jbarra777/jbarra777/DECISIONES_TECNICAS.md

# DECISIONES TÉCNICAS — Registro permanente

**Leyenda de origen:**
- **[U]** indicado o aprobado por el usuario.
- **[CAT]** plano catastrado.
- **[A-20x]** planta base del anteproyecto (A-201 nivel 2, A-202 nivel 3).
- **[Ax]** establecido en la lámina indicada. Su vigencia depende del estado de esa lámina en `INDICE_PLANOS.md`: si está EN REVISIÓN, la decisión puede cambiar, salvo que también lleve [U].

**PENDIENTE DE DEFINIR** = no decidido. **PD** = valor preliminar dibujado, pendiente de confirmar.

## 1. Proyecto y cajetín
- **Proyecto:** VIVIENDA UNIFAMILIAR. Distrito 03 Santiago, cantón 05 San Rafael, provincia 04 Heredia, Costa Rica. [CAT]
- **Profesionales del cajetín:** "Director técnico: Steven Viales (Civil) IC-40759; David Barrantes (Electricidad) IE-27499". Vienen del proyecto de referencia y su uso fue **autorizado por el usuario**. [U]
- **Empresa:** CivilCon Diseño y Construcción SRLTDA, céd. jurídica 3-102-762712 (confirmada). [U]
- **Registro público:** folio real 4-041200-000; plano catastrado 4-57389-2023; área según catastro 256 m². [U][CAT]
- **No contemplar la segregación** que indica el catastro ("para segregar"). [U]
- **Propietario:** no se incluye en el cajetín. No fue solicitado.
- **Formato A1** (841 × 594 mm). [U] Códigos de lámina al estilo de la referencia (A1, A2…; C01…; EL1…; IS1…): en uso desde la A1 y sin objeción del usuario.
- **Cajetín:** espacio para sellos; empresa; profesional; proyecto; registro; contenido; escalas; control de revisiones; estado; lugar, lámina, fecha (OCT 2026) y total. **El total de láminas está PENDIENTE DE DEFINIR**: se muestra "--".

## 2. Lote (catastro 4-57389-2023, CRTM05) — datos en `datos/lote_catastro.json`
- **Vértices (E, N):**
  - 1 (489351.38, 1106442.25)
  - 2 (489356.04, 1106442.46)
  - 3 (489360.38, 1106442.62)
  - 4 (489361.72, 1106414.19)
  - 5 (489352.73, 1106413.77) [CAT]
- **Área por coordenadas:** 256.57 m². Para la cobertura se usa la del catastro, **256 m²**. [U]
- **Lados:**
  - 1-2: 4.66 m, 87°25′
  - 2-3: 4.34 m, 87°53′
  - 3-4: 28.46 m, 177°18′
  - 4-5: 9.00 m, 267°20′
  - 5-1: 28.51 m, 357°17′
  - Calculados de las coordenadas. [A1]
- **Amarre:** 3 – P.I., 101°22′, 75.71 m. [CAT]
- **Frente al norte, a la calle pública.** El lindero 5-1 tiene azimut 357.29°, así que en los dibujos el norte va girado −2.714°. [CAT][A1]
- **Colindantes:** identificador predial 40503004120000 al este, sur y oeste. [CAT]
- Ignorar las cotas de 7.00 y 10.67 m del catastro. [U]
- El terreno es plano y está a nivel de acera. [U]
- Los datos del catastro no sustituyen un levantamiento topográfico (nota en las láminas).

## 3. Implantación, retiros y cobertura
- **Retiros de diseño:**
  - frontal de 2.00 m medido desde el vértice 3; resulta 2.06 en el vértice 1;
  - posterior de al menos 3.00 m; resulta 3.33/3.34;
  - laterales 0, con fachadas laterales ciegas. [U]
  - Falta confirmarlos con el alineamiento y el uso de suelo municipal (nota 4).
- **Envolvente:** 9.00 × 23.12 m (208.08 m²), en y 2.06–25.18 (marco local, §4). [A-201][A1]
- **Patios abiertos desde el nivel 1 hasta el cielo:**
  - P1 de 7.38 × 2.50 (18.45 m²);
  - P2 de 4.04 × 2.50 (10.10 m²);
  - **dimensión aceptada por la municipalidad**, con la altura medida desde el nivel 1 (≈9.5 m). [U]
- **Huella (proyección de los niveles 2 y 3):** 179.53 m². **Cobertura: 70.13 % (179.53/256), aceptada por el usuario como cumplimiento.** [U][A1][A2]

## 4. Marcos de coordenadas, ejes y nomenclatura
- **Marco de diseño (local):** origen en el vértice 1. *x* crece hacia el este a lo largo del frente y *y* hacia el sur a lo largo del lindero 1-5. [A1]
- **Marcos de dibujo:**
  - Model Space de la A1: norte arriba (X = x, Y = −y).
  - Plantas: **marco girado** (X = y, Y = x), con la calle a la izquierda (`planta.py`).
  - Todos los DXF incluyen un UCS "CRTM05". [A1–A4]
- **Ejes de letra (en x):** A 0.075 · B 1.41 · **C 4.84** (centro de columnas; antes 4.75) · D 8.925. [A2 rev1]
- **Ejes de número (en y):** 1 2.135 · 2 7.685 · 3 10.335 · 4 16.905 · 5 19.555 · 6 25.105.
  - Separaciones: 5.55 / 2.65 / 6.57 / 2.65 / 5.55. [A2]
- **Niveles:** se nombran "Nivel 1 / Nivel 2 / Nivel 3". No usar "planta baja". [U]

## 5. Niveles y alturas
- **Altura de piso a piso: 3.00 m (confirmada).** [U]
- **NPT:** N1 ±0.00 (= acera), N2 +3.00, N3 +6.00. [U][A2–A4]
- **Viga corona y arranque de cubierta: +9.00.** **Cumbrera: +10.50** (9.00 + 0.13 × 11.56), valor de referencia. **Sin pretil.** [U][A5 rev1]
- **Sin restricción de altura máxima** (indicado por el usuario). [U]
- **Estructura principal: marcos rígidos de acero.** Columnas del eje C continuas y a plomo del N1 al N3. **Columnas de los ejes A y D: se resuelven en estructural; no se agregan a las láminas de arquitectura.** [U]
- **Entrepisos:** paquete de **0.30** = sobrelosa de **0.10** sobre lámina colaborante + **vigas de acero de 0.20**. El cielo se mantiene a 2.70. [U]
- **Cerramientos:** **forro del edificio en paredes livianas Steel Tech**. **Muros de lindero, tapia posterior y frente del N1 (portón) en mampostería.** Espesores de 0.15 en exteriores y 0.12 en interiores, sin cambio. **Paredes interiores: Steel Tech de 0.12.** [U]
- **Nivel 1:** **contrapiso de 0.10** en estacionamientos, pasillo y gradas; **retiro frontal en zacate block (permeable)**; el resto en grava. [U]
- **Cielos:** gypsum regular plano suspendido a 2.70 en N2 y N3; acero expuesto en el N1 (estacionamientos). [U]
- **Cimentación:** no se dibuja en arquitectura, ni siquiera esquemática, hasta tener dimensiones (estructural). [U]
- **Cerchas metálicas** en la dirección de la pendiente, cordón inferior a +9.00, junto a los linderos y en los ejes B y C. Geometría PD (propuesta de Claude aceptada por el usuario). [U][A6 rev1]
- **Cortes a 1:75.** [U]
- **Puertas de 2.10** y **ventanas hacia los patios con antepecho de 0.90 y dintel a 2.20** (confirmadas). [U]
- **Representación en cortes:** la cercha del fondo se dibuja en vista y completa, también sobre patios y gradas. [U]

## 6. Muros y estructura arquitectónica
- **Espesores:** muros exteriores 0.15 m e interiores 0.12 m. [U]
- **Muros de colindancia** este y oeste a lo largo de toda la envolvente, ciegos. [U]
  - **Las paredes de la vivienda son la división en el lindero. No hay tapias laterales en los retiros.** En el N1 el muro de colindancia es continuo hasta el nivel de entrepiso (+3.00). [U 06-10-2026][A2 rev2]
  - Remate superior según la pendiente de la cubierta (hastial), sin pretil. [U]
  - **Tapia del lindero posterior: existe y llega hasta la viga corona del último nivel (+9.00)** (nota general 2). En las fachadas laterales va con flecha y nota. [U][A5 rev2]
- **Nota de tapia**, tomada de la referencia por indicación del usuario: "La tapia colindante de mampostería deberá prolongarse hasta el nivel de la viga corona del último nivel…". Es la nota general 2. [U]
- **Columnas sobre el eje C**, en los ejes 2, 3, 4, 5 y 6 ("cada ~5 m ajustado a ejes"). [U]
  - Sección **0.30 × 0.30 PD**, con la cara oeste en x 4.69 para no invadir el descanso de la escalera. C6 queda al ras de la fachada posterior. [A2 rev1]
  - **Sin columna en C1**, porque obstruiría el portón y el espacio E-2. La viga del eje 1 salva unos 7.3 m entre la pilastra B y el muro D (diseño estructural pendiente). [A2 rev1]
- **Pilastra en el eje B**, en la fachada del nivel 1: x 1.26–1.56. [A2]
- **Sistema estructural, cimentación, entrepisos, secciones y refuerzo: PENDIENTE DE DEFINIR.** No copiar los perfiles de acero de la referencia.

## 7. Distribución
### Nivel 1 [U][A2 rev1]
- **Solo 3 estacionamientos** independientes, E-1 a E-3, de 2.50 × 5.00, en x 1.35–8.85 y y 2.21–7.21, con acceso recto.
- **Pasillo peatonal** de 1.20 libre al oeste (x 0.15–1.35, hasta y 19.48), separado de los carros con un bordillo.
- **Gradas.**
- **Todo lo demás es JARDÍN SECO NO CONSTRUIDO**: bajo los niveles 2 y 3, en los patios y en el patio posterior.
- **Área construida del N1:** 37.50 + 20.72 + 8.35 = **66.57 m²**. El cuadro de la A2 muestra solo estacionamientos, pasillo y gradas.
- **Portón vehicular abatible** de 4 hojas plegables de 1.82 m, que abren hacia el retiro frontal sin invadir la vía. Claro libre de 7.29 m. **Acceso peatonal** de 1.00 m (vano de 1.11). [U][A2]
- Tanque séptico y drenaje en el patio posterior. La limpieza del tanque "no es problema". [U]

### Nivel 2 [A-201][A3]
- **Suite 1** en el módulo frontal (8.70 × 5.40):
  - baño en x 3.72–5.27, y 2.21–4.41;
  - walk-in de 3.46 × 3.25 en x 5.39–8.85, y 2.21–5.46.
- **Cocina-comedor** de 7.38 × 6.42: cocina en L sobre el muro este y el muro del eje 4, isla de 2.30 × 0.90, fregadero bajo la ventana a P2, despensa, aparador y mesa para 8.
- **Sala familiar** de 8.70 × 5.40. **Sin baño** en la cocina-comedor ni en la sala. [U]
- **Área del nivel:** 179.53 m² (incluye muros).

### Nivel 3 [A-202][A4]
- **Suites 1 y 3** iguales a la suite del N2. La suite 3 es su espejo, con el baño en la fachada posterior (y 22.83–25.03) y el walk-in en y 21.78–25.03.
- **Suite 2** (7.38 × 6.42):
  - **baño en x 7.30–8.85, y 14.63–16.83, sobre la zona húmeda de la cocina del N2** (aprobado); [U]
  - walk-in de 2.75 × 4.10 junto a P1;
  - acceso desde el muro B.
- **Área del nivel:** 179.53 m².

### Generales
- **Suites:** dormitorio y estar abiertos. **Solo el baño y el walk-in son recintos cerrados.** [U]
- **Lavandería: no se considera por ahora.** [U]
- **Área total de construcción:** 66.57 + 179.53 + 179.53 = **425.63 m²**. [A3][A4]

## 8. Circulación y escalera
- **Pasillo** de 1.20 libre al oeste, en los niveles 2 y 3 desde el eje 2 hasta el eje 5.
  - Va cerrado con **vidrio fijo hacia P1** (galería). [A3]
  - Los accesos a las suites 1 y 3 y a la sala están **al final del pasillo** (ejes 2 y 5); la cocina y la suite 2 se abren desde el muro B. [A3][A4]
- **Escalera en U transversal**, en x 1.35–4.69 y y 16.98–19.48:
  - 17 contrahuellas de ≈0.176 y huella de 0.28;
  - tramos de 1.10 con ojo de 0.30 y descanso en x 3.59–4.69;
  - tramo 1 en y 16.98–18.08, que sube hacia el este; tramo 2 en y 18.38–19.48, que regresa al oeste. [A2–A4]
- **Barandas:** en las gradas del N1 hacia el jardín seco y en el borde del vacío en el N3. El detalle va en la A11, **PENDIENTE**.

## 9. Baños y ventilación
- **Baños de 1.55 × 2.20** libres. [A-201][U]
  - Piezas **en línea**: ducha de 0.85 junto a la ventana, inodoro y lavatorio de 0.50 sobre el mismo muro.
  - Puerta de **0.80 abatible hacia el dormitorio**. [A3]
- **Extractor mecánico** en todos los baños. [U]
  - Detalle esquemático en A3/A4. **Caudal y modelo PENDIENTE DE DEFINIR [PR].**
- **Ductos sanitarios:**
  - baño de la suite 2 sobre la cocina: ducto en la esquina D/4 de la cocina (S02, A3 rev5); [U]
  - **baño de la suite 3 sobre la sala** del N2: ducto junto a C6 en la sala (S02, A3 rev5). [U]

## 10. Ventanas y puertas
- **Fachada principal, niveles 2 y 3: ventanas de piso a 2.20 m sobre el NPT**, alineadas entre niveles, con franja opaca hasta la losa. [U]
  - Posiciones en x local: dormitorio 0.70–2.90, baño 3.95–4.95, walk-in 6.40–8.20. [A3][A4][A5]
  - **Protección: opción a, paño fijo inferior de seguridad hasta 0.90 m** (incluido el baño). **No indicar nada sobre vidrio de seguridad en los planos.** [U]
  - **Solo los paños inferiores son fijos.** Los superiores son ventilas abatibles hacia afuera, también en los walk-in (reemplaza "walk-in con vidrios fijos"). [U]
- **Simbología de ventila en elevación:** con la bisagra arriba, el **triángulo va invertido** (trazos de las esquinas superiores al centro inferior). [U][A5 rev3]
- **Criterio de ventanas: todas ventilan.** **Ventila abatible hacia afuera** (bisagra superior), que abierta sirve de alero cuando llueve. Donde la apertura hacia afuera interfiera con un pasillo, **corrediza de dos paños móvil-móvil**. [U]
- **Baños de la fachada principal:** vidrio arenado (sandblast). [U]
- **Ventanas hacia P1** desfasadas entre ambos lados del patio, para reducir las visuales cruzadas. [A3][A4]
- **Puertas (nomenclatura de la referencia):** [U 06-10-2026]
  - P-01 acceso principal 1.00 × 2.10, madera, **en el vestíbulo de escalera del N1** (única puerta principal);
  - P-02 habitaciones 0.90 × 2.10, madera (accesos a las suites);
  - P-03 baños 0.80 × 2.10, madera;
  - P-04 walk-in 0.80 × 2.10, madera (tipo propio);
  - P-05 puerta peatonal y P-06 portón vehicular, ambos metálicos (acero).
  - **Sin puerta en la cocina ni en la sala.** Se quita el muro del eje B entre la cocina y el pasillo (zona abierta). Abertura a la sala de 1.20 (x 0.15–1.35) en el muro del eje 5, hasta el cielo.
- **Vestíbulo de escalera cerrado en el N1:** paredes Steel Tech de 0.12 en los ejes 4, C y 5 alrededor de las gradas; P-01 en el pasillo sobre la línea del eje 4. [U]
- **Ventanas:** todas de aluminio y vidrio. **Vidrio arenado en V-03, V-05 (baño y sala) y V-11.** Galería V-13 con vidrio fijo de piso a cielo (2.30 × 2.70). V-10 de la cocina con antepecho de 0.90. [U]
- **Vestíbulo del N1:** piso PI-B (contrapiso) y paredes Pd-A. **Gradas y descansos: porcelanato PI-A antideslizante con nariz; losa de escalera de concreto armado (según estructural).** [U]
- **Barandas y pasamanos (A11):** acero inoxidable SS 304 "o similar", sin marcas comerciales; **sin citas normativas en los planos**. [U]
- **Acabados (como la referencia):** paredes Pd-A interiores, Pd-B baños, Pd-C salpicadero, Pd-D exteriores; **un mismo piso (PI-A) en interiores y baños**; **"ACABADO EN CIELOS": cielo raso tipo gypsum**. [U]
- **Láminas de puertas, ventanas y acabados: una sola, la A7**, con las tres plantas. Las A8 y A9 no se hacen. [U]
- **Fachada posterior (N2 y N3): patrón común 0.70–2.90 / 3.85–4.60 / 6.40–8.20**, alineado entre niveles. La ventana angosta libra C6 (0.09 m hasta su cara). **Antepecho común de 0.90 m** y dintel a 2.20 m. [U][A3 rev1][A4 rev1][A5 rev1]
  - El antepecho de 0.90 aplica también al baño de la suite 3 (vidrio arenado). [U]
  - **Fachada posterior: operable en toda su área** (ventilas), ya que el antepecho da la protección. [U]
  - **El cerramiento del pasillo hacia P1 (galería) se mantiene en vidrio fijo.** [U]
- **Portón vehicular y puerta peatonal: altura 2.40 m (confirmada).** [U]

## 11. Instalaciones (todo lo no indicado está PENDIENTE DE DEFINIR)
- **Agua potable:** red pública de la **ESPH**, conexión directa desde la calle. [U]
- **Aguas residuales:** **no hay alcantarillado**; tanque séptico y drenaje en el patio posterior. [U] Dimensionamiento y prueba de infiltración: PENDIENTE.
- **Aguas pluviales:** a la **cuneta pública**. [U]
  - **Canoas** en los bordes frontal y posterior de la cubierta, **2 bajantes en cada una** (uno en cada extremo, 4 en total), conducidos hacia la **cuneta del frente**. [U]
  - **Bajantes frontales ocultos en el N1** (portón y acceso peatonal). [U]
  - **Canoas en los bordes de la cubierta hacia los patios P1 y P2 donde se requiera.** [U]
  - **Trazado de bajantes y colectores: S03** (aprobada 07-10-2026). Diámetros y pendientes: PD.
- **Electricidad y voz/datos:** PENDIENTE DE DEFINIR. No copiar circuitos ni tableros de la referencia.

## 12. Cubierta, acabados y detalles
- **Techo: lámina estructural calibre 26, a dos aguas** (hacia el frente y hacia el fondo), **pendiente 13 %**. [U] **Cumbrera al centro de la envolvente (y = 13.62, +10.50).** [U] Estructura de techo en la C04. La cumbrera quedó a +10.70 (C04, opción a).
- **Acabados de pisos, paredes y fachadas:** PENDIENTE DE DEFINIR (láminas A7–A10).
- **Tapias laterales en los retiros: no hay.** [U]

## 13. Criterios gráficos y de presentación
- **Escalas:** A1 a 1:200, 1:100 y S/E; plantas a 1:50; fachadas: principal 1:50, posterior 1:75 y laterales 1:100. [A1–A5]
- **Lenguaje gráfico de plantas** (referencia págs. 3–4): muros cortados con trama, puertas con arco, mobiliario a escala, ejes con burbuja, cotas generales, entre ejes e interiores, NPT, cortes A-A y B-B (remiten a la A6) y norte según catastro.
- **Cada lámina de planta incluye** (como la referencia): derrotero, cuadro de áreas, porcentaje de cobertura y notas. Las A3 y A4 incluyen además el detalle del extractor.
- **Notas generales 1–12** en `cadlib.NOTAS_GENERALES`; luego las notas propias de cada lámina.
  - Las notas 1 (medidas) y 7 (canoas) son **[PR]** (tomadas de la referencia, pendientes de revisión del usuario).
  - La A5 (fachadas) usa su propia lista de notas: 1 medidas [PR], 2 tapia, 3 extractor, más 4–12 propias de las fachadas (rev1), igual que la referencia, que en fachadas lleva menos notas.
- **Capas:** muros, puertas, ventanas, mobiliario, cotas, textos, ejes, tramas, estructura, etc. Cajetín como bloque con atributos. Cotas como entidades DIMENSION.
- **Decimales:** cotas con punto (5.70); áreas y porcentajes con coma (179,53 m²), como la referencia.

## 14. Decisiones del 06-10-2026 (A5 rev5 y estructurales)
- **La A10 se integra en la A5:** no habrá lámina A10. [U]
- **Acabados de fachada:** Pd-D (estuco pulido, gris concreto) en paredes externas y muros de colindancia; ventanas de aluminio negro; **portón, puerta peatonal, canoas y bajantes metálicos en negro**; **lámina cal. 26 natural galvanizada**. [U]
- **Estructurales:** **usar las mismas secciones de los planos de referencia** (perfiles de columnas, vigas, cimentaciones, especificaciones), por indicación expresa del usuario, que es el ingeniero responsable. Se marcan **[PR]**. [U]
- **Columnas en los ejes A y D, en los ejes 1 a 6** (marcos transversales A-C-D; sin columna en C1). [U]
- **Secciones de la referencia [PR] (C03 / C02 de RIVERGRAND):** columna **C1 = tubo de acero 6×6" (150 × 150) en 3,17 mm**; C2 = 4×4" en 3,17 mm; viga **V1 = 4×8" en 3,17 mm**; arriostre **A1 = 4×4" en 3,17 mm**; pedestal 0,30 × 0,30 con 4 #4 y estribos #3 @10 cm; pletina de 270 × 270 mm; placas **F1 (centrada) y F2 (excéntrica, en lindero) de 1,65 × 1,65 × 0,25** con malla #4 @20 cm; viga riostra **VA1 de 0,20 × 0,40 con 6 #4 y aros #3 @20 cm**. [U][PR]
- **Columnas del eje C:** tubo C1 de 0.15 **forrado a 0.30 × 0.30** (las plantas aprobadas no cambian). [U]
- **Capacidad del suelo: qadm = 12 t/m² (valor de la referencia) [PR], a verificar con un estudio de suelos.** [U]
- **Juego estructural vigente:** C01 cimentaciones, C02 detalles de cimentación, C03 entrepisos 1 y 2, C04 techo, C05 pórticos, C06 especificaciones. [U] (La numeración anterior C03–C08 quedó sustituida; ver CAMBIOS.)
- **Entrepisos (C03 aprobada):**
  - viguetas 2x6" en 2,38 mm @0,60 m (máx.), en sentido transversal;
  - V1 en los ejes 1 a 6, A, C y D, y en el eje B como borde de vacíos;
  - losa de 0,10 con malla #3 electrosoldada sobre lámina ondulada galvanizada.
  - **Una sola lámina para los entrepisos 1 (nivel 2) y 2 (nivel 3).** [U][PR]
  - A verificar en el cálculo: la V1 del eje 1 (8,85 m, sin columna en C) y las luces de las viguetas (4,77 / 4,09 m).
- **Techo (C04), aceptado por el usuario el 06-10-2026:**
  - **Clavadores:** tubo RT 2x4" en 1,50 mm @0,90 m como máximo (luz máxima de 3,86 m entre cerchas).
  - **Cerchas:**
    - cordones de tubo 2x6" en 2,38 mm; diagonales y montantes de tubo 2x2" en 1,50 mm;
    - peralte variable de 0,10 en el alero a ≈1,60 en la cumbrera, con montantes @≈1,0 m.
  - **Vigas de corona:** V1 4x8" a +9,00 en los ejes 1 a 6 y en A, C y D, igual que en los entrepisos y sobre las C1. Las cerchas apoyan en esas vigas.
  - **La cercha del eje C pasa continua sobre el patio P1.**
  - **El detalle de canoa va en la lámina pluvial**, no en la C04. [U]
- **Niveles de la lámina de cubierta (C04 aprobada, opción a): +9,20 en el alero y +10,70 en la cumbrera.** Cordón inferior y cara superior de la V1 de corona: +9,00. Sustituye a +9,00/+10,50 de la A5/A6, que se corregirán al final. [U]
- **Pórticos (06-10-2026):**
  - **C05 y C06 se unifican en una sola lámina C05**, a 1:100. [U]
  - **Se eliminan C2 (columna 4x4") y A1 (arriostre 4x4") de la referencia:** no se usan. [U]
  - **Eje C en el eje 1:** lleva **columna C1 en los niveles 2 y 3**, apoyada en una **viga de transferencia VT-1** en el eje 1 a nivel del entrepiso 1 (N2), de **diseño especial** según el cálculo. **Sin columna en el nivel 1** (portón). [U]
- **C06 especificaciones aprobada; se eliminan las notas de materiales 8 y 9 (prefabricados).** [U]
- **Ventana V-03 (baño de la suite frontal, N2 y N3): 0,90 × 2,20 en x 3,76–4,66**, para librar la columna C1 del eje C en el eje 1 (x 4,69–4,99, al ras de la fachada frontal). [U]

## 15. Instalación eléctrica (06-10-2026)
- **Láminas:**
  - **E01 N1, E02 N2, E03 N3:** iluminación, tomacorrientes y voz/datos en la misma planta, a 1:50.
  - **E04:** diagrama unifilar, cuadros de tableros, detalles, simbología y notas. [U]
- **Tableros (esquema de la referencia):** medidor e interruptor principal en el frente (N1), **tablero principal TP en el N1** y **subtableros TN2 y TN3** en cada nivel. Monofásico 120/240 V. [U]
- **Cargas especiales:** **un calentador de paso por baño** (240 V), **cocina eléctrica** (N2, 240 V) y **secadora** (240 V; su ubicación depende de la lavandería, que está pospuesta). [U]
- **Conductores, disyuntores, acometida y formato de cuadros: valores de la referencia [PR]**, con la lista de circuitos ajustada a esta vivienda, para revisión del profesional eléctrico. [U]
- **E01 aprobada (06-10-2026):**
  - ubicación de salidas aprobada;
  - tubería expuesta del N1 en EMT;
  - medidor según la empresa distribuidora (PD);
  - **la salida de la secadora (240 V) no se dibuja ni se menciona en la planta del N1.** [U]

## 16. Instalación sanitaria y pluvial (06-10-2026)
- **Láminas:**
  - **S01:** agua potable N1–N3, plantas a 1:100, isométrico y detalles.
  - **S02:** aguas residuales N1–N3, plantas a 1:100, tanque séptico, drenaje y detalles.
  - **S03:** aguas pluviales: planta, canoas, bajantes, salida a la cuneta y **detalle de canoa**. [U]
- **Tanque séptico y drenaje:** esquema y dimensiones de la referencia **[PR]**, sujetos a la prueba de infiltración y al cálculo. [U]
- **Agua caliente: solo en las duchas**, con el calentador de paso de cada baño. Lavatorios y fregadero solo con agua fría. [U]
- **Agua potable:** conexión directa a la ESPH, **sin tanque ni bomba**. Diámetros, materiales, medidor y llaves **según la referencia [PR]**. [U]
- **S01 rev0 aprobada (06-10-2026):**
  - **Montante AF 3/4":** embebido en el muro del eje C, junto a la escalera y el patio P2 (x 4.75, y 17.30), del N1 al N3.
  - **Medidor y llave 3/4":** en el frente. El tramo principal va bajo el contrapiso.
  - **Ramales de los N2 y N3:** por el entrepiso, con una llave de paso en cada baño y en la cocina. Hay dos puntos de jardín en el N1.
  - **La S01 no es un isométrico:** muestra un diagrama vertical esquemático.
  - **Siguen pendientes (PD):** caja del medidor según la ESPH, clase o SDR de la tubería y prueba de presión.
- **Aguas residuales (07-10-2026):** [U]
  - **Bajantes (propuesta de Claude aprobada):**
    - suite 1 en el forro del muro baño/walk-in, con colector colgado bajo la losa del N2 hasta C2;
    - suite 2 + fregadero en un ducto en la esquina D/4 de la cocina;
    - suite 3 en un ducto junto a C6 en la sala del N2.
    - Afecta a la A3: se agregan dos ductos (PD 0.30 × 0.40), dibujados en la S02.
  - **S02 rev1 aprobada (07-10-2026):** tanque séptico con FAFA en el patio posterior (y 26.00–27.28) y drenaje de una sola línea de 7.40 m (PD). Trampa de grasa en el colector de aguas grises. Detalle del tanque según la referencia.
  - **Punto de jardín posterior trasladado a (x 1.50, y 25.40)** (S01 rev1). [U]
- **Aguas pluviales (S03 rev0, aprobada el 07-10-2026):** [U]
  - un bajante por canoa de patio (BP-5 y BP-6), en el extremo este, conectado al colector este;
  - colector oeste por el pasillo peatonal y colector este junto al muro D, con cajas de 0.30 × 0.30 [PR];
  - descarga a la cuneta del frente;
  - diámetros dibujados de 4" (PD).
  - **Tanque séptico y drenaje en el patio posterior** (opción "todo en el patio"). Dibujado en la S02 rev0 con una sola línea de drenaje de 7.40 m (PD), porque las placas F1/F2 no dejan espacio para dos.

## 17. Corrección de referencias (07-10-2026)
- Aprobadas A1 rev2, A2 rev4, A3 rev5 (con ductos sanitarios dibujados), A4 rev5, A5 rev7, A6 rev5, A7 rev3 y C04 rev2. [U]
- **Escalera (A11): queda como está**, con la estructura "según planos estructurales"; no se agrega lámina C. [U]

## 18. Lista definitiva y cierre de pendientes (07-10-2026) [U]
- **Lista definitiva: 22 láminas.** A1 lote · A2 planta N1 · A3 planta N2 · A4 planta N3 · A5 fachadas · A6 cortes · A7 puertas, ventanas y acabados · **A8 escalera (antes A11)** · C01 cimentaciones · C02 detalles de cimentación · C03 entrepisos 1 y 2 · C04 techo · C05 pórticos · C06 especificaciones · E01–E03 plantas eléctricas · E04 tableros · E05 detalles eléctricos · S01 agua potable · S02 aguas residuales · S03 aguas pluviales. Cajetín: TOTAL 22.
- **Verificados por el usuario (se quitan las marcas PD y las notas de verificación):**
  - prueba de infiltración y cálculo del tanque séptico: hechos; el diseño del tanque es adecuado;
  - aguas pluviales: todas las tuberías de 4"; tuberías con pendiente del 2 %; canoas solo con "pendiente hacia los bajantes";
  - caja del medidor de agua: no se dibuja;
  - perfiles estructurales: se quedan como están;
  - extractor: "extractor mecánico típico";
  - retiros, uso de suelo y descarga a la cuneta: confirmados con la municipalidad.
- **Notas [PR] aceptadas:** se elimina la marca [PR] y su leyenda en todas las láminas; se eliminan las notas que remitían al proyecto de referencia.
- **Cajetín: "PARA TRÁMITE – CFIA Y MUNICIPALIDAD"** en lugar de "versión de trabajo".
- **Repositorio:** pasar a privado (lo hace el usuario en GitHub; Claude no tiene permiso para cambiar la visibilidad).
