jbarra777/jbarra777/INDICE_PLANOS.md

# ÍNDICE DE PLANOS

> **El proyecto de referencia (RIVERGRAND, 37 láminas) NO define el número ni la lista de láminas de este proyecto.**
> - Cada lámina debe justificarse por las necesidades reales de esta vivienda.
> - Se pueden **combinar** láminas cuando convenga técnica y gráficamente.
> - Se pueden **eliminar** las que no apliquen.
> - Se pueden **agregar** láminas que no estén en la referencia si el proyecto las necesita.
> - **Ninguna lámina se incorpora solo porque aparezca en la referencia.**
>
> El número definitivo de láminas está **PENDIENTE DE DEFINIR**. Se decidirá con el usuario a medida que avancemos.

**Estados:** APROBADA · EN REVISIÓN · EN DESARROLLO · PENDIENTE · NO APLICA.
**Criterio:** una lámina es APROBADA solo si el usuario la aceptó y no le quedan correcciones pendientes. Ante cualquier duda, se marca EN REVISIÓN.

## LISTA DEFINITIVA — 22 LÁMINAS (07-10-2026, DECISIONES §18)
| N.º | Código | Lámina | Revisión vigente | Archivo | Estado |
|---|---|---|---|---|---|
| 1 | A1 | Lote de terreno | rev3 | `planos/A1_lote/SR-A1_LOTE_rev3.*` | PARA TRÁMITE (por aprobar) |
| 2 | A2 | Planta nivel 1 | rev5 | `planos/A2_nivel1/SR-A2_NIVEL1_rev5.*` | PARA TRÁMITE (por aprobar) |
| 3 | A3 | Planta nivel 2 | rev6 | `planos/A3_nivel2/SR-A3_NIVEL2_rev6.*` | PARA TRÁMITE (por aprobar) |
| 4 | A4 | Planta nivel 3 | rev6 | `planos/A4_nivel3/SR-A4_NIVEL3_rev6.*` | PARA TRÁMITE (por aprobar) |
| 5 | A5 | Fachadas y acabados de fachada | rev8 | `planos/A5_fachadas/SR-A5_FACHADAS_rev8.*` | PARA TRÁMITE (por aprobar) |
| 6 | A6 | Cortes | rev6 | `planos/A6_cortes/SR-A6_CORTES_rev6.*` | PARA TRÁMITE (por aprobar) |
| 7 | A7 | Puertas, ventanas y acabados | rev4 | `planos/A7_puertas_ventanas/SR-A7_PUERTAS_VENTANAS_rev4.*` | PARA TRÁMITE (por aprobar) |
| 8 | A8 | Escalera (antes A11) | rev2 | `planos/A8_escalera/SR-A8_ESCALERA_rev2.*` | PARA TRÁMITE (por aprobar) |
| 9 | C01 | Cimentaciones | rev2 | `planos/C01_cimentaciones/SR-C01_CIMENTACIONES_rev2.*` | PARA TRÁMITE (por aprobar) |
| 10 | C02 | Detalles de cimentación | rev2 | `planos/C02_cimentacion_detalles/SR-C02_CIMENTACION_DETALLES_rev2.*` | PARA TRÁMITE (por aprobar) |
| 11 | C03 | Entrepisos 1 y 2 | rev3 | `planos/C03_entrepiso_n2/SR-C03_ENTREPISOS_rev3.*` | PARA TRÁMITE (por aprobar) |
| 12 | C04 | Techo | rev3 | `planos/C04_techo/SR-C04_TECHO_rev3.*` | PARA TRÁMITE (por aprobar) |
| 13 | C05 | Pórticos | rev3 | `planos/C05_porticos/SR-C05_PORTICOS_rev3.*` | PARA TRÁMITE (por aprobar) |
| 14 | C06 | Especificaciones | rev2 | `planos/C06_especificaciones/SR-C06_ESPECIFICACIONES_rev2.*` | PARA TRÁMITE (por aprobar) |
| 15 | E01 | Planta eléctrica nivel 1 | rev2 | `planos/E01_nivel1/SR-E01_NIVEL1_rev2.*` | PARA TRÁMITE (por aprobar) |
| 16 | E02 | Planta eléctrica nivel 2 | rev1 | `planos/E02_nivel2/SR-E02_NIVEL2_rev1.*` | PARA TRÁMITE (por aprobar) |
| 17 | E03 | Planta eléctrica nivel 3 | rev1 | `planos/E03_nivel3/SR-E03_NIVEL3_rev1.*` | PARA TRÁMITE (por aprobar) |
| 18 | E04 | Unifilar y tableros | rev1 | `planos/E04_tableros/SR-E04_TABLEROS_rev1.*` | PARA TRÁMITE (por aprobar) |
| 19 | E05 | Detalles eléctricos | rev1 | `planos/E05_detalles/SR-E05_DETALLES_rev1.*` | PARA TRÁMITE (por aprobar) |
| 20 | S01 | Agua potable | rev2 | `planos/S01_agua_potable/SR-S01_AGUA_POTABLE_rev2.*` | PARA TRÁMITE (por aprobar) |
| 21 | S02 | Aguas residuales | rev2 | `planos/S02_aguas_residuales/SR-S02_AGUAS_RESIDUALES_rev2.*` | PARA TRÁMITE (por aprobar) |
| 22 | S03 | Aguas pluviales | rev1 | `planos/S03_pluviales/SR-S03_PLUVIALES_rev1.*` | PARA TRÁMITE (por aprobar) |

Las secciones A y B siguientes son el historial de desarrollo; la lista vigente es la de arriba.

## A) Láminas del proyecto actual ya desarrolladas
| Código | Nombre | Contenido principal | Estado | Archivo vigente | Observaciones |
|---|---|---|---|---|---|
| A1 | Lote de terreno | Ubicación geográfica (imagen del catastro), poligonal 1:200, retiros y huella 1:100, derrotero, coordenadas CRTM05, áreas y cobertura, notas | APROBADA (rev2) | `planos/A1_lote/SR-A1_LOTE_rev2.*` | Aprobada expresamente: "A1 aprobada" (06-10-2026). La relación rev2 cubre también la rev1. |
| A2 | Planta nivel 1 | 3 parqueos, pasillo, vestíbulo de escalera con P-01, jardín seco, columnas en el eje C, portón abatible, derrotero, áreas y cobertura, notas | APROBADA (rev4) | `planos/A2_nivel1/SR-A2_NIVEL1_rev4.*` | rev3 aprobada (06-10-2026): vestíbulo y puerta principal. |
| A3 | Planta nivel 2 | Suite 1, cocina-comedor y sala abiertas al pasillo, áreas, cobertura, detalle del extractor, notas | APROBADA (rev5) | `planos/A3_nivel2/SR-A3_NIVEL2_rev5.*` | rev4: columna C1 eje C-1 y V-03 de 0,90 (aprobada). |
| A4 | Planta nivel 3 | Suites 1, 2 y 3, áreas, cobertura, detalle del extractor, notas | APROBADA (rev5) | `planos/A4_nivel3/SR-A4_NIVEL3_rev5.*` | rev4: columna C1 eje C-1 y V-03 de 0,90 (aprobada). |
| A5 | Fachadas y acabados de fachada | Principal 1:50, posterior 1:75, laterales 1:100, cubierta a dos aguas, cuadro y etiquetas de acabados (integra la A10), notas | APROBADA (rev7) | `planos/A5_fachadas/SR-A5_FACHADAS_rev7.*` | rev6: cubierta +9,20/+10,70 y V-03 de 0,90 (aprobada). |
| A6 | Cortes | Corte A-A (x = 3.00) y corte B-B (y = 18.25) a 1:75, sistema constructivo, cerchas, materiales, vestíbulo del N1, notas | APROBADA (rev5) | `planos/A6_cortes/SR-A6_CORTES_rev5.*` | rev4: cubierta +9,20/+10,70 (aprobada). |
| A7 | Puertas, ventanas y acabados | Plantas N1–N3 a 1:100 con etiquetas, cuadros de puertas y ventanas, acabados de paredes, pisos y cielos, detalles de puertas y ventanas, notas | APROBADA (rev3) | `planos/A7_puertas_ventanas/SR-A7_PUERTAS_VENTANAS_rev3.*` | rev2: V-03 de 0,90 (aprobada). |
| A11 | Escalera | Planta 1:25, corte 1:25 con barandas, detalle de escalón, anclaje y detalle de baranda y pasamanos, notas | APROBADA | `planos/A11_escalera/SR-A11_ESCALERA_rev1.*` | rev1 aprobada (06-10-2026). La A7 se deja como está, por indicación del usuario. |

## B) Láminas previstas o necesarias del proyecto actual
Las justifica una referencia cruzada desde las láminas ya desarrolladas o un requisito propio de esta vivienda. **El código, el nombre definitivo y la posible combinación están por confirmar.**

| Código tentativo | Lámina | Por qué se necesita en este proyecto | Estado |
|---|---|---|---|
| C01–C06 | Estructurales: C01 cimentaciones, C02 detalles de cimentación, C03 entrepisos 1 y 2 (niveles 2 y 3, una sola lámina), C04 techo, C05 pórticos (longitudinales y transversales), C06 especificaciones | Juego aprobado por el usuario. Secciones de la referencia [PR] por su indicación. | C01 rev1, C02 rev1, C03 rev2, C04 rev2, C05 rev2 y C06 rev1 APROBADAS (correcciones del 06-10-2026: referencias a C06, C1 del eje C-1 sobre VT-1, notas 8 y 9 de C06 eliminadas). Revisiones anteriores aprobadas. |
| E01–E05 | Eléctricas: E01 N1, E02 N2, E03 N3 (iluminación, tomas y voz/datos); E04 unifilar, tableros, simbología y notas; E05 detalles eléctricos (agregada por el usuario) | Definido por el usuario el 06-10-2026. Valores de la referencia [PR]. | E01 rev1 APROBADA (`planos/E01_nivel1/SR-E01_NIVEL1_rev1.*`); E02 rev0 APROBADA (`planos/E02_nivel2/SR-E02_NIVEL2_rev0.*`); E03 rev0 APROBADA (`planos/E03_nivel3/SR-E03_NIVEL3_rev0.*`); E04 rev0 APROBADA (`planos/E04_tableros/SR-E04_TABLEROS_rev0.*`); E05 rev0 APROBADA (`planos/E05_detalles/SR-E05_DETALLES_rev0.*`) |
| S01–S03 | Sanitarias: S01 agua potable N1–N3; S02 aguas residuales N1–N3 con tanque séptico y drenaje; S03 aguas pluviales con detalle de canoa | Definido por el usuario el 06-10-2026. Valores de la referencia [PR]. | S01 APROBADA (rev1); S02 APROBADA (rev1); S03 APROBADA (rev0) |

## C) Láminas de la referencia por evaluar (aplica / se combina / se descarta)
Esta lista es solo un inventario de lo que contiene la referencia para comparar el alcance. **No son entregables de este proyecto.**

| Referencia | Contenido en la referencia | Evaluación para este proyecto |
|---|---|---|
| ARQ_01 Ubicación | Ubicación, poligonal, retiros, derrotero | Cubierta por la A1 |
| ARQ_02 a 04 Plantas | Plantas por nivel con derrotero, áreas, cobertura, extractor | Cubiertas por A2–A4 |
| ARQ_05 Fachadas | 4 fachadas a 1:75 | Cubierta por la A5 |
| ARQ_06 Cortes | Cortes A-A y B-B | Prevista (A6) |
| ARQ_07 a 09 Puertas, ventanas y acabados | Una lámina por nivel | Por evaluar: ¿una por nivel o combinadas? |
| ARQ_10 Acabados de fachadas | Fachadas con materiales | Por evaluar: ¿propia o combinada con la A5? |
| ARQ_11 Escalera y detalles | Escalera, baranda, pasamanos | Prevista (A11) |
| CIVIL_01 y 02 Fundaciones y detalles | Planta y detalles | Por evaluar según el sistema estructural |
| CIVIL_03 Entrepiso PB | Entrepiso de planta baja | Por evaluar: el N1 está sobre el terreno, quizá solo haga falta un contrapiso |
| CIVIL_04 y 05 Entrepisos N2 y N3 | Plantas y detalles | Por evaluar según el sistema |
| CIVIL_06 y 07 Techos | Planta de techo, losa, caja pluvial | Por evaluar. Techo definido: lámina cal. 26 a dos aguas al 13 % con canoas. Probablemente haga falta una planta de techos (canoas, bajantes y bordes hacia los patios). |
| CIVIL_08 y 09 Pórticos | Ejes longitudinales y transversales | Por evaluar según el sistema |
| CIVIL_10 Especificaciones | Especificaciones constructivas | Por evaluar; no copiar su contenido |
| ELECT_01 a 06 Iluminación y tomas por nivel | 6 plantas | Por evaluar: combinar en el N1 u otras combinaciones |
| ELECT_07 Detalles constructivos | Detalles | Por evaluar |
| ELECT_08 Voz y datos, simbología, notas | Diagrama y simbología | Por evaluar |
| ELECT_09 y 10 Unifilar y tableros | Diagrama y cuadros | Por evaluar; requieren datos del profesional eléctrico |
| SANIT_01 a 03 Agua potable por nivel | 3 plantas | Por evaluar |
| SANIT_04 a 06 Aguas servidas por nivel | Incluye tanque séptico, FAFA y drenaje en PB | Por evaluar; no copiar su solución de tratamiento |
