jbarra777/jbarra777/planos/A1_lote/SR-A1_relacion_rev3.md

# Lámina A1 · rev3 — lista definitiva y PARA TRÁMITE

**Estado:** PARA TRÁMITE (CFIA y municipalidad), por decisión del usuario del 07-10-2026.

## Archivos
- `SR-A1_LOTE_rev3.pdf` (A1 al 100 %) y `SR-A1_LOTE_rev3.dxf` (AutoCAD 2018).

## Cambios comunes a las 22 láminas (DECISIONES §18)
- Cajetín: estado "PARA TRÁMITE – CFIA Y MUNICIPALIDAD" y **TOTAL 22**.
- Notas de la referencia aceptadas: se eliminan las marcas [PR] y su leyenda.
- Pendientes verificados por el usuario: se eliminan las marcas PD y las notas de verificación, sin agregar valores nuevos.

## Cambios propios
- Nota 4: retiros "CONFIRMADOS CON EL ALINEAMIENTO Y EL USO DE SUELO MUNICIPAL".

## Validación
- DXF revisado con `recover` y `audit`: 0 errores.
- PDF revisado visualmente (cajetín y zonas modificadas).
