jbarra777/jbarra777/planos/A3_nivel2/SR-A3_relacion_rev6.md

# Lámina A3 · rev6 — lista definitiva y PARA TRÁMITE

**Estado:** PARA TRÁMITE (CFIA y municipalidad), por decisión del usuario del 07-10-2026.

## Archivos
- `SR-A3_NIVEL2_rev6.pdf` (A1 al 100 %) y `SR-A3_NIVEL2_rev6.dxf` (AutoCAD 2018).

## Cambios comunes a las 22 láminas (DECISIONES §18)
- Cajetín: estado "PARA TRÁMITE – CFIA Y MUNICIPALIDAD" y **TOTAL 22**.
- Notas de la referencia aceptadas: se eliminan las marcas [PR] y su leyenda.
- Pendientes verificados por el usuario: se eliminan las marcas PD y las notas de verificación, sin agregar valores nuevos.

## Cambios propios
- Ductos de 0.30 x 0.40 y forro de 0.20 (sin PD). Detalle del extractor: "EXTRACTOR MECÁNICO TÍPICO EN CIELO RASO". Base de E02 y S01–S02.

## Validación
- DXF revisado con `recover` y `audit`: 0 errores.
- PDF revisado visualmente (cajetín y zonas modificadas).
