jbarra777/jbarra777/planos/A4_nivel3/SR-A4_relacion_rev6.md

# Lámina A4 · rev6 — lista definitiva y PARA TRÁMITE

**Estado:** PARA TRÁMITE (CFIA y municipalidad), por decisión del usuario del 07-10-2026.

## Archivos
- `SR-A4_NIVEL3_rev6.pdf` (A1 al 100 %) y `SR-A4_NIVEL3_rev6.dxf` (AutoCAD 2018).

## Cambios comunes a las 22 láminas (DECISIONES §18)
- Cajetín: estado "PARA TRÁMITE – CFIA Y MUNICIPALIDAD" y **TOTAL 22**.
- Notas de la referencia aceptadas: se eliminan las marcas [PR] y su leyenda.
- Pendientes verificados por el usuario: se eliminan las marcas PD y las notas de verificación, sin agregar valores nuevos.

## Cambios propios
- Referencia a la escalera: A8. Extractor típico. Base de E03 y S01–S03.

## Validación
- DXF revisado con `recover` y `audit`: 0 errores.
- PDF revisado visualmente (cajetín y zonas modificadas).
