jbarra777/jbarra777/planos/A5_fachadas/SR-A5_relacion_rev8.md

# Lámina A5 · rev8 — lista definitiva y PARA TRÁMITE

**Estado:** PARA TRÁMITE (CFIA y municipalidad), por decisión del usuario del 07-10-2026.

## Archivos
- `SR-A5_FACHADAS_rev8.pdf` (A1 al 100 %) y `SR-A5_FACHADAS_rev8.dxf` (AutoCAD 2018).

## Cambios comunes a las 22 láminas (DECISIONES §18)
- Cajetín: estado "PARA TRÁMITE – CFIA Y MUNICIPALIDAD" y **TOTAL 22**.
- Notas de la referencia aceptadas: se eliminan las marcas [PR] y su leyenda.
- Pendientes verificados por el usuario: se eliminan las marcas PD y las notas de verificación, sin agregar valores nuevos.

## Cambios propios
- Panel de la ducha sin "(POR DEFINIR)".

## Validación
- DXF revisado con `recover` y `audit`: 0 errores.
- PDF revisado visualmente (cajetín y zonas modificadas).
