jbarra777/jbarra777/planos/A8_escalera/SR-A8_relacion_rev2.md

# Lámina A8 · rev2 — lista definitiva y PARA TRÁMITE

**Estado:** PARA TRÁMITE (CFIA y municipalidad), por decisión del usuario del 07-10-2026.

## Archivos
- `SR-A8_ESCALERA_rev2.pdf` (A1 al 100 %) y `SR-A8_ESCALERA_rev2.dxf` (AutoCAD 2018).

## Cambios comunes a las 22 láminas (DECISIONES §18)
- Cajetín: estado "PARA TRÁMITE – CFIA Y MUNICIPALIDAD" y **TOTAL 22**.
- Notas de la referencia aceptadas: se eliminan las marcas [PR] y su leyenda.
- Pendientes verificados por el usuario: se eliminan las marcas PD y las notas de verificación, sin agregar valores nuevos.

## Cambios propios
- **Antes A11.** Renumerada A8 (lista corrida A1–A8). Archivos en `planos/A8_escalera/`; la rev2 continúa la historia de la A11 (rev0 y rev1).

## Validación
- DXF revisado con `recover` y `audit`: 0 errores.
- PDF revisado visualmente (cajetín y zonas modificadas).
