jbarra777/jbarra777/planos/C01_cimentaciones/SR-C01_relacion_rev2.md

# Lámina C01 · rev2 — lista definitiva y PARA TRÁMITE

**Estado:** PARA TRÁMITE (CFIA y municipalidad), por decisión del usuario del 07-10-2026.

## Archivos
- `SR-C01_CIMENTACIONES_rev2.pdf` (A1 al 100 %) y `SR-C01_CIMENTACIONES_rev2.dxf` (AutoCAD 2018).

## Cambios comunes a las 22 láminas (DECISIONES §18)
- Cajetín: estado "PARA TRÁMITE – CFIA Y MUNICIPALIDAD" y **TOTAL 22**.
- Notas de la referencia aceptadas: se eliminan las marcas [PR] y su leyenda.
- Pendientes verificados por el usuario: se eliminan las marcas PD y las notas de verificación, sin agregar valores nuevos.

## Cambios propios
- Sin "verificar con estudio de suelos" ni la nota de secciones del proyecto de referencia; cimiento de la tapia posterior VA1 sin PD.

## Validación
- DXF revisado con `recover` y `audit`: 0 errores.
- PDF revisado visualmente (cajetín y zonas modificadas).
