jbarra777/jbarra777/planos/C03_entrepiso_n2/SR-C03_relacion_rev3.md

# Lámina C03 · rev3 — lista definitiva y PARA TRÁMITE

**Estado:** PARA TRÁMITE (CFIA y municipalidad), por decisión del usuario del 07-10-2026.

## Archivos
- `SR-C03_ENTREPISOS_rev3.pdf` (A1 al 100 %) y `SR-C03_ENTREPISOS_rev3.dxf` (AutoCAD 2018).

## Cambios comunes a las 22 láminas (DECISIONES §18)
- Cajetín: estado "PARA TRÁMITE – CFIA Y MUNICIPALIDAD" y **TOTAL 22**.
- Notas de la referencia aceptadas: se eliminan las marcas [PR] y su leyenda.
- Pendientes verificados por el usuario: se eliminan las marcas PD y las notas de verificación, sin agregar valores nuevos.

## Cambios propios
- VT-1 y uniones sin PD; malla según memoria de cálculo; sin nota del proyecto de referencia; vacío de escalera VER A8.

## Validación
- DXF revisado con `recover` y `audit`: 0 errores.
- PDF revisado visualmente (cajetín y zonas modificadas).
