jbarra777/jbarra777/planos/E04_tableros/SR-E04_relacion_rev1.md

# Lámina E04 · rev1 — lista definitiva y PARA TRÁMITE

**Estado:** PARA TRÁMITE (CFIA y municipalidad), por decisión del usuario del 07-10-2026.

## Archivos
- `SR-E04_TABLEROS_rev1.pdf` (A1 al 100 %) y `SR-E04_TABLEROS_rev1.dxf` (AutoCAD 2018).

## Cambios comunes a las 22 láminas (DECISIONES §18)
- Cajetín: estado "PARA TRÁMITE – CFIA Y MUNICIPALIDAD" y **TOTAL 22**.
- Notas de la referencia aceptadas: se eliminan las marcas [PR] y su leyenda.
- Pendientes verificados por el usuario: se eliminan las marcas PD y las notas de verificación, sin agregar valores nuevos.

## Cambios propios
- Nota de caída de tensión sin remisión a la referencia ni "a verificar"; se elimina la nota de valores de la referencia; medidor sin PD.

## Validación
- DXF revisado con `recover` y `audit`: 0 errores.
- PDF revisado visualmente (cajetín y zonas modificadas).
