jbarra777/jbarra777/planos/S01_agua_potable/SR-S01_relacion_rev2.md

# Lámina S01 · rev2 — lista definitiva y PARA TRÁMITE

**Estado:** PARA TRÁMITE (CFIA y municipalidad), por decisión del usuario del 07-10-2026.

## Archivos
- `SR-S01_AGUA_POTABLE_rev2.pdf` (A1 al 100 %) y `SR-S01_AGUA_POTABLE_rev2.dxf` (AutoCAD 2018).

## Cambios comunes a las 22 láminas (DECISIONES §18)
- Cajetín: estado "PARA TRÁMITE – CFIA Y MUNICIPALIDAD" y **TOTAL 22**.
- Notas de la referencia aceptadas: se eliminan las marcas [PR] y su leyenda.
- Pendientes verificados por el usuario: se eliminan las marcas PD y las notas de verificación, sin agregar valores nuevos.

## Cambios propios
- **Sin caja de medidor** (dibujo del detalle 1 y nota 3 eliminados). Diámetros sin [PR]; tubería sin "clase o SDR según cálculo". Bases A2 rev5, A3 rev6 y A4 rev6.

## Validación
- DXF revisado con `recover` y `audit`: 0 errores.
- PDF revisado visualmente (cajetín y zonas modificadas).
