jbarra777/jbarra777/planos/S02_aguas_residuales/SR-S02_relacion_rev2.md

# Lámina S02 · rev2 — lista definitiva y PARA TRÁMITE

**Estado:** PARA TRÁMITE (CFIA y municipalidad), por decisión del usuario del 07-10-2026.

## Archivos
- `SR-S02_AGUAS_RESIDUALES_rev2.pdf` (A1 al 100 %) y `SR-S02_AGUAS_RESIDUALES_rev2.dxf` (AutoCAD 2018).

## Cambios comunes a las 22 láminas (DECISIONES §18)
- Cajetín: estado "PARA TRÁMITE – CFIA Y MUNICIPALIDAD" y **TOTAL 22**.
- Notas de la referencia aceptadas: se eliminan las marcas [PR] y su leyenda.
- Pendientes verificados por el usuario: se eliminan las marcas PD y las notas de verificación, sin agregar valores nuevos.

## Cambios propios
- Ductos de 0.30 x 0.40, forro de 0.20 y drenaje L = 7.40 sin PD. Se eliminan las notas de prueba de infiltración, pendientes y profundidades PD (diseño del tanque verificado por el usuario).

## Validación
- DXF revisado con `recover` y `audit`: 0 errores.
- PDF revisado visualmente (cajetín y zonas modificadas).
