jbarra777/jbarra777/planos/S03_pluviales/SR-S03_relacion_rev1.md

# Lámina S03 · rev1 — lista definitiva y PARA TRÁMITE

**Estado:** PARA TRÁMITE (CFIA y municipalidad), por decisión del usuario del 07-10-2026.

## Archivos
- `SR-S03_PLUVIALES_rev1.pdf` (A1 al 100 %) y `SR-S03_PLUVIALES_rev1.dxf` (AutoCAD 2018).

## Cambios comunes a las 22 láminas (DECISIONES §18)
- Cajetín: estado "PARA TRÁMITE – CFIA Y MUNICIPALIDAD" y **TOTAL 22**.
- Notas de la referencia aceptadas: se eliminan las marcas [PR] y su leyenda.
- Pendientes verificados por el usuario: se eliminan las marcas PD y las notas de verificación, sin agregar valores nuevos.

## Cambios propios
- **Bajantes y colectores de 4"; colectores enterrados con pendiente del 2 %; canoas con pendiente hacia los bajantes.** Descarga a la cuneta sin nota municipal (confirmada). Canoa de 0.20 x 0.15 sin PD.

## Validación
- DXF revisado con `recover` y `audit`: 0 errores.
- PDF revisado visualmente (cajetín y zonas modificadas).
