jbarra777/jbarra777/planos/A11_escalera/SR-A11_relacion_rev1.md

# Lámina A11 · ESCALERA · rev1 (versión de trabajo)

**Estado:** versión de trabajo para revisión. No apta para construcción ni trámite.

## Cambios respecto a rev0 (sus respuestas del 06-10-2026)
| Indicación | Aplicado |
|---|---|
| 1. Acabado de las gradas | **Porcelanato PI-A antideslizante con nariz** en gradas y descansos (detalle de escalón y nota 4). |
| 2. Material de la escalera | Se mantiene la losa de concreto armado; espesor y refuerzo según estructural. |
| 3. Quitar la referencia normativa | Se eliminó el texto del manual de Bomberos y la nota sobre el reglamento. No queda ninguna cita normativa. |
| 4. Marcas → "o similar" | Se quitaron Extralum, E4801, E0223 y E031: "acero inoxidable SS 304 … o similar", "tubo de 42,4 mm … o similar", "soportes … o similar". |

## Aviso de coherencia con la A7 (aprobada)
En la A7, el acabado **PI-B (contrapiso)** menciona "estacionamientos, pasillo, vestíbulo y **gradas** del nivel 1". Con el acabado PI-A en las gradas, conviene una **A7 rev2** que quite "gradas" de PI-B y remita a la A11. Espera su indicación.

## Validación
- DXF revisado con `recover` y `audit`: 0 errores.
- PDF revisado visualmente.
