jbarra777/jbarra777/planos/A3_nivel2/SR-A3_relacion_rev5.md

# Lámina A3 · rev5 (versión de trabajo) — corrección de referencias

**Estado:** versión de trabajo para revisión. No apta para construcción ni trámite.

Revisión pedida por el usuario el 07-10-2026 ("continuar con correcciones de referencias"), al terminar los juegos estructural, eléctrico y sanitario. Parte de la rev4 aprobada; no hay otros cambios de geometría salvo los indicados.

## Archivos
- `SR-A3_NIVEL2_rev5.pdf` (A1 al 100 %) y `SR-A3_NIVEL2_rev5.dxf` (AutoCAD 2018).

## Cambios
- **Ductos sanitarios dibujados (aprobados en la S02):** ducto de 0.30 × 0.40 (PD) en la esquina D/4 de la cocina y ducto de 0.30 × 0.40 (PD) junto a C6 en la sala; forro de 0.20 (PD) en el walk-in de la suite 1. Nota 19 nueva.
- Nota de columnas: "SEGÚN PLANOS ESTRUCTURALES" → "EN C01 A C06".
- Notas generales 8 a 10 con referencias a S01, S03 y S02.
- Detalle del extractor: "(VER ELÉCTRICOS)" → "(VER E02 Y E03)".
- Áreas sin cambio (N2 179.53 m²).

## Validación
- DXF revisado con `recover` y `audit`: 0 errores.
- PDF revisado visualmente en las zonas modificadas.
