jbarra777/jbarra777/planos/E01_nivel1/SR-E01_relacion_rev1.md

# Lámina E01 · PLANTA ELÉCTRICA NIVEL 1 · rev1 (versión de trabajo)

**Estado:** versión de trabajo. No apta para construcción ni trámite. La rev0 fue aprobada (ubicación de salidas, tubería del N1, medidor PD).

## Archivos
| Archivo | Uso |
|---|---|
| `SR-E01_NIVEL1_rev1.pdf` | Plano para revisar (A1 al 100 %) |
| `SR-E01_NIVEL1_rev1.dxf` | Editable AutoCAD 2018 |

## Cambio
- Se quita la mención a la secadora en la nota bajo el cuadro de circuitos, por indicación del usuario. En la planta del N1 no se coloca nada sobre ese circuito.

## Validación
- DXF revisado con `recover` y `audit`: 0 errores.
- No se probó en AutoCAD.
