jbarra777/jbarra777/planos/C02_cimentacion_detalles/SR-C02_relacion_rev0.md

# Lámina C02 · DETALLES DE CIMENTACIÓN · rev0 (versión de trabajo)

**Estado:** versión de trabajo para revisión. No apta para construcción ni trámite.

## Archivos
| Archivo | Uso |
|---|---|
| `SR-C02_CIMENTACION_DETALLES_rev0.pdf` | Plano para revisar (A1 al 100 %) |
| `SR-C02_CIMENTACION_DETALLES_rev0.dxf` | Editable AutoCAD 2018, layout `C02-DETALLES` |

## Criterio
Secciones del proyecto de referencia por su indicación, marcadas [PR]. Ubicación de F1 y F2 según la C01 aprobada.

## Contenido
- **Corte F1 (centrada, eje C), 1:15:**
  - placa de 1,65 × 1,65 × 0,25 con malla #4 @20 cm y ganchos;
  - recubrimiento de 5 cm;
  - pedestal de 0,30 × 0,30 × 0,80 con 4 #4, patas de 25 cm y estribos #3 @10 cm;
  - pletina de 270 × 270 mm y tubo de 150 × 150 × 3,17 mm.
- **Corte F2 (excéntrica, linderos A y D), 1:15:** igual que la F1, con el pedestal y el tubo a paño del lindero. Las patas de las varillas van hacia el interior del lote.
- **Plantas F1 y F2, 1:15:** malla en ambas direcciones, pedestal, pletina y tubo.
- **Sección del pedestal (1:10) y pletina de unión (1:5)**, con perforaciones para los pernos de anclaje.
- Notas 1–8.

## Pendientes
1. **Pernos de anclaje y soldadura (PD):** diámetro, longitud y cantidad según el cálculo. Dibujé 4 perforaciones como referencia.
2. **qadm = 12 t/m² [PR]:** por verificar con el estudio de suelos.
3. **Detalle de la VA1:** está en la C01. No se repite aquí.

## Validación
- DXF revisado con `recover` y `audit`: 0 errores.
- PDF revisado visualmente por zonas: sin textos superpuestos ni vistas recortadas.
- No se probó en AutoCAD.
