jbarra777/jbarra777/planos/A1_lote/SR-A1_relacion_rev2.md

# Lámina A1 · rev2 (versión de trabajo) — corrección de referencias

**Estado:** versión de trabajo para revisión. No apta para construcción ni trámite.

Revisión pedida por el usuario el 07-10-2026 ("continuar con correcciones de referencias"), al terminar los juegos estructural, eléctrico y sanitario. Parte de la rev1 aprobada; no hay otros cambios de geometría salvo los indicados.

## Archivos
- `SR-A1_LOTE_rev2.pdf` (A1 al 100 %) y `SR-A1_LOTE_rev2.dxf` (AutoCAD 2018).

## Cambios
- Rótulo del patio posterior: "ZONA RESERVADA PARA TANQUE SÉPTICO Y DRENAJE (POR DISEÑAR)" → "TANQUE SÉPTICO Y DRENAJE (VER S02)".
- Notas generales 8 a 10 (comunes A1–A4) con referencias a S01, S03 y S02.
- Esta relación reemplaza también la relación pendiente de la rev1 (nota 2 de la tapia y patios aceptados en la nota 12).

## Validación
- DXF revisado con `recover` y `audit`: 0 errores.
- PDF revisado visualmente en las zonas modificadas.
