jbarra777/jbarra777/planos/A5_fachadas/SR-A5_relacion_rev7.md

# Lámina A5 · rev7 (versión de trabajo) — corrección de referencias

**Estado:** versión de trabajo para revisión. No apta para construcción ni trámite.

Revisión pedida por el usuario el 07-10-2026 ("continuar con correcciones de referencias"), al terminar los juegos estructural, eléctrico y sanitario. Parte de la rev6 aprobada; no hay otros cambios de geometría salvo los indicados.

## Archivos
- `SR-A5_FACHADAS_rev7.pdf` (A1 al 100 %) y `SR-A5_FACHADAS_rev7.dxf` (AutoCAD 2018).

## Cambios
- Rótulos "SEGÚN LÁMINA PLUVIAL" → "VER S03" (bajante frontal oculto en el N1 y sección de canoa).
- Viga / fascia: "PERALTE SEGÚN ESTRUCTURAL" → "SEGÚN C03 Y C05".
- Nota 5: estructura de techo "EN C04".
- Nota 6 reescrita: canoas frontal, posterior y hacia los patios, con trazado, diámetros y detalle de canoa en S03.

## Validación
- DXF revisado con `recover` y `audit`: 0 errores.
- PDF revisado visualmente en las zonas modificadas.
