jbarra777/jbarra777/planos/A3_nivel2/SR-A3_relacion_rev4.md

# Lámina A3 · rev4 (versión de trabajo)

**Estado:** versión de trabajo. No apta para construcción ni trámite. Corrección pedida por el usuario sobre la revisión aprobada anterior.

## Archivos
| Archivo | Uso |
|---|---|
| `SR-A3_NIVEL2_rev4.pdf` | Plano para revisar (A1 al 100 %) |
| `SR-A3_NIVEL2_rev4.dxf` | Editable AutoCAD 2018 |

## Cambios
- Se agrega la **columna C1 del eje C en el eje 1** (x 4,69–4,99, al ras de la fachada frontal), en la esquina de la ducha del baño de la suite 1.
- **Ventana del baño V-03: 1,00 → 0,90**, en x 3,76–4,66 (decisión del usuario).
- Nota de columnas actualizada (C1 sobre viga de transferencia, ver C05).

## Validación
- DXF revisado con `recover` y `audit`: 0 errores.
- PDF revisado visualmente en las zonas modificadas.
- No se probó en AutoCAD.
