jbarra777/jbarra777/planos/A5_fachadas/SR-A5_relacion_rev6.md

# Lámina A5 · rev6 (versión de trabajo)

**Estado:** versión de trabajo. No apta para construcción ni trámite. Corrección pedida por el usuario sobre la revisión aprobada anterior.

## Archivos
| Archivo | Uso |
|---|---|
| `SR-A5_FACHADAS_rev6.pdf` | Plano para revisar (A1 al 100 %) |
| `SR-A5_FACHADAS_rev6.dxf` | Editable AutoCAD 2018 |

## Cambios
- **Cubierta:** lámina a +9,20 en el alero y **cumbrera +10,70** (C04); viga corona +9,00. Frente de cercha entre +9,00 y +9,20 en las fachadas principal y posterior.
- Fachada principal: V-03 de 0,90 (x 3,76–4,66).
- Notas 4 y 5 actualizadas.

## Validación
- DXF revisado con `recover` y `audit`: 0 errores.
- PDF revisado visualmente en las zonas modificadas.
- No se probó en AutoCAD.
