jbarra777/jbarra777/planos/A7_puertas_ventanas/SR-A7_relacion_rev2.md

# Lámina A7 · rev2 (versión de trabajo)

**Estado:** versión de trabajo. No apta para construcción ni trámite. Corrección pedida por el usuario sobre la revisión aprobada anterior.

## Archivos
| Archivo | Uso |
|---|---|
| `SR-A7_PUERTAS_VENTANAS_rev2.pdf` | Plano para revisar (A1 al 100 %) |
| `SR-A7_PUERTAS_VENTANAS_rev2.dxf` | Editable AutoCAD 2018 |

## Cambios
- Plantas tomadas de A3 rev4 y A4 rev4 (con la nueva columna).
- **V-03: 0,90 × 2,20** en el cuadro de ventanas y en el detalle; etiqueta reubicada.

## Validación
- DXF revisado con `recover` y `audit`: 0 errores.
- PDF revisado visualmente en las zonas modificadas.
- No se probó en AutoCAD.
