jbarra777/jbarra777/planos/C01_cimentaciones/SR-C01_relacion_rev1.md

# Lámina C01 · rev1 (versión de trabajo)

**Estado:** versión de trabajo. No apta para construcción ni trámite. Corrección pedida por el usuario sobre la revisión aprobada anterior.

## Archivos
| Archivo | Uso |
|---|---|
| `SR-C01_CIMENTACIONES_rev1.pdf` | Plano para revisar (A1 al 100 %) |
| `SR-C01_CIMENTACIONES_rev1.dxf` | Editable AutoCAD 2018 |

## Cambios
- Nota 7: especificaciones según la lámina **C06** (antes "C08").
- Nota 4: la C1 de los niveles 2 y 3 en el eje C del eje 1 apoya en la viga de transferencia VT-1 (C05). Sin placa en ese punto (no cambia).

## Validación
- DXF revisado con `recover` y `audit`: 0 errores.
- PDF revisado visualmente en las zonas modificadas.
- No se probó en AutoCAD.
