jbarra777/jbarra777/planos/C03_entrepiso_n2/SR-C03_relacion_rev2.md

# Lámina C03 · rev2 (versión de trabajo)

**Estado:** versión de trabajo. No apta para construcción ni trámite. Corrección pedida por el usuario sobre la revisión aprobada anterior.

## Archivos
| Archivo | Uso |
|---|---|
| `SR-C03_ENTREPISOS_rev2.pdf` | Plano para revisar (A1 al 100 %) |
| `SR-C03_ENTREPISOS_rev2.dxf` | Editable AutoCAD 2018 |

## Cambios
- Se agrega la **C1 del eje C en el eje 1** (al ras de la fachada frontal, forrada a 0,30), que arranca en el nivel 2.
- V1 del eje 1 rotulada "V1 / VT-1 EN ENTREPISO 1 (VER C05)"; VT-1 agregada a la simbología.
- Nota 6 corregida (C1 sobre VT-1, sin columna en N1); nota 8: especificaciones según **C06**.

## Validación
- DXF revisado con `recover` y `audit`: 0 errores.
- PDF revisado visualmente en las zonas modificadas.
- No se probó en AutoCAD.
