jbarra777/jbarra777/planos/C01_cimentaciones/SR-C01_relacion_rev0.md

# Lámina C01 · CIMENTACIONES · rev0 (versión de trabajo)

**Estado:** versión de trabajo para revisión. No apta para construcción ni trámite.

## Archivos
| Archivo | Uso |
|---|---|
| `SR-C01_CIMENTACIONES_rev0.pdf` | Plano para revisar (A1 al 100 %) |
| `SR-C01_CIMENTACIONES_rev0.dxf` | Editable AutoCAD 2018, layout `C01-CIMENTACIONES` |

## Criterio
Por su indicación, las **secciones son las del proyecto de referencia** (C01/C02/C03 de RIVERGRAND) y se marcan [PR]. La **ubicación es la de esta vivienda**:
- **17 columnas C1** (tubo de 6×6" en 3,17 mm):
  - 6 en el eje A y 6 en el eje D (ejes 1 a 6);
  - 5 en el eje C (ejes 2 a 6, forradas a 0.30); sin columna en el eje C del eje 1, por el portón.
- **5 placas F1 centradas** (eje C) y **12 placas F2 excéntricas** (linderos A y D), de **1,65 × 1,65 × 0,25**, malla #4 @20 cm. Pedestal de 0,30 × 0,30 × 0,80.
- **Vigas riostra VA1** de 0,20 × 0,40 (6 #4, aros #3 @20 cm) en los ejes A, C y D y en los ejes 1 a 6. Los muros de lindero y el frente del N1 (mampostería) apoyan sobre las VA1.
- **Capacidad del suelo:** qadm = 12 t/m² [PR], a verificar con estudio de suelos.

## Contenido
Planta de cimentaciones a 1:50 con ejes y cotas, detalle de la viga riostra a 1:10, cuadro de cimentaciones, simbología de elementos portantes, notas 1–8 y norte.

## Puntos a confirmar
1. **Cimiento de la tapia posterior:** dibujé una VA1 bajo la tapia (PD), porque la referencia no tiene tapia. ¿Le parece bien así o lleva otro cimiento?
2. **Placas F2 de los ejes 1 y 6:** quedan en la esquina del lindero y se extienden hacia los retiros frontal y posterior, que son parte del lote.

## Validación
- DXF revisado con `recover` y `audit`: 0 errores.
- PDF revisado visualmente por zonas.
- No se probó en AutoCAD.
