jbarra777/jbarra777/planos/A5_fachadas/SR-A5_relacion_rev5.md

# Lámina A5 · FACHADAS · rev5 (versión de trabajo)

**Estado:** versión de trabajo para revisión. No apta para construcción ni trámite.

## Cambios respecto a rev4 (indicación del usuario: integrar la A10 en la A5)
| Indicación | Aplicado |
|---|---|
| Acabados de fachada en la A5 (la A10 no se hace) | **Cuadro "ACABADOS DE FACHADA"** y **etiquetas** en las cuatro fachadas: **Pd-D** paredes externas y muros de colindancia (repello grueso, estuco pulido, gris concreto); **AL-1** ventanas de aluminio y vidrio, negro; **M-1** portón, puerta peatonal, canoas y bajantes metálicos, negro; **L-1** lámina estructural cal. 26, natural galvanizada. |
| Nota 12 | Remite al cuadro de esta lámina. |
| Cajetín | Contenido "ACABADOS DE FACHADA."; muestra las rev 3, 4 y 5. |

## Validación
- DXF revisado con `recover` y `audit`: 0 errores.
- PDF revisado visualmente.
