jbarra777/jbarra777/planos/A11_escalera/SR-A11_relacion_rev0.md

# Lámina A11 · ESCALERA · rev0 (versión de trabajo)

**Estado:** versión de trabajo para revisión. No apta para construcción ni trámite.

## Archivos
| Archivo | Uso |
|---|---|
| `SR-A11_ESCALERA_rev0.pdf` | Plano para revisar (A1 al 100 %) |
| `SR-A11_ESCALERA_rev0.dxf` | Editable AutoCAD 2018, layout `A11-ESCALERA` |

## Criterio (su indicación: "usar la misma lámina del proyecto de referencia")
Se tomó de la ARQ_11 de la referencia la **organización** (planta, corte con barandas, detalle de escalón, anclaje del pasamanos, detalle de baranda) y los **textos técnicos de barandas y pasamanos**, marcados **[PR]**. La **geometría es la de esta vivienda**, no la de la referencia.

## Contenido
- **Planta de escalera a 1:25** (N1 con vestíbulo y P-01; N2 y N3 iguales):
  - tramo 1 de 9 CH y tramo 2 de 8 CH;
  - huellas de 0.28; tramos de 1.10; ojo de 0.30 con baranda; descanso de 1.10 × 2.50 a +1.59;
  - pasamanos a pared a 0.08 de la pared; columnas C4 y C5; cotas.
- **Corte de escalera a 1:25** en el ojo, mirando al eje 4:
  - tramo 1 con baranda: tubos pedestal, barras cada 10 cm hasta 0.92, barandal a 1.07 y pasamanos a 0.90 con remate al piso;
  - descanso cortado, tramo 2 oculto (detrás del corte), losa del N2 y baranda del borde del pasillo;
  - cotas 1.59 + 1.41 = 3.00;
  - rótulos [PR] de la referencia.
- **Detalle de escalón a 1:10:** losa de concreto armado, espesor y refuerzo según estructural (PD).
- **Anclaje de pasamanos** [PR] y **detalle de baranda y pasamanos a 1:10** [PR].
- Notas 1–5.

## Pendientes / para su visto bueno
1. **Acabado de las gradas:** sigue sin definir (PD). Usted lo dejó para esta lámina. ¿Qué acabado lleva? Por ejemplo, el mismo porcelanato PI-A antideslizante con nariz.
2. **Material de la escalera:** dibujé concreto armado, como en la A6. ¿Es de concreto o metálica, como la estructura? En cualquier caso el diseño lo hace estructural.
3. **Textos [PR] con citas al Reglamento Nacional de Protección contra Incendios 2020:**
   - En los rótulos cortos de la elevación quité los artículos citados.
   - La cita que se mantuvo (manual del Cuerpo de Bomberos, en el detalle de escalón) lleva "VERIFICAR".
   - No afirmo cumplimiento normativo sin verificar la versión vigente.
4. **Marcas comerciales de la referencia** (Extralum, tubos E4801, soportes E0223 y E031): se copiaron tal cual. ¿Las mantenemos o las cambiamos por "o similar"?

## Validación
- DXF revisado con `recover` y `audit`: 0 errores.
- PDF revisado visualmente por zonas.
- No se probó en AutoCAD.
