jbarra777/jbarra777/planos/A6_cortes/SR-A6_relacion_rev3.md

# Lámina A6 · CORTES · rev3 (versión de trabajo)

**Estado:** versión de trabajo para revisión. No apta para construcción ni trámite.

## Archivos
| Archivo | Uso |
|---|---|
| `SR-A6_CORTES_rev3.pdf` | Plano para revisar (A1 al 100 %) |
| `SR-A6_CORTES_rev3.dxf` | Editable AutoCAD 2018, layout `A6-CORTES` |

## Cambios respecto a rev2 (para coincidir con A2 rev3, A3 rev3 y A7)
| Cambio | Aplicado |
|---|---|
| Vestíbulo de escalera en el N1 | **Corte A-A:** se cortan las paredes Steel Tech de 0.12 de los ejes 4 y 5 en el N1, y el rótulo pasa a "VESTÍBULO Y GRADAS". **Corte B-B:** se corta la pared del eje C en el N1, la pared del eje 5 queda en vista y el rótulo "PASILLO" del N1 pasa a "VESTÍBULO". |
| Sala abierta al pasillo (N2) | **Corte B-B:** en el eje 5 del N2 ya no hay puerta; se dibuja el **vano de 1.20 hasta el cielo**, con rótulo. |
| Lámina única A7 | La nota 12 remite a la **A7**. |
| Cajetín | Muestra las rev 1, 2 y 3. |

Lo demás no cambia.

## Validación
- DXF revisado con `recover` y `audit`: 0 errores.
- PDF revisado visualmente por zonas.
