jbarra777/jbarra777/planos/A5_fachadas/SR-A5_relacion_rev4.md

# Lámina A5 · FACHADAS · rev4 (versión de trabajo)

**Estado:** versión de trabajo para revisión. No apta para construcción ni trámite.

## Archivos
| Archivo | Uso |
|---|---|
| `SR-A5_FACHADAS_rev4.pdf` | Plano para revisar (A1 al 100 %) |
| `SR-A5_FACHADAS_rev4.dxf` | Editable AutoCAD 2018, layout `A5-FACHADAS` |

## Cambios respecto a rev3
| Indicación | Aplicado |
|---|---|
| Vidrio arenado en la V-05 de la sala (decidido en la A7) | En la fachada posterior, la ventana angosta del N2 (sala, x 3.85–4.60) lleva vidrio arenado, igual que la del baño de la suite 3. Nota 9 actualizada. |
| Lámina única A7 | La nota 12 decía "láminas A7 a A9" y ahora remite a la **A7**. |
| Cajetín | Muestra las rev 2, 3 y 4. |

Lo demás no cambia.

## Validación
- DXF revisado con `recover` y `audit`: 0 errores.
- PDF revisado visualmente.
