jbarra777/jbarra777/planos/A4_nivel3/SR-A4_relacion_rev3.md

# Lámina A4 · PLANTA NIVEL 3 · rev3 (versión de trabajo)

**Estado:** versión de trabajo para revisión. No apta para construcción ni trámite.

## Archivos
| Archivo | Uso |
|---|---|
| `SR-A4_NIVEL3_rev3.pdf` | Plano para revisar (A1 al 100 %) |
| `SR-A4_NIVEL3_rev3.dxf` | Editable AutoCAD 2018, layout `A4-NIVEL3` |

## Cambio respecto a rev2
| Indicación | Aplicado |
|---|---|
| Lámina única de puertas, ventanas y acabados (A7) | La nota 22 decía "lámina A9" y ahora remite a la **A7**. El cajetín muestra las rev 1, 2 y 3. |

Geometría, áreas y demás notas: sin cambios.

## Validación
- DXF revisado con `recover` y `audit`: 0 errores.
- PDF revisado visualmente.
