jbarra777/jbarra777/planos/A3_nivel2/SR-A3_relacion_rev3.md

# Lámina A3 · PLANTA NIVEL 2 · rev3 (versión de trabajo)

**Estado:** versión de trabajo para revisión. No apta para construcción ni trámite.
**Aviso:** la rev2 estaba aprobada. Esta rev3 aplica su decisión del 06-10-2026.

## Archivos
| Archivo | Uso |
|---|---|
| `SR-A3_NIVEL2_rev3.pdf` | Plano para revisar (A1 al 100 %) |
| `SR-A3_NIVEL2_rev3.dxf` | Editable AutoCAD 2018, layout `A3-NIVEL2` |

## Cambios respecto a rev2
| Indicación | Aplicado |
|---|---|
| Quitar la puerta de la cocina y el muro entre la cocina y el pasillo | Se eliminó el muro del eje B (x 1.35–1.47, y 10.41–16.83) junto con su puerta. La cocina-comedor queda abierta al pasillo. Se ajustó la cota transversal: 1.20 de pasillo + 7.50 de cocina. |
| Quitar la puerta de la sala y abrir el muro | En el eje 5, **vano libre de 1.20** (x 0.15–1.35, todo el ancho del pasillo), sin puerta. Lleva cota. |
| Notas | La nota 15 describe la cocina y la sala abiertas. La nota 22 remite a la lámina **A7**. |
| Cajetín | Muestra las rev 1, 2 y 3. |

Áreas sin cambio: N2 = 179.53 m²; cocina-comedor 47.38 m² y sala 46.98 m², medidas como recintos.

## Validación
- DXF revisado con `recover` y `audit`: 0 errores.
- PDF revisado visualmente por zonas.
- No se probó en AutoCAD.
