jbarra777/jbarra777/planos/A2_nivel1/SR-A2_relacion_rev3.md

# Lámina A2 · PLANTA NIVEL 1 · rev3 (versión de trabajo)

**Estado:** versión de trabajo para revisión. No apta para construcción ni trámite.
**Aviso:** la rev2 estaba aprobada. Esta rev3 aplica su decisión del 06-10-2026: puerta principal en planta baja.

## Archivos
| Archivo | Uso |
|---|---|
| `SR-A2_NIVEL1_rev3.pdf` | Plano para revisar (A1 al 100 %) |
| `SR-A2_NIVEL1_rev3.dxf` | Editable AutoCAD 2018, layout `A2-NIVEL1` |

## Cambios respecto a rev2
| Indicación | Aplicado |
|---|---|
| Puerta principal justo antes de subir la escalera | **Vestíbulo de escalera cerrado** con paredes Steel Tech de 0.12: en el eje 4 (y 16.86–16.98), en el eje C (x 4.69–4.81, igual que el muro de N2 y N3) y en el eje 5 (y 19.48–19.60). **P-01 de 1.00** en el pasillo (x 0.25–1.25), abre hacia el vestíbulo. |
| Barandas del N1 | Se quitaron las barandas perimetrales de las gradas del N1: ahora esos bordes son paredes. |
| Rótulos | "VESTÍBULO" y "PUERTA PRINCIPAL (VER A7)". El texto de las gradas se movió fuera del barrido de la puerta. |
| Nota 19 | Vestíbulo y P-01 de madera; puertas, ventanas y acabados en la lámina A7. |
| Cajetín | Muestra las rev 1, 2 y 3 (solo tiene tres filas). |

Áreas sin cambio: N1 = 66.57 m², cobertura 70.13 %.

## Validación
- DXF revisado con `recover` y `audit`: 0 errores.
- PDF revisado visualmente por zonas.
- No se probó en AutoCAD.
