jbarra777/jbarra777/planos/A7_puertas_ventanas/SR-A7_relacion_rev1.md

# Lámina A7 · PUERTAS, VENTANAS Y ACABADOS · rev1 (versión de trabajo)

**Estado:** versión de trabajo. No apta para construcción ni trámite.

## Cambio respecto a rev0 (su indicación del 06-10-2026)
| Indicación | Aplicado |
|---|---|
| Vidrio arenado tanto en baño como en sala (V-05) | Las dos V-05 de la fachada posterior (sala en el N2 y baño de la suite 3 en el N3) llevan **vidrio arenado**. Detalle con trama y cuadro actualizados. |

## Supuestos confirmados por usted
- V-13: galería con vidrio fijo de piso a cielo (2.30 × 2.70).
- Vestíbulo del N1: piso PI-B y paredes Pd-A.
- V-10 (cocina): se deja con antepecho de 0.90.
- Acabado de las gradas: se define en la A11.

## Validación
- DXF revisado con `recover` y `audit`: 0 errores.
- PDF revisado visualmente.
