jbarra777/jbarra777/planos/A7_puertas_ventanas/SR-A7_relacion_rev0.md

# Lámina A7 · PUERTAS, VENTANAS Y ACABADOS · rev0 (versión de trabajo)

**Estado:** versión de trabajo para revisión. No apta para construcción ni trámite.

## Archivos
| Archivo | Uso |
|---|---|
| `SR-A7_PUERTAS_VENTANAS_rev0.pdf` | Plano para revisar (A1 al 100 %) |
| `SR-A7_PUERTAS_VENTANAS_rev0.dxf` | Editable AutoCAD 2018, layout `A7-PUERTAS-VENTANAS` |

## Contenido (como la ARQ_07–09 de la referencia, en una sola lámina por su indicación)
- **Plantas de los niveles 1, 2 y 3 a 1:100**, sin mobiliario ni cotas. Etiquetas:
  - puertas **P-01 a P-06** (círculo);
  - ventanas **V-01 a V-13** (rectángulo);
  - acabados de pared **Pd-A a Pd-D** (con flecha a la pared);
  - acabados de piso **PI-A a PI-D**.
- **Cuadro de puertas y cuadro de ventanas**, con las mismas columnas que la referencia: ancho, alto, tipo, cantidad, ubicación y material.
- **Acabados:**
  - **en paredes:** Pd-A internas, Pd-B baños, Pd-C salpicadero de cocina, Pd-D externas. Textos y colores de la referencia;
  - **en pisos:** PI-A es el mismo porcelanato para interiores y baños; además, contrapiso, zacate block y grava en el N1;
  - **"Acabado en cielos":** cielo raso tipo gypsum en N2 y N3; acero expuesto en el N1.
- **Detalle de puertas** a 1:50 (puertas típicas de casa; la de baño lleva romanilla inferior, como la referencia) y **detalle de ventanas** a 1:75. Las ventilas van con triángulo invertido y "F" marca los paños fijos.
- **Notas:** 1 y 3 son de la referencia [PR]; 4 viene de la referencia con el aluminio que usted indicó [PR].

## Puertas
| Código | Medida | Material | Cant. |
|---|---|---|---|
| P-01 acceso principal (vestíbulo N1) | 1.00 × 2.10 | **madera** | 1 |
| P-02 habitaciones (suites) | 0.90 × 2.10 | madera | 4 |
| P-03 baños | 0.80 × 2.10 | madera con romanilla inferior | 4 |
| P-04 walk-in | 0.80 × 2.10 | madera | 4 |
| P-05 puerta peatonal | 1.00 × 2.40 | metal (acero) | 1 |
| P-06 portón vehicular | 7.29 × 2.40, 4 hojas | metal (acero) | 1 |

Ventanas: 13 tipos y 27 unidades, todas de **aluminio y vidrio**.

## Plantas usadas
Las plantas salen de las versiones que incluyen sus cambios del 06-10-2026. Esas revisiones las entrego después, una a la vez:
- **A2 rev3:** vestíbulo de escalera con paredes Steel Tech de 0.12 y P-01.
- **A3 rev3:** cocina abierta al pasillo, sin puertas en la cocina ni en la sala, vano de 1.20 hacia la sala.
- **A4 rev2:** sin cambios de geometría.

## Supuestos para su visto bueno
1. **Galería del pasillo hacia P1 (V-13):** vidrio fijo de 2.30 × 2.70, de piso a cielo (PD).
2. **Vestíbulo del N1:** piso PI-B (contrapiso) y paredes Pd-A. Las paredes del N1 hacia el estacionamiento y el jardín llevan Pd-D.
3. **Ventana de la cocina sobre el fregadero (V-10):** antepecho de 0.90 como las demás ventanas a patios. Queda a la altura del mueble; quizá convenga subirla.
4. **V-05:** vidrio arenado solo en el baño de la suite 3. En la sala va vidrio claro.
5. **Color del acero expuesto del N1:** "según estructural".
6. **Acabado de las gradas:** sin definir. Lo veremos en la A11.

## Validación
- DXF revisado con `recover` y `audit`: 0 errores.
- PDF revisado visualmente por zonas: se corrigieron etiquetas superpuestas.
- No se probó en AutoCAD.
