jbarra777/jbarra777/planos/A6_cortes/SR-A6_relacion_rev2.md

# Lámina A6 · CORTES · rev2 (versión de trabajo)

**Estado:** versión de trabajo para revisión. No apta para construcción ni trámite.

## Archivos
| Archivo | Uso |
|---|---|
| `SR-A6_CORTES_rev2.pdf` | Plano para revisar (A1 al 100 %) |
| `SR-A6_CORTES_rev2.dxf` | Editable AutoCAD 2018, layout `A6-CORTES` |

## Cambios respecto a rev1 (sus indicaciones del 06-10-2026)
| Indicación | Aplicado |
|---|---|
| Frente del N1 sin representación | El corte A-A (x = 3.00) pasa por el **portón**, no por un muro: el vano del portón va de x 1.56 a 8.85, y la pilastra del eje B (x 1.26–1.56) queda detrás del observador. Se dibuja la **hoja del portón cortada en acero** (sólida, con marco), con el rótulo "PORTÓN (CORTE)" y, sobre ella, el frente de mampostería. Se marca además la **línea del lindero frontal**. |
| Retiro frontal permeable | **Zacate block (permeable)** en el retiro frontal, con trama propia, rótulo y simbología. |
| Paredes interiores | **Steel Tech de 0.12** (en el corte se dibujan igual que el forro). Nota 8 y simbología actualizadas. |
| Vigas de entrepiso de 0.30 | Por su respuesta: **paquete total de 0.30 = viga 0.20 + sobrelosa 0.10**. El cielo se mantiene a 2.70. Ya no es PD. |
| Contrapiso, puertas y ventanas | Contrapiso de **0.10**, puertas de **2.10** y ventanas a patios de **0.90 a 2.20**, confirmados. Se quitó "PD". |
| Cercha completa en el A-A | La cercha del fondo se dibuja **en vista y continua de frente a fondo**, también sobre el jardín seco (P1) y sobre las gradas. La lámina sigue abierta sobre el patio P1. |
| Cercha en el B-B | Ese corte es perpendicular a las cerchas, así que se ven **cortadas**: cordón superior e inferior en negro y montante entre ellos, junto al lindero oeste y en los ejes B y C. Se agrandaron para que se lean mejor. |

## Pendiente (PD)
- Geometría y perfiles de cerchas y clavadores: según estructural.

## Validación
- DXF revisado con `recover` y `audit`.
- PDF revisado visualmente por zonas.
- No se probó en AutoCAD.
