jbarra777/jbarra777/planos/A6_cortes/SR-A6_relacion_rev0.md

# Lámina A6 · CORTES · rev0 (versión de trabajo)

**Estado:** versión de trabajo para revisión. No apta para construcción ni trámite.

## Archivos
| Archivo | Uso |
|---|---|
| `SR-A6_CORTES_rev0.pdf` | Plano para revisar (A1 al 100 %) |
| `SR-A6_CORTES_rev0.dxf` | Editable AutoCAD 2018, layout `A6-CORTES` |

## Contenido (equivalente a la ARQ_06 de la referencia)
- **Corte A-A a 1:75.** Longitudinal en x = 3.00, con vista hacia el este, el frente a la izquierda y los ejes 1–6 acotados arriba.
  - **N1:** portón, estacionamiento, jardín seco bajo P1 y bajo la casa, gradas, retiro posterior y **tapia posterior hasta +9.00 con nota**.
  - **N2 y N3:** muros de fachada y de los ejes 2 a 5 cortados; en los ejes 2 y 3 se cortan las ventanas hacia P1. Recintos rotulados (suite 1, P1, cocina-comedor, sala; suite 1, P1, suite 2, suite 3).
  - **Escalera:** se cortan los tramos de ambos niveles y se ven el descanso y las huellas.
  - **Cubierta:** de lámina al 13 % con un hueco en P1, canoa al frente, al fondo y hacia P1, cumbrera +10.50 y perfil del muro de colindancia en vista.
  - **En vista:** columnas del eje C en el N1.
- **Corte B-B a 1:75.** Transversal en y = 18.25, con vista hacia el fondo, el este a la izquierda y los ejes D–A arriba.
  - Muros de colindancia cortados hasta la cubierta en ese punto (+9.90).
  - Muro del eje C, pasillo con baranda, descansos cortados y tramo 2 en vista. Patio P2 abierto.
  - Puertas y ventanas del eje 5 en vista y columna C5 en el N1.
- **Cotas:** verticales por nivel (2.70 de piso a cielo + 0.30 de entrepiso) y total de 10.50. Niveles NPT, cielos, viga corona y cumbrera. Cotas horizontales de retiros y de envolvente.
- **Notas 1–11** y cajetín a escala 1:75.

## Datos aplicados (sus respuestas)
- Entrepiso de **estructura metálica** (vigas de acero y lámina colaborante con sobrelosa).
- **Cielo raso a 2.70** en N2 y N3. El N1 queda sin cielo raso.
- Escala **1:75**.

## Supuestos preliminares (PD), para su visto bueno
1. **Espesores del entrepiso:** sobrelosa de 0.10 y viga de 0.20 (en total 0.30 entre cielo y piso). Las vigas se dibujan como perfil I esquemático en cada eje.
2. **Altura de puertas: 2.10.**
3. **Ventanas hacia los patios** (ejes 2, 3 y 5): antepecho de 0.90 y dintel a 2.20, iguales a la fachada posterior.
4. **Remate de los muros alrededor de los patios en el N3:** suben hasta la cubierta (culata).
5. **Canoa hacia P1** en el borde de y = 10.26, donde el faldón baja hacia el patio.
   - Hacia P2 también hace falta una canoa, en el borde de y = 16.98. No aparece en estos cortes.
6. Elementos en vista simplificados: tabiques interiores y mobiliario no se dibujan.

## Validación
- DXF revisado con `recover` y `audit`: 0 errores.
- PDF revisado visualmente por zonas.
- No se probó en AutoCAD.
