jbarra777/jbarra777/planos/A5_fachadas/SR-A5_relacion_rev3.md

# Lámina A5 · FACHADAS · rev3 (versión de trabajo)

**Estado:** versión de trabajo para revisión. No apta para construcción ni trámite.

## Archivos
| Archivo | Uso |
|---|---|
| `SR-A5_FACHADAS_rev3.pdf` | Plano para revisar (A1 al 100 %) |
| `SR-A5_FACHADAS_rev3.dxf` | Editable AutoCAD 2018, layout `A5-FACHADAS` |

## Cambios respecto a rev2 (su indicación del 06-10-2026)
| Indicación | Aplicado |
|---|---|
| Con la bisagra arriba, el triángulo de la simbología va invertido | En todas las ventilas (frente y fondo) y en la simbología, los trazos van ahora de las esquinas superiores (lado de la bisagra) al centro del lado inferior. |
| Cajetín | Solo tiene 3 filas de revisión, así que muestra las rev 1, 2 y 3. |

El resto de la lámina no cambia respecto a la rev2.

## Validación
- DXF revisado con `recover` y `audit`.
- PDF revisado visualmente.
- No se probó en AutoCAD.
