jbarra777/jbarra777/planos/A3_nivel2/SR-A3_relacion_rev2.md

# Lámina A3 · PLANTA NIVEL 2 · rev2 (versión de trabajo)

**Estado:** versión de trabajo para revisión. No apta para construcción ni trámite.

## Archivos
| Archivo | Uso |
|---|---|
| `SR-A3_NIVEL2_rev2.pdf` | Plano para revisar (A1 al 100 %) |
| `SR-A3_NIVEL2_rev2.dxf` | Editable AutoCAD 2018 |

## Cambios respecto a rev1 (su indicación del 06-10-2026)
| Indicación | Aplicado |
|---|---|
| Todas las ventanas deben ventilar | La nota de la fachada frontal ya no dice "walk-in con vidrios fijos". Ahora indica paño fijo inferior de seguridad hasta 0.90 m y ventilas abatibles hacia afuera en la parte superior. |
| Fachada posterior operable en toda su área | Agregado a la nota de la fachada posterior. |
| Criterio general | Nota nueva: ventila abatible hacia afuera (bisagra superior); donde interfiera con un pasillo, corrediza de dos paños móvil-móvil. |

Geometría, áreas y cotas sin cambios respecto a rev1.

## Para confirmar
- **Galería del pasillo hacia P1:** la planta la rotula "VIDRIO FIJO A P1". ¿Debe ser también operable? Si lo es, ¿ventila hacia el patio o corrediza móvil-móvil?

## Validación
- DXF revisado con `recover` y `audit`.
- PDF revisado visualmente.
