jbarra777/jbarra777/planos/A5_fachadas/SR-A5_relacion_rev2.md

# Lámina A5 · FACHADAS · rev2 (versión de trabajo)

**Estado:** versión de trabajo para revisión. No apta para construcción ni trámite.

## Archivos
| Archivo | Uso |
|---|---|
| `SR-A5_FACHADAS_rev2.pdf` | Plano para revisar (A1 al 100 %) |
| `SR-A5_FACHADAS_rev2.dxf` | Editable AutoCAD 2018, layout `A5-FACHADAS` |

## Cambios respecto a rev1 (sus indicaciones del 06-10-2026)
| Indicación | Aplicado |
|---|---|
| Todas las ventanas con ventilación | En el frente, solo los paños inferiores de seguridad (0–0.90) son fijos y se marcan "F". Los paños superiores son **ventilas abatibles hacia afuera** (bisagra superior), una por paño, incluidas las del walk-in y el baño. Se eliminó "vidrios fijos" en los walk-in. |
| Ventila tipo alero; corrediza móvil-móvil donde haya pasillo | Nota 8 con el criterio. En las fachadas no hay ventanas que den a un pasillo, así que todas son ventilas. |
| Fachada posterior operable en toda su área | Todas las ventanas son ventilas abatibles, sin paños fijos (nota 10). |
| Canoas en los patios donde se requiera | Agregado a la nota 6. |
| Tapia del lindero posterior hasta la viga del último nivel | En las fachadas laterales se dibuja de canto hasta +9.00, con flecha y la nota "tapia lindero posterior hasta viga corona del último nivel (+9.00, ver nota 2)". También se agregó a la nota 11. |
| Simbología | Se reemplazó "vidrio claro" por "ventila abatible hacia afuera" y "F = paño fijo de seguridad". |

## Confirmado por usted (06-10-2026)
- 2 bajantes por canoa (frontal y posterior). En el N1 los frontales van ocultos.
- Cumbrera al centro (+10.50).
- Antepecho de 0.90 también en el baño de la suite 3.
- Remate de los muros de colindancia según la pendiente, sin pretil.

## Validación
- DXF revisado con `recover` y `audit`.
- PDF revisado visualmente.
- No se probó en AutoCAD.
