jbarra777/jbarra777/planos/A2_nivel1/SR-A2_relacion_rev2.md

# Lámina A2 · PLANTA NIVEL 1 · rev2 (versión de trabajo)

**Estado:** versión de trabajo para revisión. No apta para construcción ni trámite.
**Aviso:** la A2 rev1 estaba APROBADA. Esta rev2 la modifica por su indicación del 06-10-2026: no hay tapias laterales y los muros de la vivienda son la división en el lindero.

## Archivos
| Archivo | Uso |
|---|---|
| `SR-A2_NIVEL1_rev2.pdf` | Plano para revisar (A1 al 100 %) |
| `SR-A2_NIVEL1_rev2.dxf` | Editable AutoCAD 2018, layout `A2-NIVEL1` |

## Cambios respecto a rev1
| Indicación | Aplicado |
|---|---|
| No hay tapias laterales | Se eliminaron las tapias laterales del retiro posterior (y 25.18 a 28.51, a ambos lados). La trama de jardín seco llega ahora al lindero. |
| Los muros de la vivienda son la división en el lindero; en el N1 debe haber muro hasta el entrepiso | Los muros de colindancia del N1 ya estaban en todo el largo de la vivienda (y 2.06 a 25.18). Se agregó la **nota 18**: muros continuos hasta el entrepiso (+3.00) y sin tapias laterales en los retiros. |
| Superposición detectada al revisar | La marca de corte A en el fondo se movió para no tapar la cota 3.43 (ejes B–C). |
| Notas | Se escriben una por texto (`notes_block`), igual que en A3–A5. |

## Para confirmar
1. **Tapia del lindero posterior (fondo).** Usted habló solo de las laterales, así que la tapia del fondo de rev1 se mantiene. Para cerrar las esquinas se extendió hasta los vértices 4 y 5. ¿Se mantiene? ¿Con qué altura?

## Sin cambios
Áreas (N1 = 66.57 m²), cobertura (70.13 %), estacionamientos, portón, columnas y escalera.

## Validación
- DXF revisado con `recover` y `audit`.
- PDF revisado visualmente.
- No se probó en AutoCAD.
