jbarra777/jbarra777/planos/A3_nivel2/SR-A3_relacion_rev1.md

# Lámina A3 · PLANTA NIVEL 2 · rev1 (versión de trabajo)

**Estado:** versión de trabajo para revisión. No apta para construcción ni trámite.
**Aviso:** la A3 rev0 estaba APROBADA. Esta rev1 aplica el patrón de ventanas posteriores que usted aprobó el 06-10-2026.

## Archivos
| Archivo | Uso |
|---|---|
| `SR-A3_NIVEL2_rev1.pdf` | Plano para revisar (A1 al 100 %) |
| `SR-A3_NIVEL2_rev1.dxf` | Editable AutoCAD 2018, layout `A3-NIVEL2` |

## Cambios respecto a rev0
| Indicación | Aplicado |
|---|---|
| Patrón común de ventanas posteriores | En la sala familiar las ventanas eran 0.90–3.90 y 5.00–8.00. Ahora son **0.70–2.90 / 3.85–4.60 / 6.40–8.20**, alineadas con el N3. La ventana angosta queda a 0.09 m de la cara de C6. Se agregó una cadena de cotas exterior. |
| Antepecho común en la fachada posterior | Nota nueva: antepecho de 0.90 m y dintel a 2.20 m (el detalle está en la A5). |
| Ventanas desde el piso: opción a | Nota nueva para la fachada frontal: paño fijo inferior hasta 0.90 m, sin especificar el tipo de vidrio. Walk-in con vidrios fijos. |
| Altura de piso a piso confirmada | Se quitó "PROVISIONAL" en la nota del NPT +3.00. |
| Superposiciones detectadas al revisar | La marca de corte A en el fondo ya no tapa la cota 3.43. El NPT +3.00 de la sala se movió para no tapar la ventana nueva. |

## Sin cambios
Distribución, áreas (N2 = 179.53 m²), puertas, cocina y suite 1.

## Validación
- DXF revisado con `recover` y `audit`.
- PDF revisado visualmente.
- No se probó en AutoCAD.
