jbarra777/jbarra777/planos/A4_nivel3/SR-A4_relacion_rev1.md

# Lámina A4 · PLANTA NIVEL 3 · rev1 (versión de trabajo)

**Estado:** versión de trabajo para revisión. No apta para construcción ni trámite.

## Archivos
| Archivo | Uso |
|---|---|
| `SR-A4_NIVEL3_rev1.pdf` | Plano para revisar (A1 al 100 %) |
| `SR-A4_NIVEL3_rev1.dxf` | Editable AutoCAD 2018, layout `A4-NIVEL3` |

## Cambios respecto a rev0
| Indicación | Aplicado |
|---|---|
| Conflicto de la ventana del baño de la suite 3 con C6 | La ventana del baño estaba en 3.95–4.95 y la columna C6 está en 4.69–4.99. Ahora la ventana va en **3.85–4.60** y libra la columna (0.09 m de muro hasta su cara). |
| Patrón común de ventanas posteriores | **0.70–2.90 (dormitorio) / 3.85–4.60 (baño) / 6.40–8.20 (walk-in)**, alineadas con la sala del N2. Se agregó una cadena de cotas exterior. |
| Antepecho común en la fachada posterior | Nota nueva: 0.90 m de antepecho y dintel a 2.20 m. |
| Ventanas desde el piso: opción a; walk-in con vidrios fijos | Nota nueva igual a la de la A3. |
| Superposición detectada al revisar | La marca de corte A en el fondo ya no tapa la cota 3.43. |

## Sin cambios
Suites, baños, walk-in, áreas (N3 = 179.53 m²) y escalera.

## Validación
- DXF revisado con `recover` y `audit`.
- PDF revisado visualmente.
- No se probó en AutoCAD.
