jbarra777/jbarra777/planos/A5_fachadas/SR-A5_relacion_rev0.md

# Lámina A5 · FACHADAS · rev0 (versión de trabajo)

**Estado:** versión de trabajo para revisión. No apta para construcción ni trámite.

## Archivos
| Archivo | Uso |
|---|---|
| `SR-A5_FACHADAS_rev0.pdf` | **Plano para revisar e imprimir** (A1, al 100 %) |
| `SR-A5_FACHADAS_rev0.dxf` | Editable, AutoCAD 2018. Layout `A5-FACHADAS`; cada fachada en su propia zona del Model Space |

## Contenido (equivalente a la A5 de la referencia)
- **Fachada principal (norte) a 1:50**, con:
  - ejes D–A (vista desde la calle, con el este a la izquierda);
  - cotas horizontales de vanos y cotas verticales de niveles;
  - portón abatible de 4 hojas, pilastra en el eje B y acceso peatonal a la derecha;
  - ventanas de piso a 2.20 m en los niveles 2 y 3, alineadas;
  - vidrio arenado en los baños;
  - franjas opacas en las vigas y la losa, y pretil.
- **Fachada posterior (sur) a 1:75**: nivel 1 abierto (jardín seco) con la columna C6 y los muros de colindancia. En los niveles 2 y 3, ventanas con antepecho.
- **Fachadas laterales este y oeste a 1:100**: muros de colindancia ciegos, con ejes 1–6, retiros y tapias en los retiros.
- Notas 1–10 y simbología.

## Criterios aplicados (según su indicación)
- **Ventanas de la fachada principal:** de piso a 2.20 m sobre el NPT, alineadas verticalmente entre los niveles 2 y 3. Entre el dintel (+2.20) y la losa siguiente queda una franja opaca de 0.80 m, que sirve de base para el diseño moderno.
- **Baños:** vidrio arenado (sandblast) templado.
- **Ventanas de dormitorio y walk-in:** se dibuja un travesaño a 0.90 m para el paño fijo laminado de protección (pendiente de su visto bueno).

## Supuestos preliminares (PD = por definir)
- Altura del portón y de la puerta peatonal: 2.40 m.
- Cubierta a +9.00 y pretil a +9.60. Dependen del diseño de techos y de la altura máxima que permita la municipalidad (no verificada).
- Altura de las tapias en los retiros: por confirmar.
- Fachada posterior con antepecho de 0.90 en sala y dormitorio, y de 1.60 en baño y walk-in.

## Validación
- DXF revisado con `recover` y `audit`: 0 errores.
- PDF revisado visualmente.
- No se probó en AutoCAD.
