jbarra777/jbarra777/planos/A4_nivel3/SR-A4_relacion_rev0.md

# Lámina A4 · PLANTA NIVEL 3 · rev0 (versión de trabajo)

**Estado:** versión de trabajo para revisión. No apta para construcción ni trámite.

## Archivos
| Archivo | Uso |
|---|---|
| `SR-A4_NIVEL3_rev0.pdf` | **Plano para revisar e imprimir** (A1, al 100 %) |
| `SR-A4_NIVEL3_rev0.dxf` | Editable, AutoCAD 2018. Layout `A4-NIVEL3` |

## Contenido (equivalente a la A4 de la referencia)
- **Planta del nivel 3 a 1:50** con:
  - ejes y cotas;
  - muros, puertas, ventanas, mobiliario y piezas sanitarias;
  - columnas C2 a C6;
  - escalera de llegada con baranda;
  - patios P1 y P2, niveles NPT +6.00, cortes y norte.
- Derrotero, cuadro de áreas del nivel 3, resumen de áreas de construcción, cobertura, detalle del extractor y notas 1–19.

## Distribución (base A-202, con los mismos ajustes aprobados en A3)
| Espacio | Medidas libres | Área |
|---|---|---|
| Suite 1 (dormitorio-estar, baño y walk-in) | 8.70 × 5.40 | 46.98 m² |
| · Baño / walk-in | 1.55 × 2.20 / 3.46 × 3.25 | 3.41 / 11.24 m² |
| Suite 2 (dormitorio-estar, baño y walk-in) | 7.38 × 6.42 | 47.38 m² |
| · Baño / walk-in | 1.55 × 2.20 / 2.75 × 4.10 | 3.41 / 11.28 m² |
| Suite 3 (dormitorio-estar, baño y walk-in) | 8.70 × 5.40 | 46.98 m² |
| · Baño / walk-in | 1.55 × 2.20 / 3.46 × 3.25 | 3.41 / 11.24 m² |
| Pasillo | 1.20 × 11.72 | 14.06 m² |
| Gradas | 3.34 × 2.50 | 8.35 m² |
| **Área construida nivel 3** | | **179.53 m²** |

**Área total de construcción:** 66.57 + 179.53 + 179.53 = **425.63 m²**.

## Ajustes respecto a la planta A-202
1. **Accesos.** Los de las suites 1 y 3 pasan al final del pasillo (ejes 2 y 5), como en A3. La suite 2 conserva su acceso desde el pasillo (muro B).
2. **Baños** de 1.55 × 2.20 con piezas en línea y puerta de 0.80 abatible hacia el dormitorio. Las suites 1 y 3 son iguales entre sí, en espejo.
3. **Suite 2: baño reubicado para alinear instalaciones.** Pasa del costado de P1 al costado de P2, **sobre la zona húmeda de la cocina del nivel 2** (muro este y fregadero). Tiene ventana alta a P2 y extractor. Con este cambio:
   - el walk-in queda junto a P1, mide 2.75 × 4.10 m (11.28 m²) y tiene ventana;
   - el dormitorio y el estar quedan entre el pasillo y el walk-in.

   Si prefiere la posición original de la A-202, lo cambio.
4. **Escalera.** Es la llegada al último nivel: se dibujan los 2 tramos bajo el piso, con la flecha BAJA, y una baranda en el borde del vacío hacia el pasillo.
5. **Pasillo** con vidrio fijo hacia P1 y ventanas desfasadas entre suites, igual que en A3.

## Coordinación entre niveles
- **Baño de la suite 1** (N3): sobre el baño del nivel 2, alineado.
- **Baño de la suite 2** (N3): sobre la cocina del nivel 2, alineado con su muro húmedo.
- **Baño de la suite 3** (N3): debajo está la sala familiar, que no tiene instalaciones húmedas. Hace falta un **ducto sanitario** que baje por la sala del nivel 2 hasta el jardín seco del nivel 1. Se define en las láminas sanitarias.

## Pendientes
- Ubicación y medidas de los ductos sanitarios (láminas IS).
- Puertas y ventanas (lámina A9).
- Modelo del extractor de aire [PR].
- Diseño estructural.

## Validación
- DXF revisado con `recover` y `audit`: 0 errores.
- Áreas recalculadas.
- PDF revisado por zonas.
- No se probó en AutoCAD.
