jbarra777/jbarra777/planos/A3_nivel2/SR-A3_relacion_rev0.md

# Lámina A3 · PLANTA NIVEL 2 · rev0 (versión de trabajo)

**Estado:** versión de trabajo para revisión. No apta para construcción ni trámite.

## Archivos
| Archivo | Uso |
|---|---|
| `SR-A3_NIVEL2_rev0.pdf` | **Plano para revisar e imprimir** (A1, al 100 %) |
| `SR-A3_NIVEL2_rev0.dxf` | Editable, AutoCAD 2018. Layout `A3-NIVEL2` |

## Contenido (equivalente a la A3 de la referencia)
- **Planta del nivel 2 a 1:50** con:
  - ejes, cotas generales, interiores y entre ejes;
  - muros con trama, puertas con arco de apertura y ventanas;
  - mobiliario y piezas sanitarias a escala;
  - columnas C2 a C6 sobre el eje C;
  - escalera en U con flechas de SUBE y BAJA;
  - patios P1 y P2 abiertos, niveles NPT +3.00, cortes A-A y B-B, y norte.
- Derrotero, cuadro de áreas del nivel 2, resumen de áreas de construcción, porcentaje de cobertura, **detalle esquemático del extractor de aire** y notas 1–19.

## Distribución (base A-201, conservando su organización)
| Espacio | Medidas libres | Área |
|---|---|---|
| Suite 1: dormitorio y estar (incluye baño y walk-in) | 8.70 × 5.40 | 46.98 m² |
| · Baño | 1.55 × 2.20 | 3.41 m² |
| · Walk-in closet | 3.46 × 3.25 | 11.24 m² |
| Cocina-comedor | 7.38 × 6.42 | 47.38 m² |
| Sala familiar | 8.70 × 5.40 | 46.98 m² |
| Pasillo | 1.20 × 11.72 | 14.06 m² |
| Gradas | 3.34 × 2.50 | 8.35 m² |
| **Área construida nivel 2** (envolvente − patios, incluye muros) | | **179.53 m²** |

Áreas de construcción: nivel 1 66.57 + nivel 2 179.53 + nivel 3 179.53 (preliminar) = **425.63 m²**.

## Ajustes respecto a la planta A-201
1. **Accesos.** La puerta de la suite y la de la sala familiar estaban en el muro de colindancia oeste. Ahora están al final del pasillo: muros de los ejes 2 y 5.
2. **Escalera.** Antes era un tramo recto rotulado "existente". Ahora es en U, de 17 contrahuellas de 0.176 m y huellas de 0.28 m, con tramos de 1.10 m y desembarco en el pasillo.
3. **Baño de 1.55 × 2.20 m** (se mantiene la medida):
   - piezas en línea: ducha de 0.85 m junto a la fachada, inodoro y lavatorio sobre el muro del walk-in;
   - paso libre de 1.05 m;
   - puerta de 0.80 m abatible hacia el dormitorio; antes era corrediza de unos 0.65 m.
4. **Pasillo.** Se cierra hacia el patio P1 con vidrio fijo y queda como galería. Se quitó el rótulo "paso común".
5. **Cocina.** Pasó a ser en L sobre el muro este y el muro del patio P2, con una isla de 2.30 × 0.90 m. El fregadero queda bajo la ventana a P2 y la cocina sobre el muro de colindancia. Pasos libres de 0.93 a 1.05 m. Se agregaron despensa y aparador. El comedor es para 8 personas.
6. **Ventanas hacia P1** desfasadas entre la suite y la cocina-comedor, para reducir las visuales cruzadas.
7. **Columnas C2 a C6** en el eje C, coordinadas con la lámina A2 y ubicadas en las líneas de muro.

## Pendientes
- Altura de piso a piso de 3.00 m (provisional).
- Tipos y medidas definitivas de puertas y ventanas (lámina A8).
- Caudal y modelo del extractor de aire: marcado [PR] en el detalle.
- Secciones de columnas y vigas (diseño estructural).
- Núcleo húmedo del nivel 3: alinear con este baño (lámina A4).

## Validación
- DXF revisado con `recover` y `audit`: 0 errores.
- Áreas recalculadas desde la geometría.
- PDF revisado por zonas.
- No se probó en AutoCAD.
