jbarra777/jbarra777/planos/A2_nivel1/SR-A2_relacion_rev1.md

# Lámina A2 · PLANTA NIVEL 1 · rev1 (versión de trabajo)

**Estado:** versión de trabajo para revisión. No apta para construcción ni trámite.

## Cambios respecto a rev0 (según sus indicaciones)
| Indicación | Aplicado |
|---|---|
| Mantener solo los estacionamientos 1-2-3 | E-1 a E-3 de 2.50 × 5.00 en la franja y 2.21–7.21. Se eliminaron E-4 a E-6. |
| Lo demás del nivel es jardín seco no construido | Se eliminaron la bodega, el espacio cubierto posterior y los muros interiores, puertas y ventanas del nivel 1. Todo eso queda con trama de grava y el rótulo "JARDÍN SECO (NO CONSTRUIDO)", incluido el patio posterior. |
| Cuadro de áreas: solo estacionamientos, pasillo y gradas | Estacionamientos 37.50 + pasillo 20.72 + gradas 8.35 = **66.57 m²** construidos en el nivel 1. Se quitó la bodega. |
| Portón vehicular abatible | Abatible de **4 hojas plegables (2 por lado) de 1.82 m**, que abren hacia el retiro frontal (2.00 m) sin invadir la vía pública. |
| Columnas sobre el eje C cada ~5 m, ajustadas a los ejes | Columnas C2, C3, C4, C5 y C6 en los ejes transversales 2 a 6. Sección preliminar de 0.30 × 0.30. |
| Limpieza del tanque séptico | Sin cambios; no requiere ajuste. |

## Decisiones que tomé y necesitan su visto bueno
1. **No hay columna en C1 (fachada frontal).** En el eje 1 la columna quedaría en medio del portón, en x 4.69–4.99, y dentro del espacio E-2. Con ella no caben 3 estacionamientos de 2.50 m. La viga del eje 1 tendría que salvar el claro desde la pilastra del eje B hasta el muro del eje D, unos 7.3 m. Queda para el diseño estructural.
2. **El eje C se movió de x 4.75 a x 4.84**, el centro de la columna. La cara oeste de la columna queda alineada con el borde de la escalera (x 4.69), para no invadir el descanso. En los niveles 2 y 3 la columna sobresale unos 0.18 m hacia el patio P2.
3. **Separaciones entre columnas:** 2.65 – 6.57 – 2.65 – 5.55 m. El tramo C3–C4 (6.57 m) es el más largo. La columna C6 queda al ras de la fachada posterior.
4. **Hojas del portón hacia afuera.** Si abrieran hacia adentro, chocarían con los vehículos estacionados.
5. **Cobertura sin cambio: 70.13 %.** La huella sigue siendo la proyección de los niveles 2 y 3 (179.53 m²), aunque el nivel 1 casi no se construya.
6. **Barandas en la escalera del nivel 1.** Las gradas quedan abiertas hacia el jardín seco, así que les dibujé baranda en los costados. El detalle va en la lámina A11.

## Contenido
- Planta del nivel 1 a 1:50 con:
  - ejes, cotas, tapias y muros de colindancia;
  - columnas del eje C, pilastra del eje B y portones;
  - 3 vehículos, gradas en U con barandas;
  - proyección de los patios P1 y P2 y del borde del nivel 2;
  - niveles, cortes A-A y B-B, y norte.
- Derrotero, cuadro de áreas del nivel 1, porcentaje de cobertura, notas 1–17 y cajetín con la revisión 1.
- Las áreas de los niveles 2 y 3 se presentarán en las láminas A3 y A4.

## Pendientes
- Diseño estructural: secciones, refuerzo, viga del eje 1 y cimentación.
- Acabado del jardín seco (grava, adoquín u otro) y drenaje del nivel 1.
- Pendiente de piso de los estacionamientos hacia la calle.

## Validación
- DXF revisado con `recover` y `audit`.
- Cotas comparadas con la geometría.
- Áreas recalculadas.
- PDF revisado visualmente.
- No se probó en AutoCAD.
