jbarra777/jbarra777/planos/A1_lote/A1_ubicacion_catastro.png

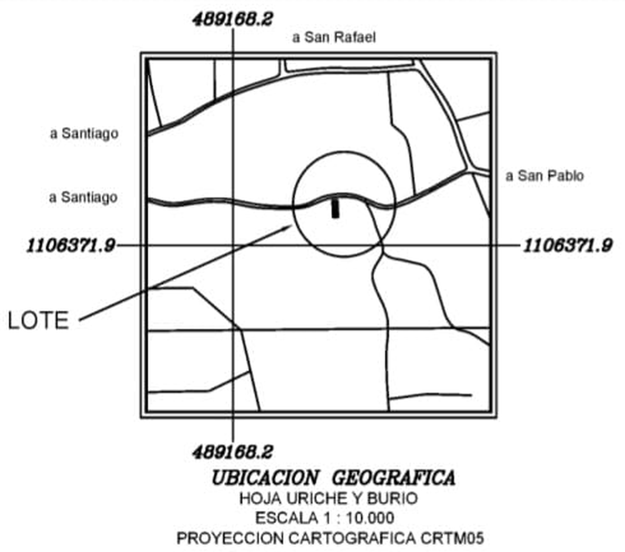
planos/A1_lote/A1_ubicacion_catastro.png
