jbarra777/jbarra777/planos/A1_lote/SR-A1_LOTE_rev0.png

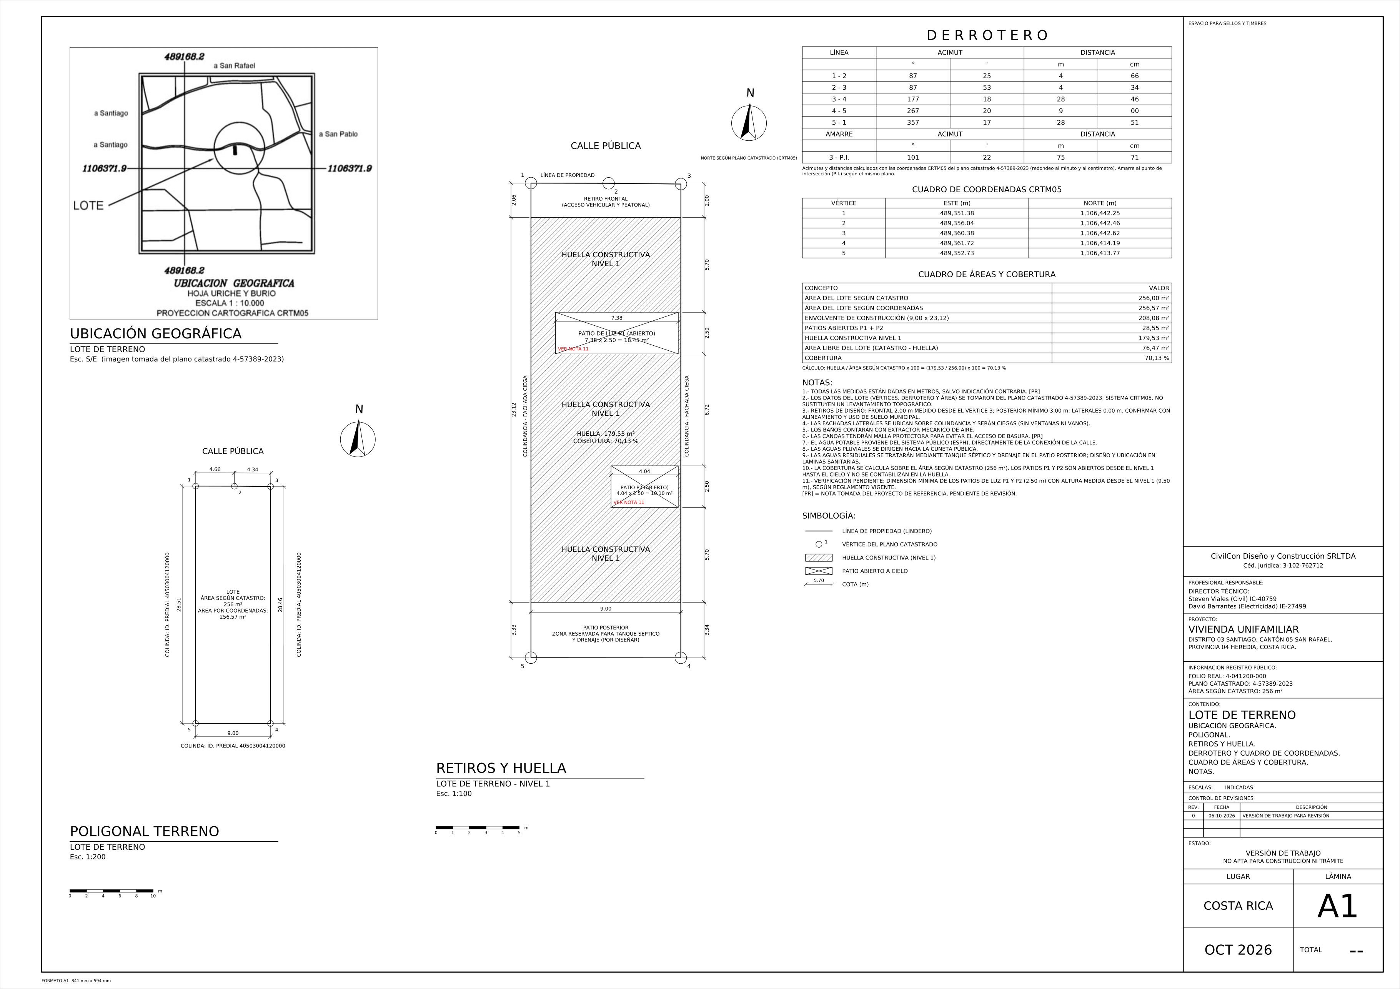
planos/A1_lote/SR-A1_LOTE_rev0.png
