jbarra777/jbarra777/planos/A2_nivel1/SR-A2_NIVEL1_rev0.png

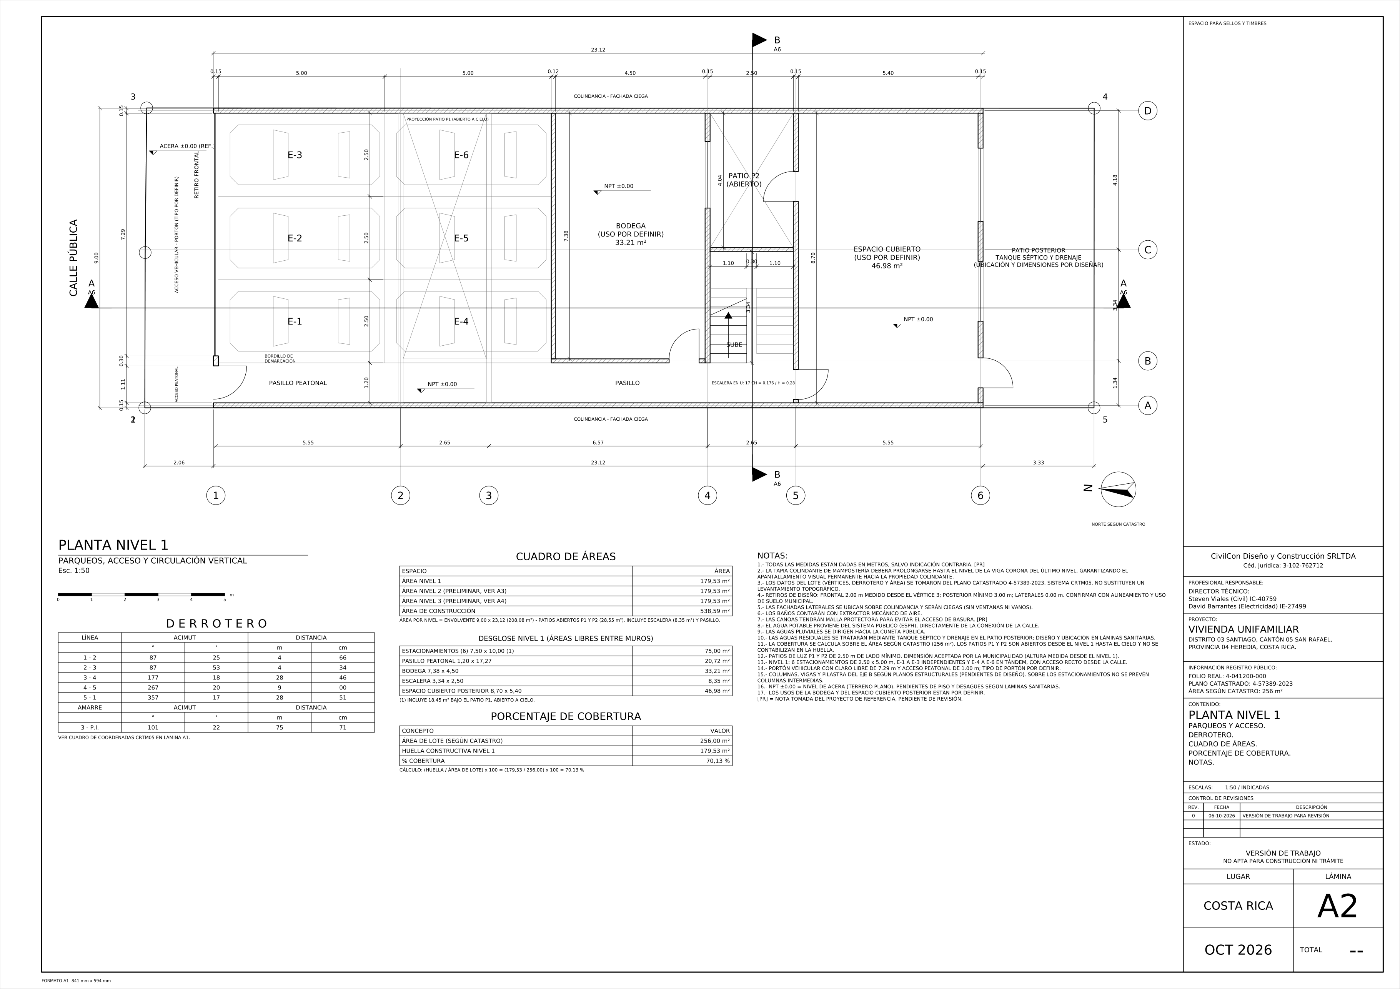
planos/A2_nivel1/SR-A2_NIVEL1_rev0.png
