jbarra777/jbarra777/(list of files, cad)

Other CAD files:
planos/A11_escalera/SR-A11_ESCALERA_rev1.dxf
planos/A1_lote/SR-A1_LOTE_rev3.dxf
planos/A2_nivel1/SR-A2_NIVEL1_rev5.dxf
planos/A3_nivel2/SR-A3_NIVEL2_rev6.dxf
planos/A4_nivel3/SR-A4_NIVEL3_rev6.dxf
planos/A5_fachadas/SR-A5_FACHADAS_rev8.dxf
planos/A6_cortes/SR-A6_CORTES_rev6.dxf
planos/A7_puertas_ventanas/SR-A7_PUERTAS_VENTANAS_rev4.dxf
planos/A8_escalera/SR-A8_ESCALERA_rev2.dxf
planos/C01_cimentaciones/SR-C01_CIMENTACIONES_rev2.dxf
planos/C02_cimentacion_detalles/SR-C02_CIMENTACION_DETALLES_rev2.dxf
planos/C03_entrepiso_n2/SR-C03_ENTREPISOS_rev3.dxf
planos/C04_techo/SR-C04_TECHO_rev3.dxf
planos/C05_porticos/SR-C05_PORTICOS_rev3.dxf
planos/C05_porticos_longitudinal/SR-C05_PORTICOS_LONGITUDINAL_rev0.dxf
planos/C06_especificaciones/SR-C06_ESPECIFICACIONES_rev2.dxf
planos/C06_porticos_transversal/SR-C06_PORTICOS_TRANSVERSAL_rev0.dxf
planos/E01_nivel1/SR-E01_NIVEL1_rev2.dxf
planos/E02_nivel2/SR-E02_NIVEL2_rev1.dxf
planos/E03_nivel3/SR-E03_NIVEL3_rev1.dxf
planos/E04_tableros/SR-E04_TABLEROS_rev1.dxf
planos/E05_detalles/SR-E05_DETALLES_rev1.dxf
planos/S01_agua_potable/SR-S01_AGUA_POTABLE_rev2.dxf
planos/S02_aguas_residuales/SR-S02_AGUAS_RESIDUALES_rev2.dxf
planos/S03_pluviales/SR-S03_PLUVIALES_rev1.dxf
planos/C03_entrepiso_n2/SR-C03_ENTREPISO_N2_rev0.dxf
planos/A11_escalera/SR-A11_ESCALERA_rev0.dxf
planos/A1_lote/SR-A1_LOTE_rev0.dxf
planos/A1_lote/SR-A1_LOTE_rev1.dxf
planos/A1_lote/SR-A1_LOTE_rev2.dxf
planos/A2_nivel1/SR-A2_NIVEL1_rev0.dxf
planos/A2_nivel1/SR-A2_NIVEL1_rev1.dxf
planos/A2_nivel1/SR-A2_NIVEL1_rev2.dxf
planos/A2_nivel1/SR-A2_NIVEL1_rev3.dxf
planos/A2_nivel1/SR-A2_NIVEL1_rev4.dxf
planos/A3_nivel2/SR-A3_NIVEL2_rev0.dxf
planos/A3_nivel2/SR-A3_NIVEL2_rev1.dxf
planos/A3_nivel2/SR-A3_NIVEL2_rev2.dxf
planos/A3_nivel2/SR-A3_NIVEL2_rev3.dxf
planos/A3_nivel2/SR-A3_NIVEL2_rev4.dxf
planos/A3_nivel2/SR-A3_NIVEL2_rev5.dxf
planos/A4_nivel3/SR-A4_NIVEL3_rev0.dxf
planos/A4_nivel3/SR-A4_NIVEL3_rev1.dxf
planos/A4_nivel3/SR-A4_NIVEL3_rev2.dxf
planos/A4_nivel3/SR-A4_NIVEL3_rev3.dxf
planos/A4_nivel3/SR-A4_NIVEL3_rev4.dxf
planos/A4_nivel3/SR-A4_NIVEL3_rev5.dxf
planos/A5_fachadas/SR-A5_FACHADAS_rev0.dxf
planos/A5_fachadas/SR-A5_FACHADAS_rev1.dxf
planos/A5_fachadas/SR-A5_FACHADAS_rev2.dxf
planos/A5_fachadas/SR-A5_FACHADAS_rev3.dxf
planos/A5_fachadas/SR-A5_FACHADAS_rev4.dxf
planos/A5_fachadas/SR-A5_FACHADAS_rev5.dxf
planos/A5_fachadas/SR-A5_FACHADAS_rev6.dxf
planos/A5_fachadas/SR-A5_FACHADAS_rev7.dxf
planos/A6_cortes/SR-A6_CORTES_rev0.dxf
planos/A6_cortes/SR-A6_CORTES_rev1.dxf
planos/A6_cortes/SR-A6_CORTES_rev2.dxf
planos/A6_cortes/SR-A6_CORTES_rev3.dxf
planos/A6_cortes/SR-A6_CORTES_rev4.dxf
planos/A6_cortes/SR-A6_CORTES_rev5.dxf
planos/A7_puertas_ventanas/SR-A7_PUERTAS_VENTANAS_rev0.dxf
planos/A7_puertas_ventanas/SR-A7_PUERTAS_VENTANAS_rev1.dxf
planos/A7_puertas_ventanas/SR-A7_PUERTAS_VENTANAS_rev2.dxf
planos/A7_puertas_ventanas/SR-A7_PUERTAS_VENTANAS_rev3.dxf
planos/C01_cimentaciones/SR-C01_CIMENTACIONES_rev0.dxf
planos/C01_cimentaciones/SR-C01_CIMENTACIONES_rev1.dxf
planos/C02_cimentacion_detalles/SR-C02_CIMENTACION_DETALLES_rev0.dxf
planos/C02_cimentacion_detalles/SR-C02_CIMENTACION_DETALLES_rev1.dxf
planos/C03_entrepiso_n2/SR-C03_ENTREPISOS_rev1.dxf
planos/C03_entrepiso_n2/SR-C03_ENTREPISOS_rev2.dxf
planos/C04_techo/SR-C04_TECHO_rev0.dxf
planos/C04_techo/SR-C04_TECHO_rev1.dxf
planos/C04_techo/SR-C04_TECHO_rev2.dxf
planos/C05_porticos/SR-C05_PORTICOS_rev1.dxf
planos/C05_porticos/SR-C05_PORTICOS_rev2.dxf
planos/C06_especificaciones/SR-C06_ESPECIFICACIONES_rev0.dxf
planos/C06_especificaciones/SR-C06_ESPECIFICACIONES_rev1.dxf
planos/E01_nivel1/SR-E01_NIVEL1_rev0.dxf
planos/E01_nivel1/SR-E01_NIVEL1_rev1.dxf
planos/E02_nivel2/SR-E02_NIVEL2_rev0.dxf
planos/E03_nivel3/SR-E03_NIVEL3_rev0.dxf
planos/E04_tableros/SR-E04_TABLEROS_rev0.dxf
planos/E05_detalles/SR-E05_DETALLES_rev0.dxf
planos/S01_agua_potable/SR-S01_AGUA_POTABLE_rev0.dxf
planos/S01_agua_potable/SR-S01_AGUA_POTABLE_rev1.dxf
planos/S02_aguas_residuales/SR-S02_AGUAS_RESIDUALES_rev0.dxf
planos/S02_aguas_residuales/SR-S02_AGUAS_RESIDUALES_rev1.dxf
planos/S03_pluviales/SR-S03_PLUVIALES_rev0.dxf
