jbarra777/jbarra777/planos/JUEGO_COMPLETO/JUEGO_3_ELECTRICIDAD_E01-E05.pdf

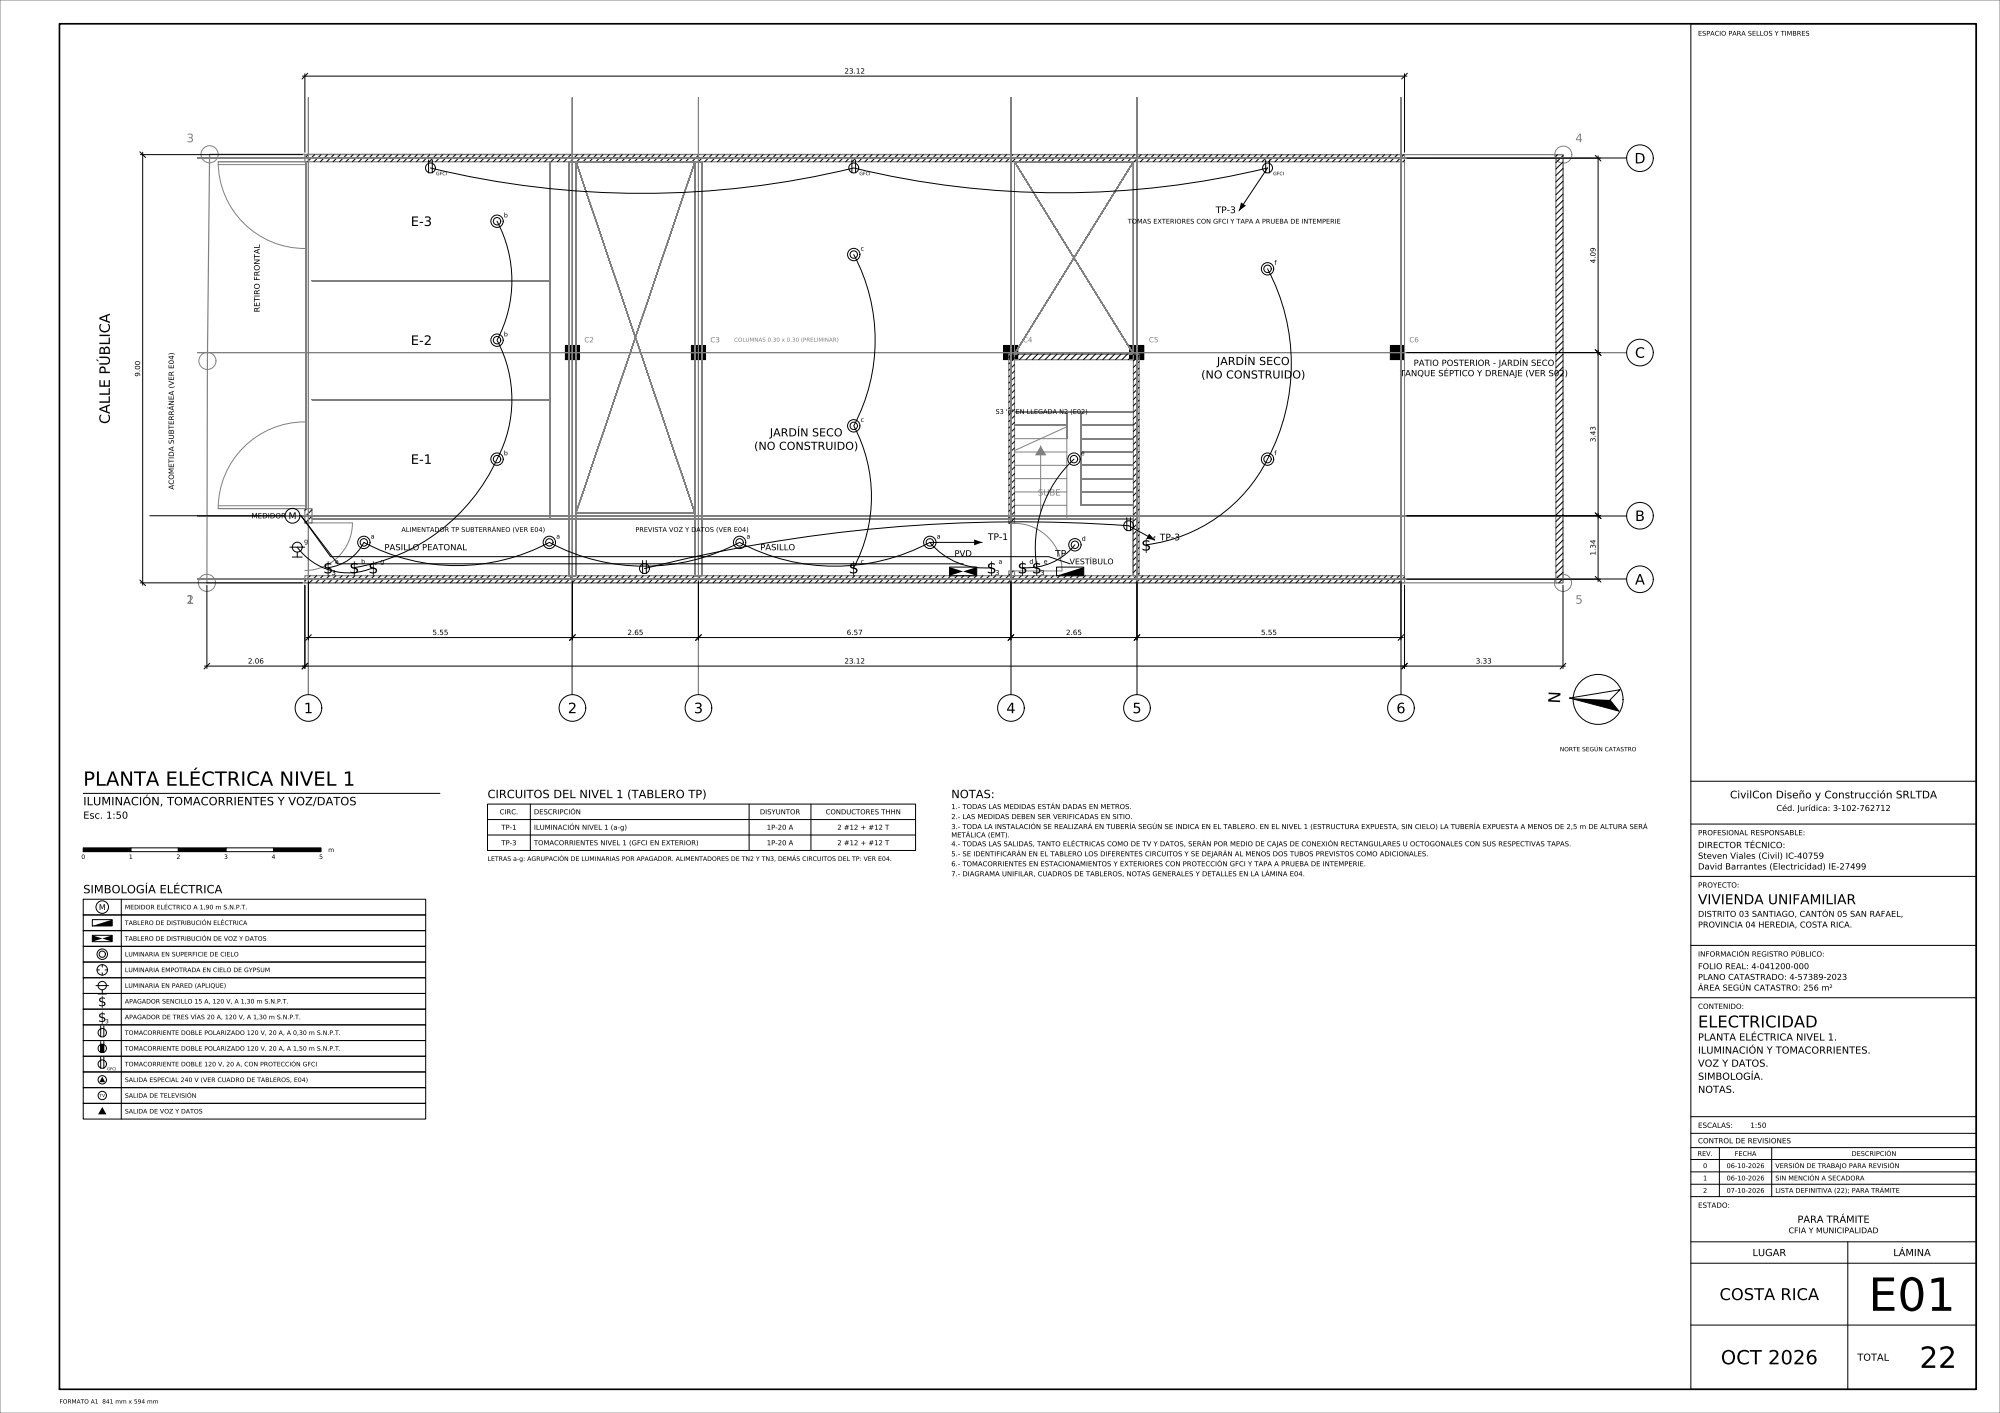
[picture p12: page 1]

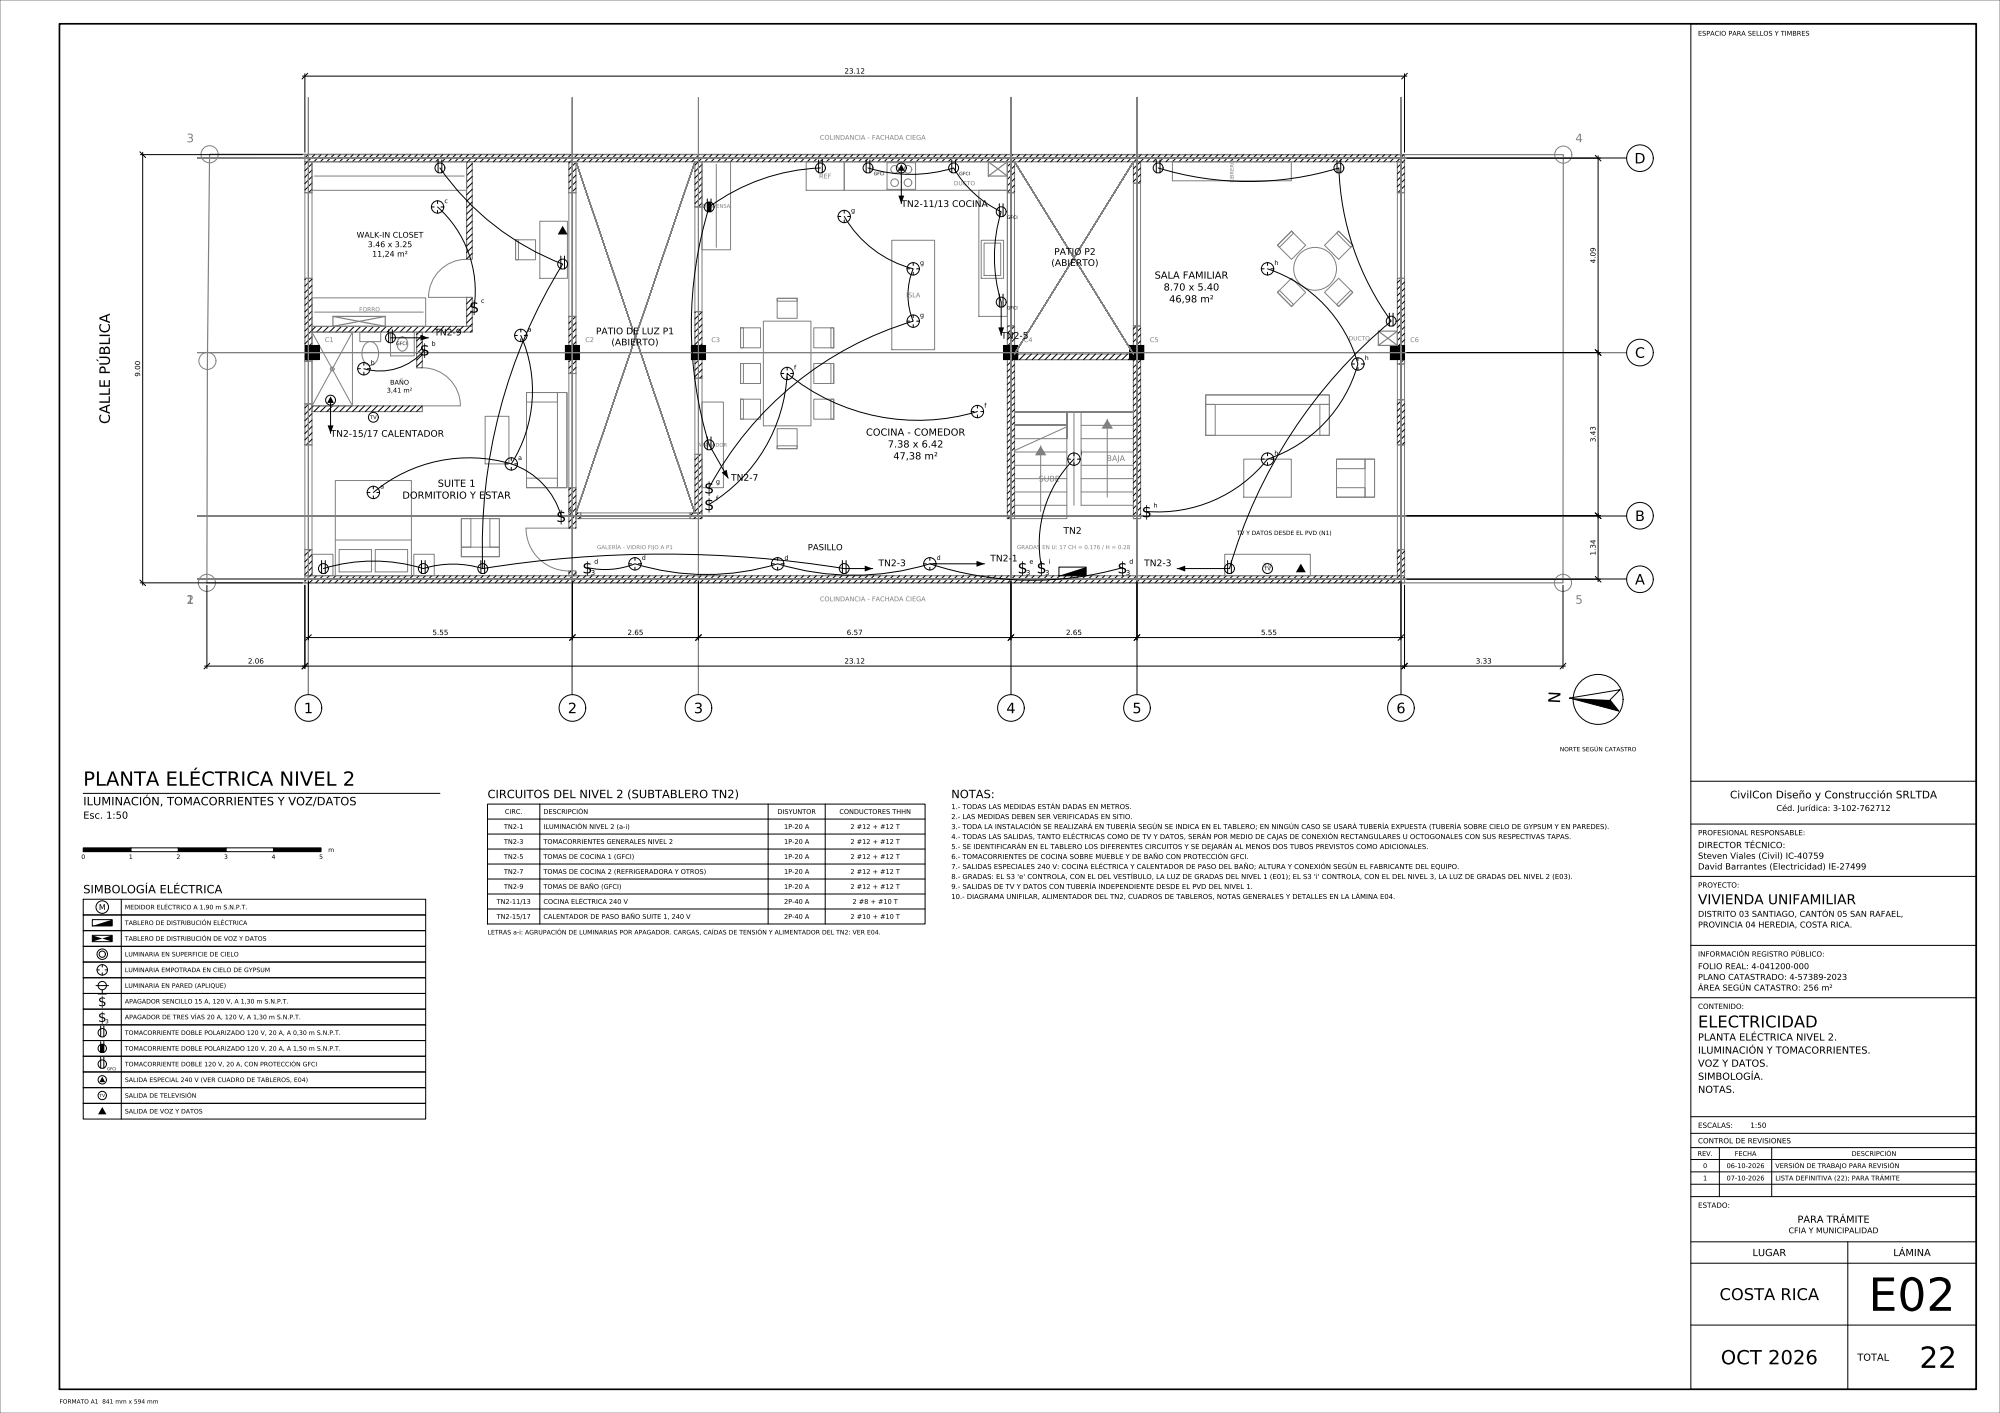
[picture p13: page 2]

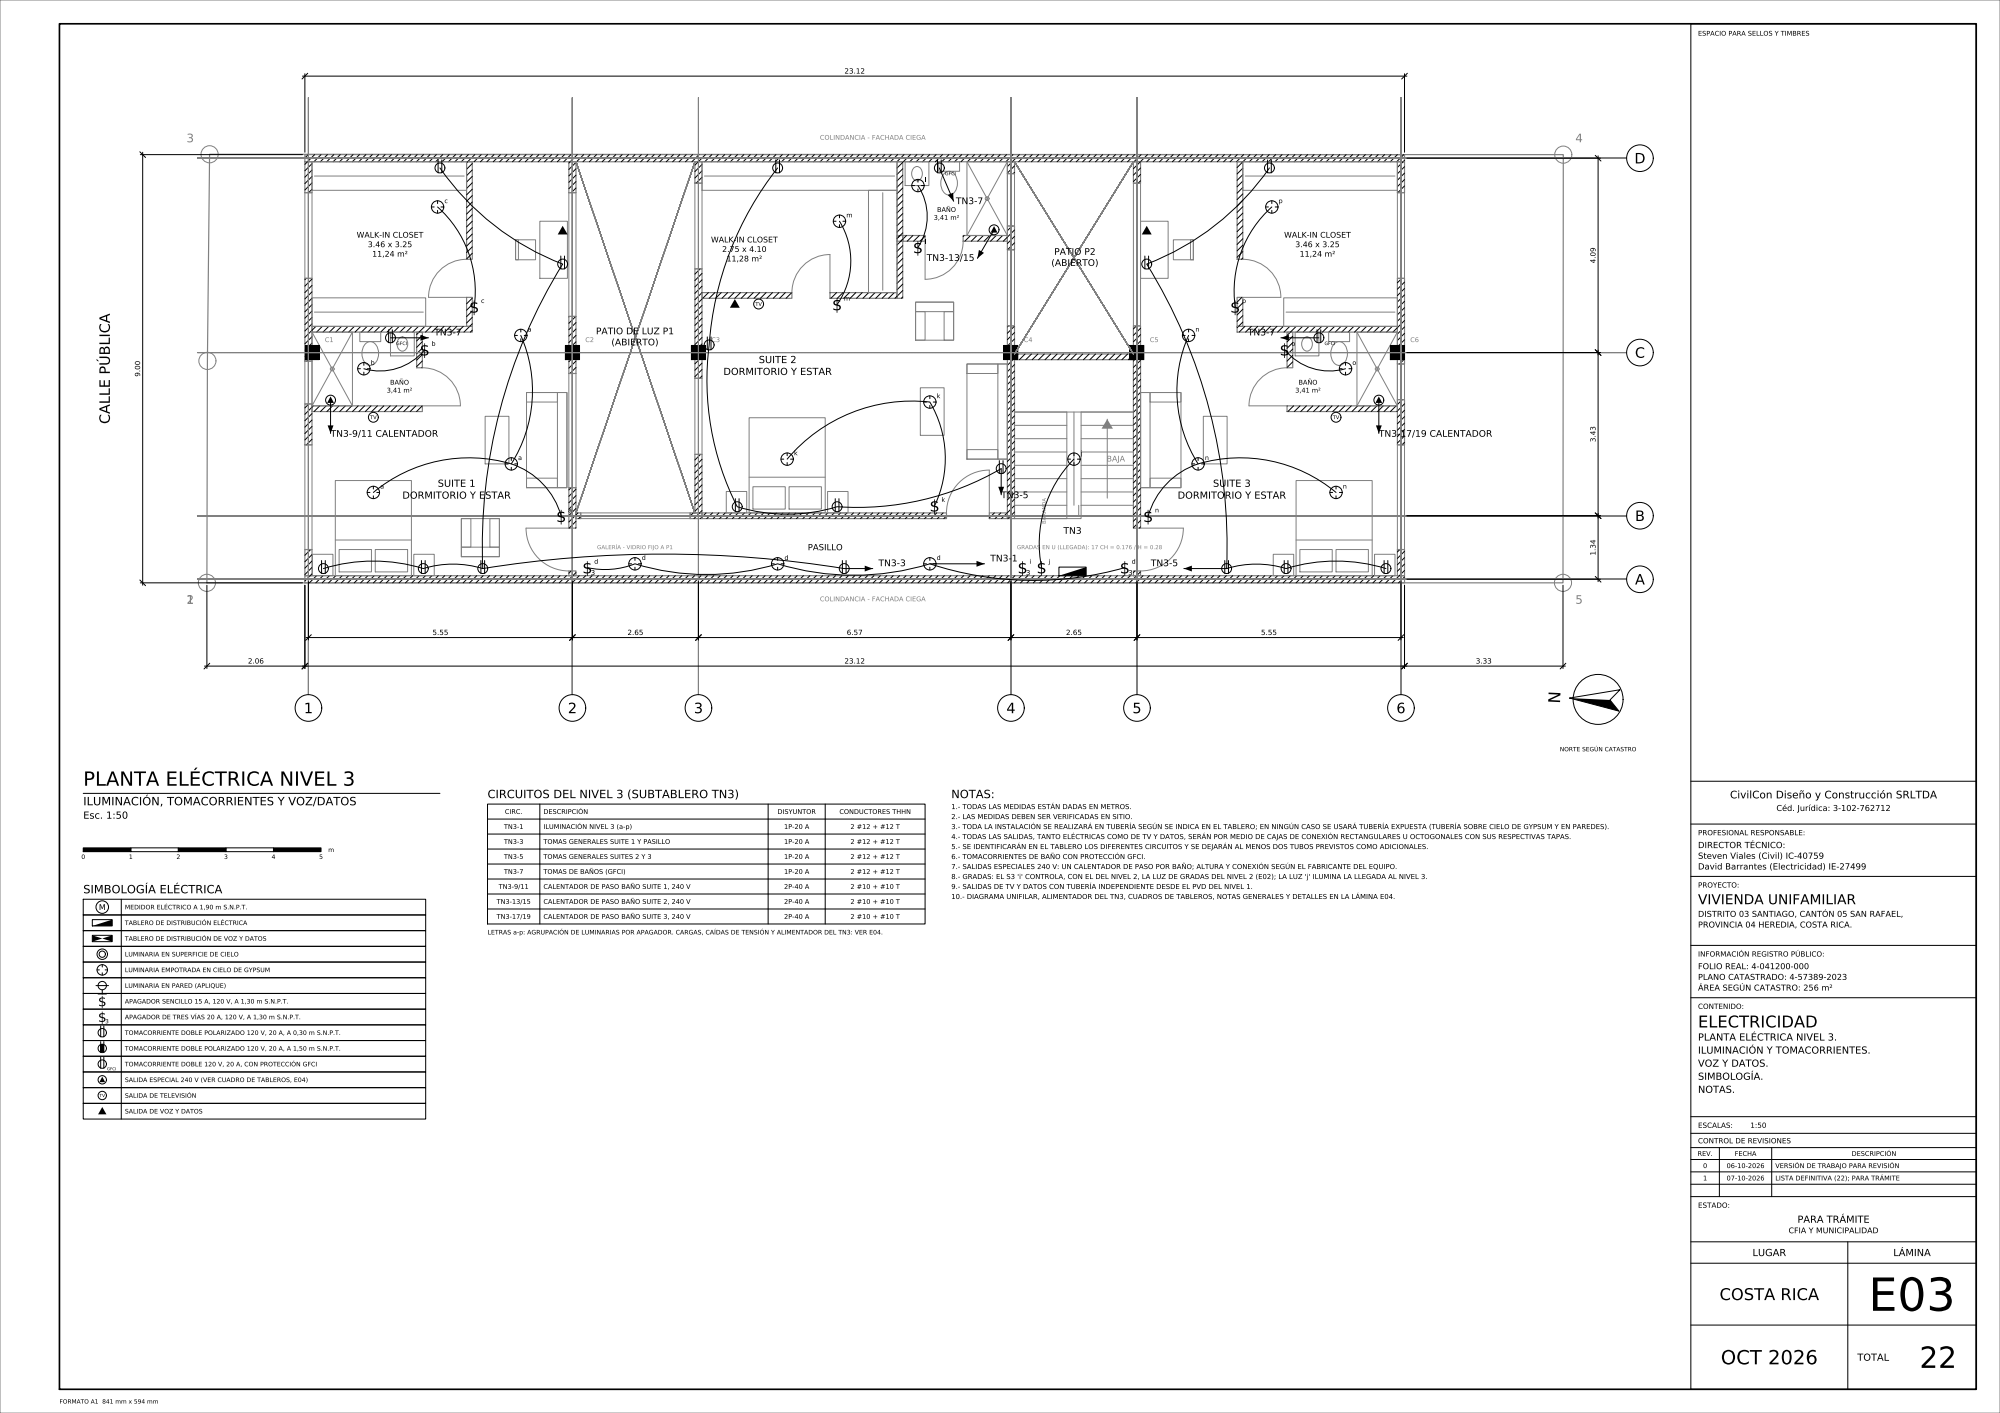
[picture p14: page 3]

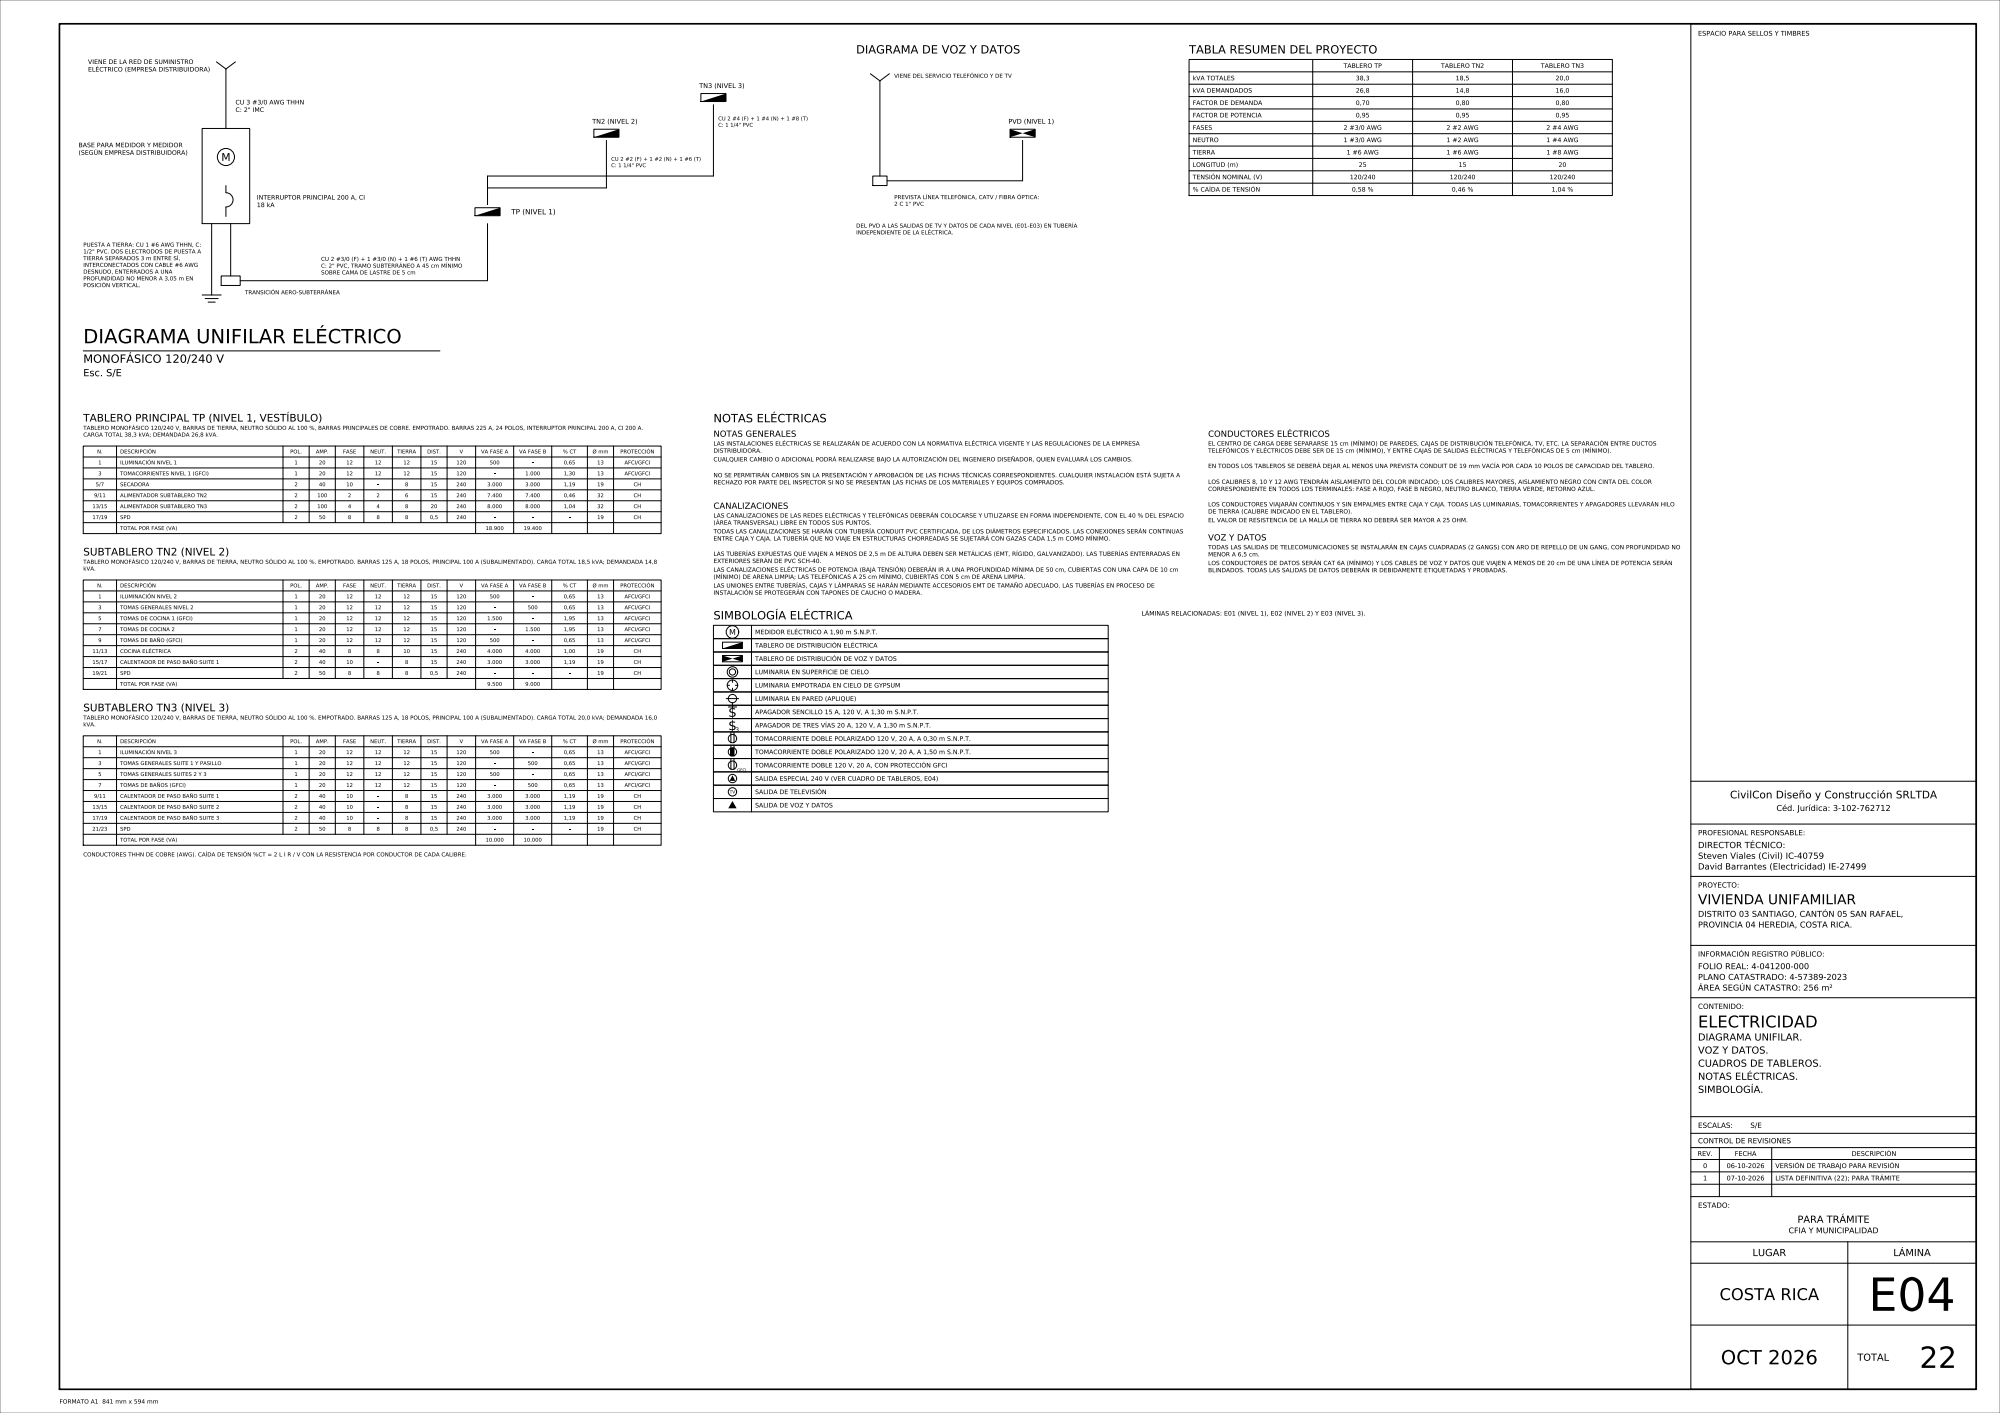
[picture p15: page 4]

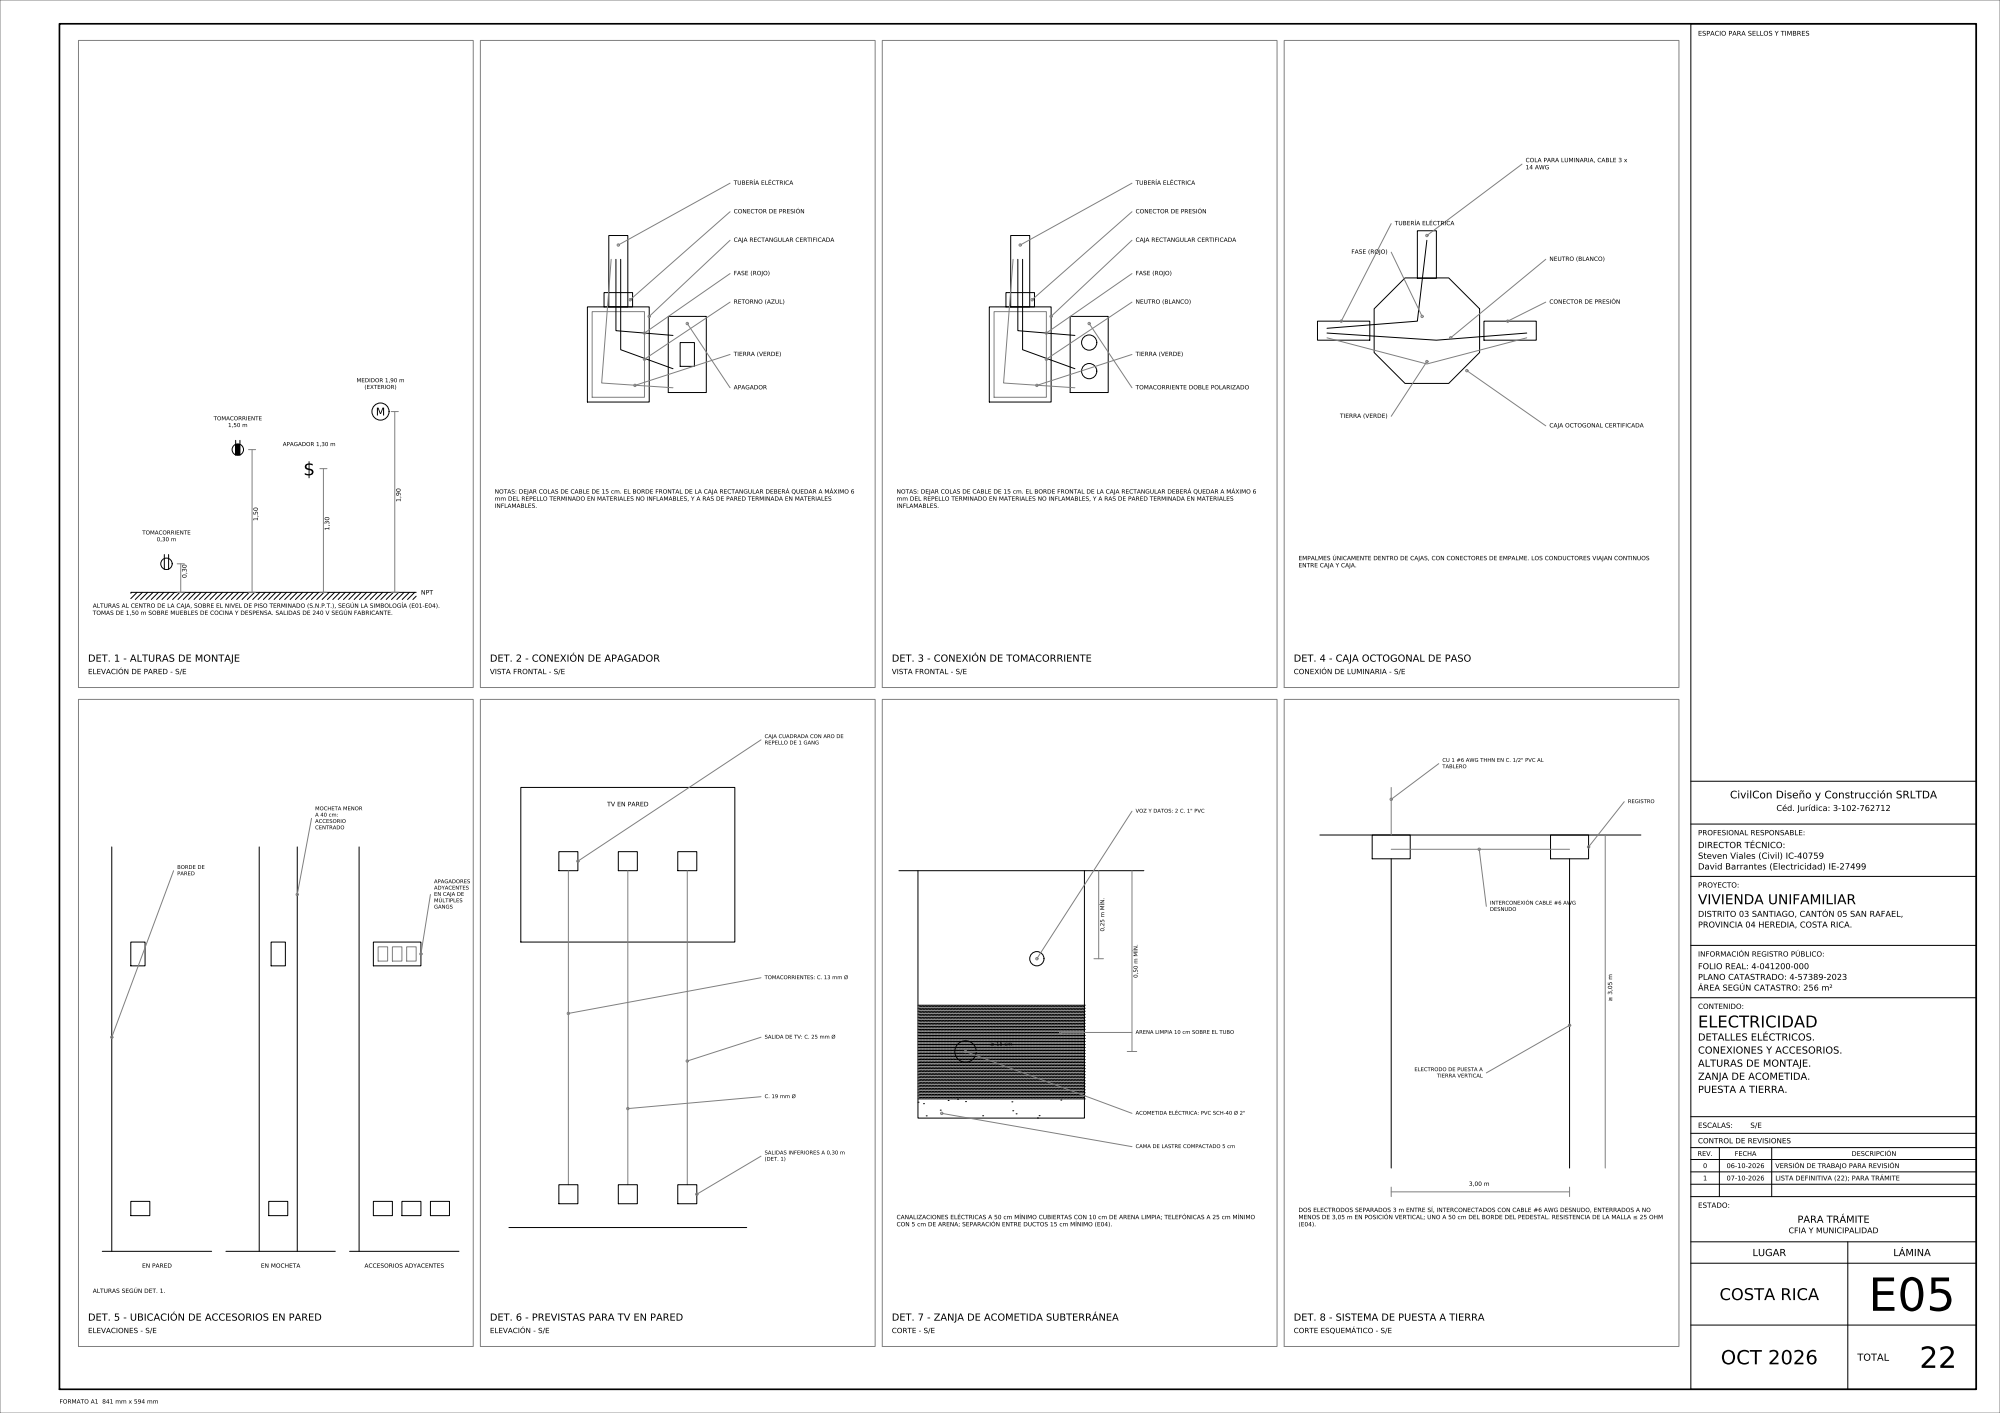
[picture p16: page 5]
