jbarra777/jbarra777/planos/JUEGO_COMPLETO/JUEGO_4_SANITARIAS_S01-S03.pdf

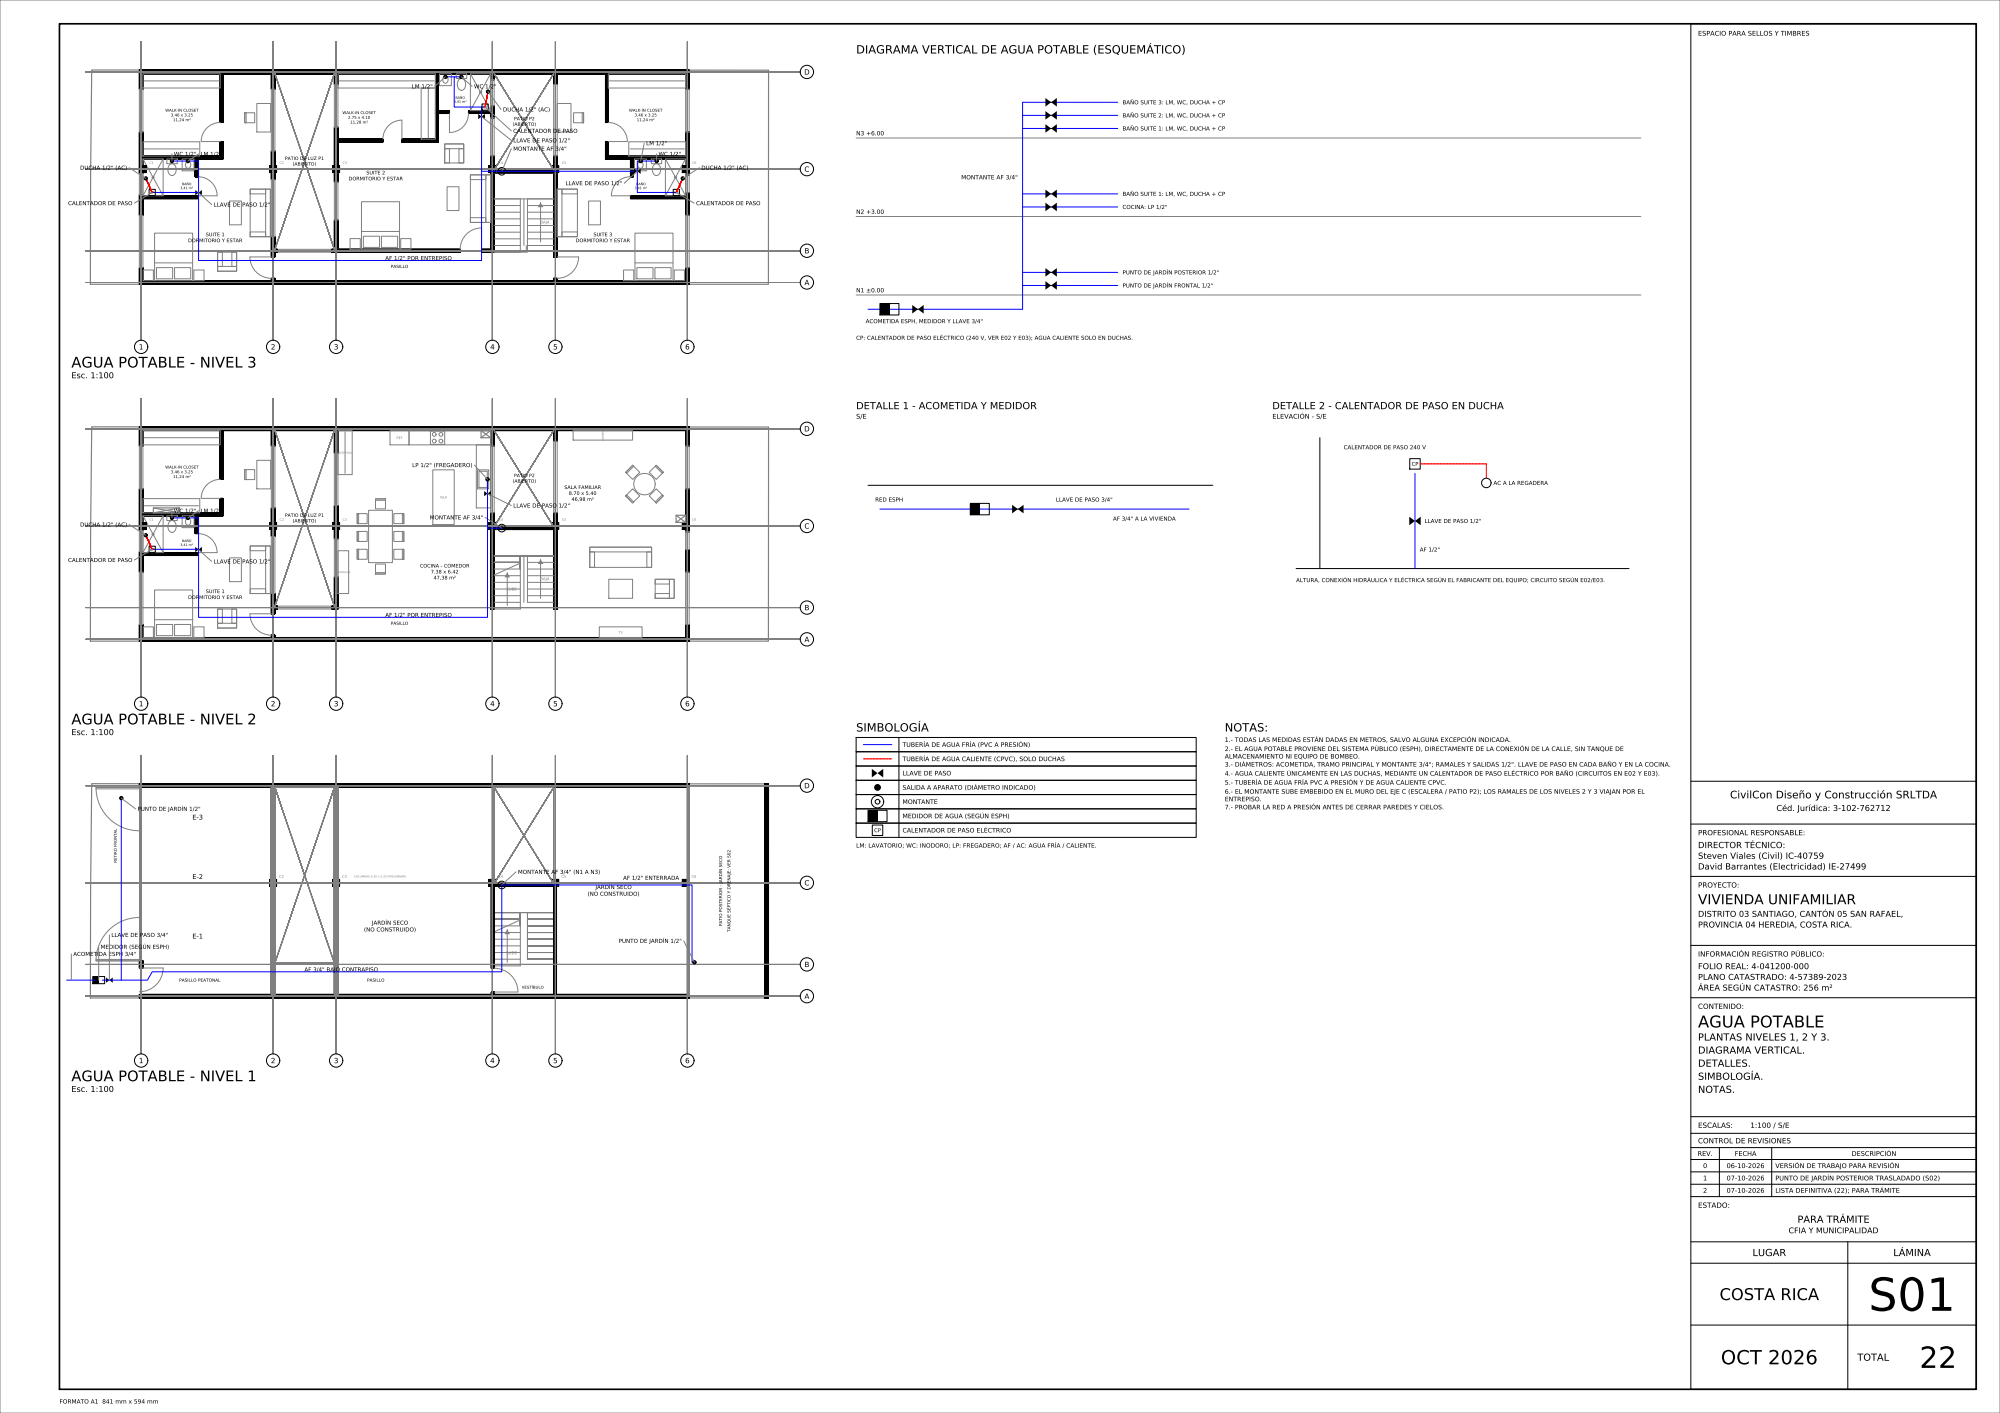
[picture p17: page 1]

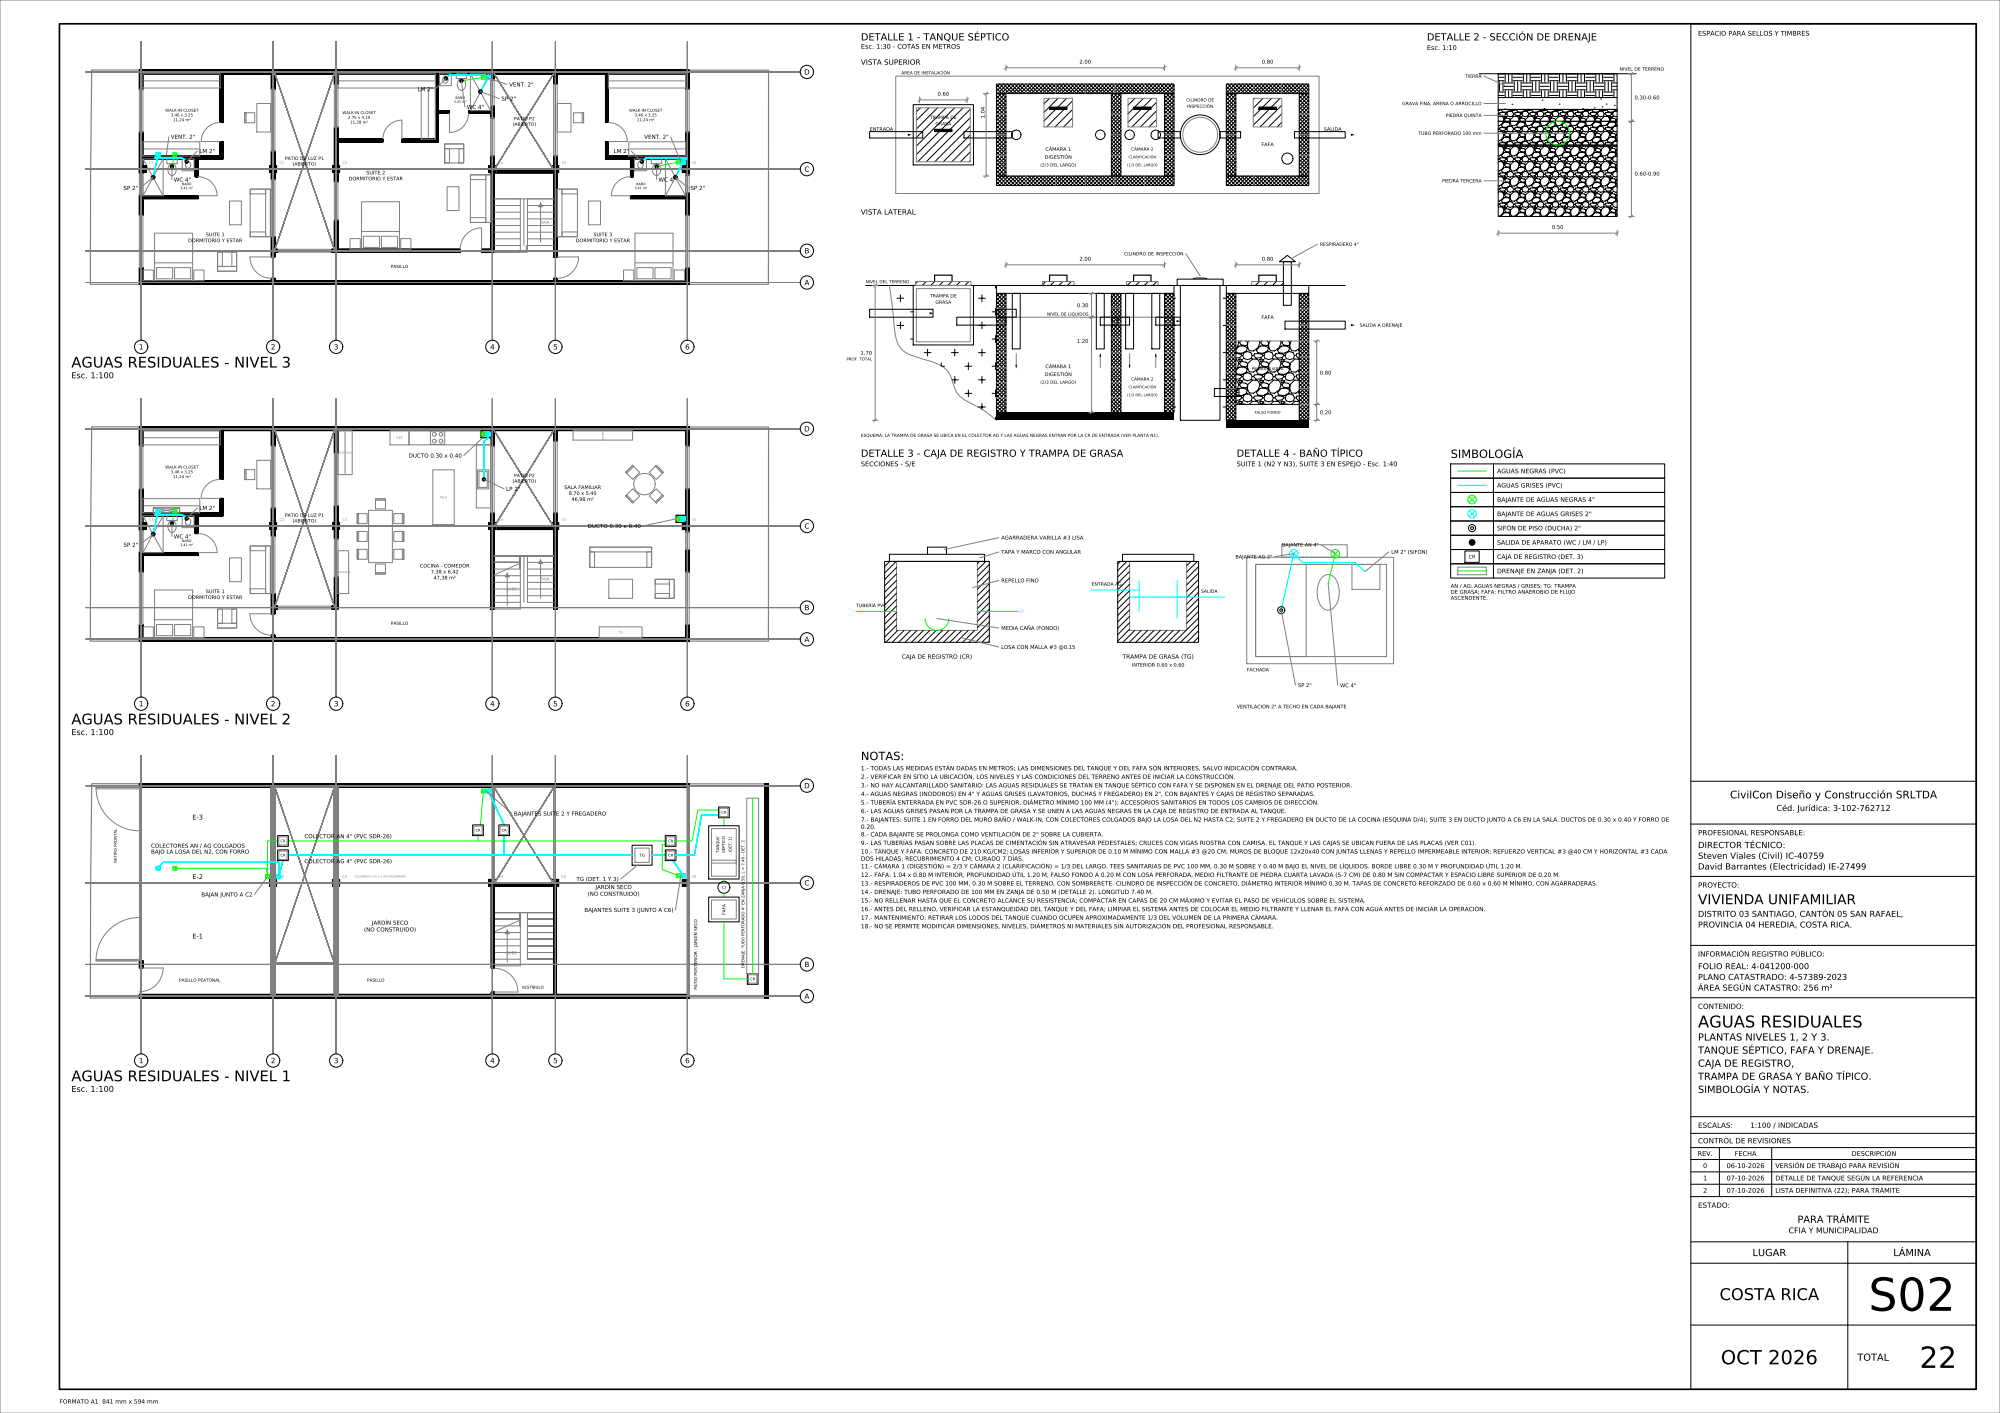
[picture p18: page 2]

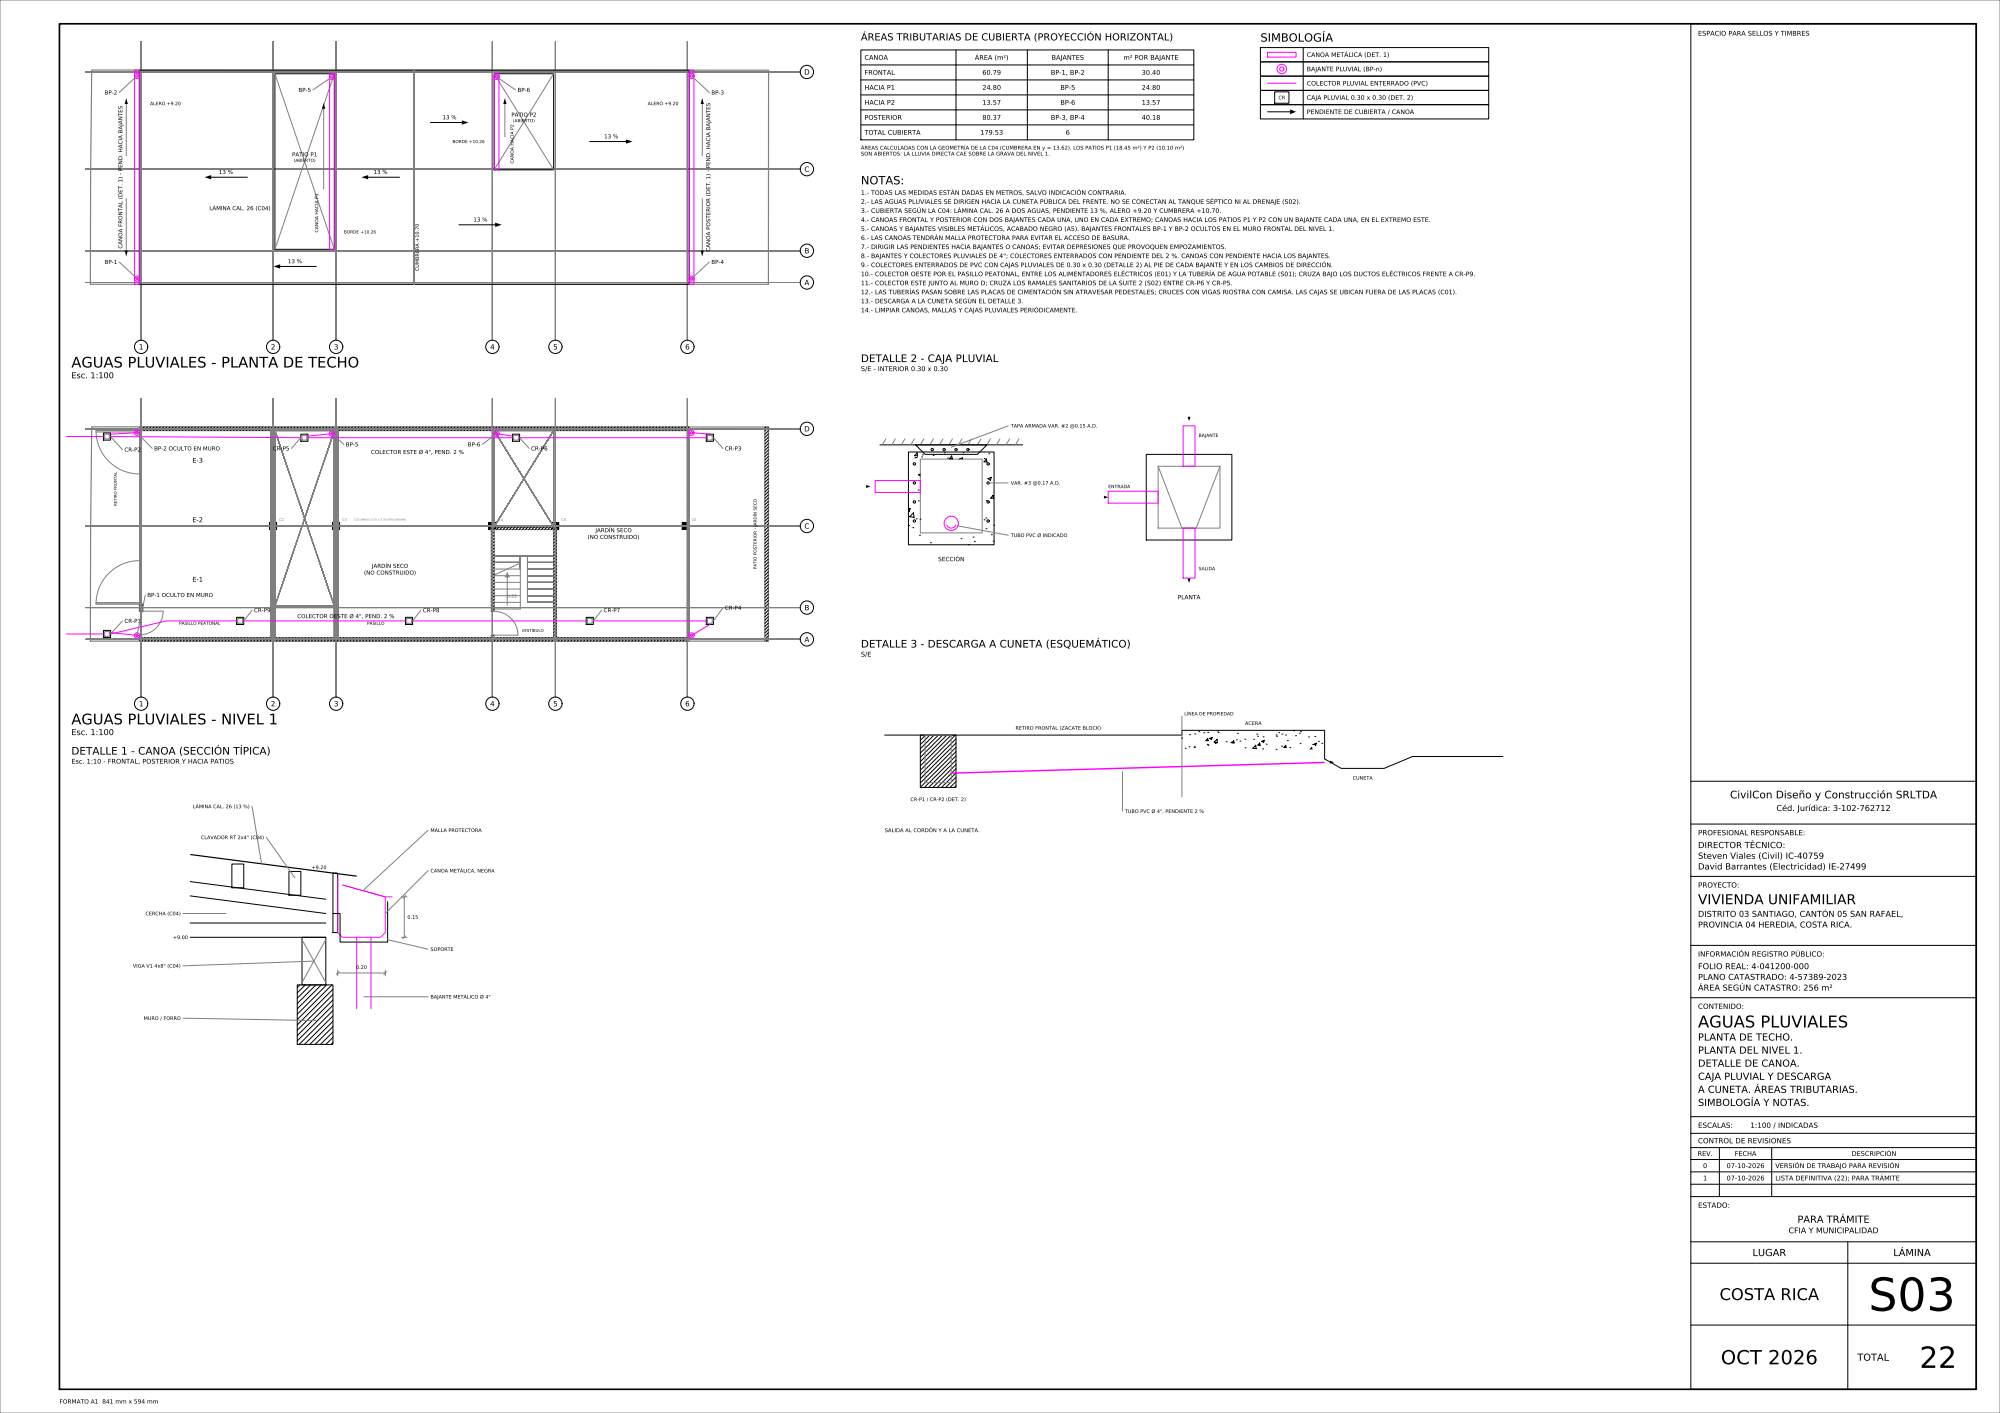
[picture p19: page 3]
