jbarra777/jbarra777/planos/A1_lote/SR-A1_LOTE_rev3.pdf

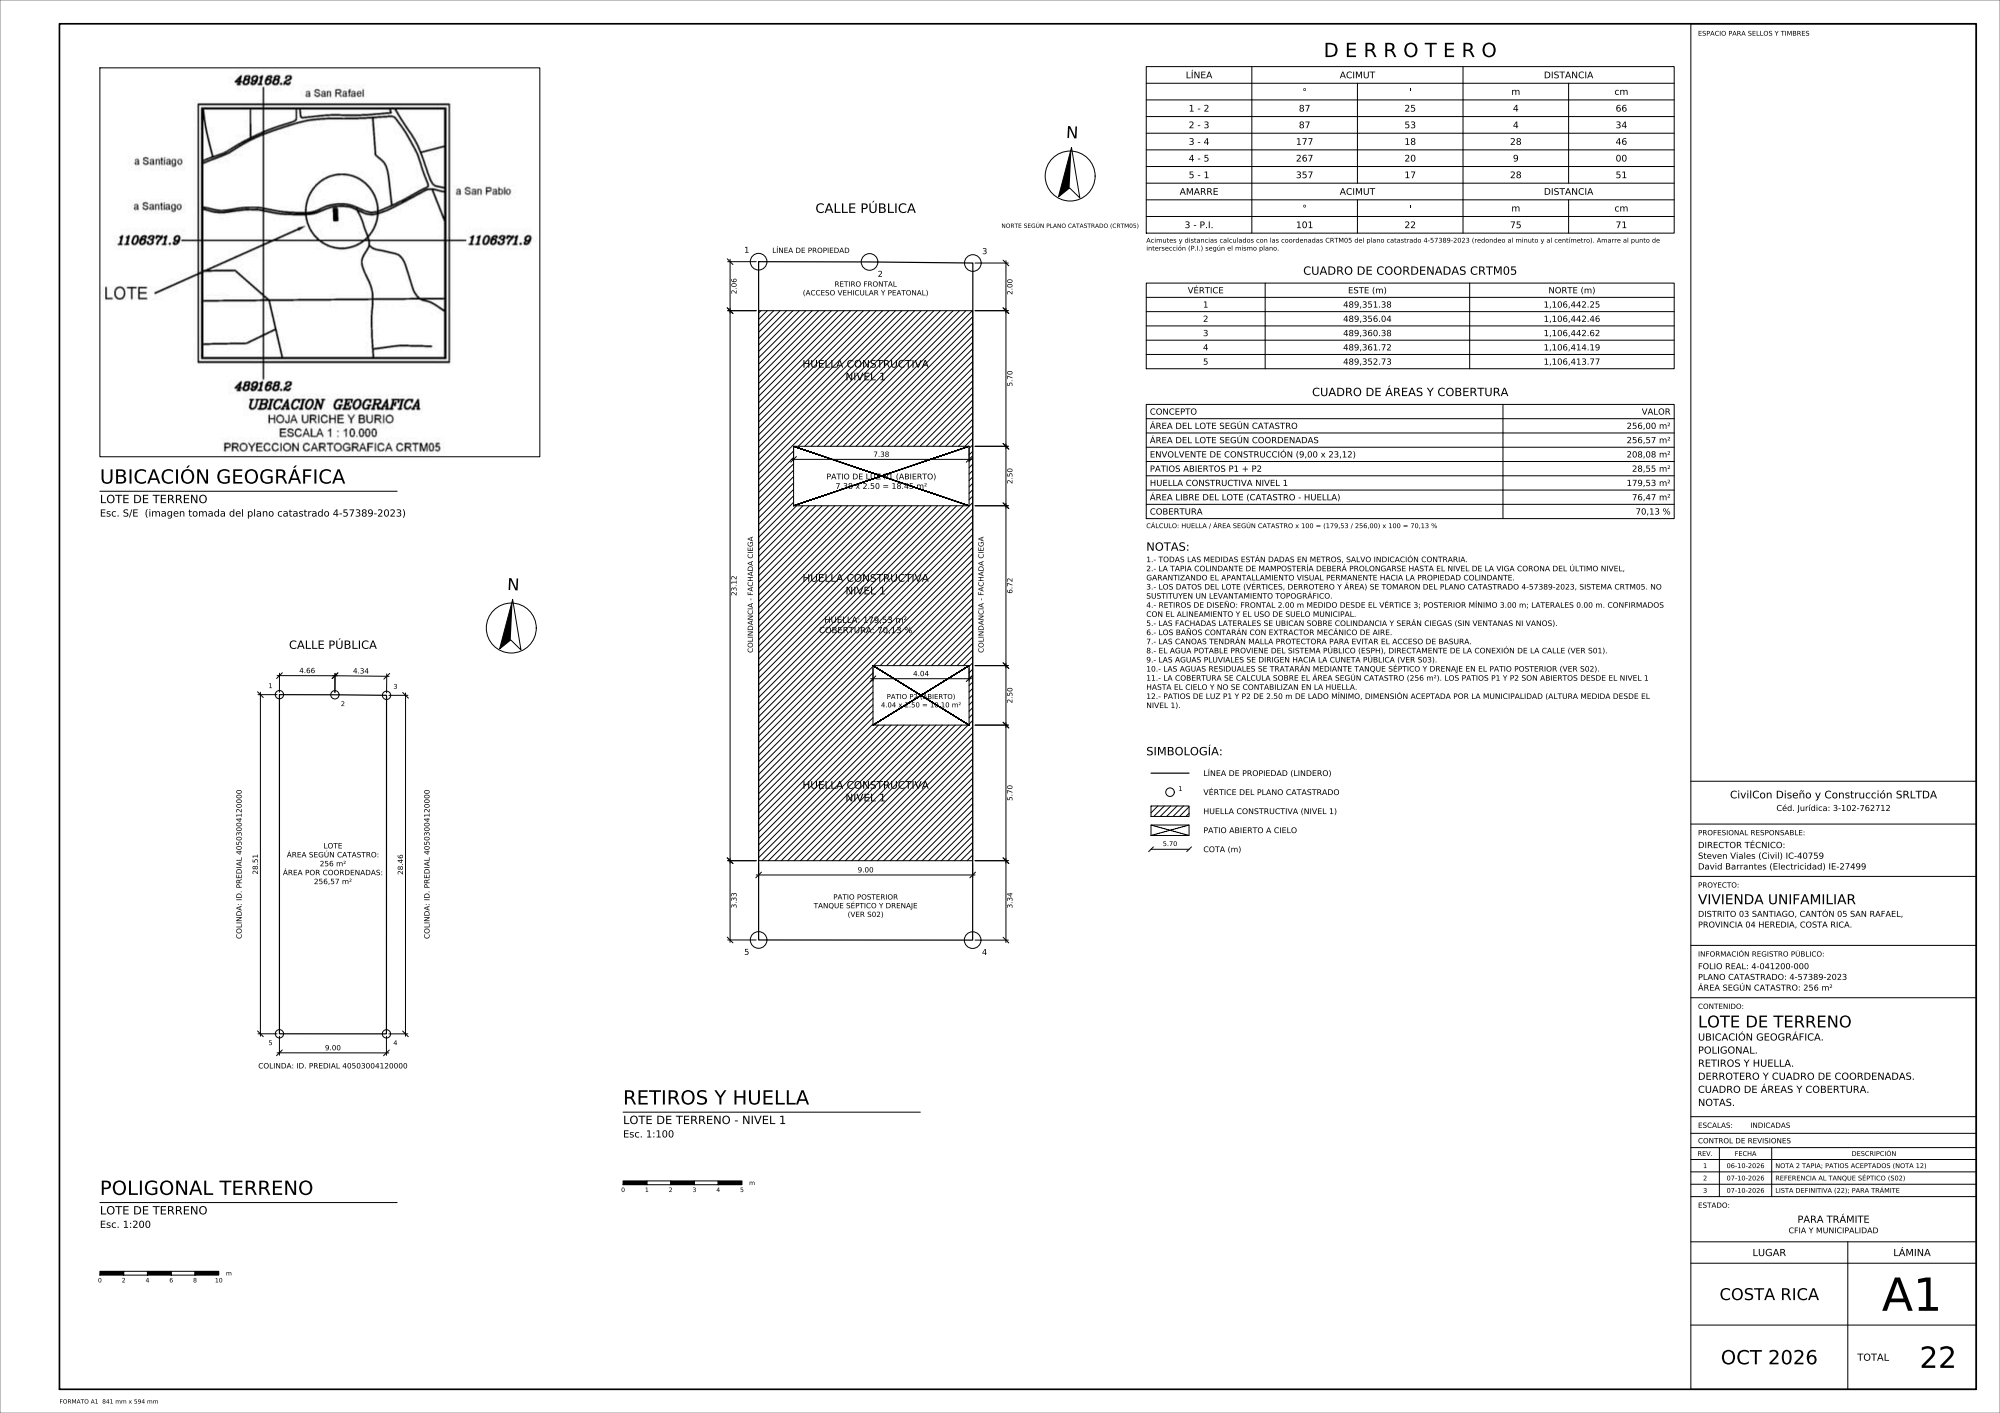
[picture p20: page 1]
