jbarra777/jbarra777/planos/A2_nivel1/SR-A2_NIVEL1_rev5.pdf

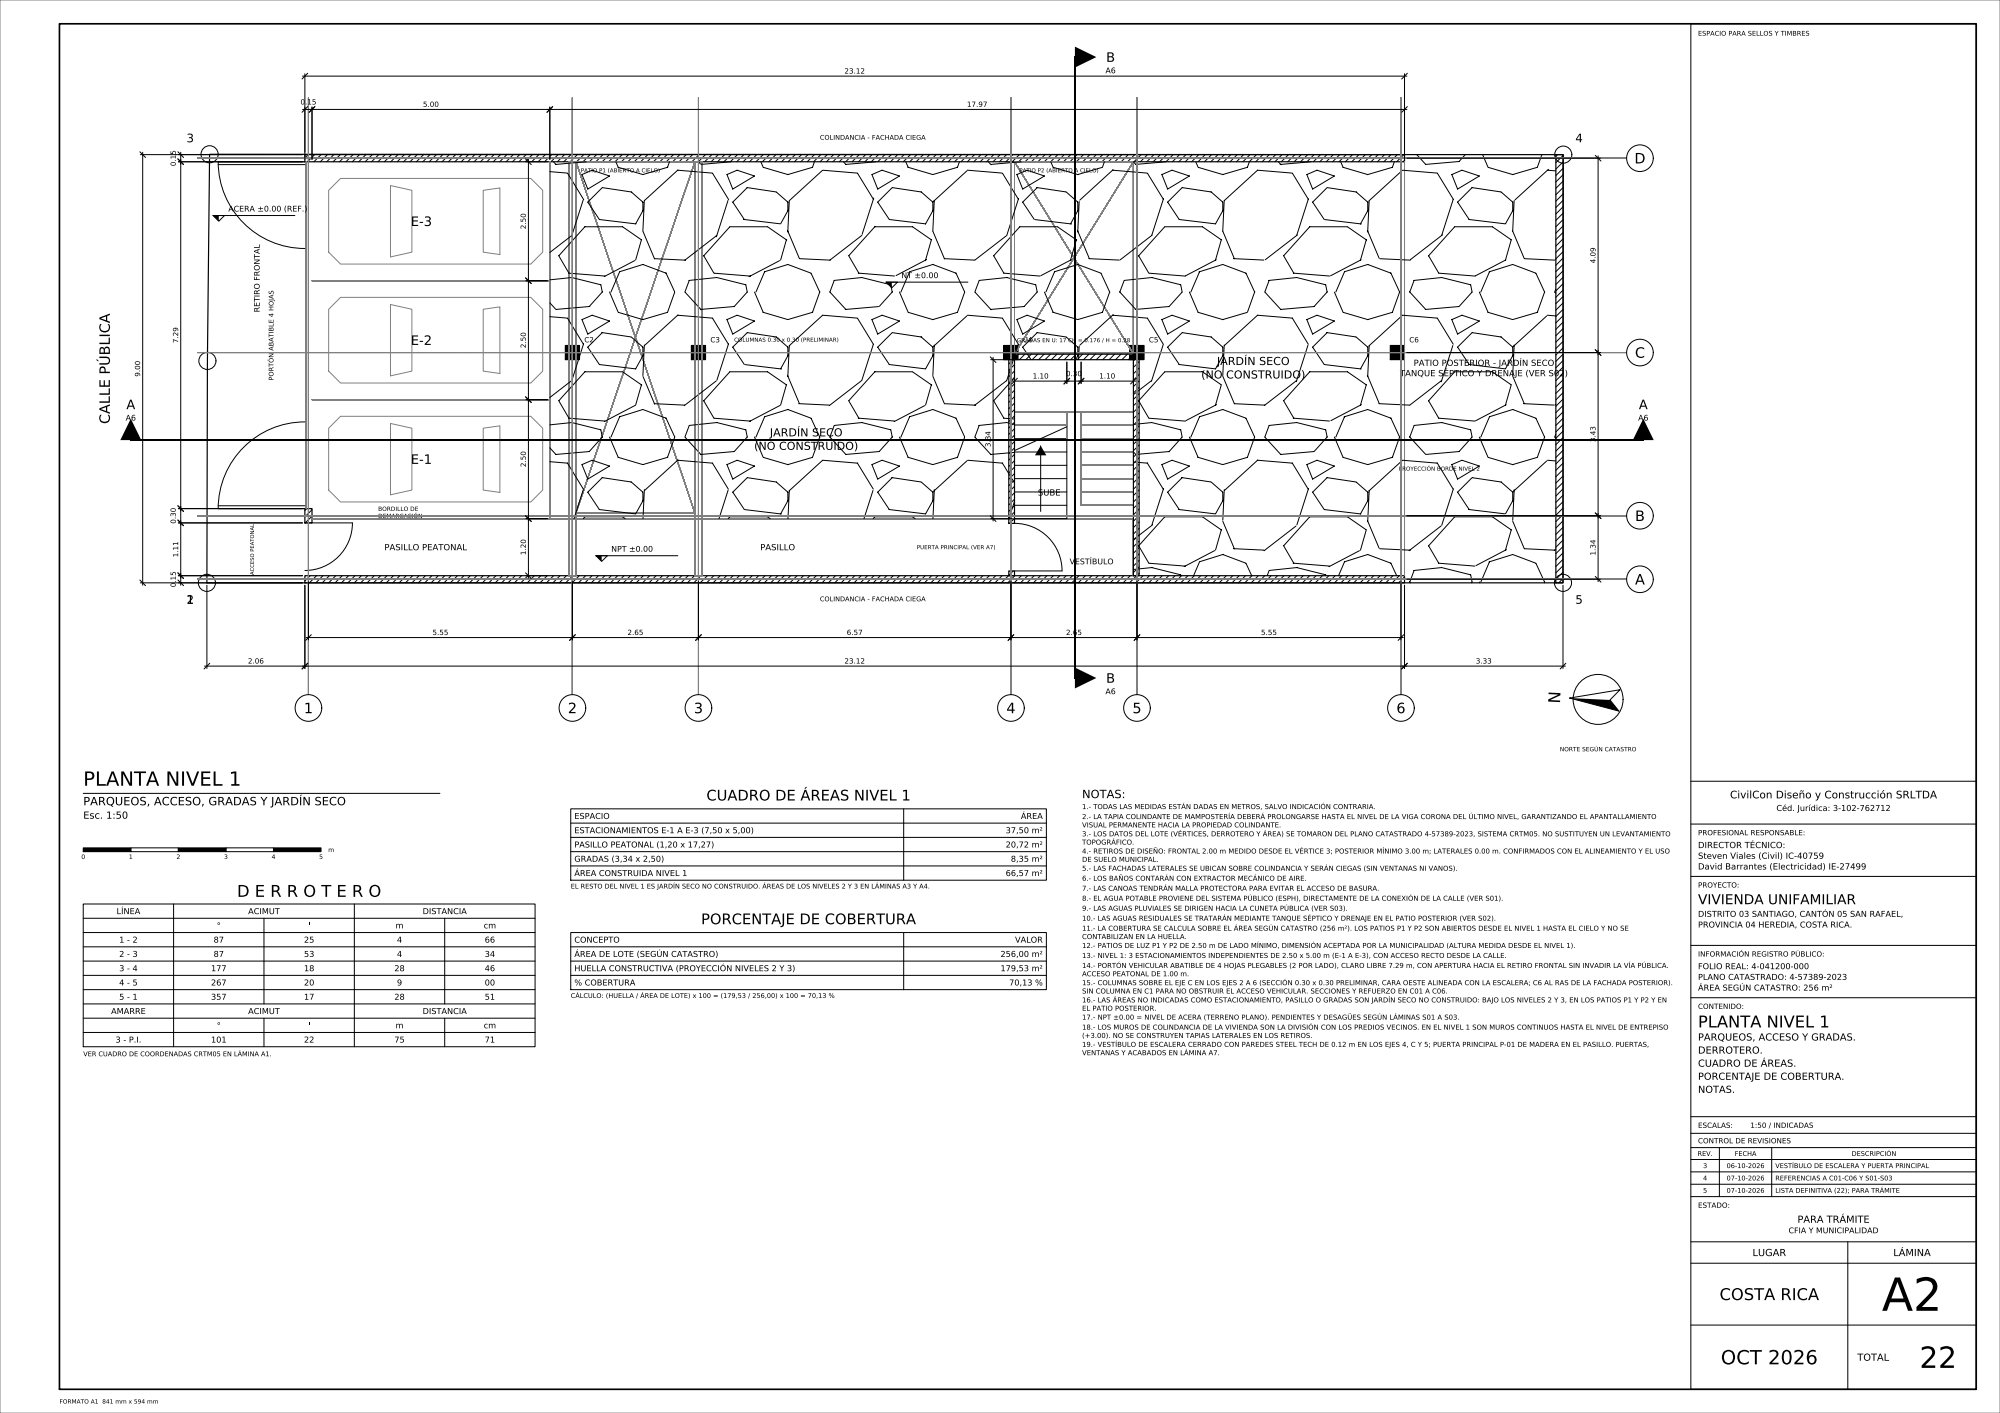
[picture p21: page 1]
