jbarra777/jbarra777/planos/A3_nivel2/SR-A3_NIVEL2_rev6.pdf

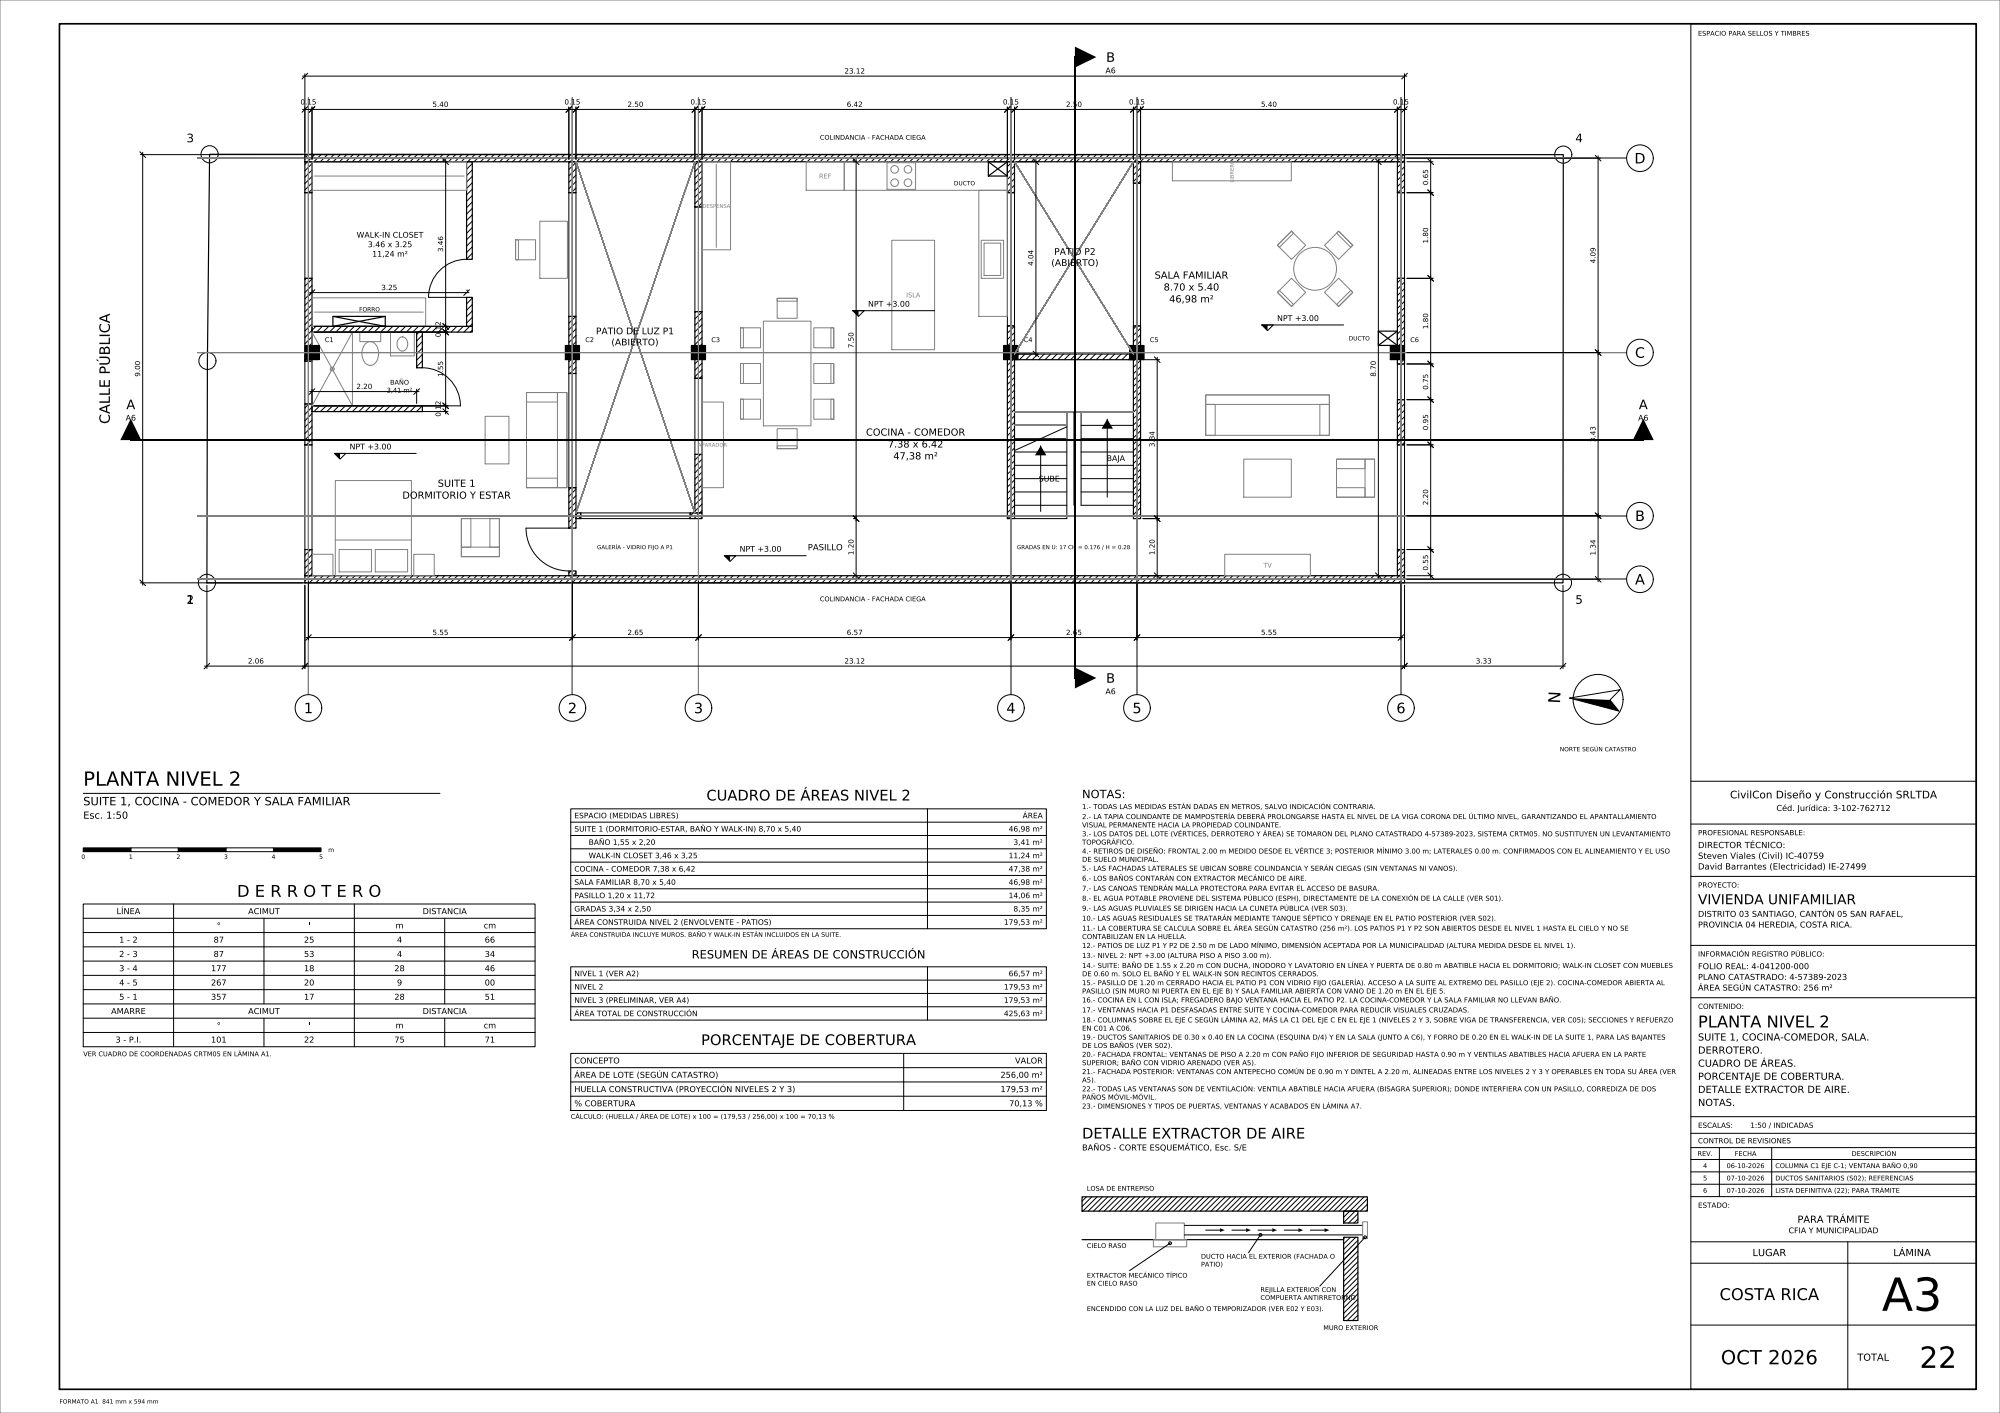
[picture p22: page 1]
