jbarra777/jbarra777/planos/A4_nivel3/SR-A4_NIVEL3_rev6.pdf

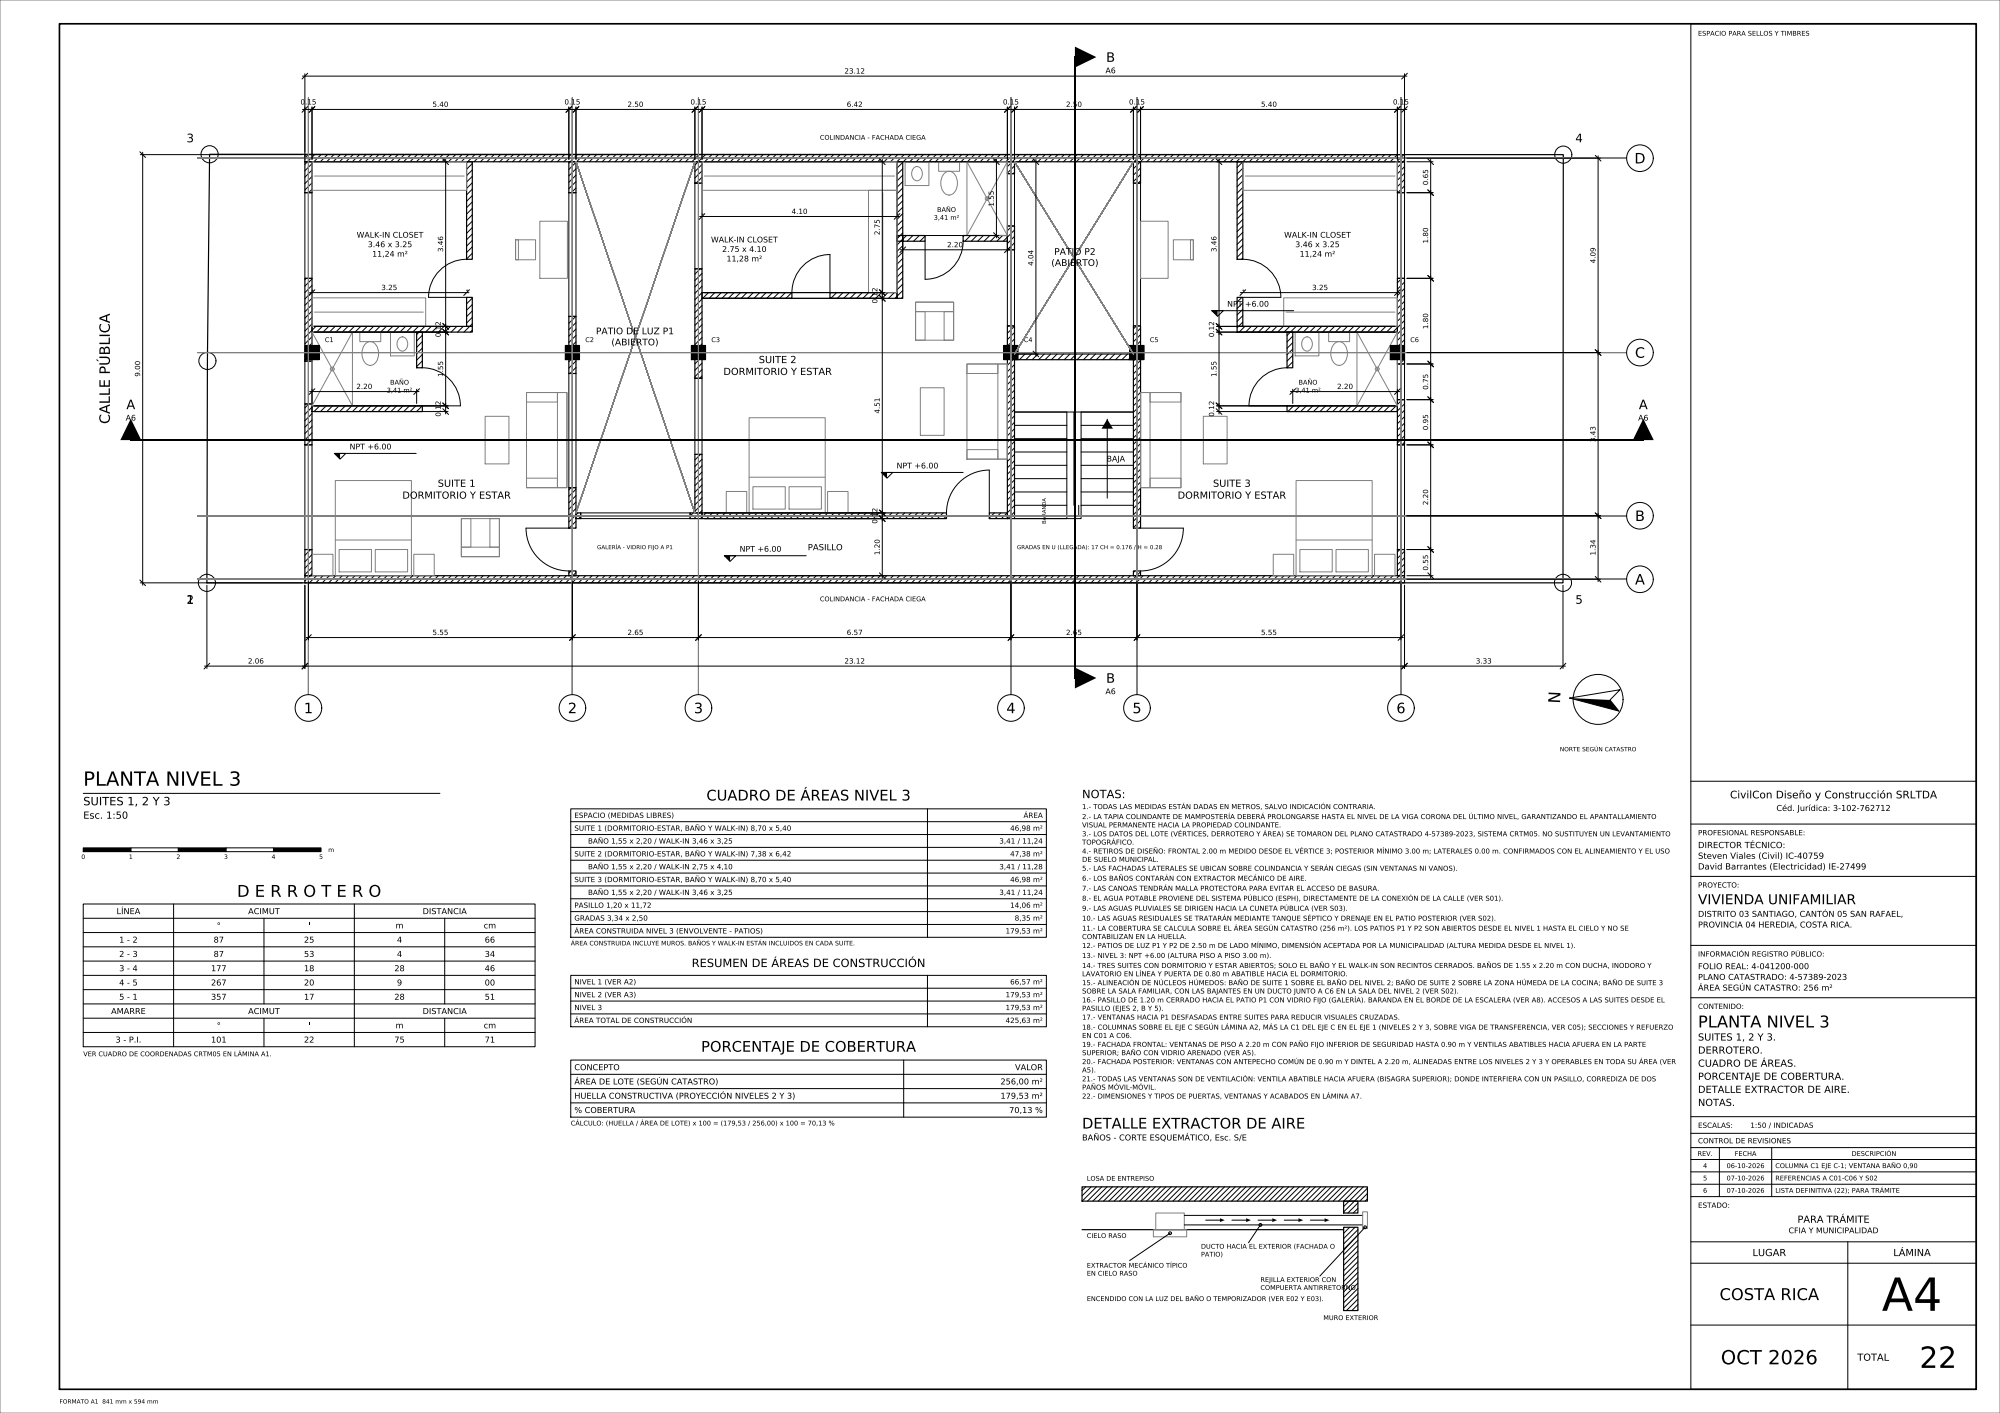
[picture p23: page 1]
