jbarra777/jbarra777/planos/A5_fachadas/SR-A5_FACHADAS_rev8.pdf

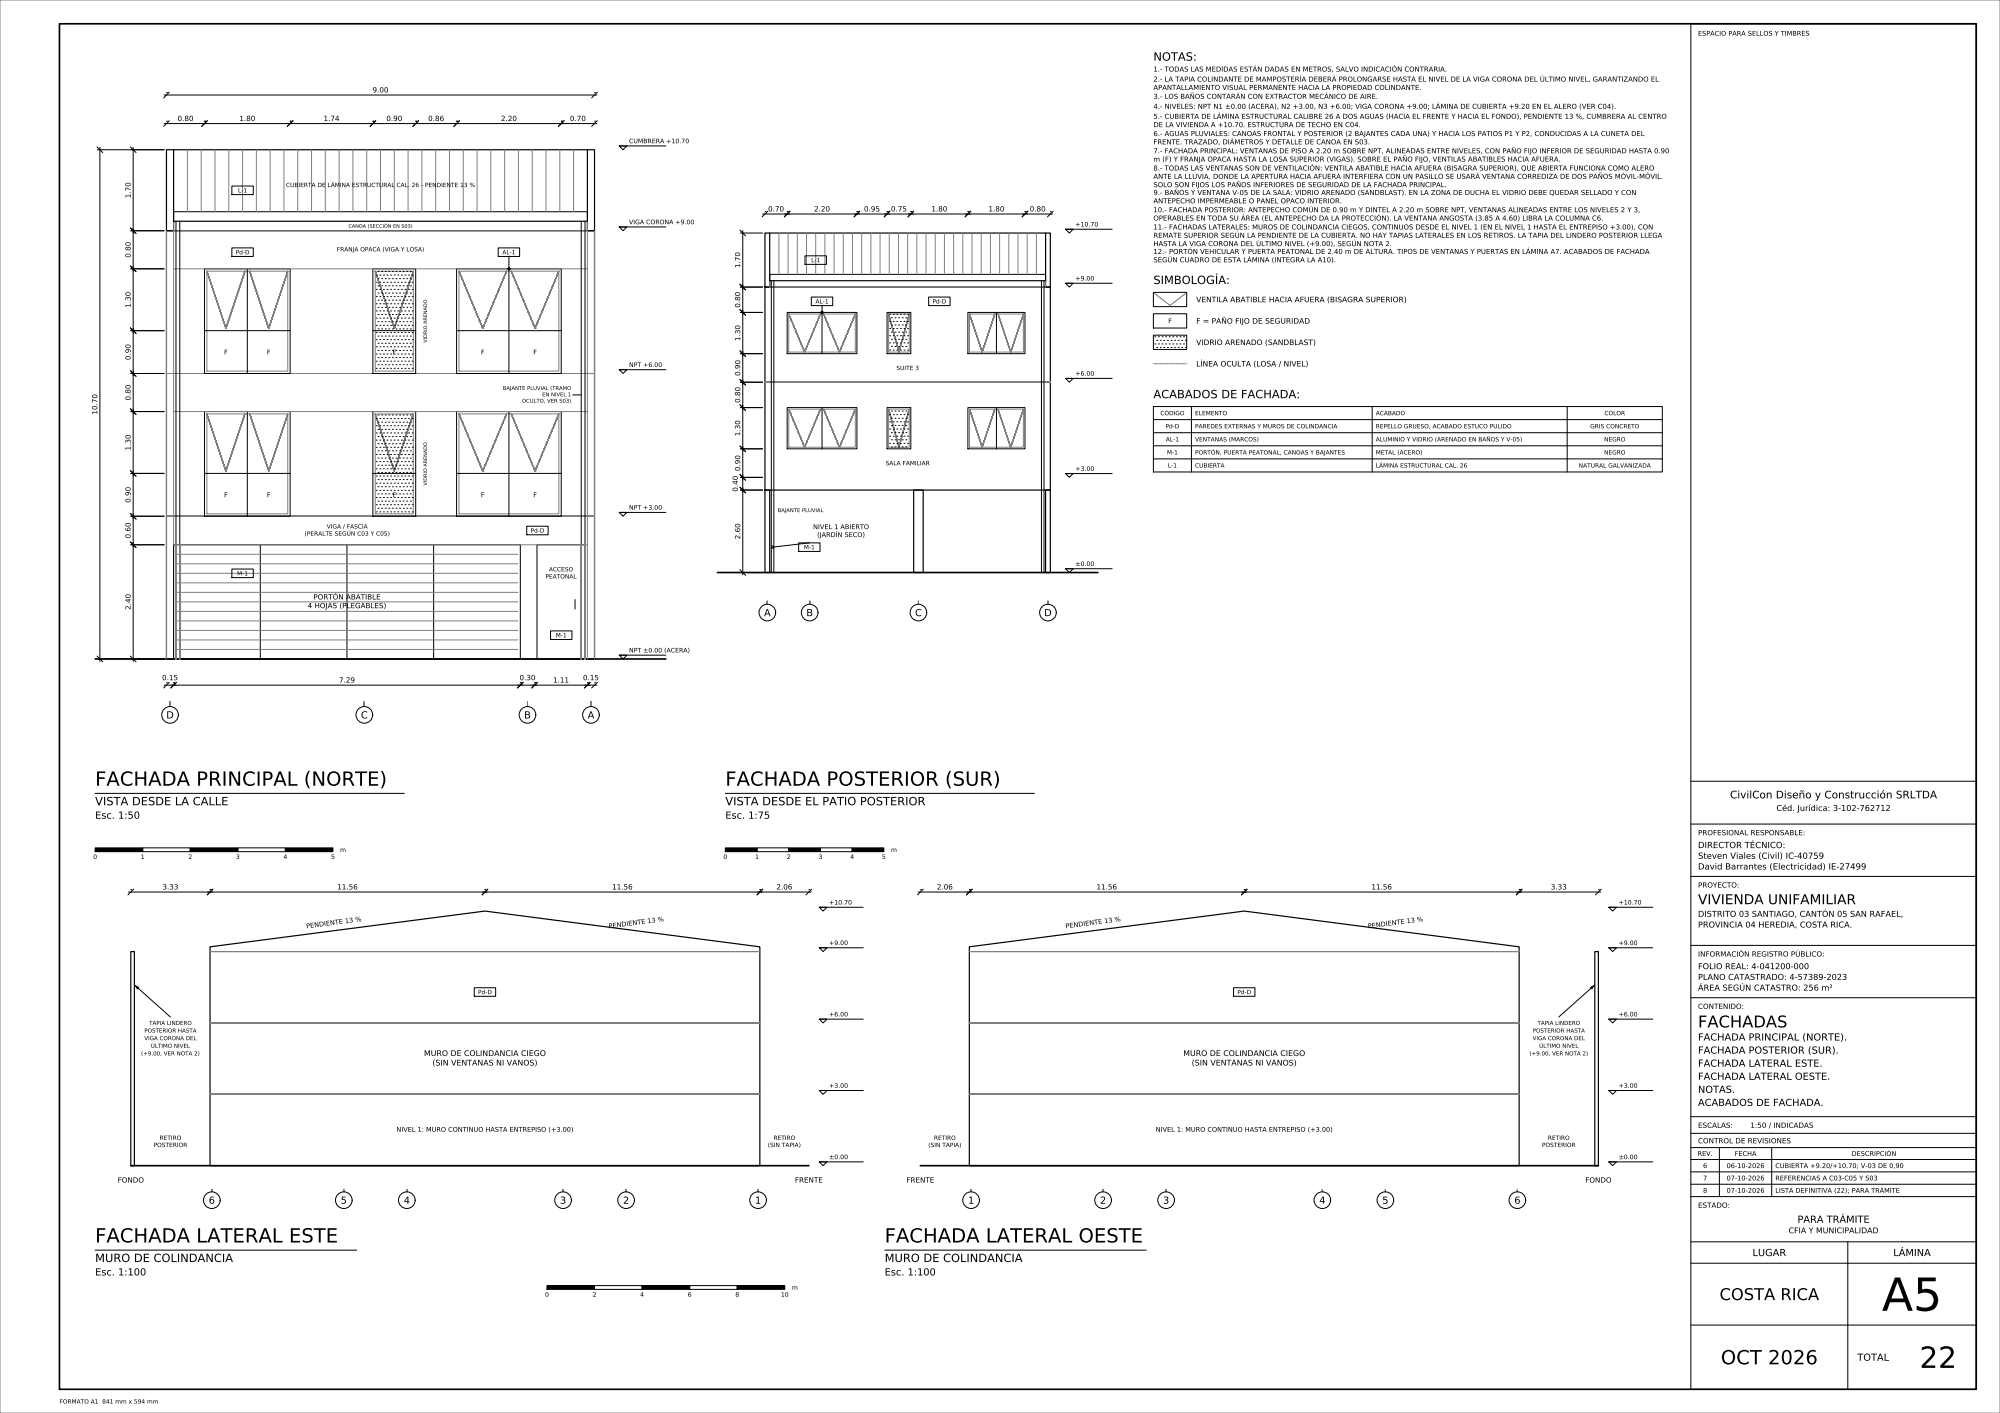
[picture p24: page 1]
