jbarra777/jbarra777/planos/A6_cortes/SR-A6_CORTES_rev6.pdf

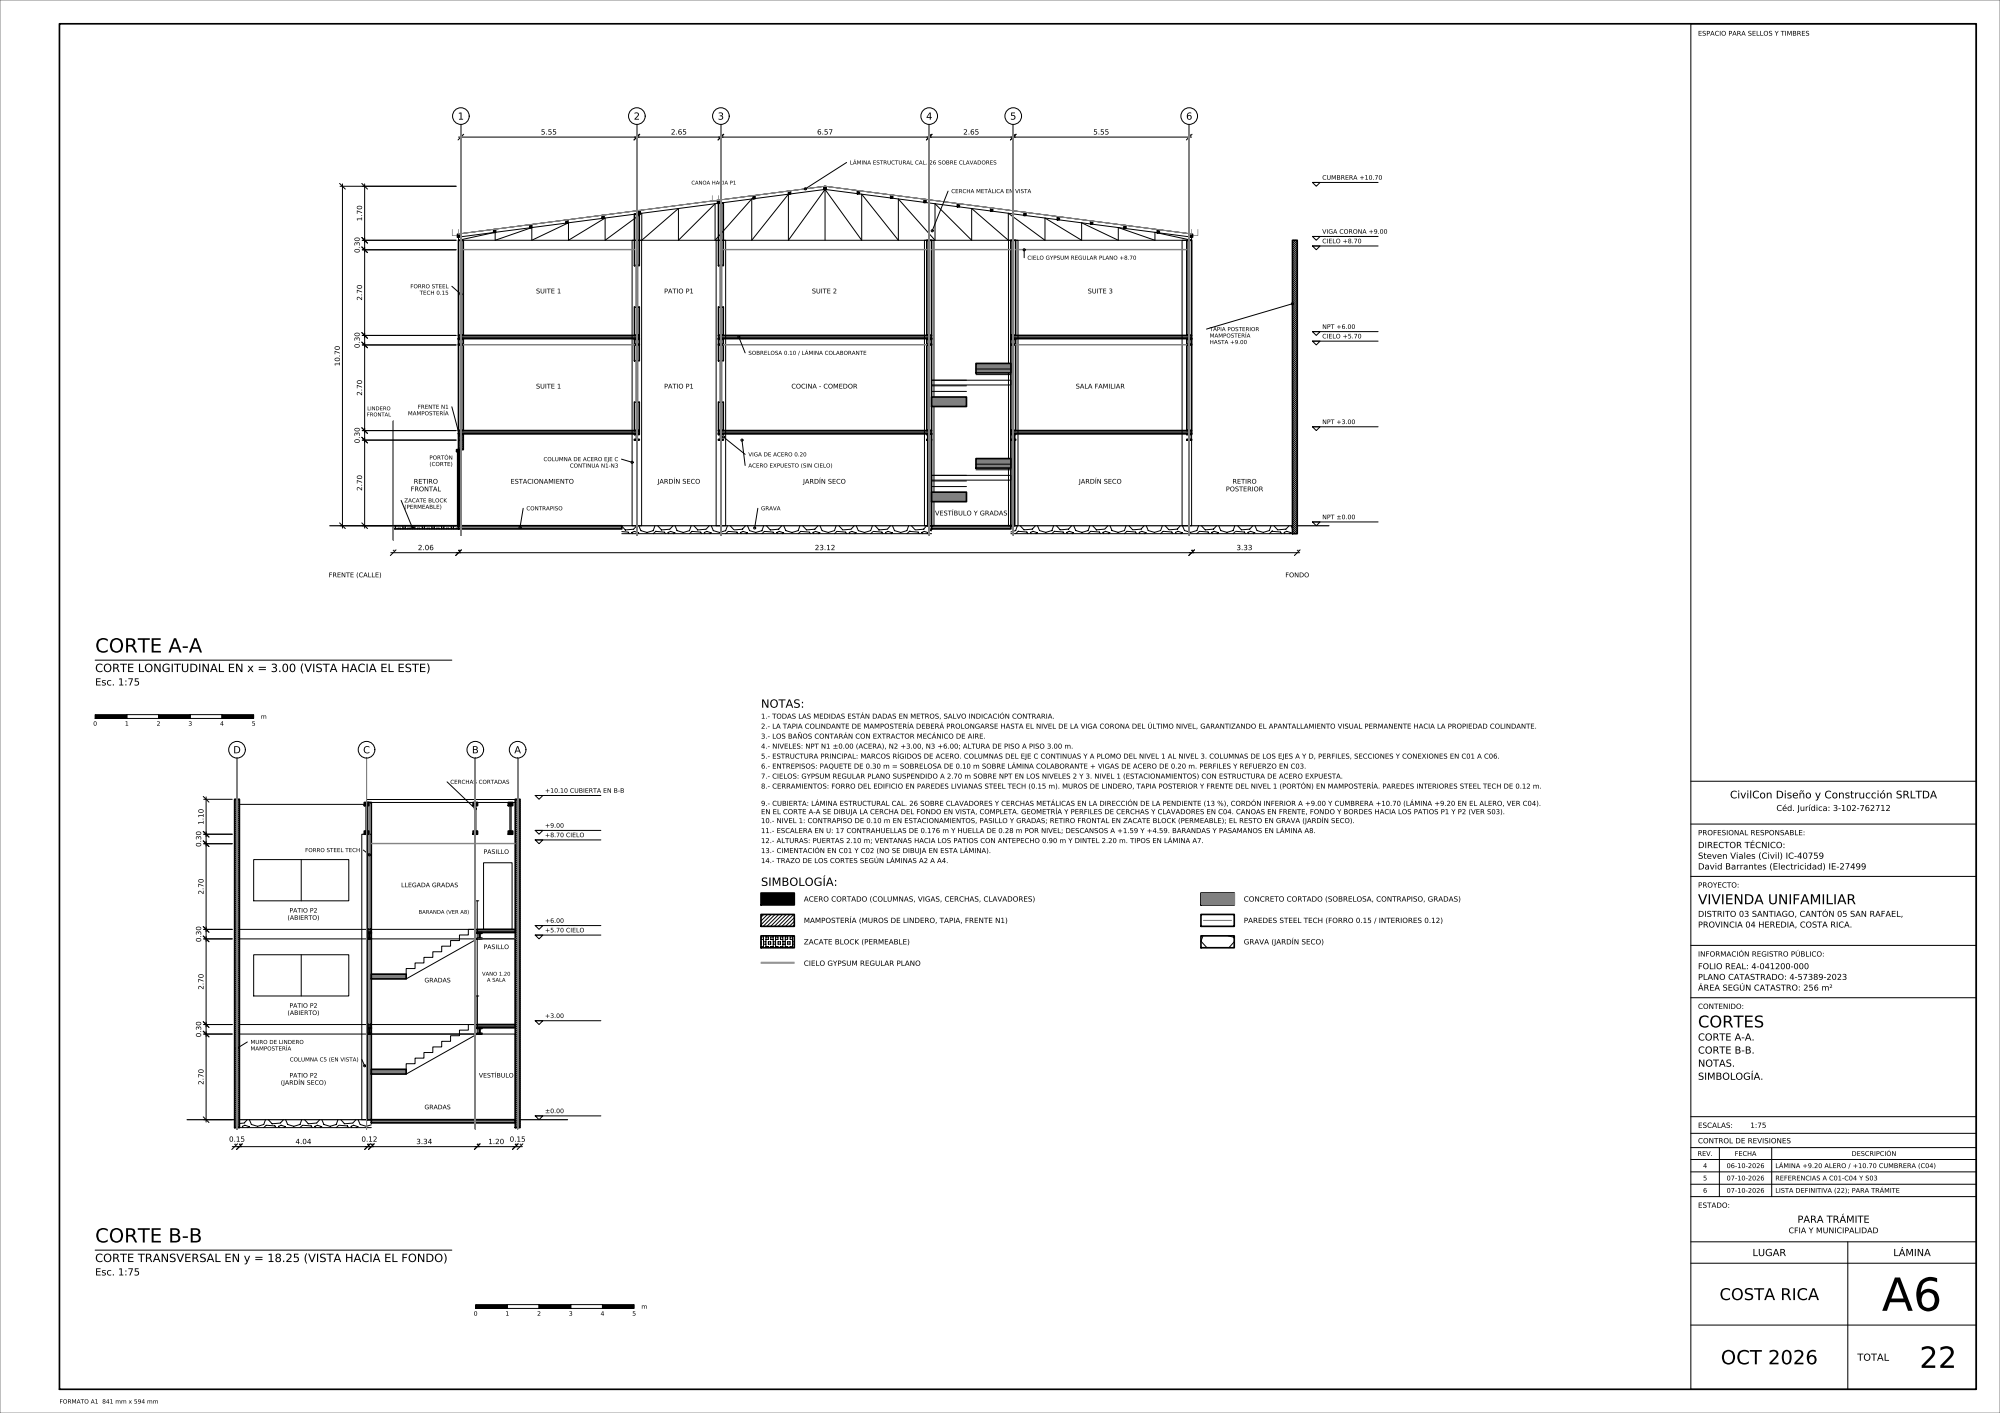
[picture p25: page 1]
