jbarra777/jbarra777/planos/A7_puertas_ventanas/SR-A7_PUERTAS_VENTANAS_rev4.pdf

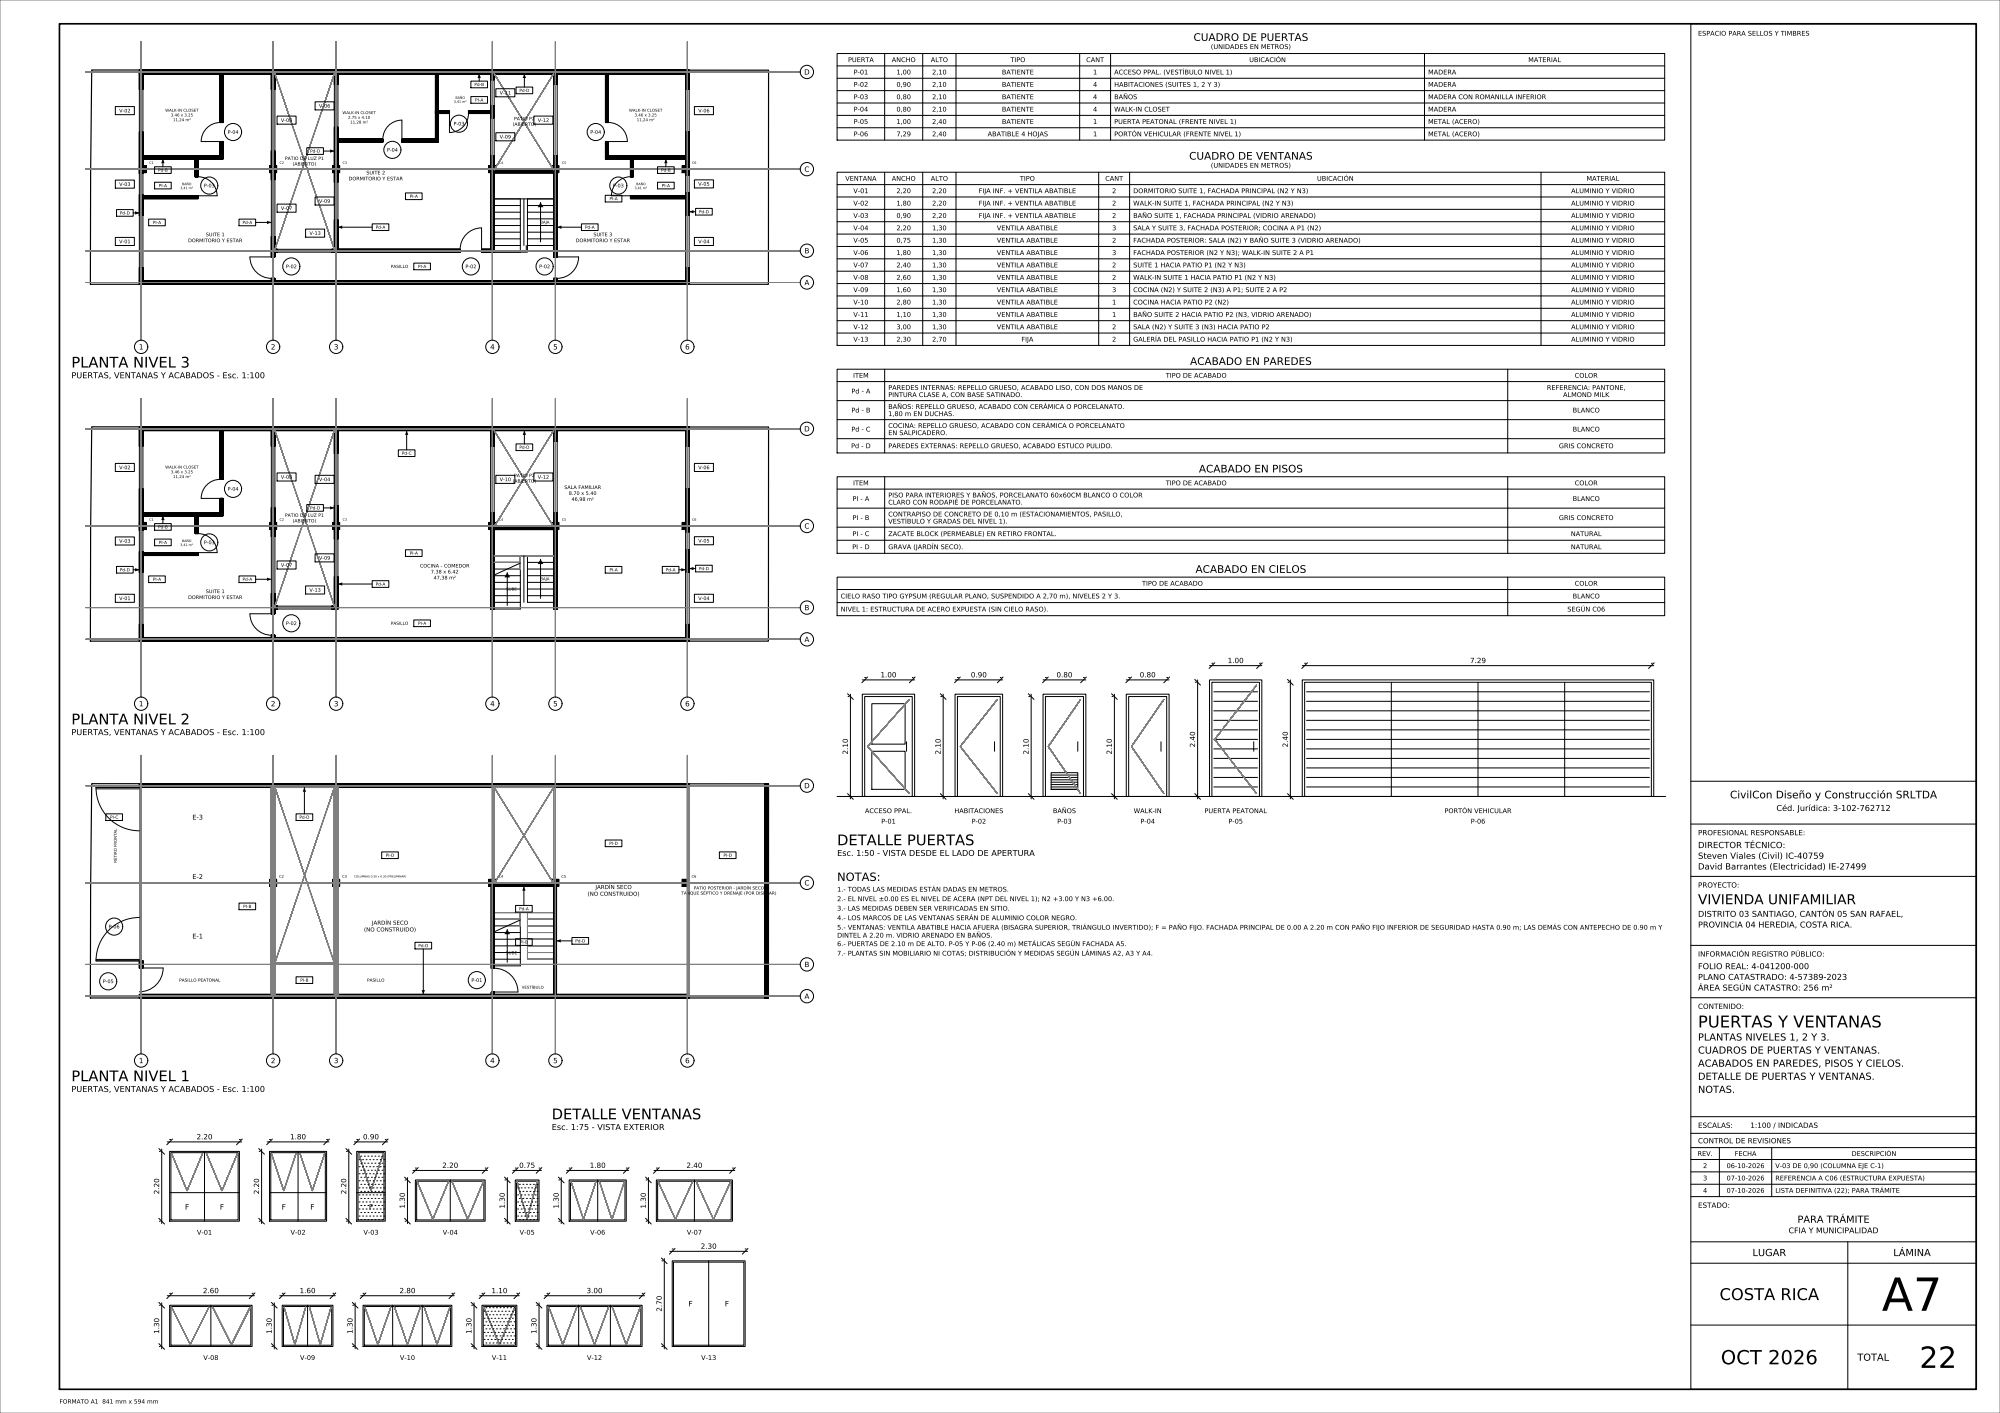
[picture p26: page 1]
