jbarra777/jbarra777/planos/A8_escalera/SR-A8_ESCALERA_rev2.pdf

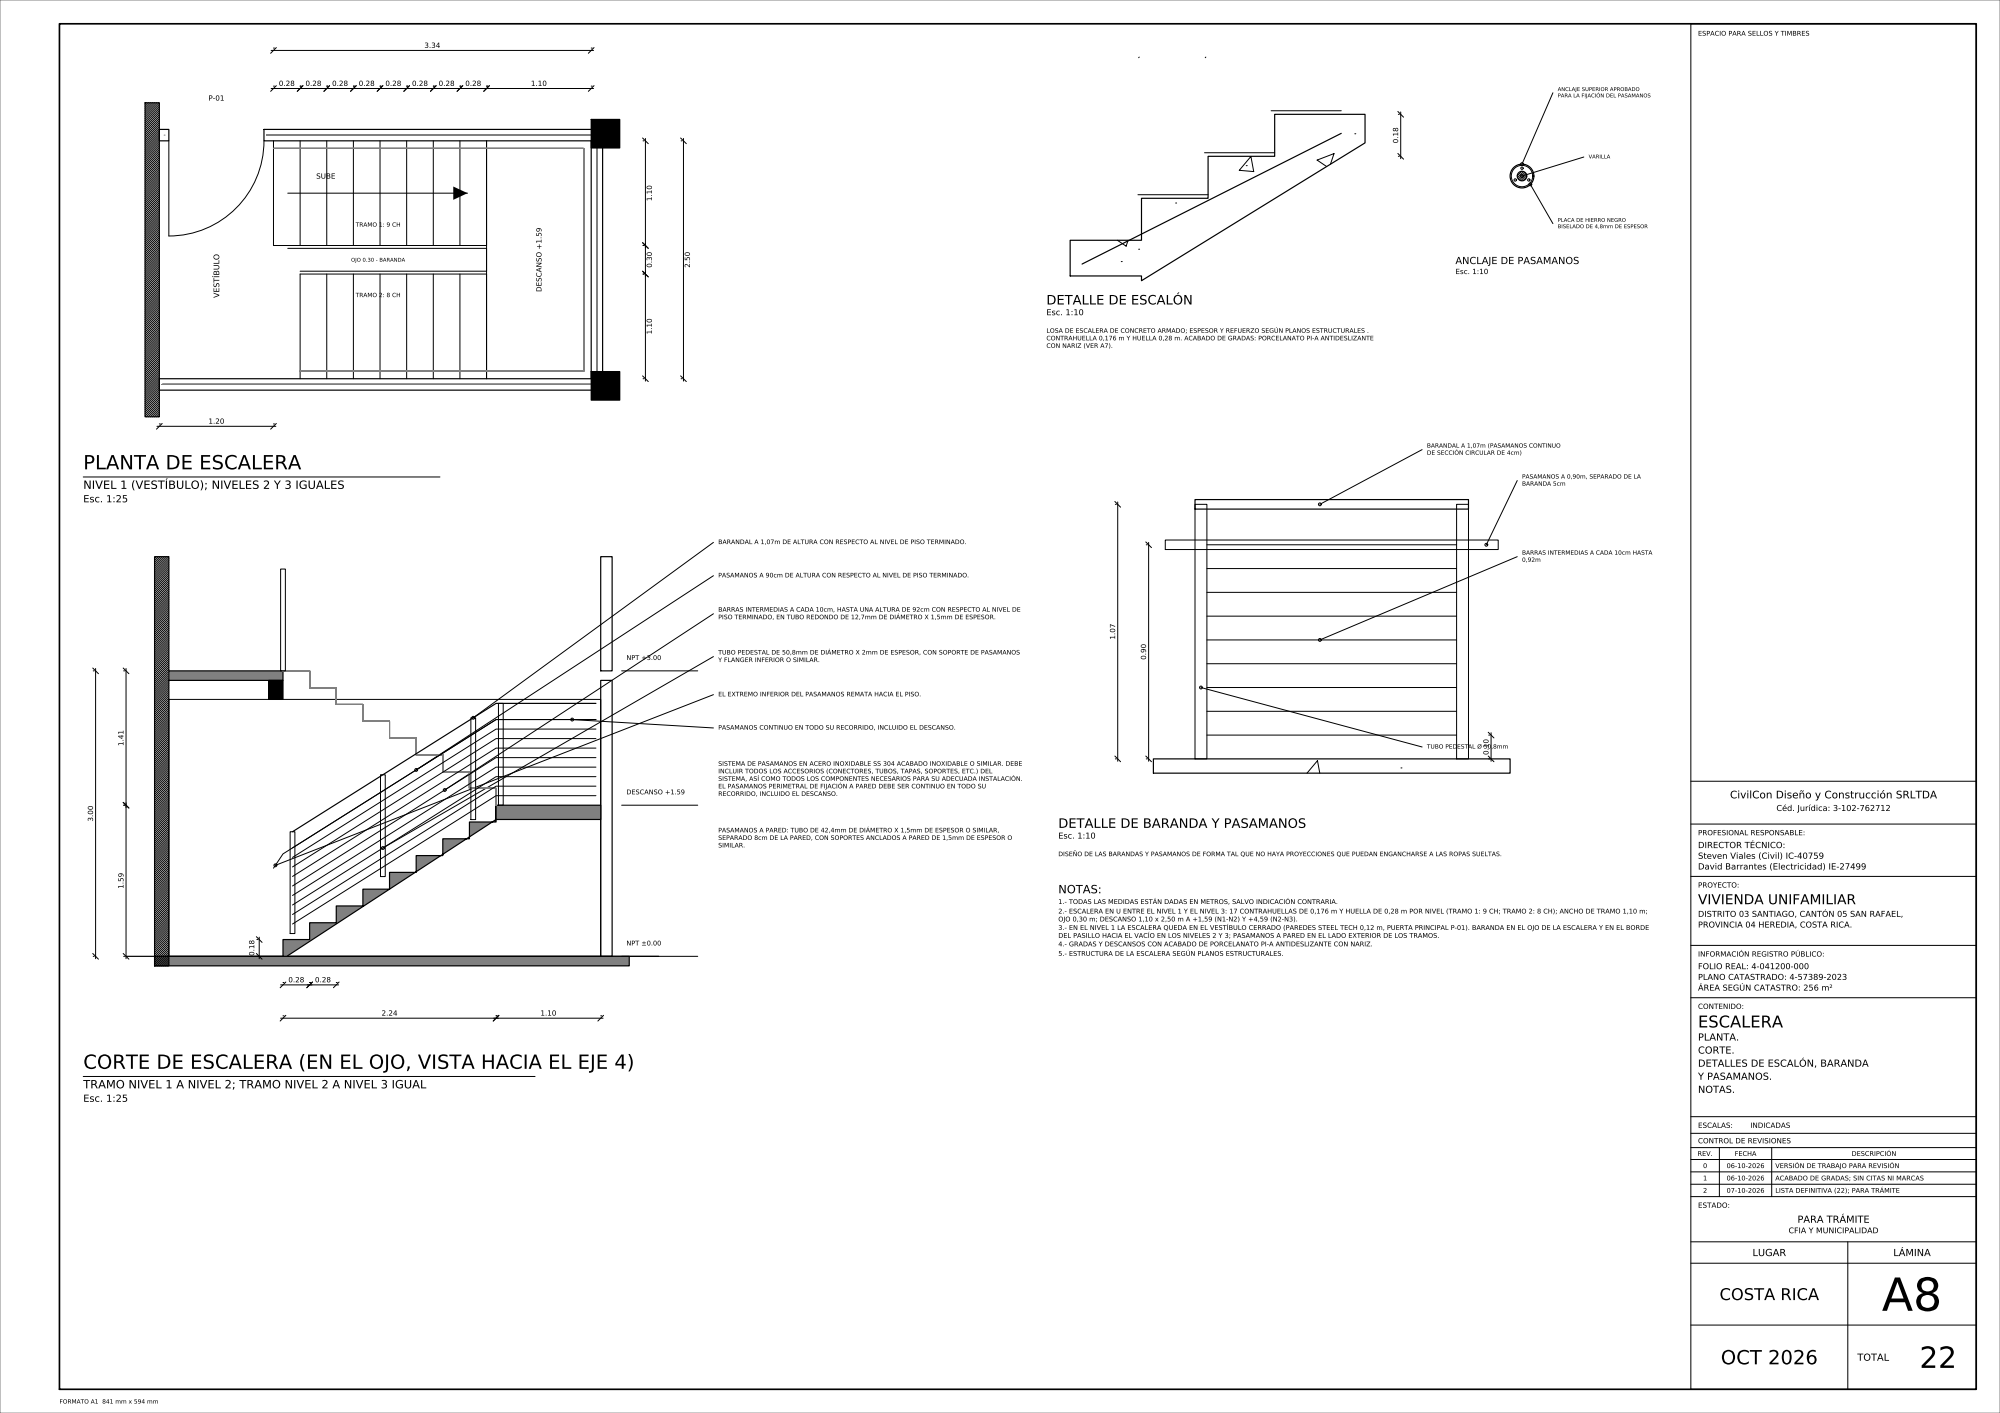
[picture p27: page 1]
