jbarra777/jbarra777/planos/C05_porticos_longitudinal/SR-C05_PORTICOS_LONGITUDINAL_rev0.pdf

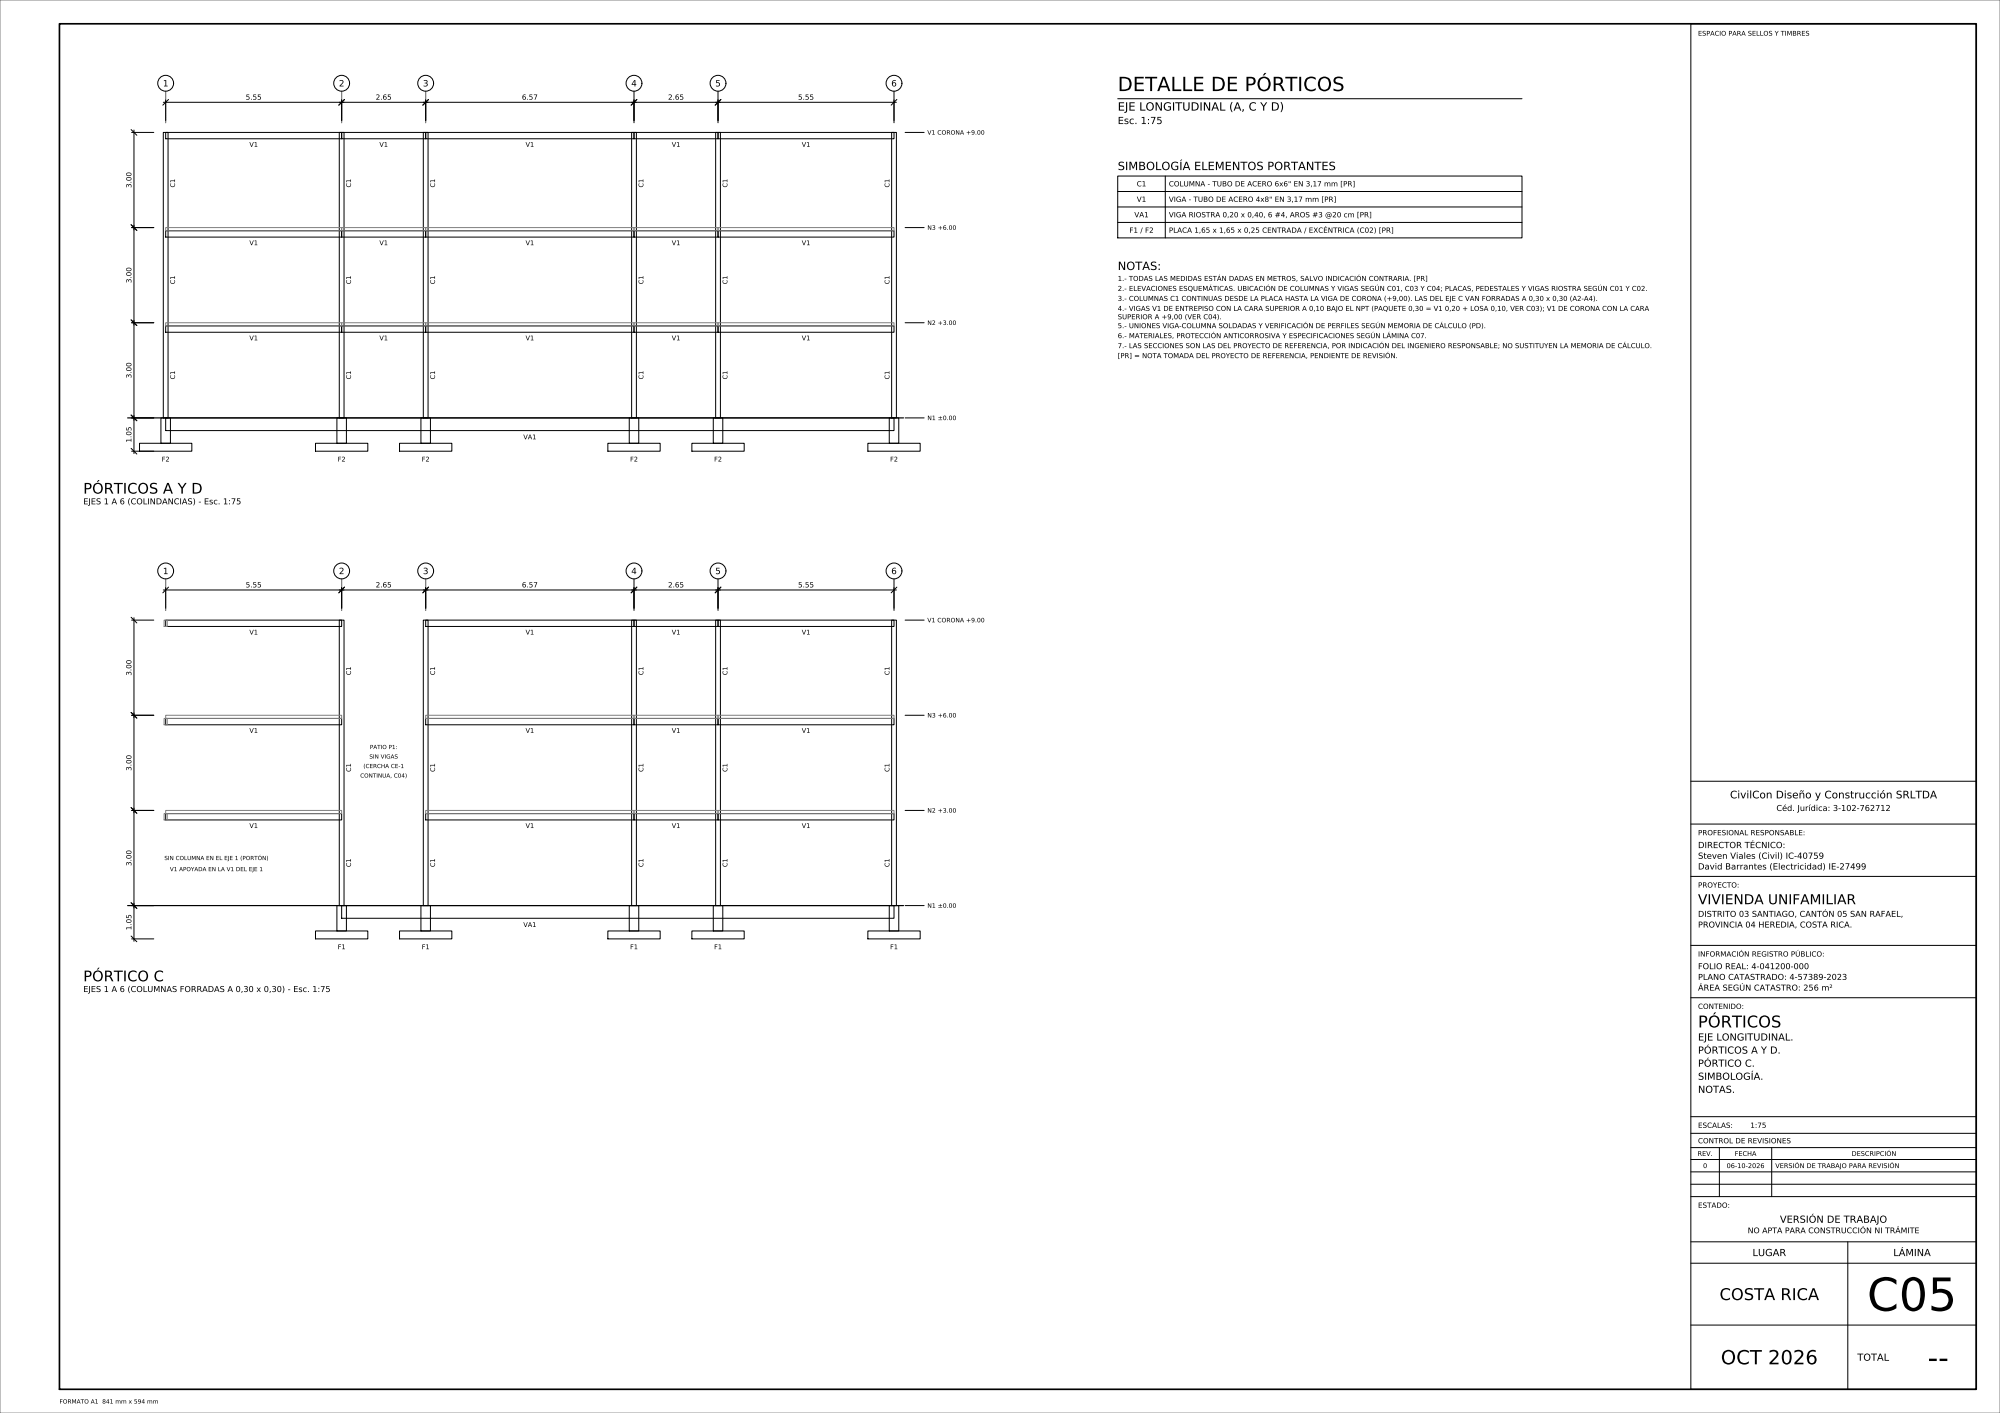
[picture p28: page 1]
