jbarra777/jbarra777/planos/C06_porticos_transversal/SR-C06_PORTICOS_TRANSVERSAL_rev0.pdf

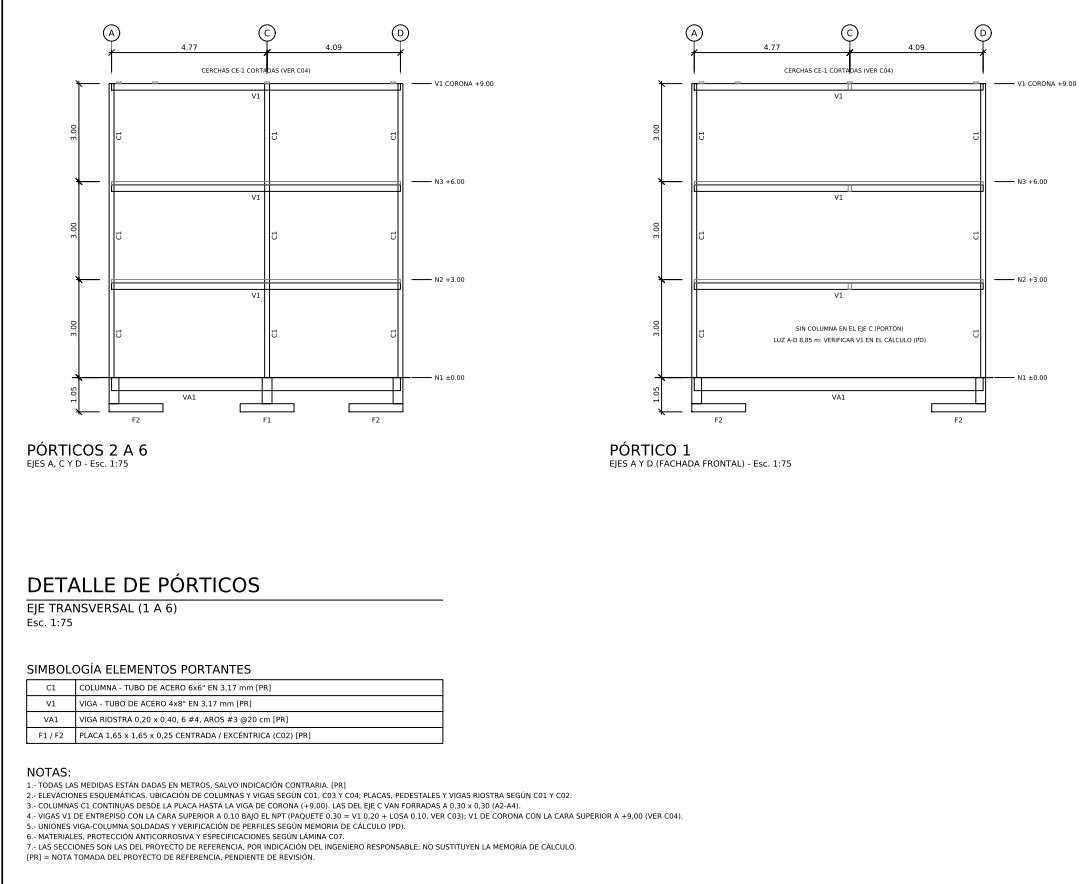
[picture p29: page 1]
