jbarra777/jbarra777/planos/C03_entrepiso_n2/SR-C03_ENTREPISO_N2_rev0.pdf

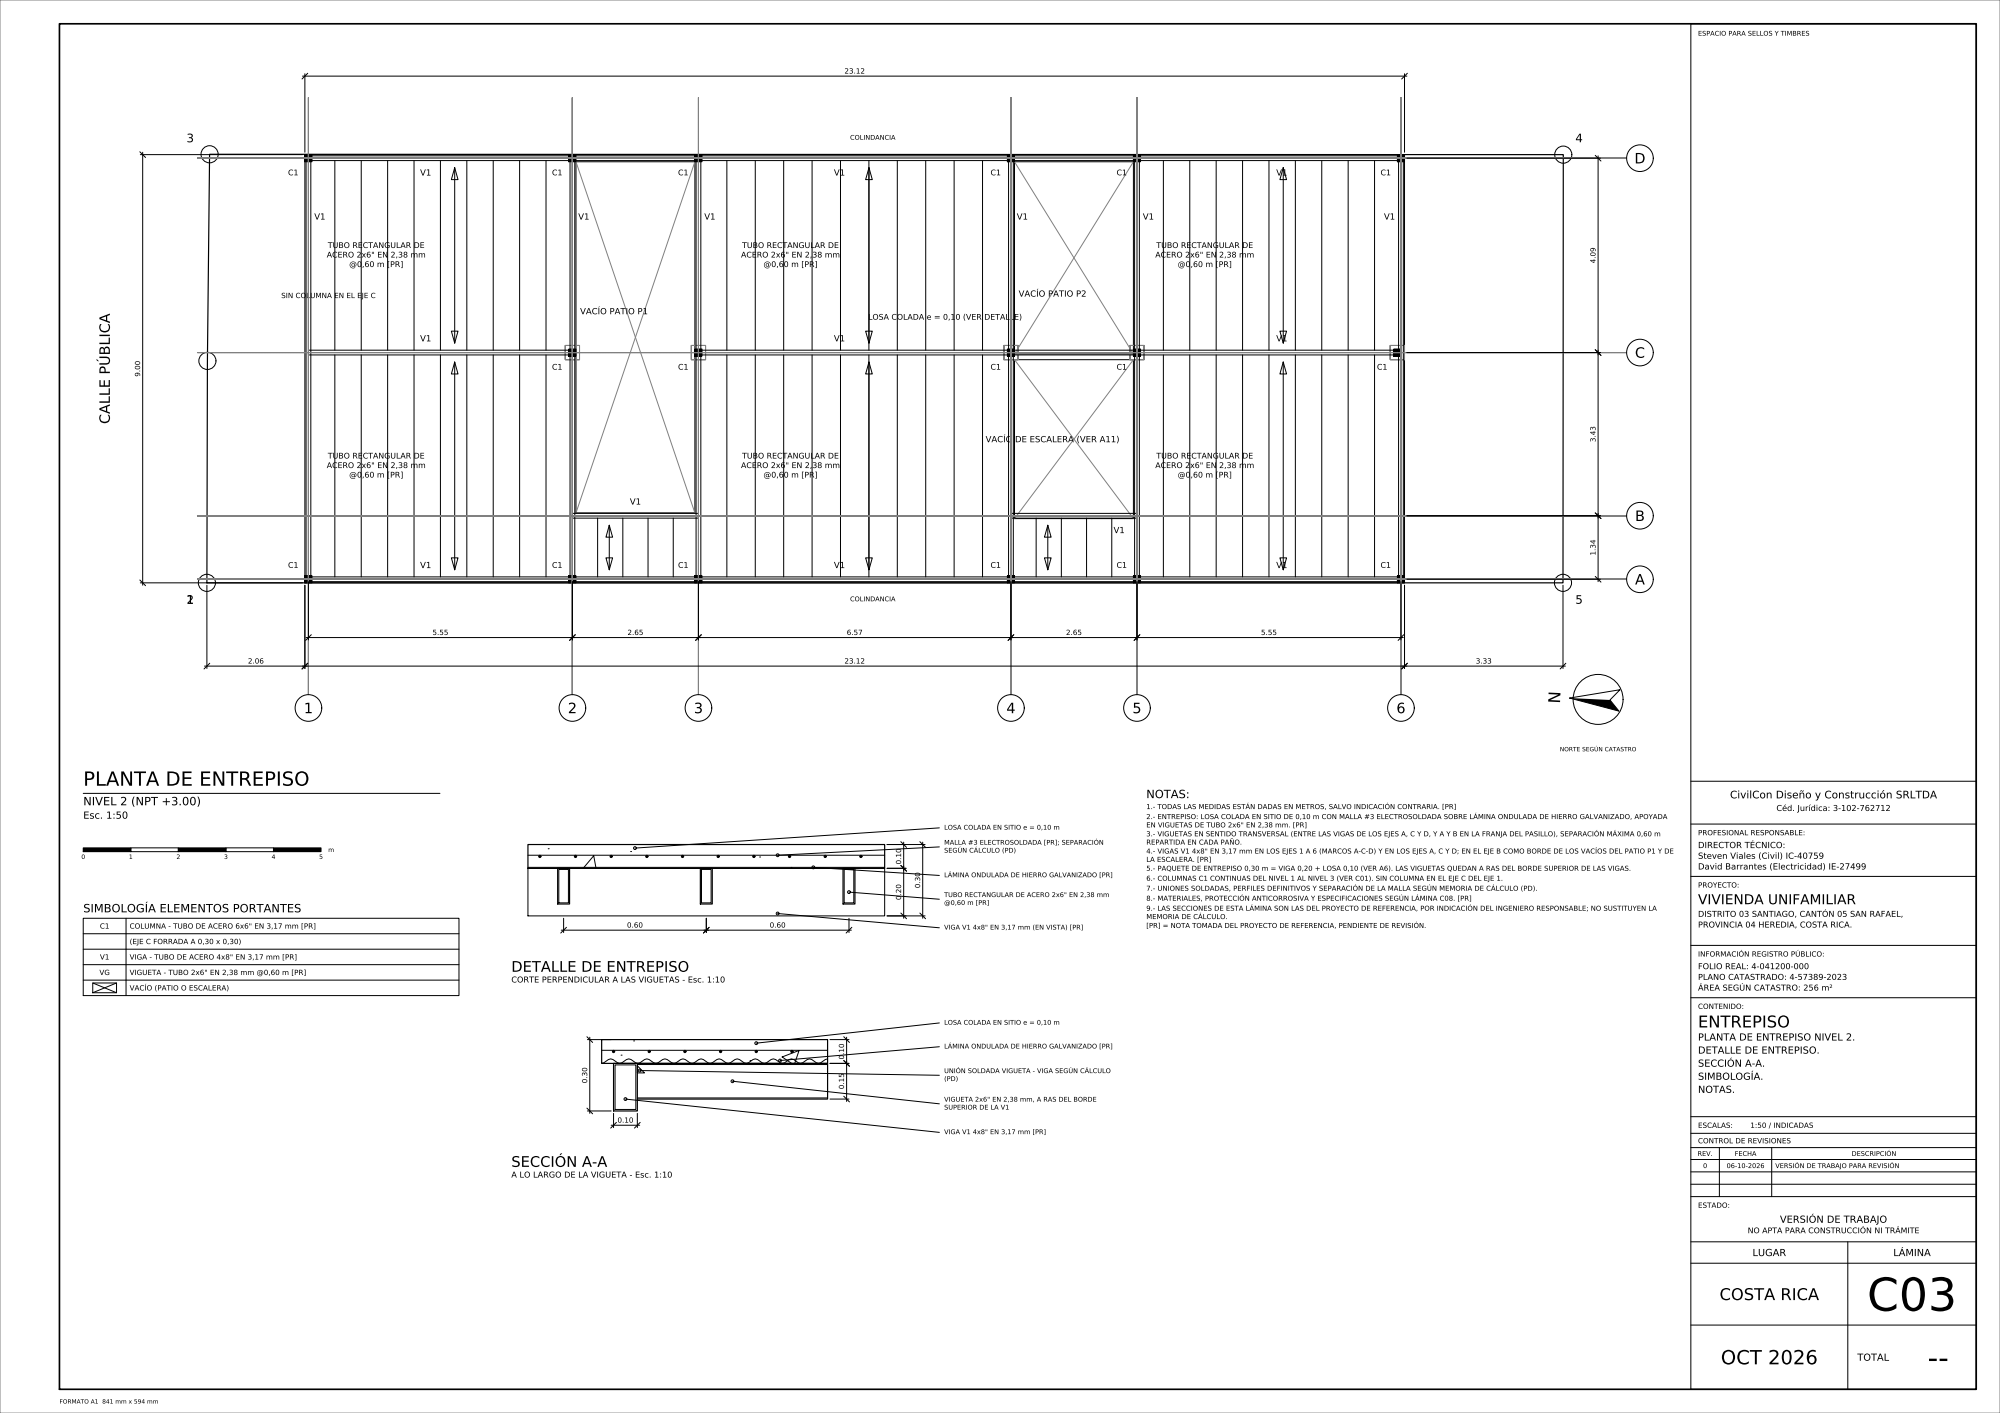
[picture p30: page 1]
