jbarra777/jbarra777/planos/A11_escalera/SR-A11_ESCALERA_rev1.pdf

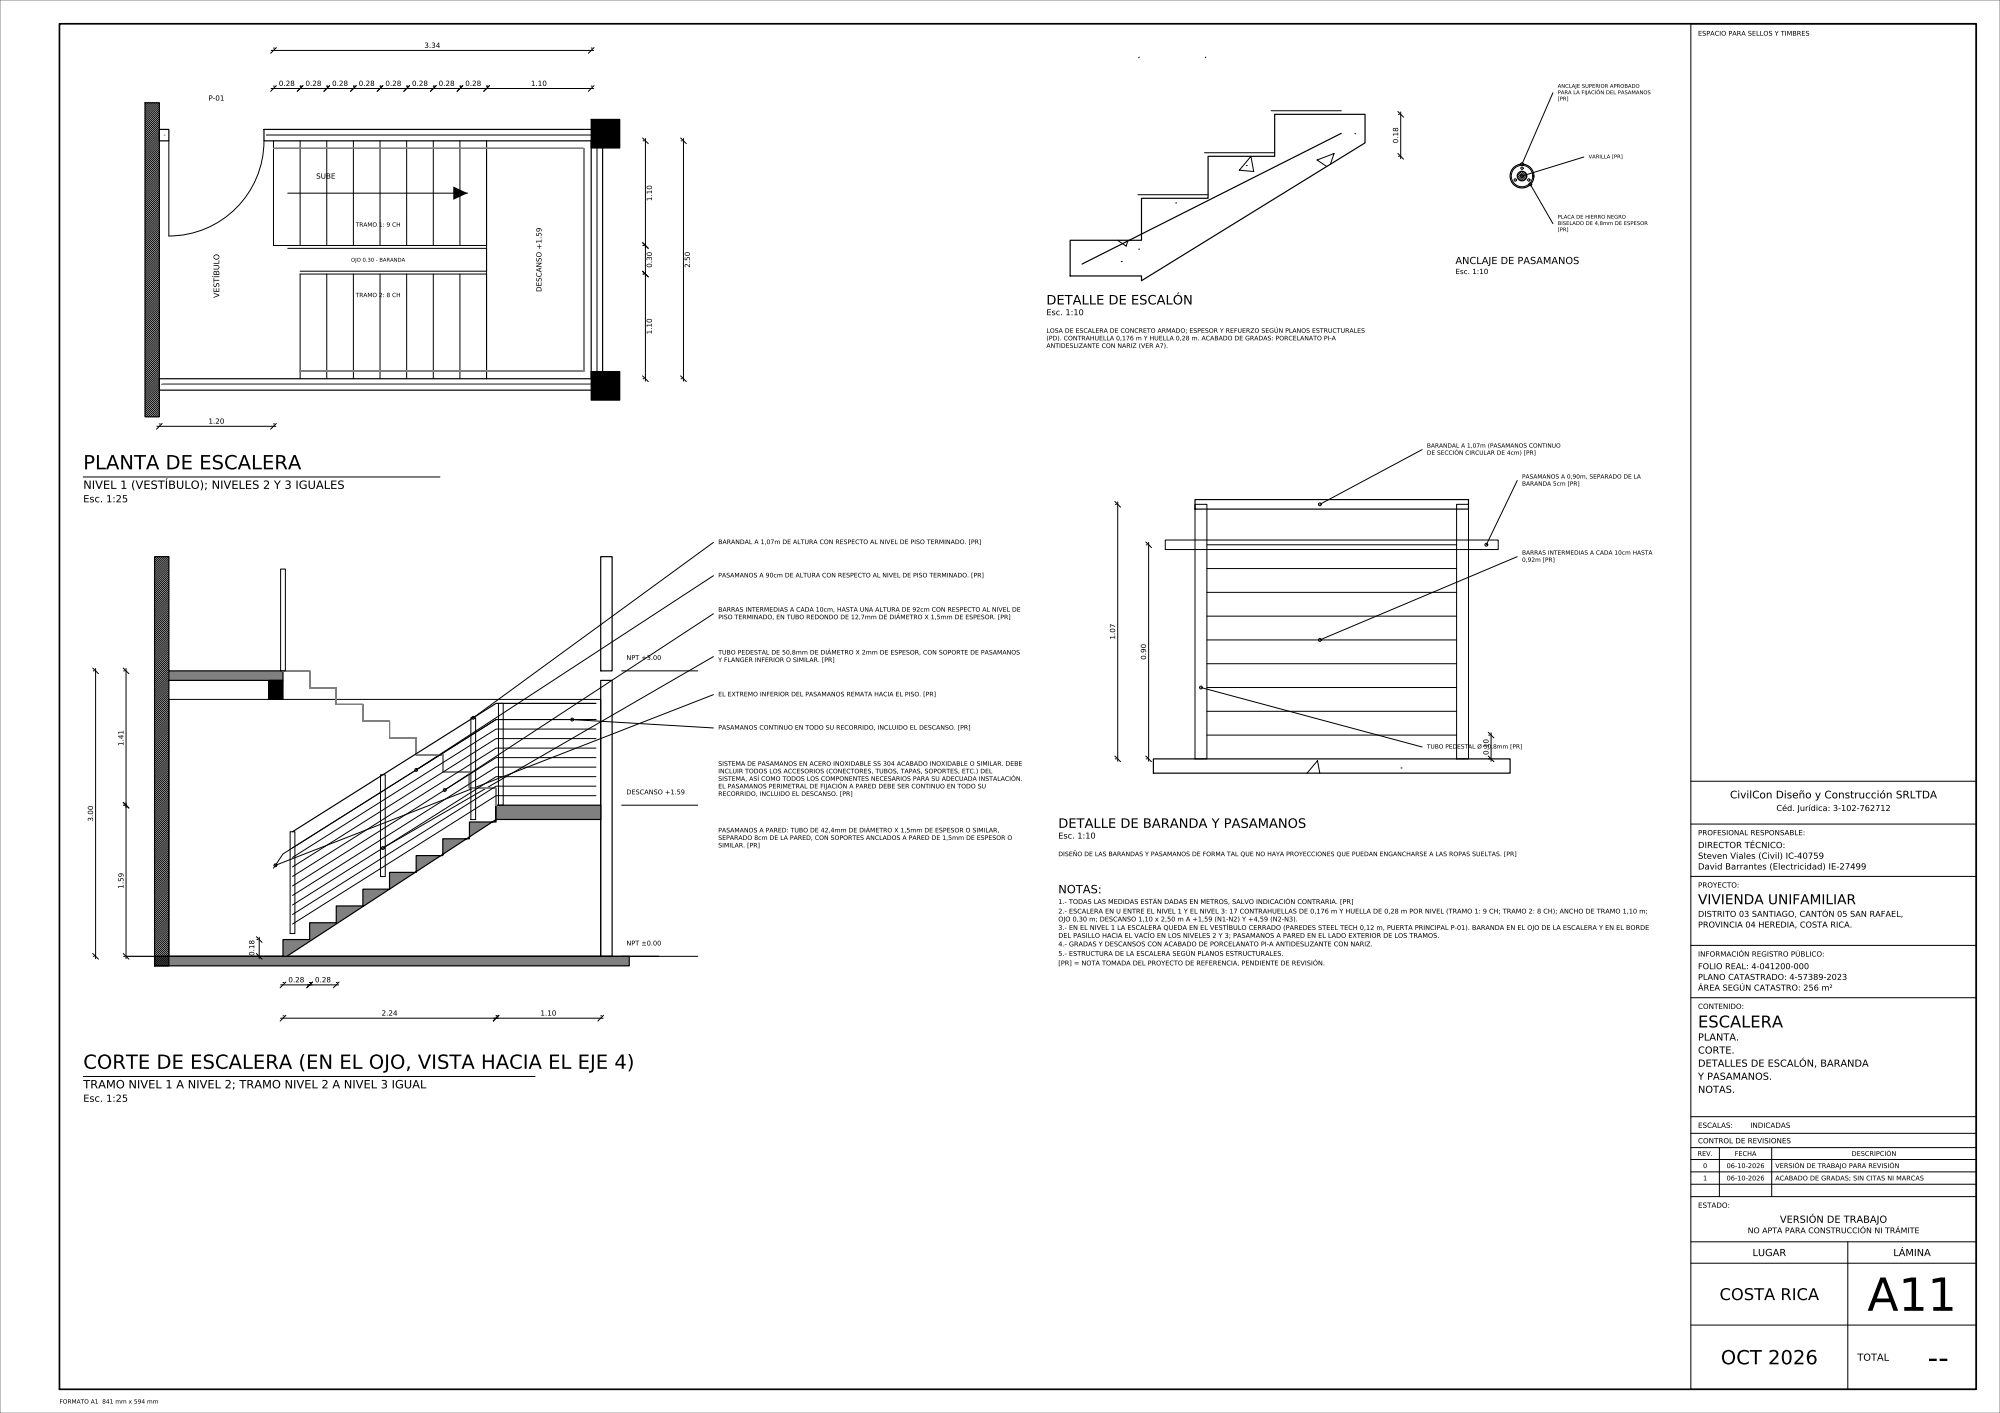
[picture p31: page 1]
