jbarra777/jbarra777/planos/A1_lote/SR-A1_LOTE_rev2.pdf

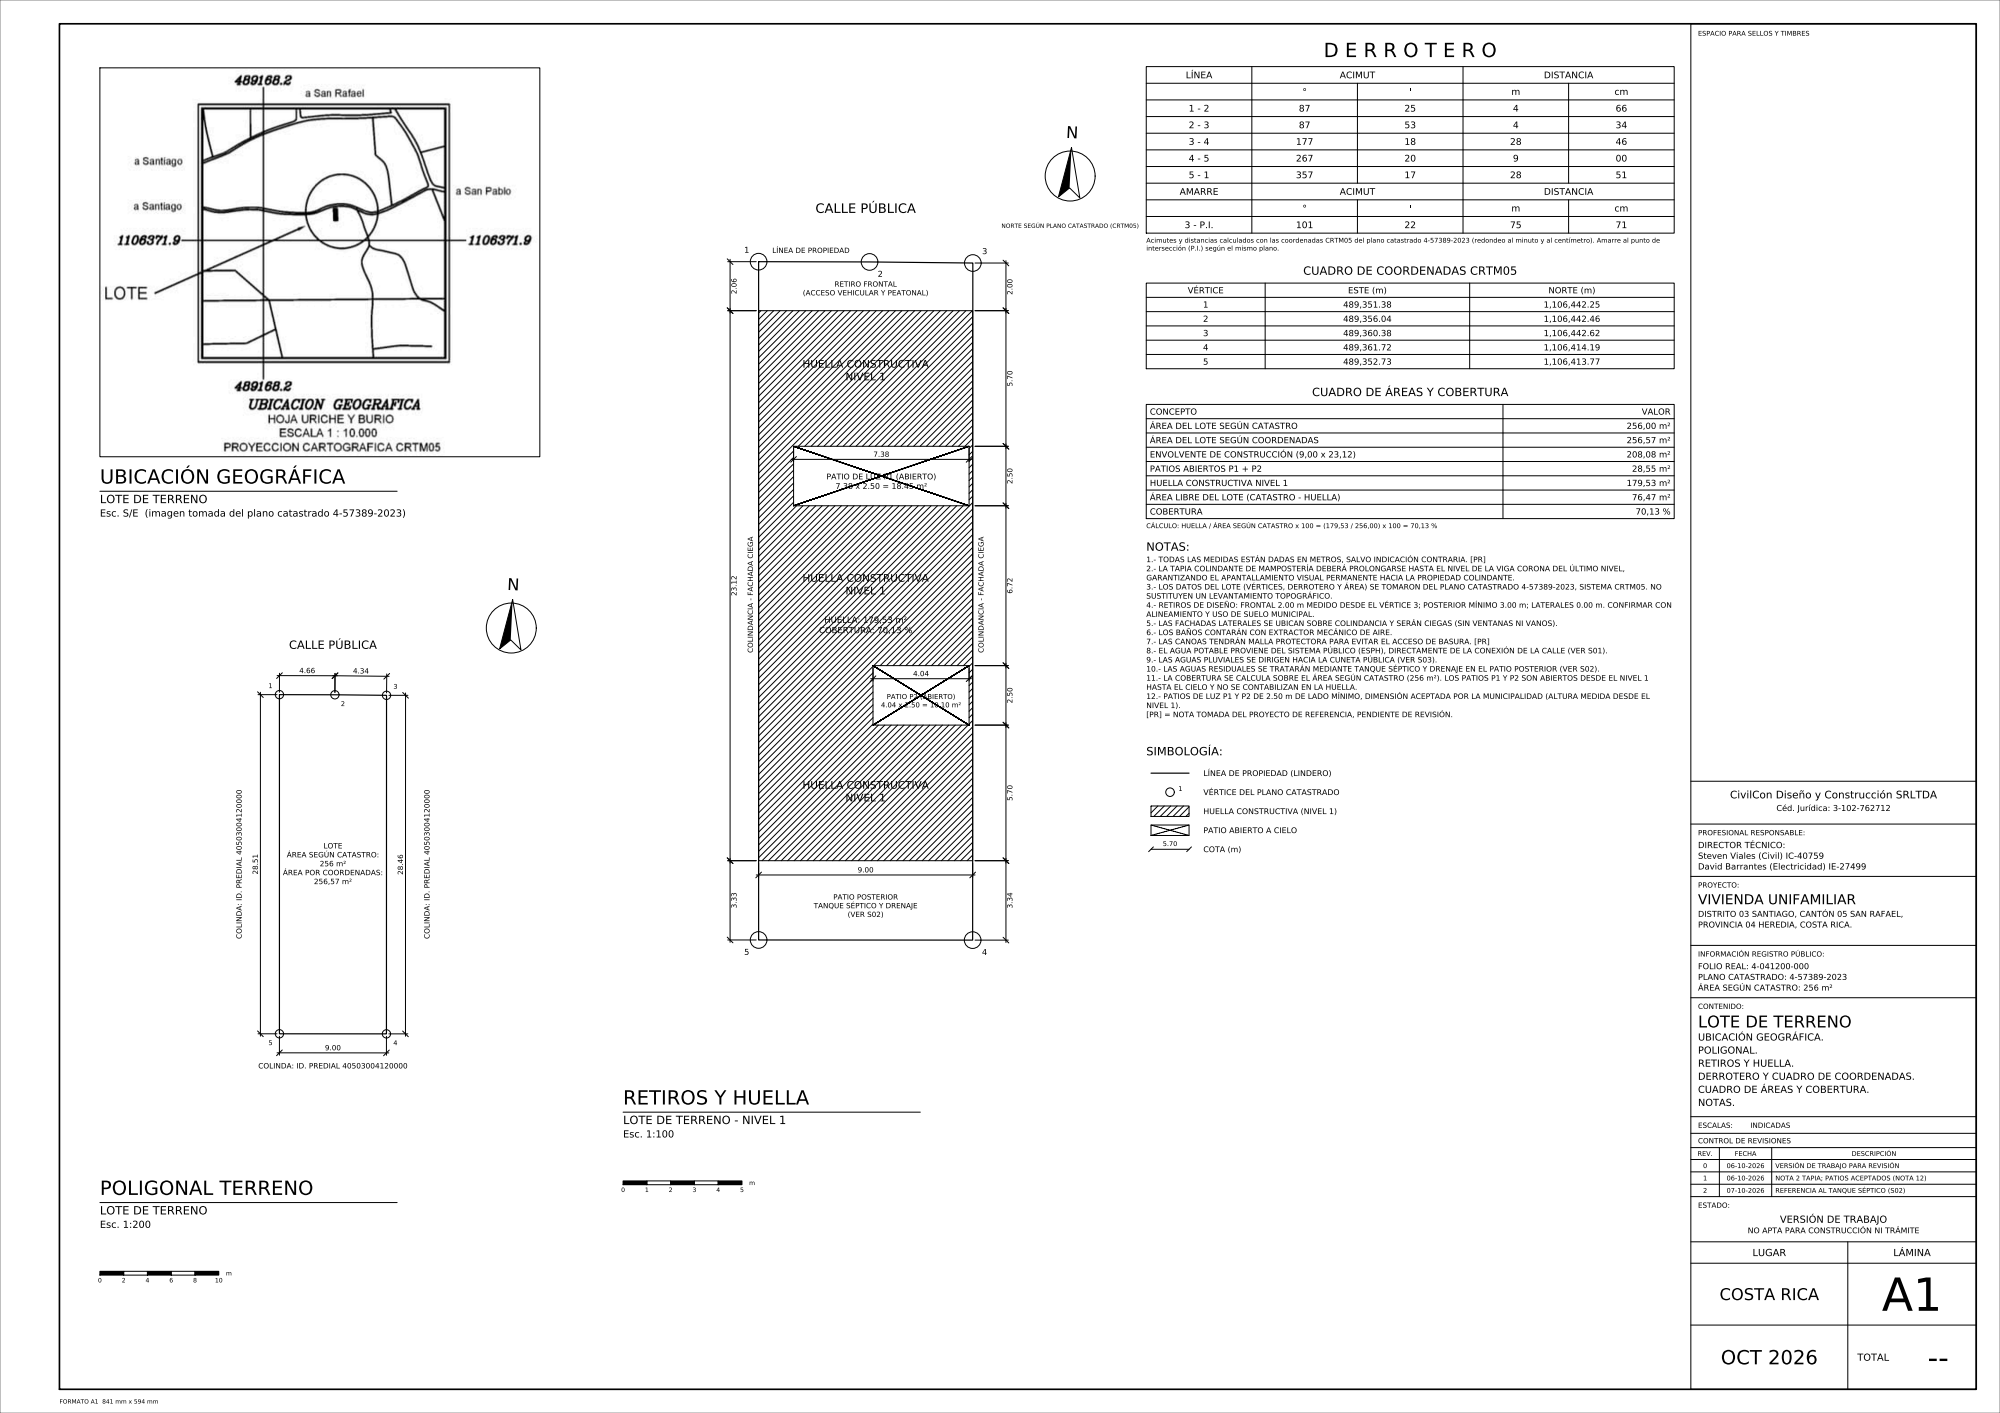
[picture p32: page 1]
