jbarra777/jbarra777/planos/A2_nivel1/SR-A2_NIVEL1_rev4.pdf

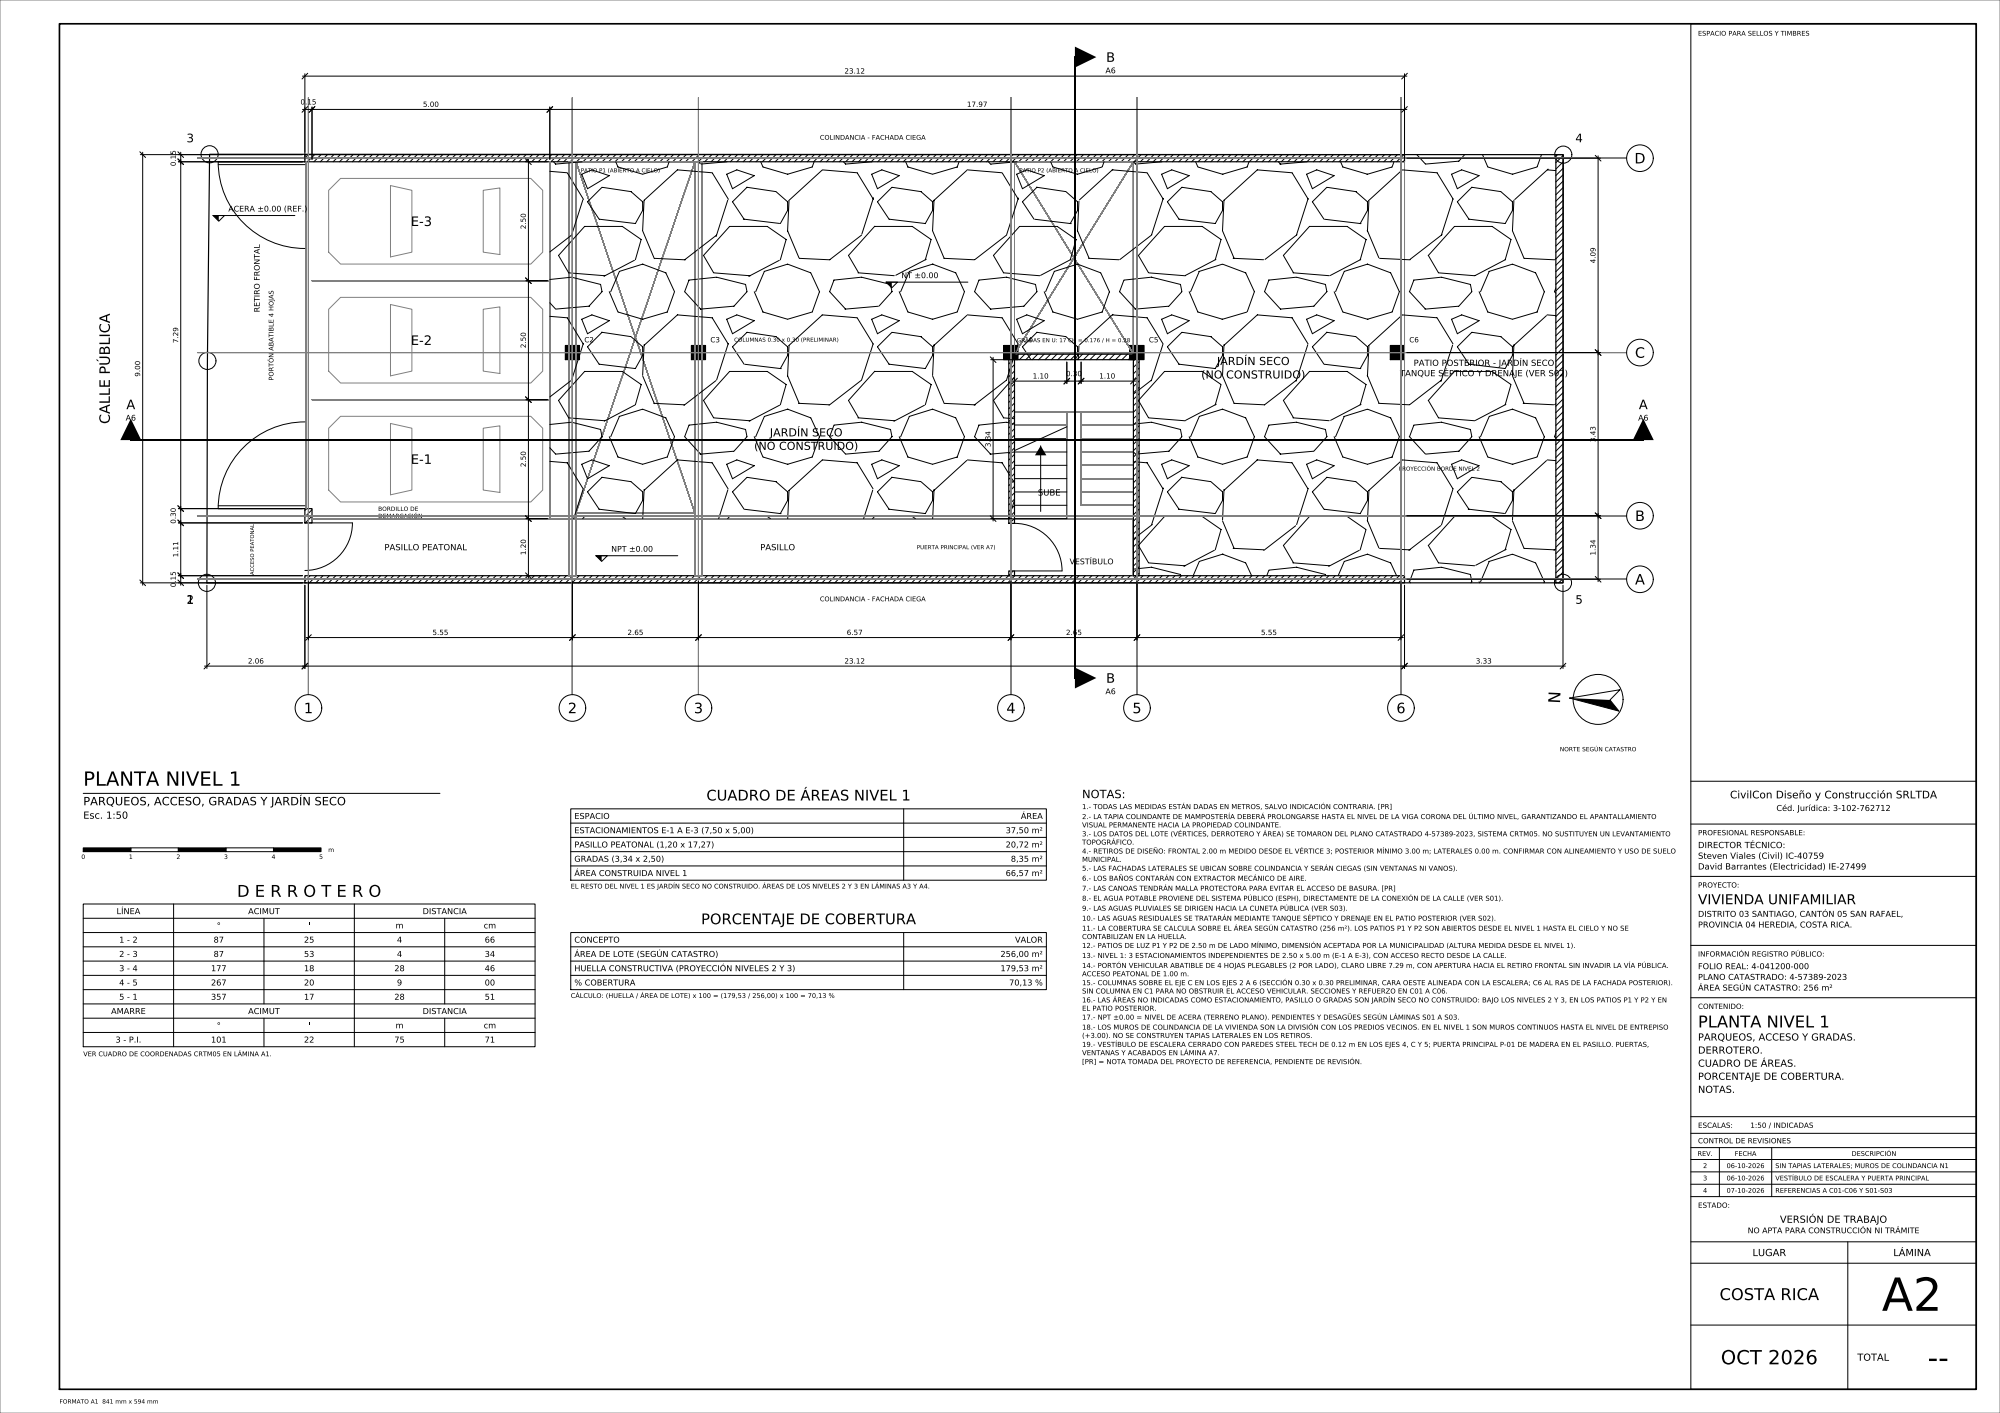
[picture p33: page 1]
