jbarra777/jbarra777/planos/A3_nivel2/SR-A3_NIVEL2_rev5.pdf

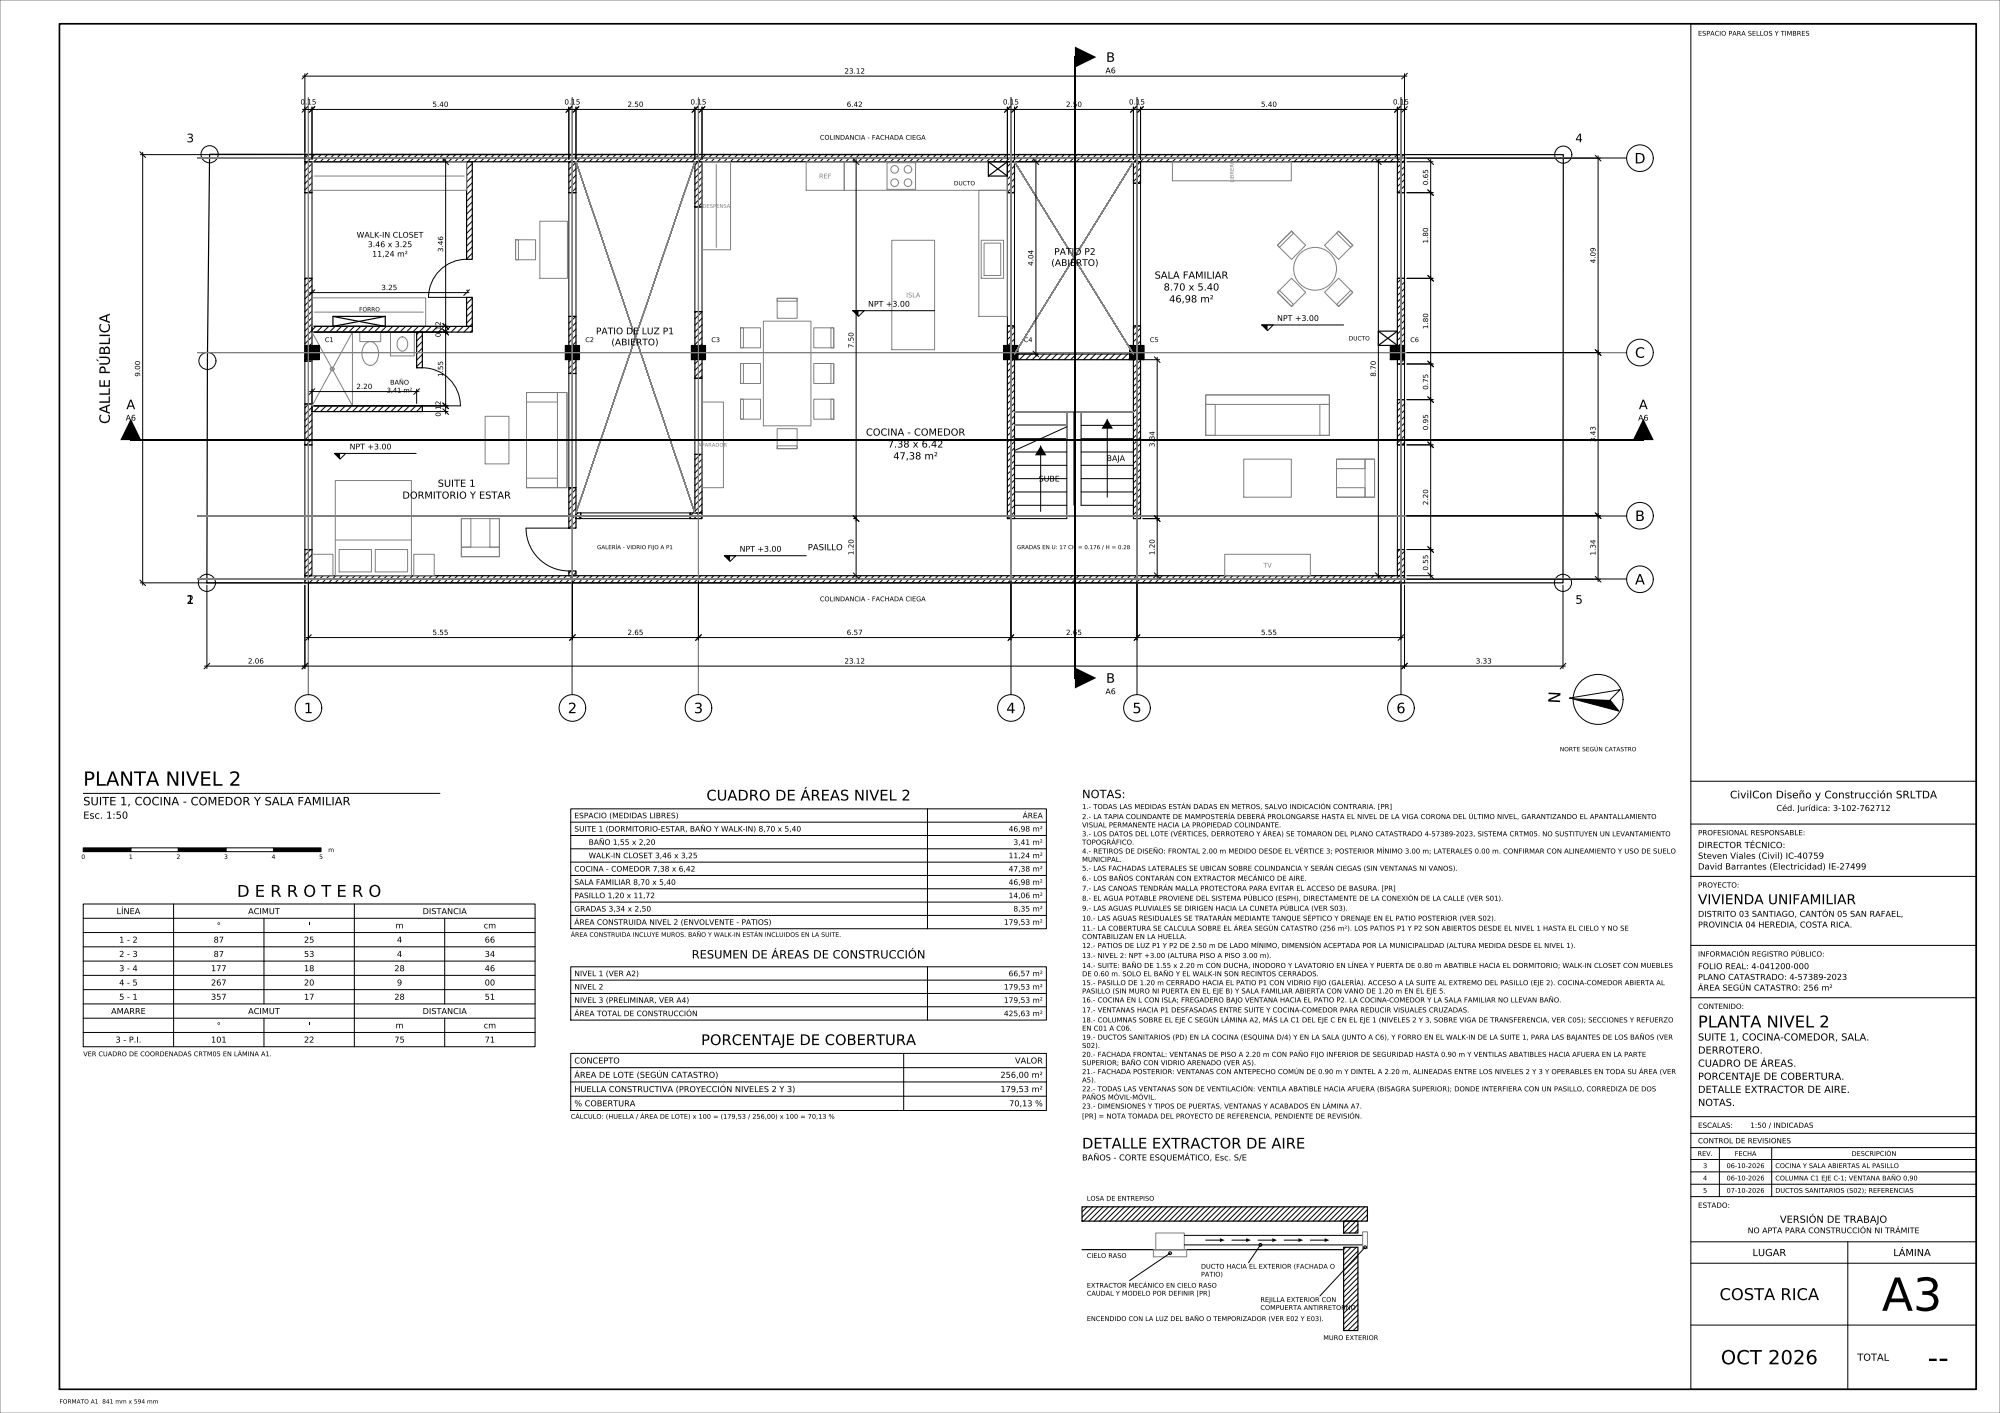
[picture p34: page 1]
