jbarra777/jbarra777/planos/A4_nivel3/SR-A4_NIVEL3_rev5.pdf

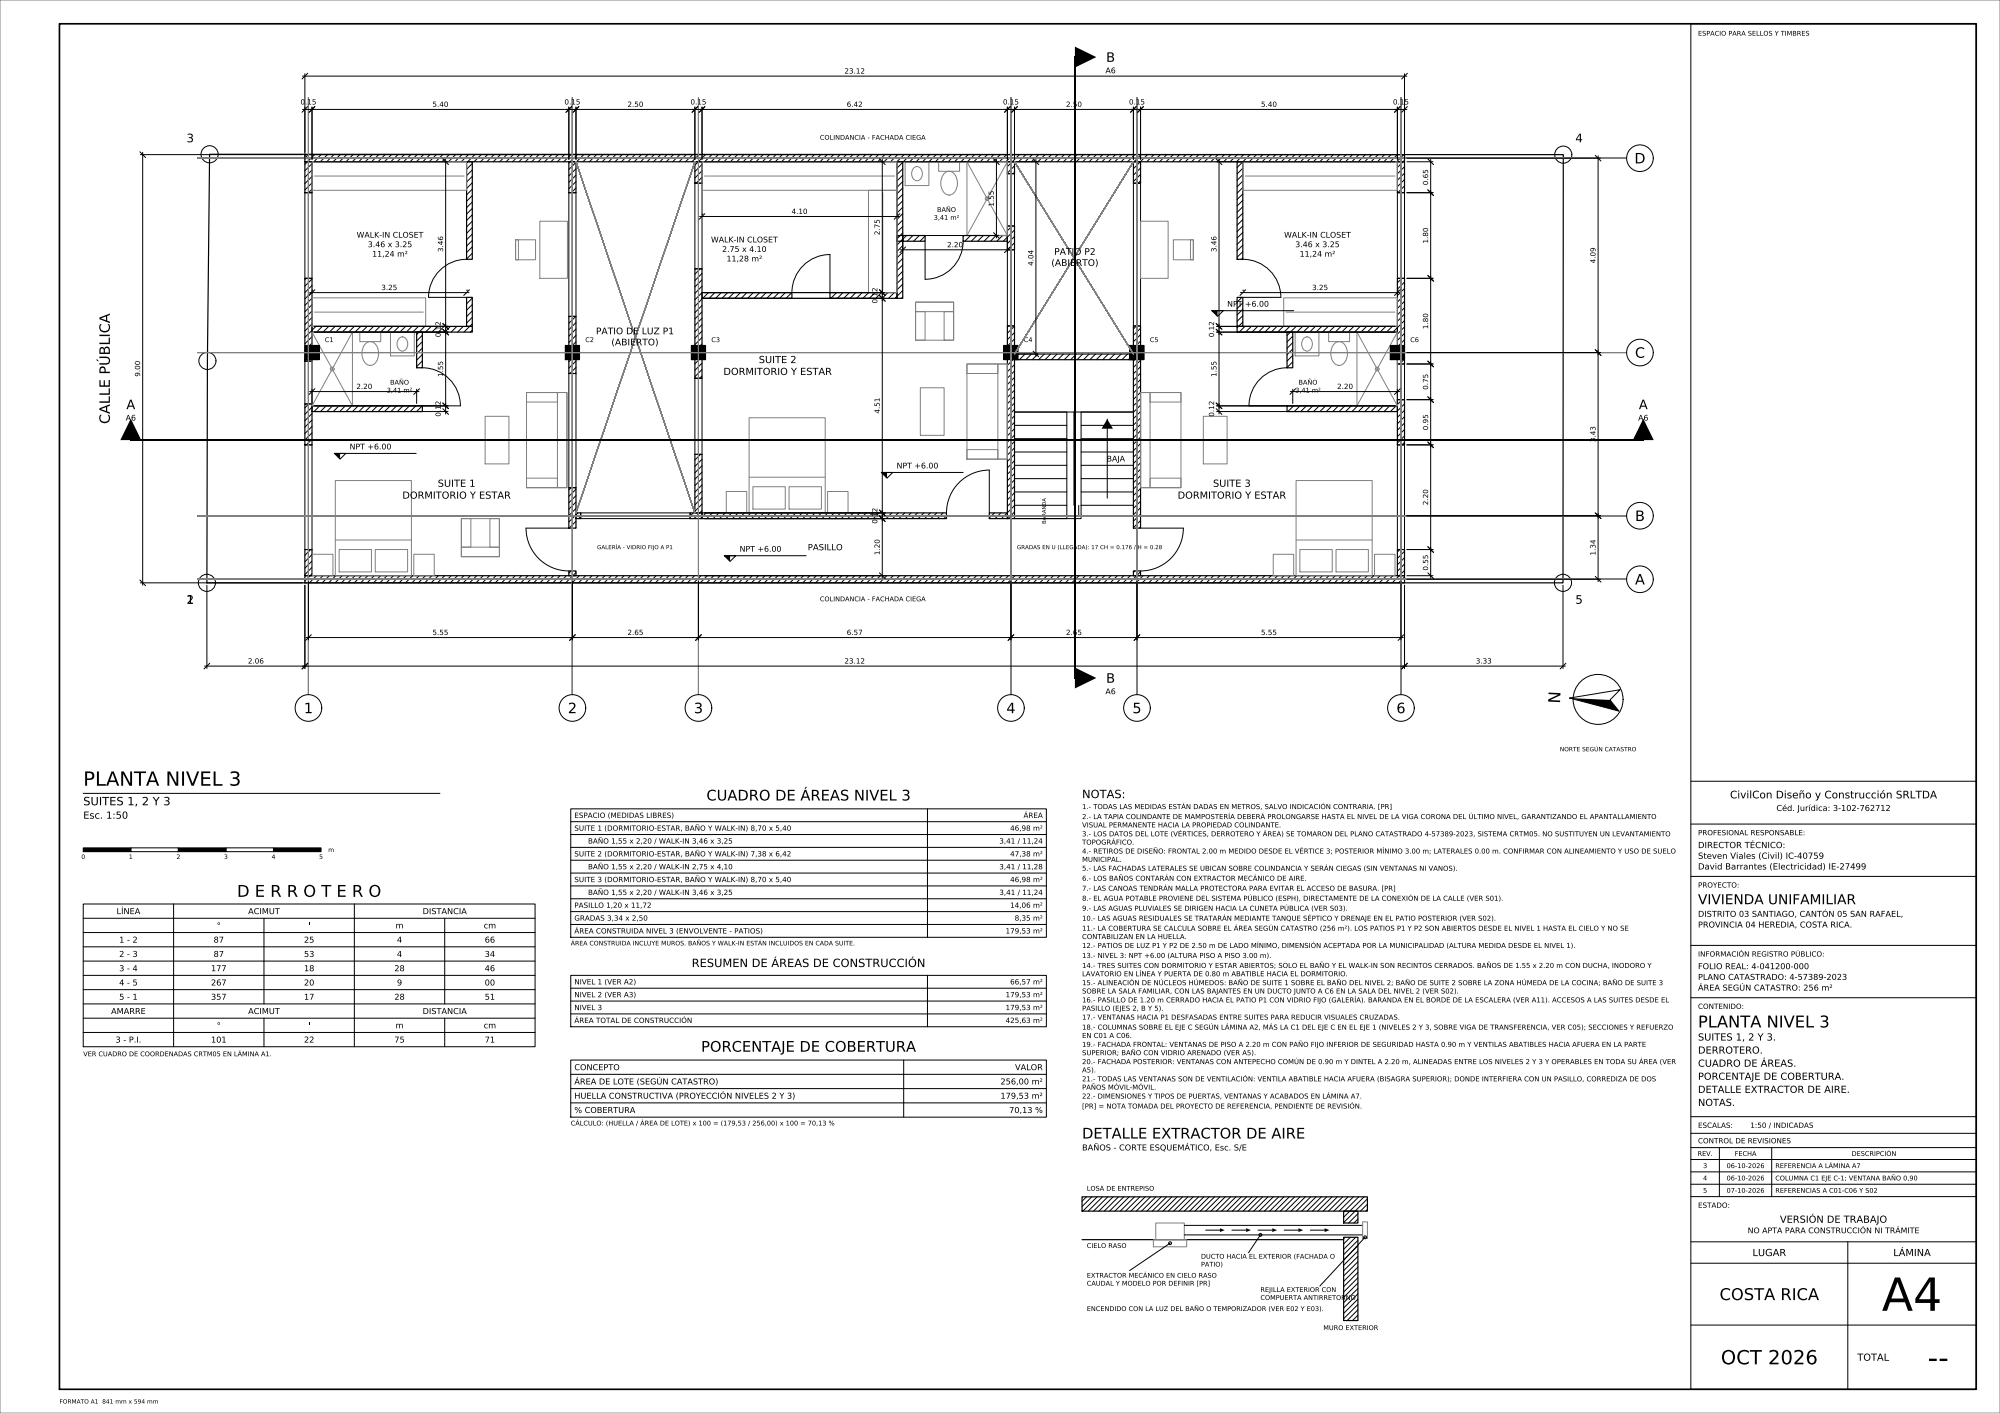
[picture p35: page 1]
