jbarra777/jbarra777/planos/A5_fachadas/SR-A5_FACHADAS_rev7.pdf

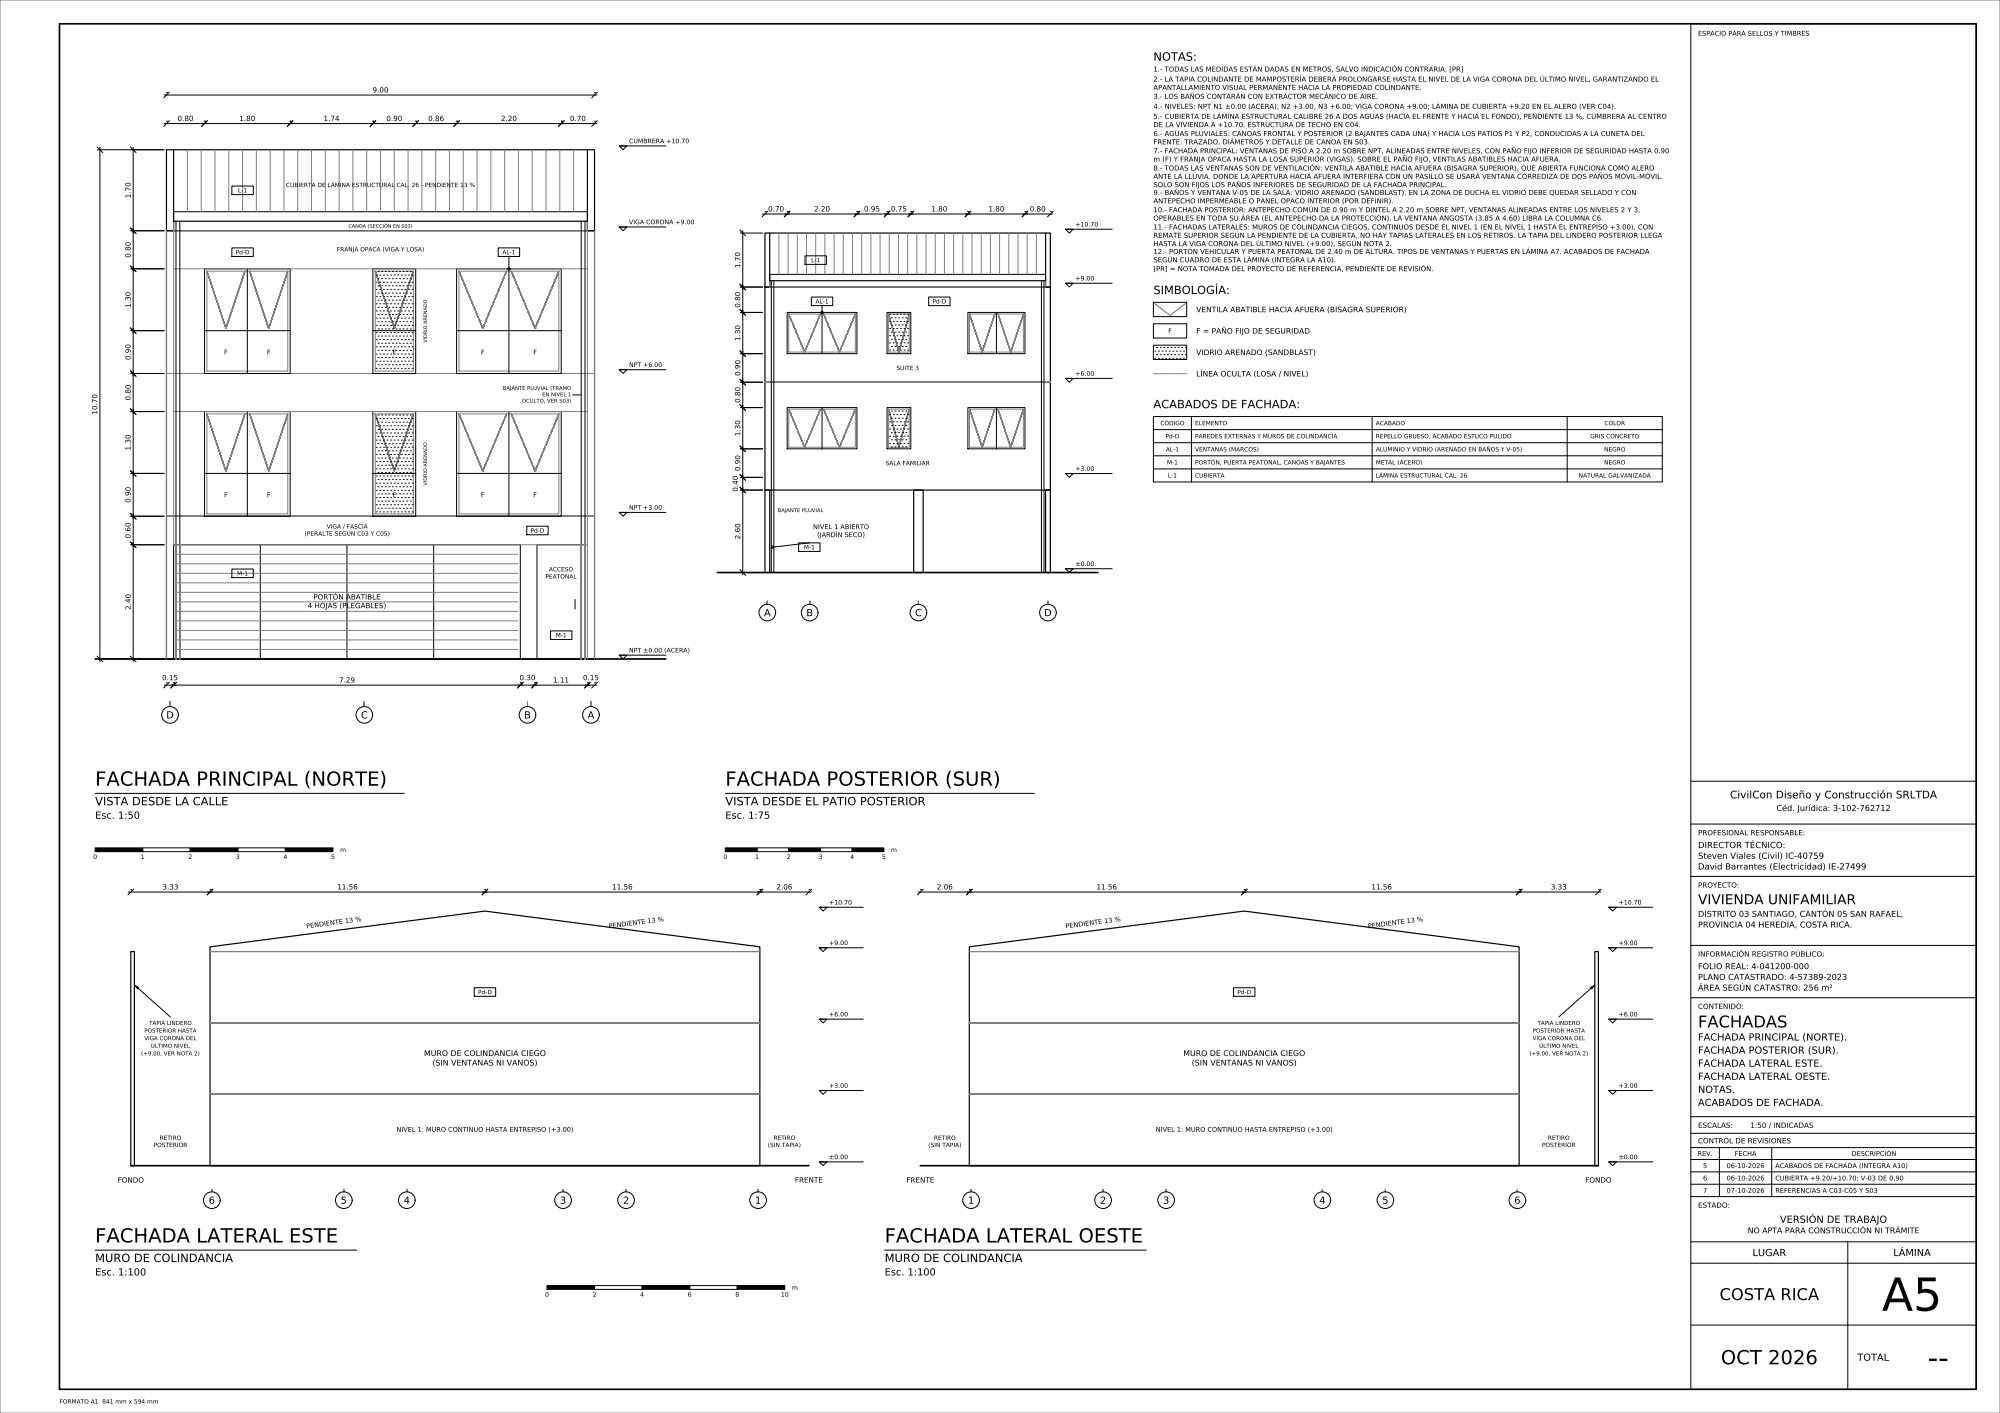
[picture p36: page 1]
