jbarra777/jbarra777/planos/A6_cortes/SR-A6_CORTES_rev5.pdf

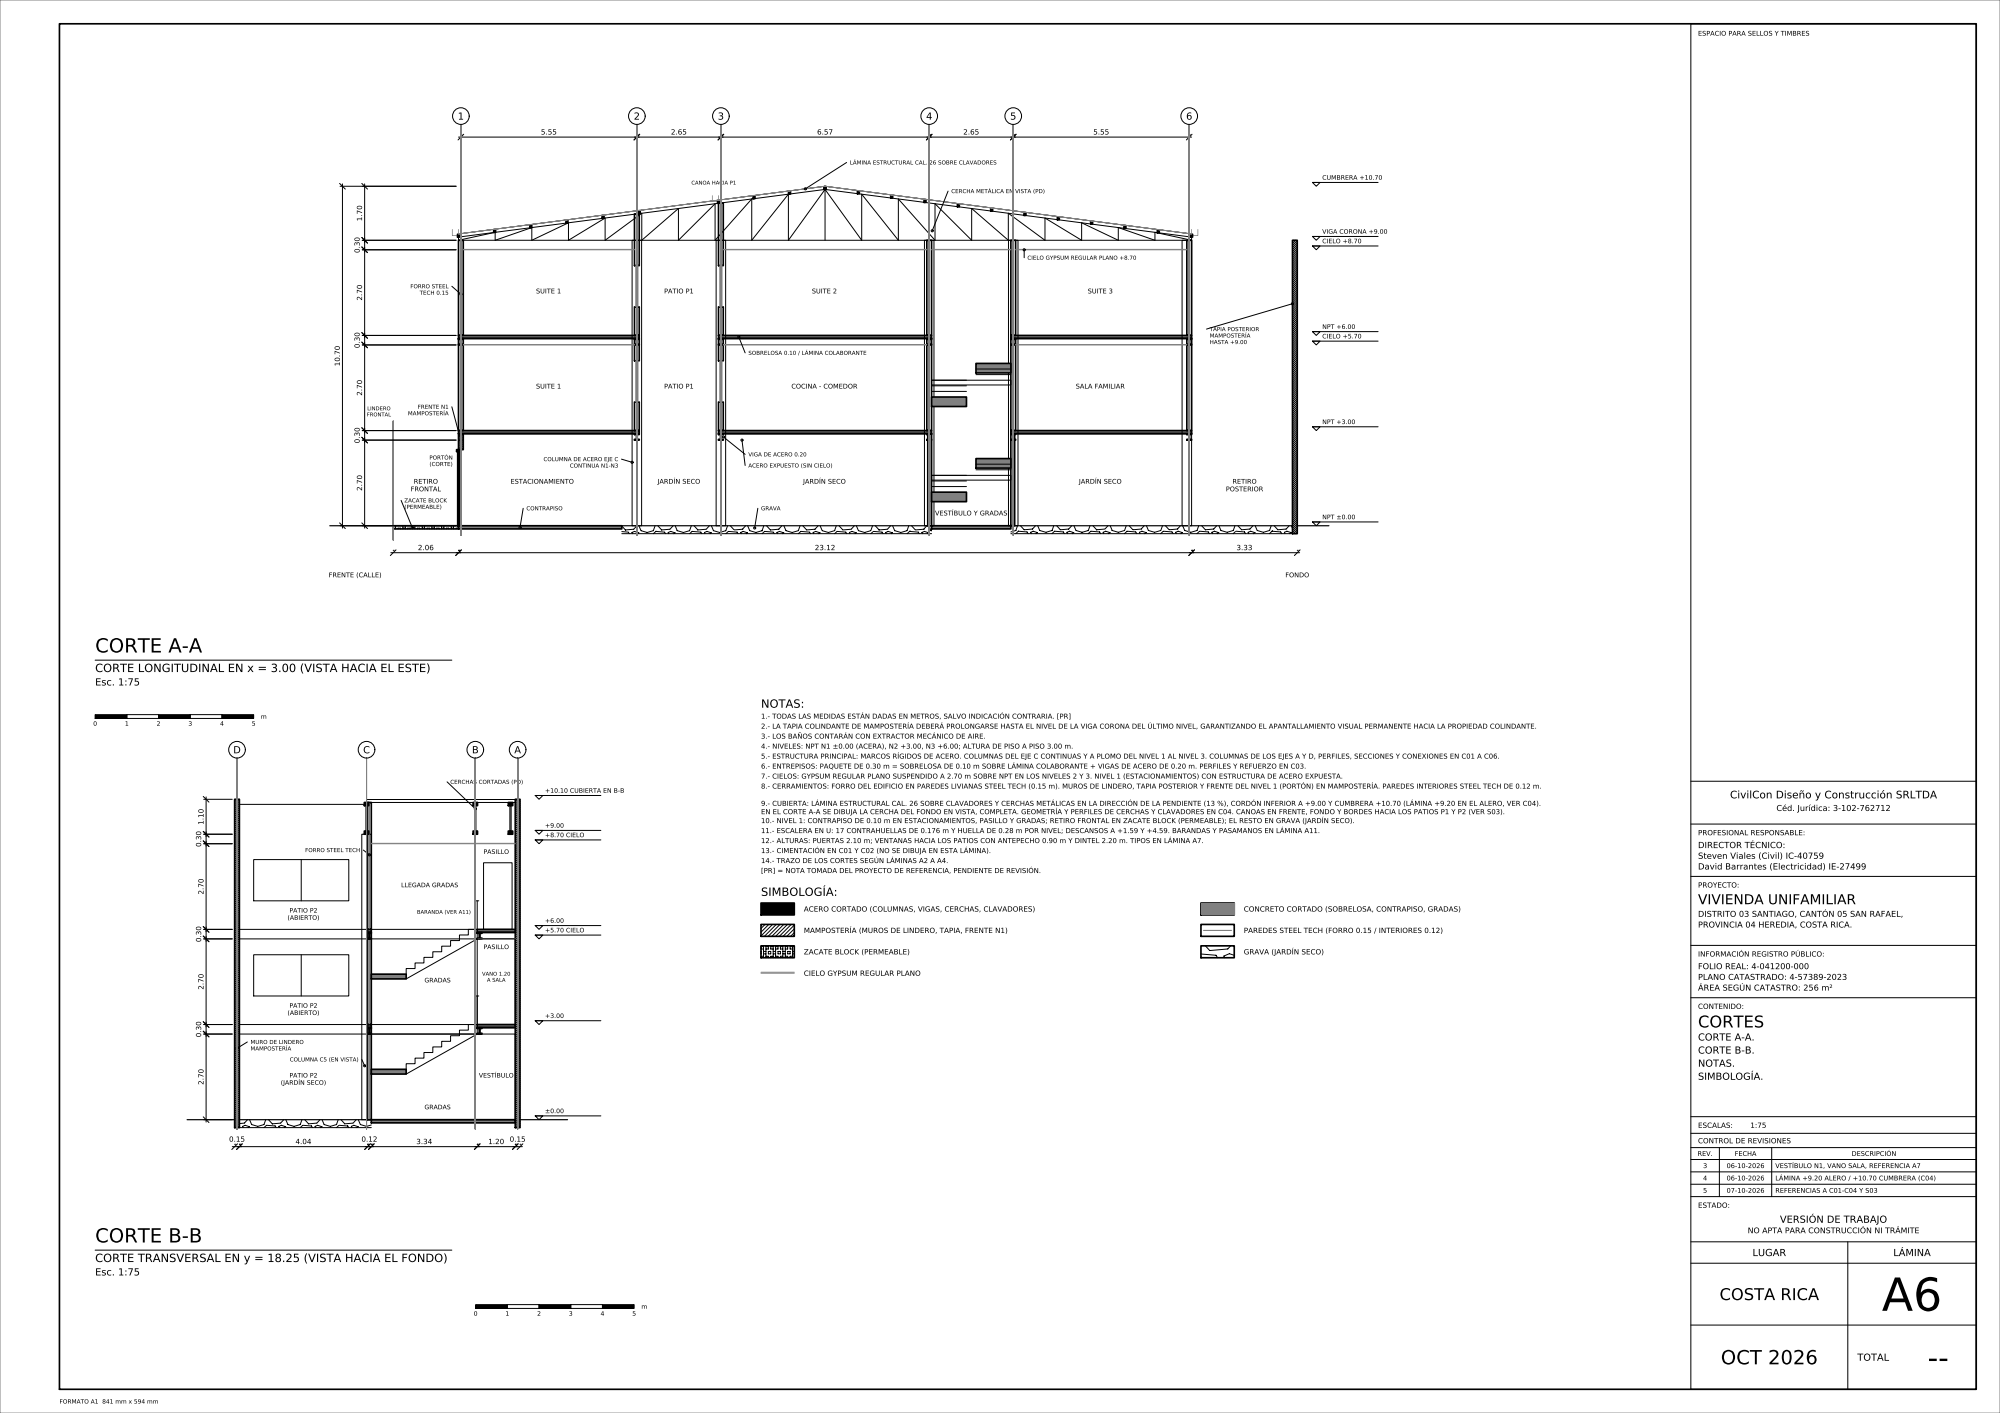
[picture p37: page 1]
