jbarra777/jbarra777/planos/A7_puertas_ventanas/SR-A7_PUERTAS_VENTANAS_rev3.pdf

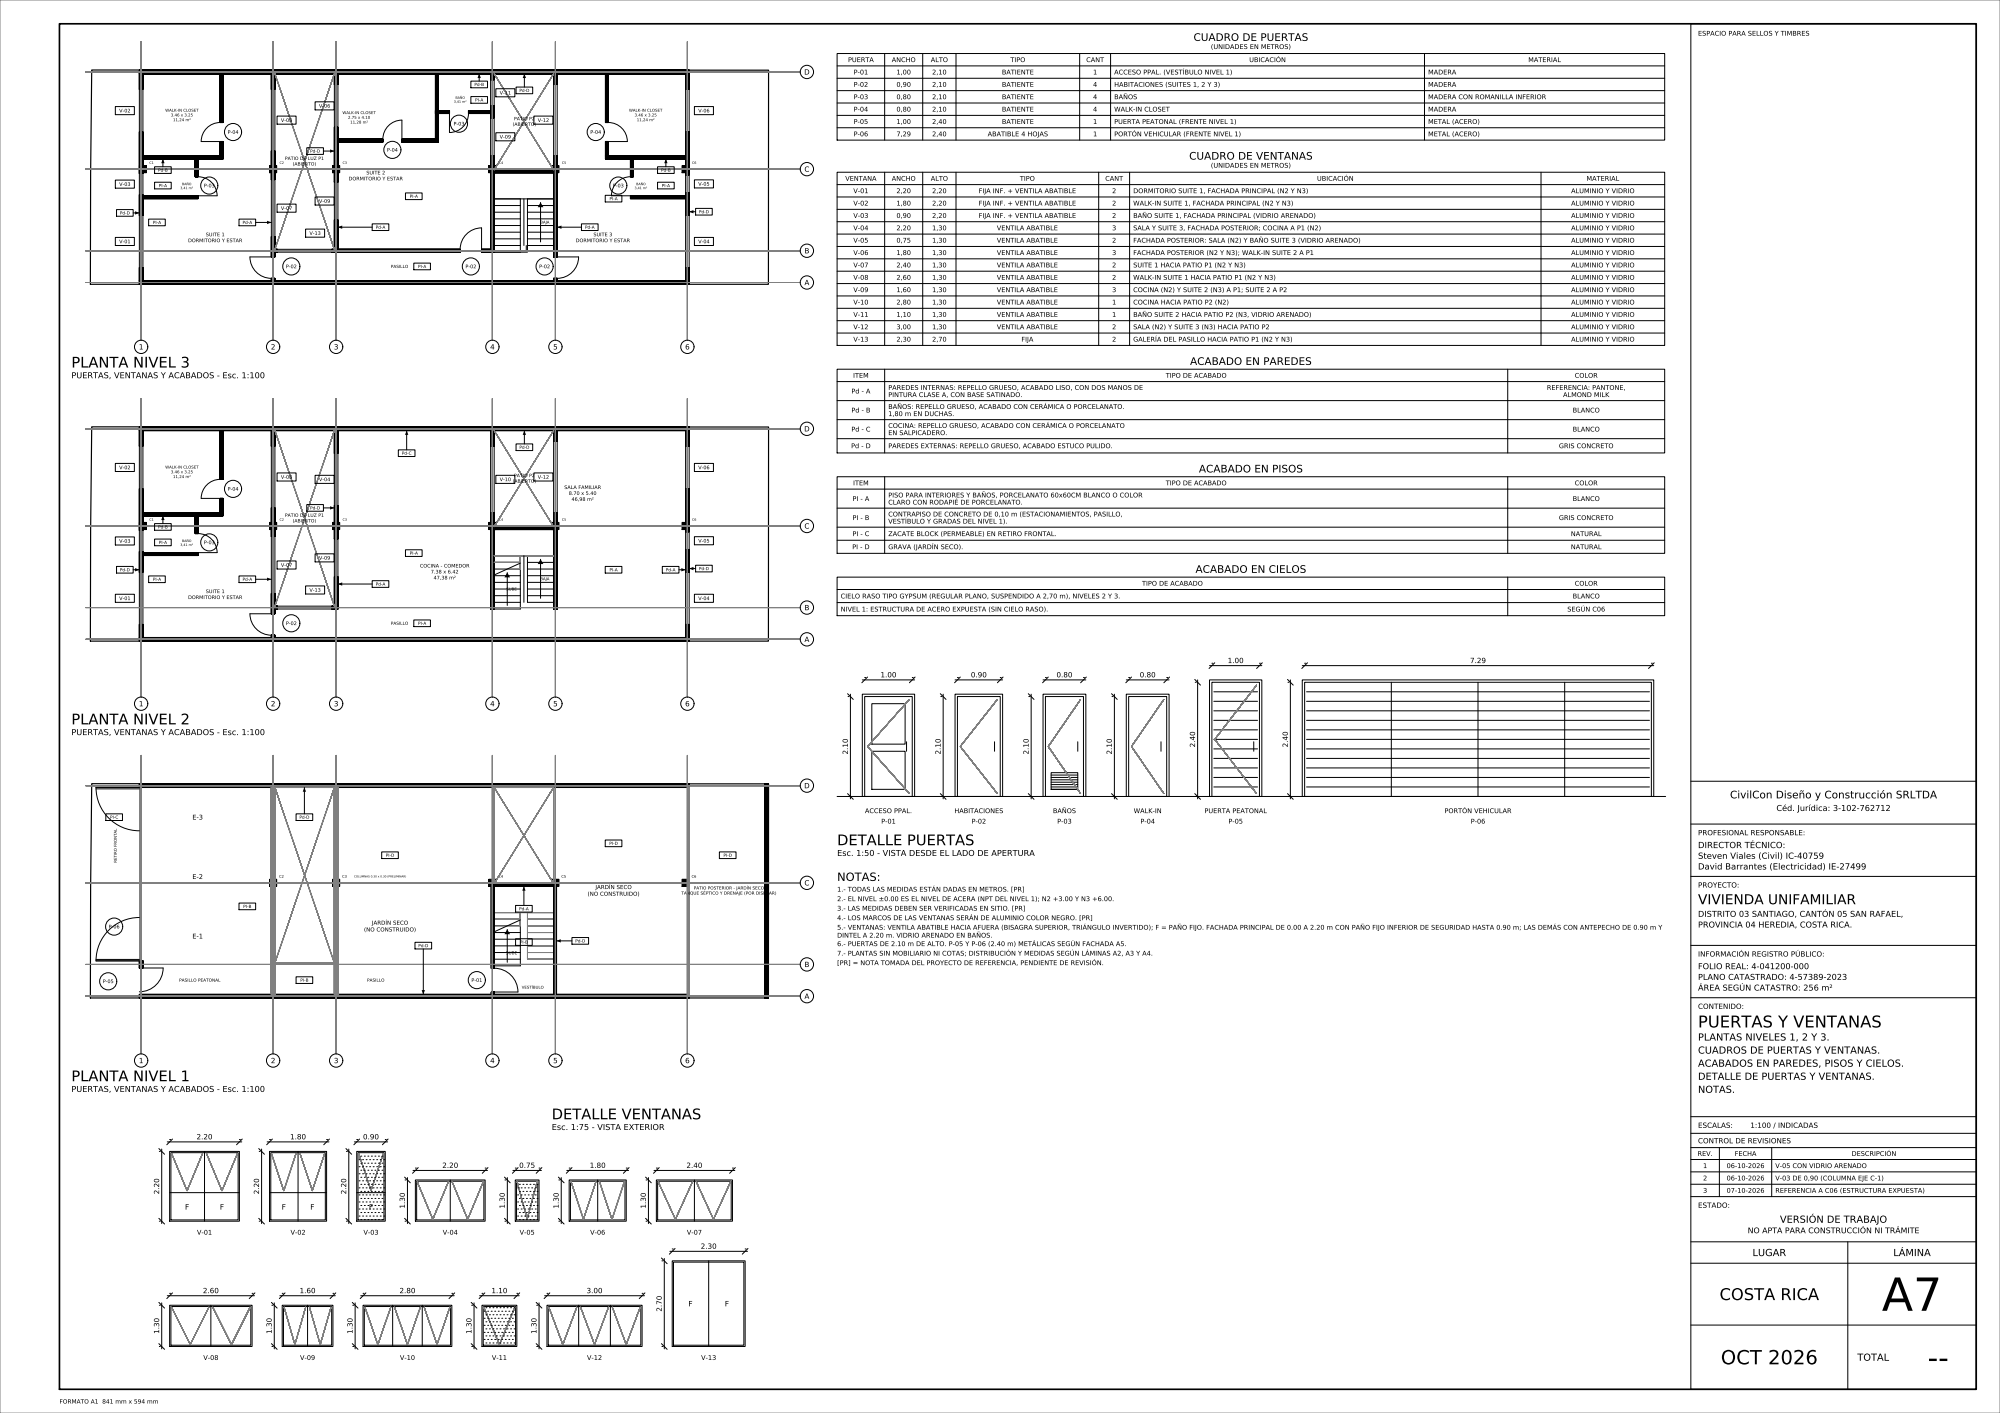
[picture p38: page 1]
