jbarra777/jbarra777/planos/C04_techo/SR-C04_TECHO_rev2.pdf

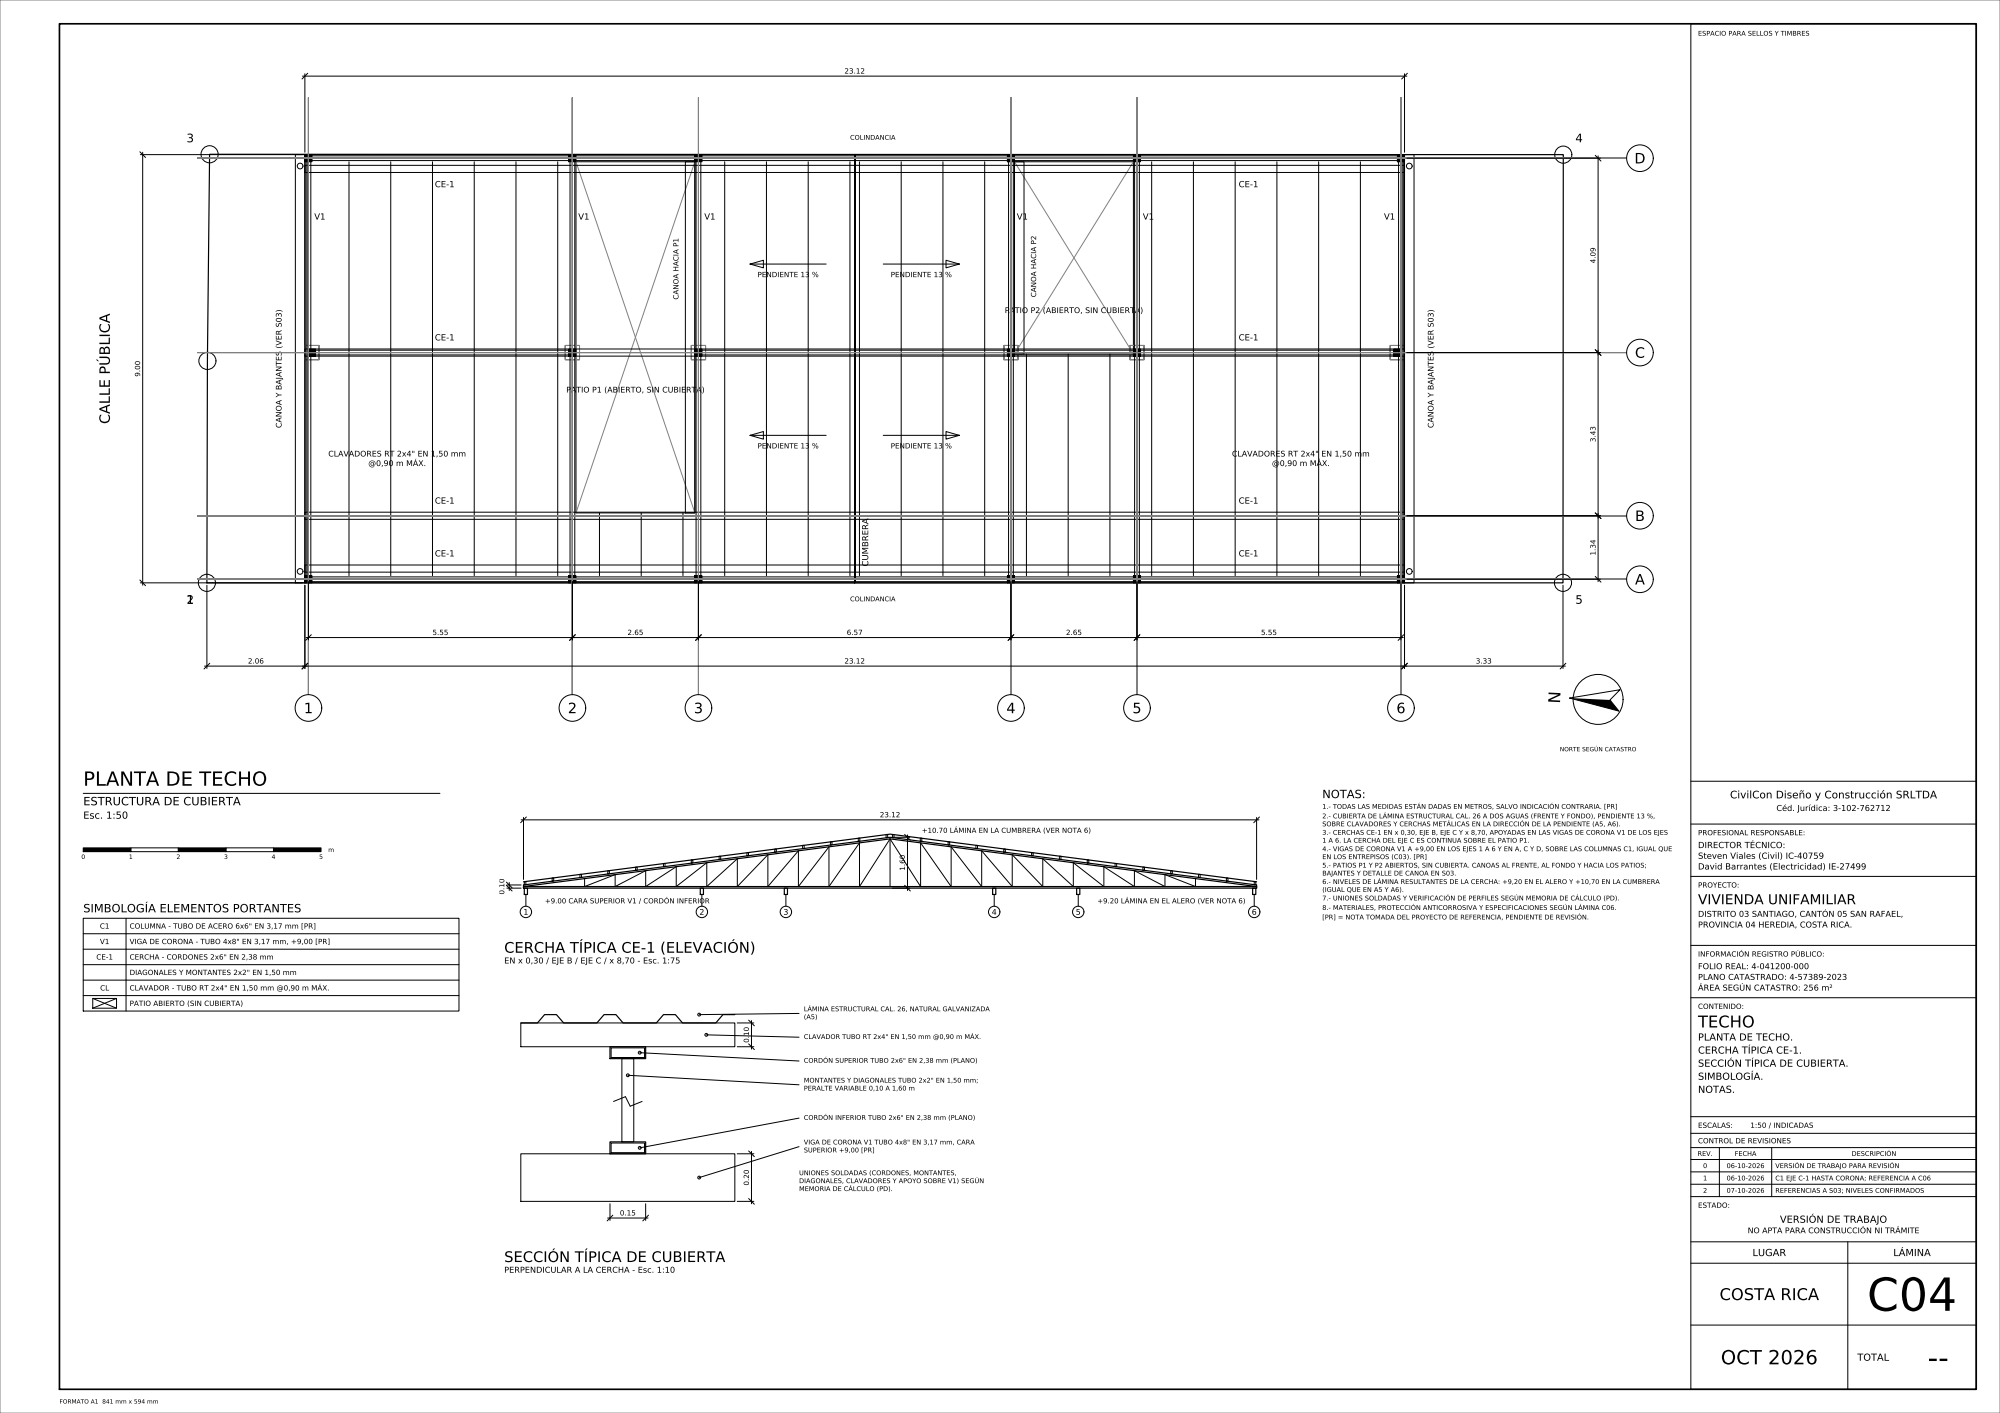
[picture p39: page 1]
