jbarra777/jbarra777/planos/S03_pluviales/SR-S03_PLUVIALES_rev0.pdf

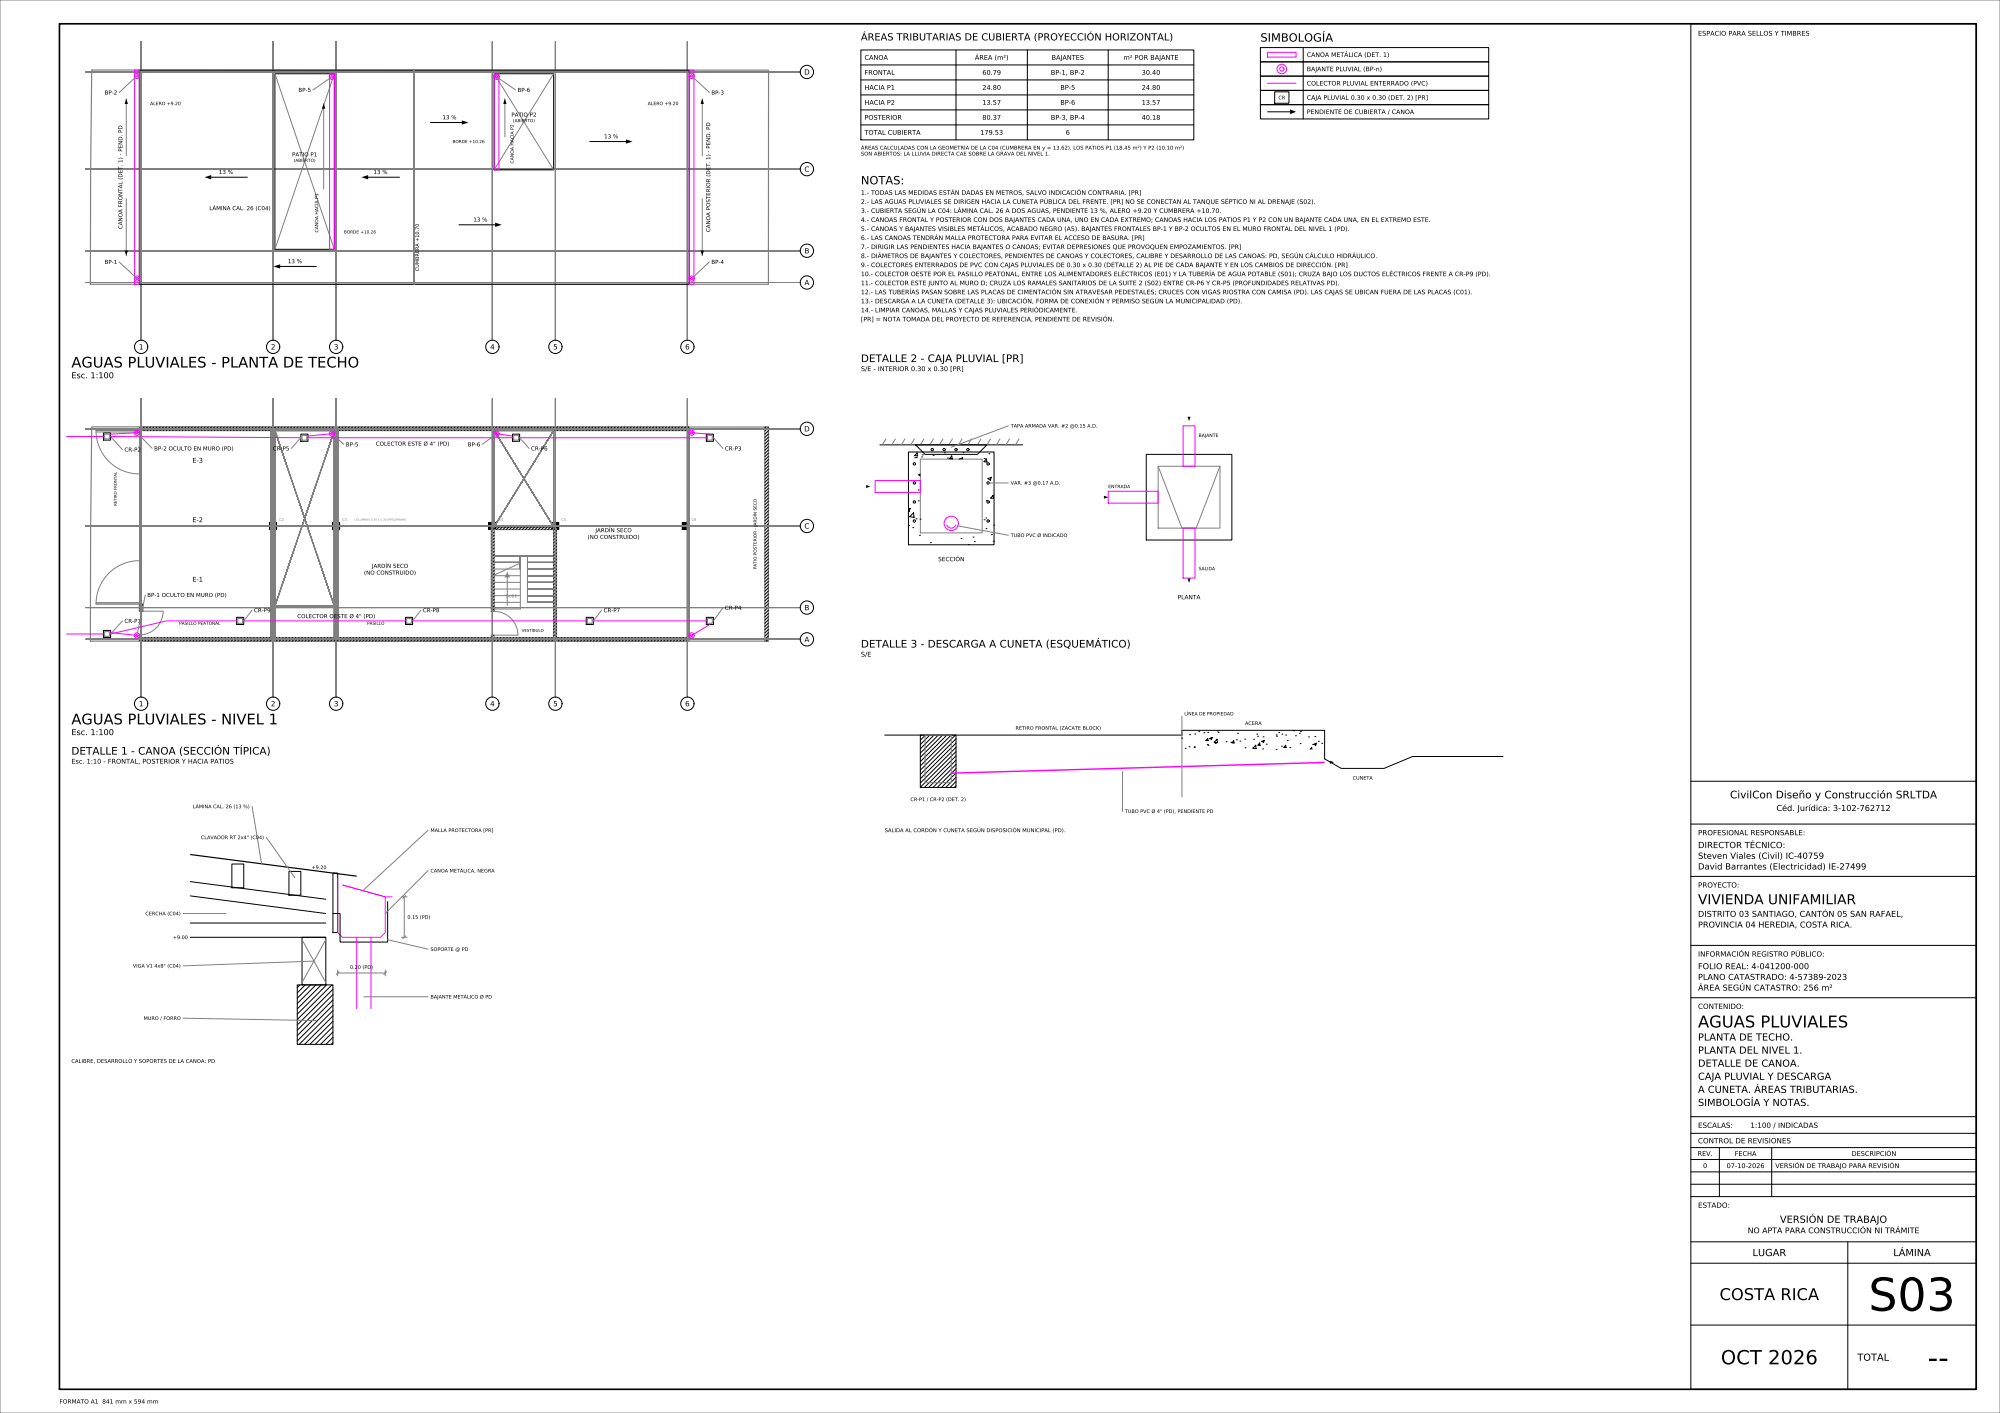
[picture p40: page 1]
