jbarra777/jbarra777/planos/S01_agua_potable/SR-S01_AGUA_POTABLE_rev1.pdf

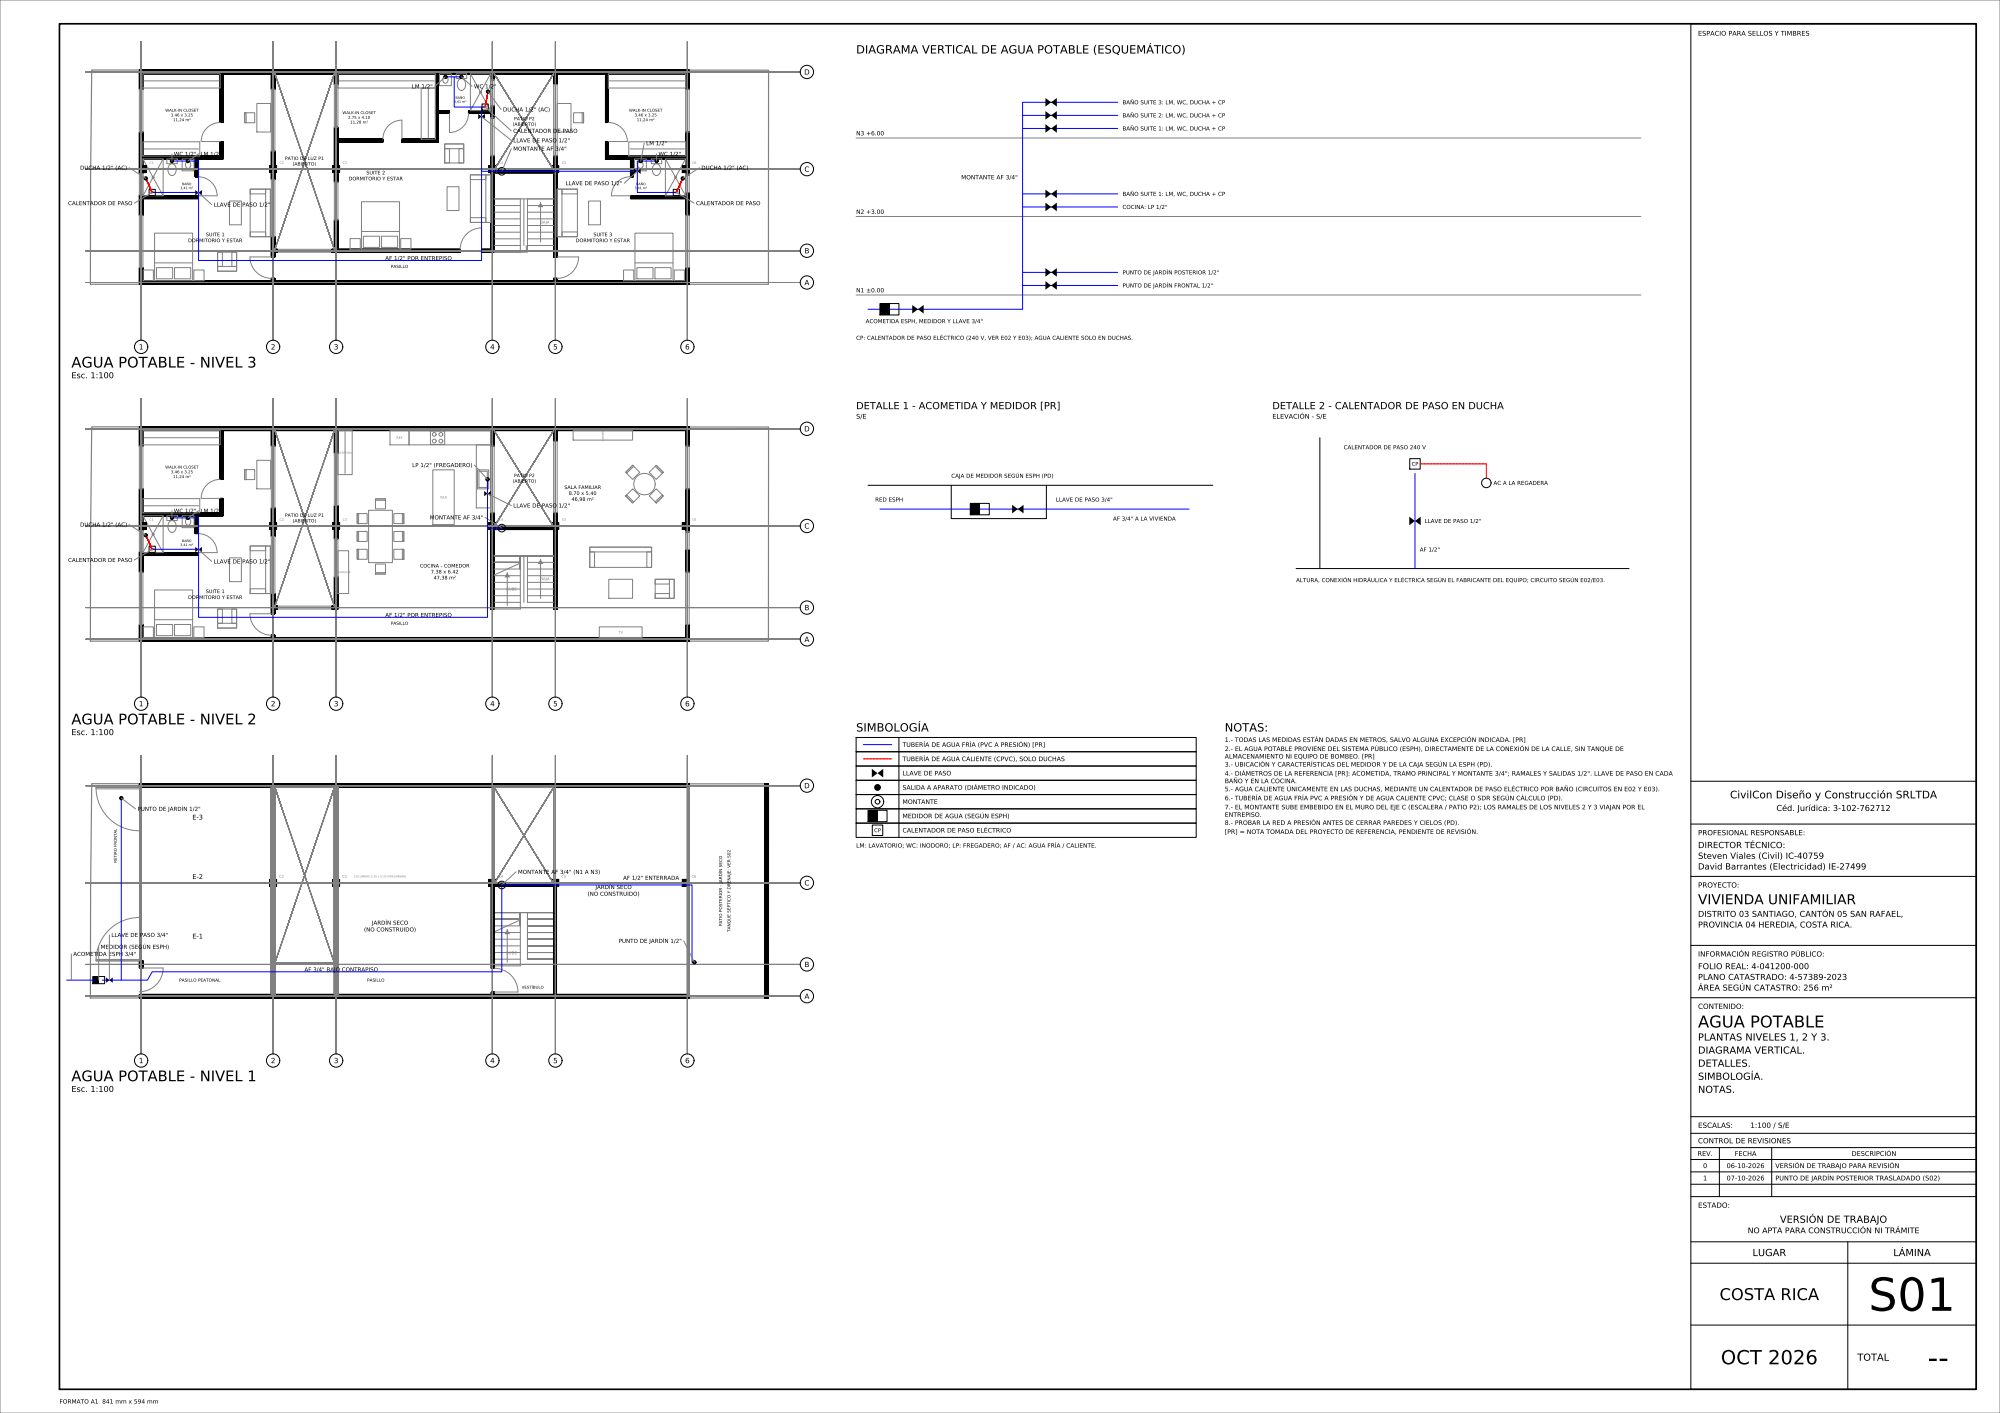
[picture p41: page 1]
