jbarra777/jbarra777/planos/S02_aguas_residuales/SR-S02_AGUAS_RESIDUALES_rev1.pdf

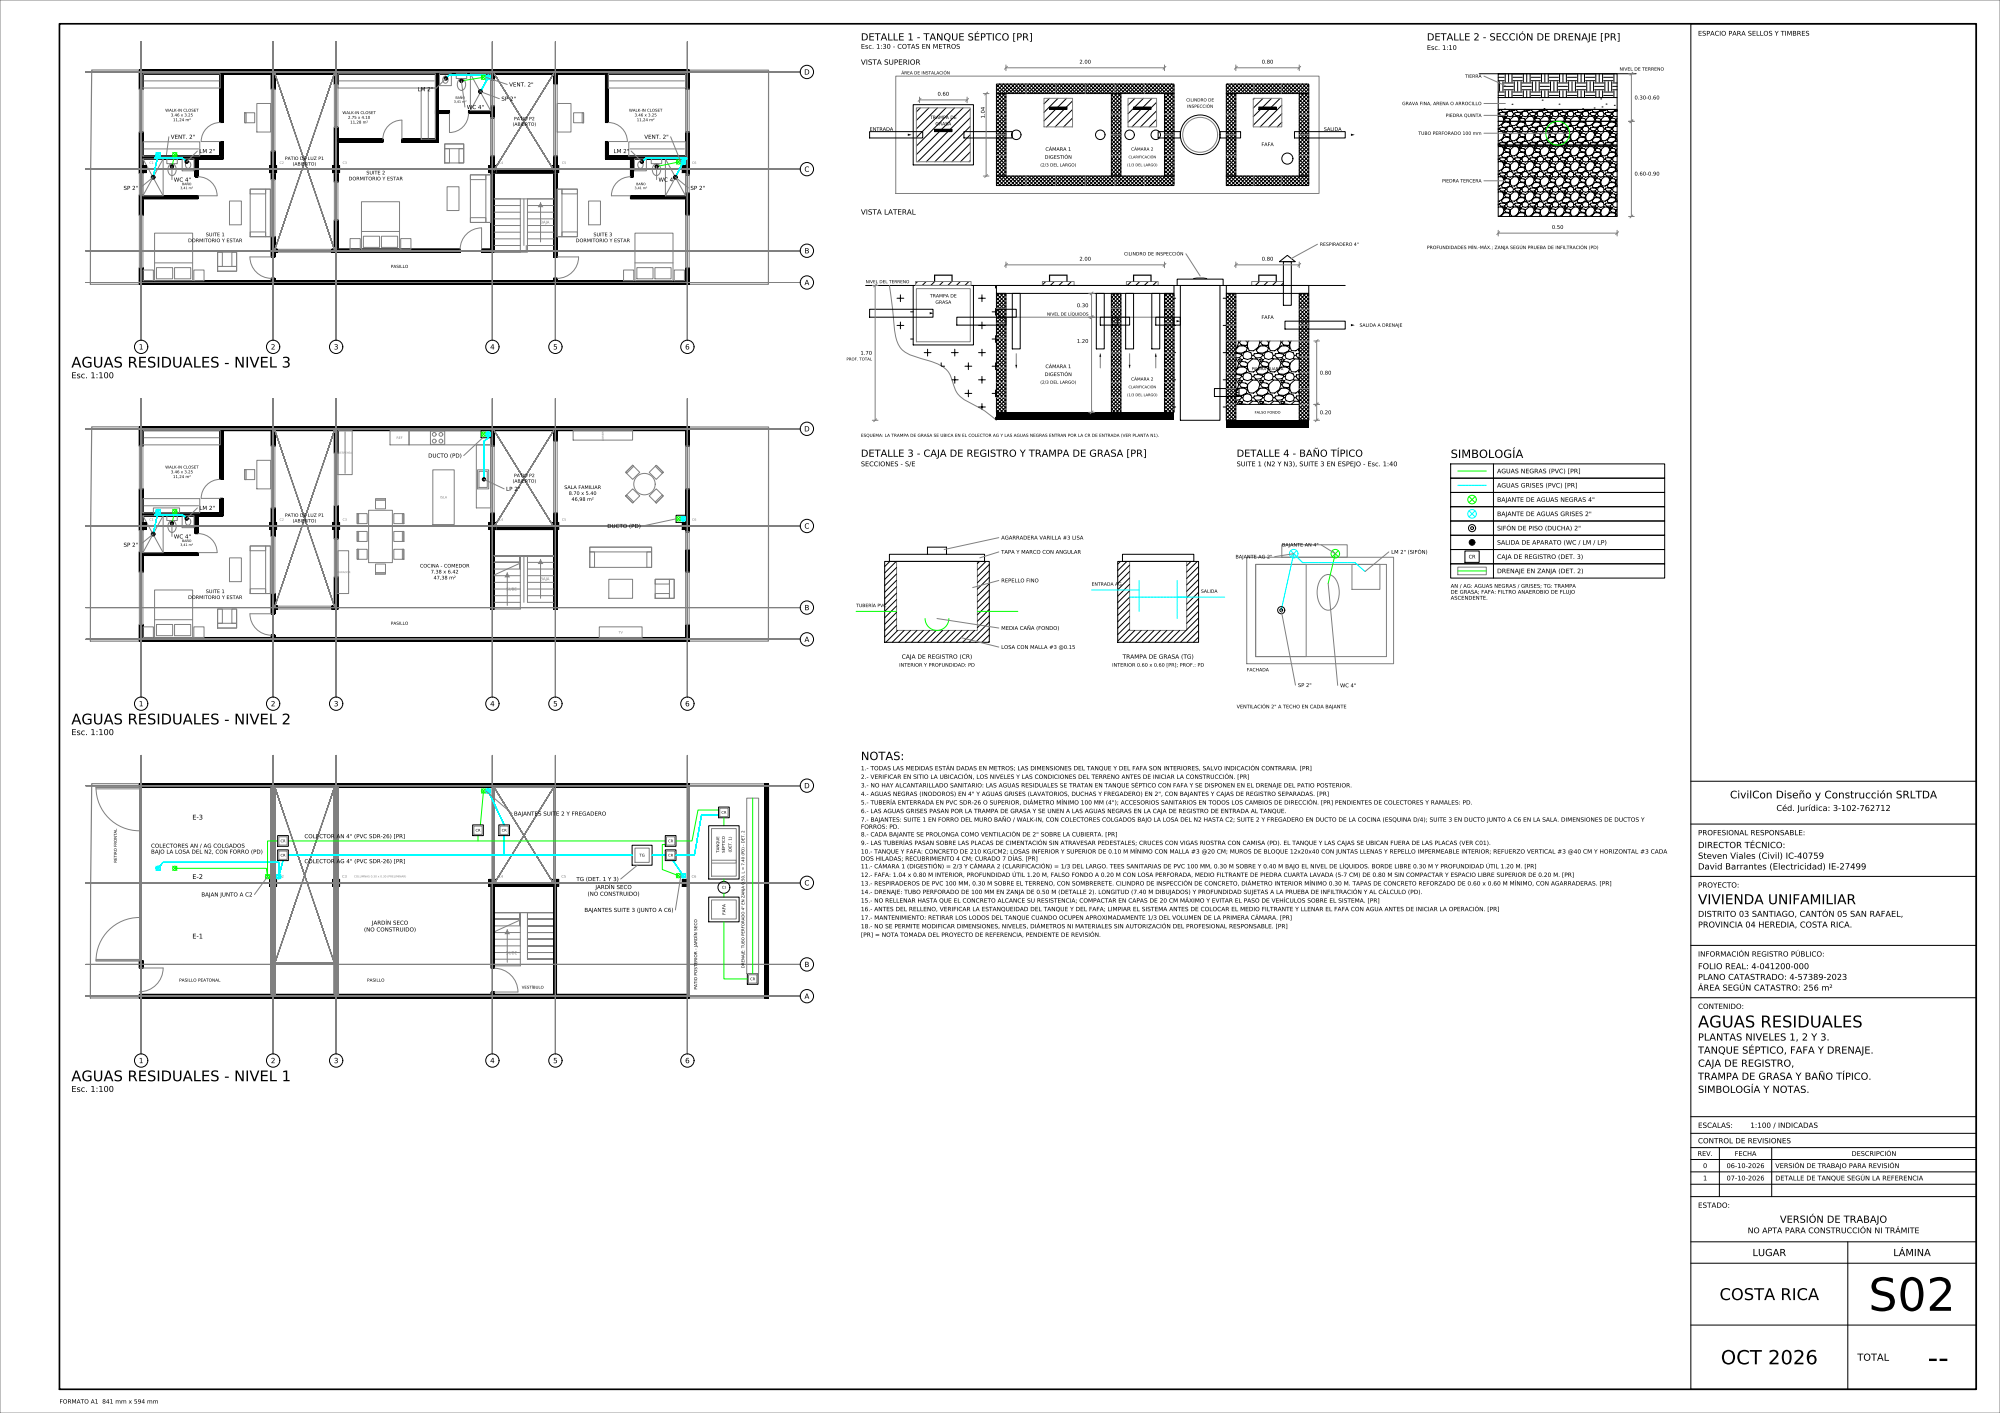
[picture p42: page 1]
