jbarra777/jbarra777/planos/S02_aguas_residuales/SR-S02_AGUAS_RESIDUALES_rev0.pdf

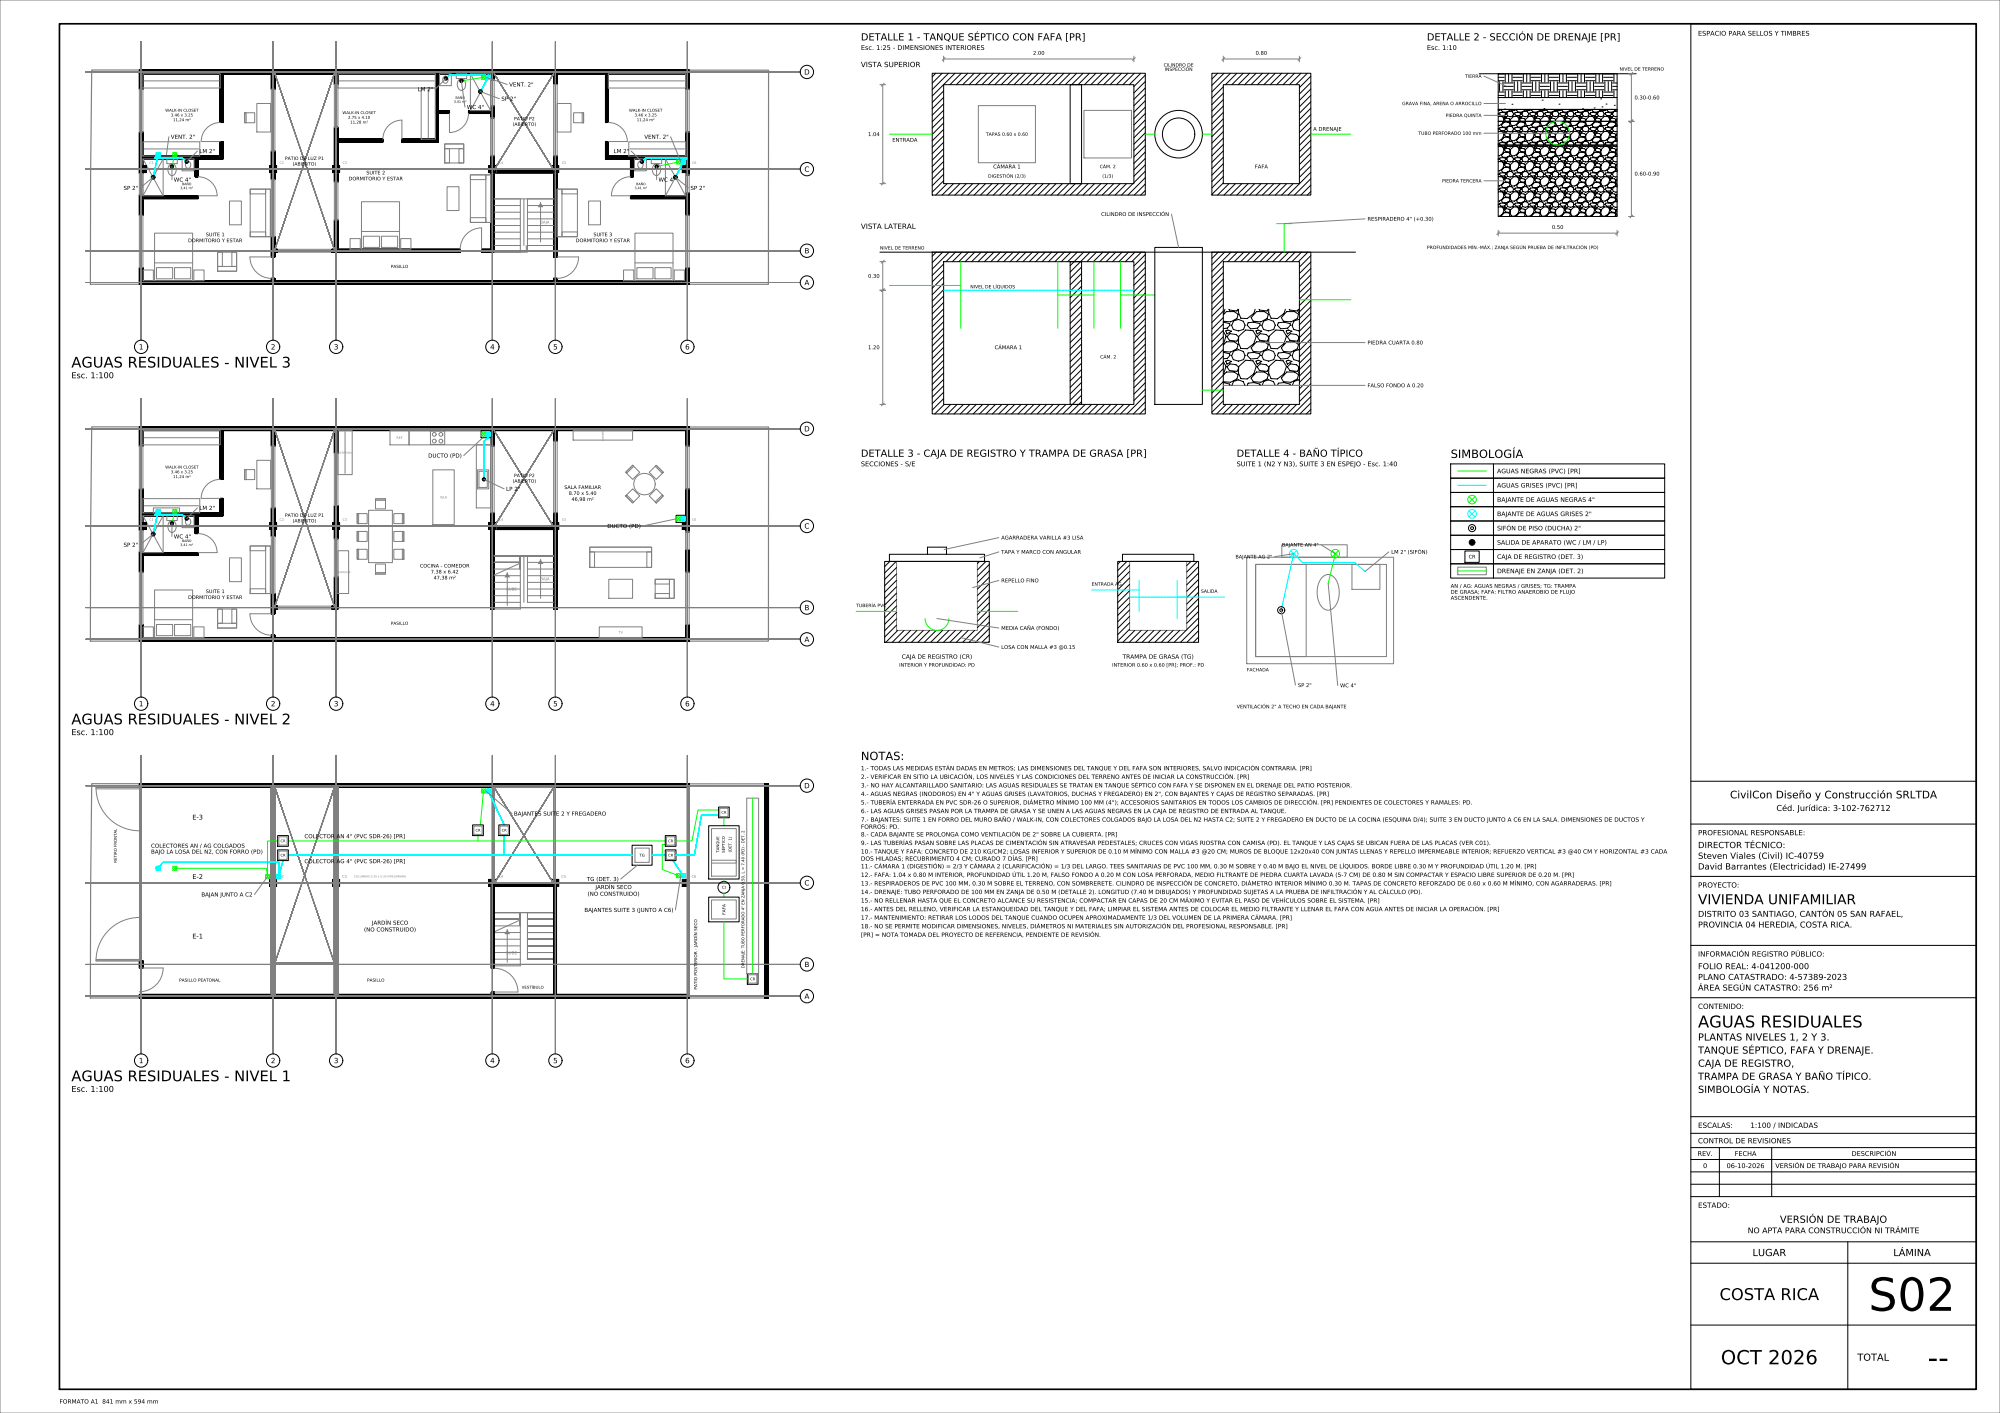
[picture p43: page 1]
