jbarra777/jbarra777/planos/S01_agua_potable/SR-S01_AGUA_POTABLE_rev0.pdf

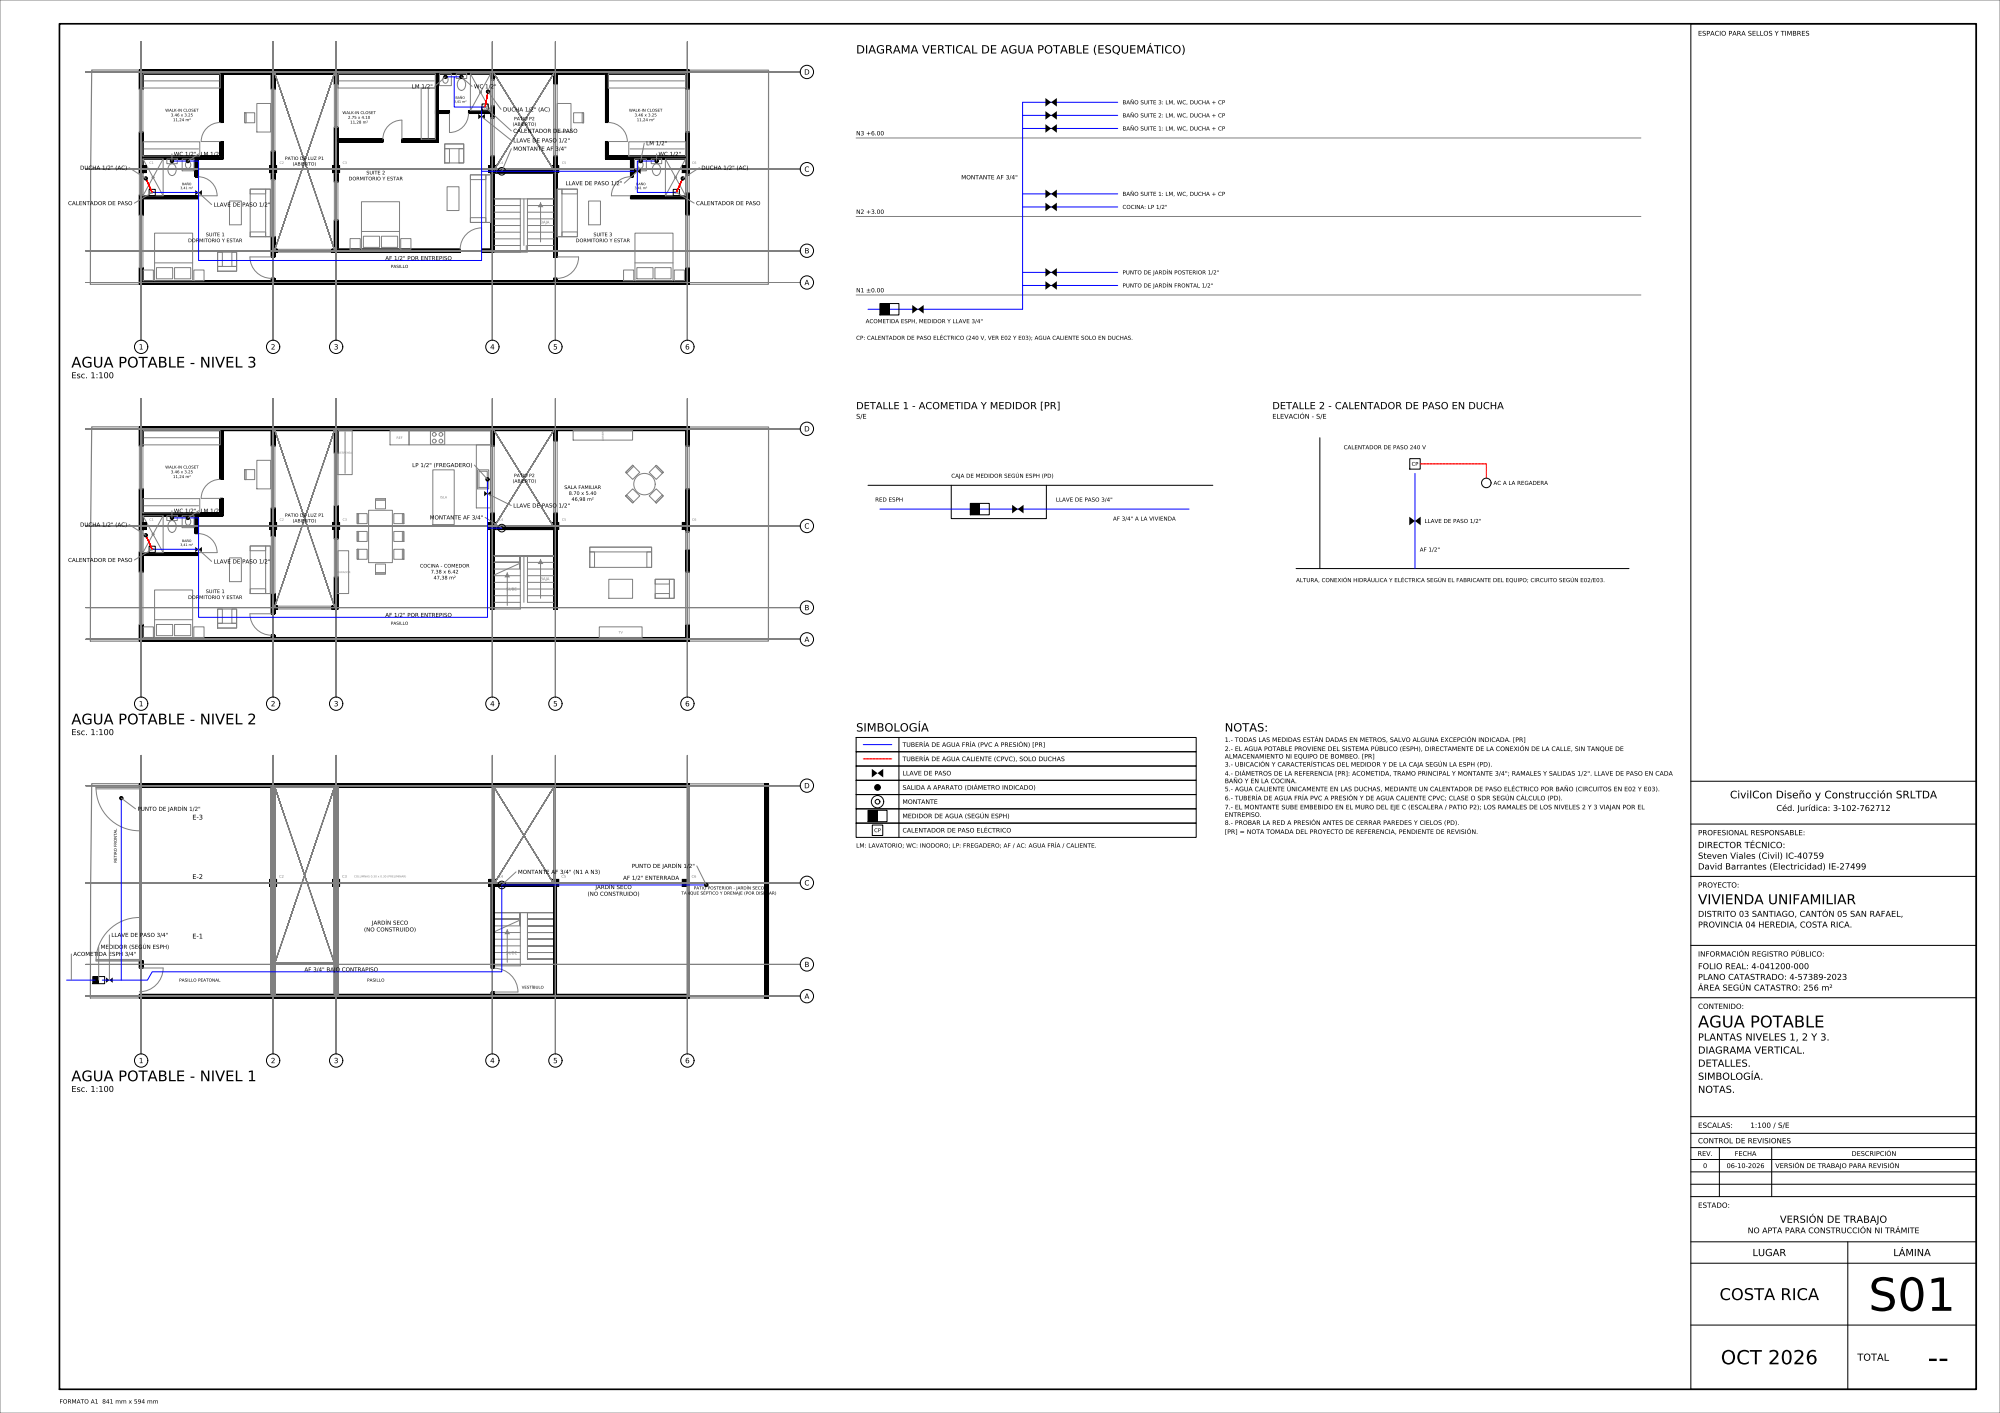
[picture p44: page 1]
