jbarra777/jbarra777/planos/E05_detalles/SR-E05_DETALLES_rev0.pdf

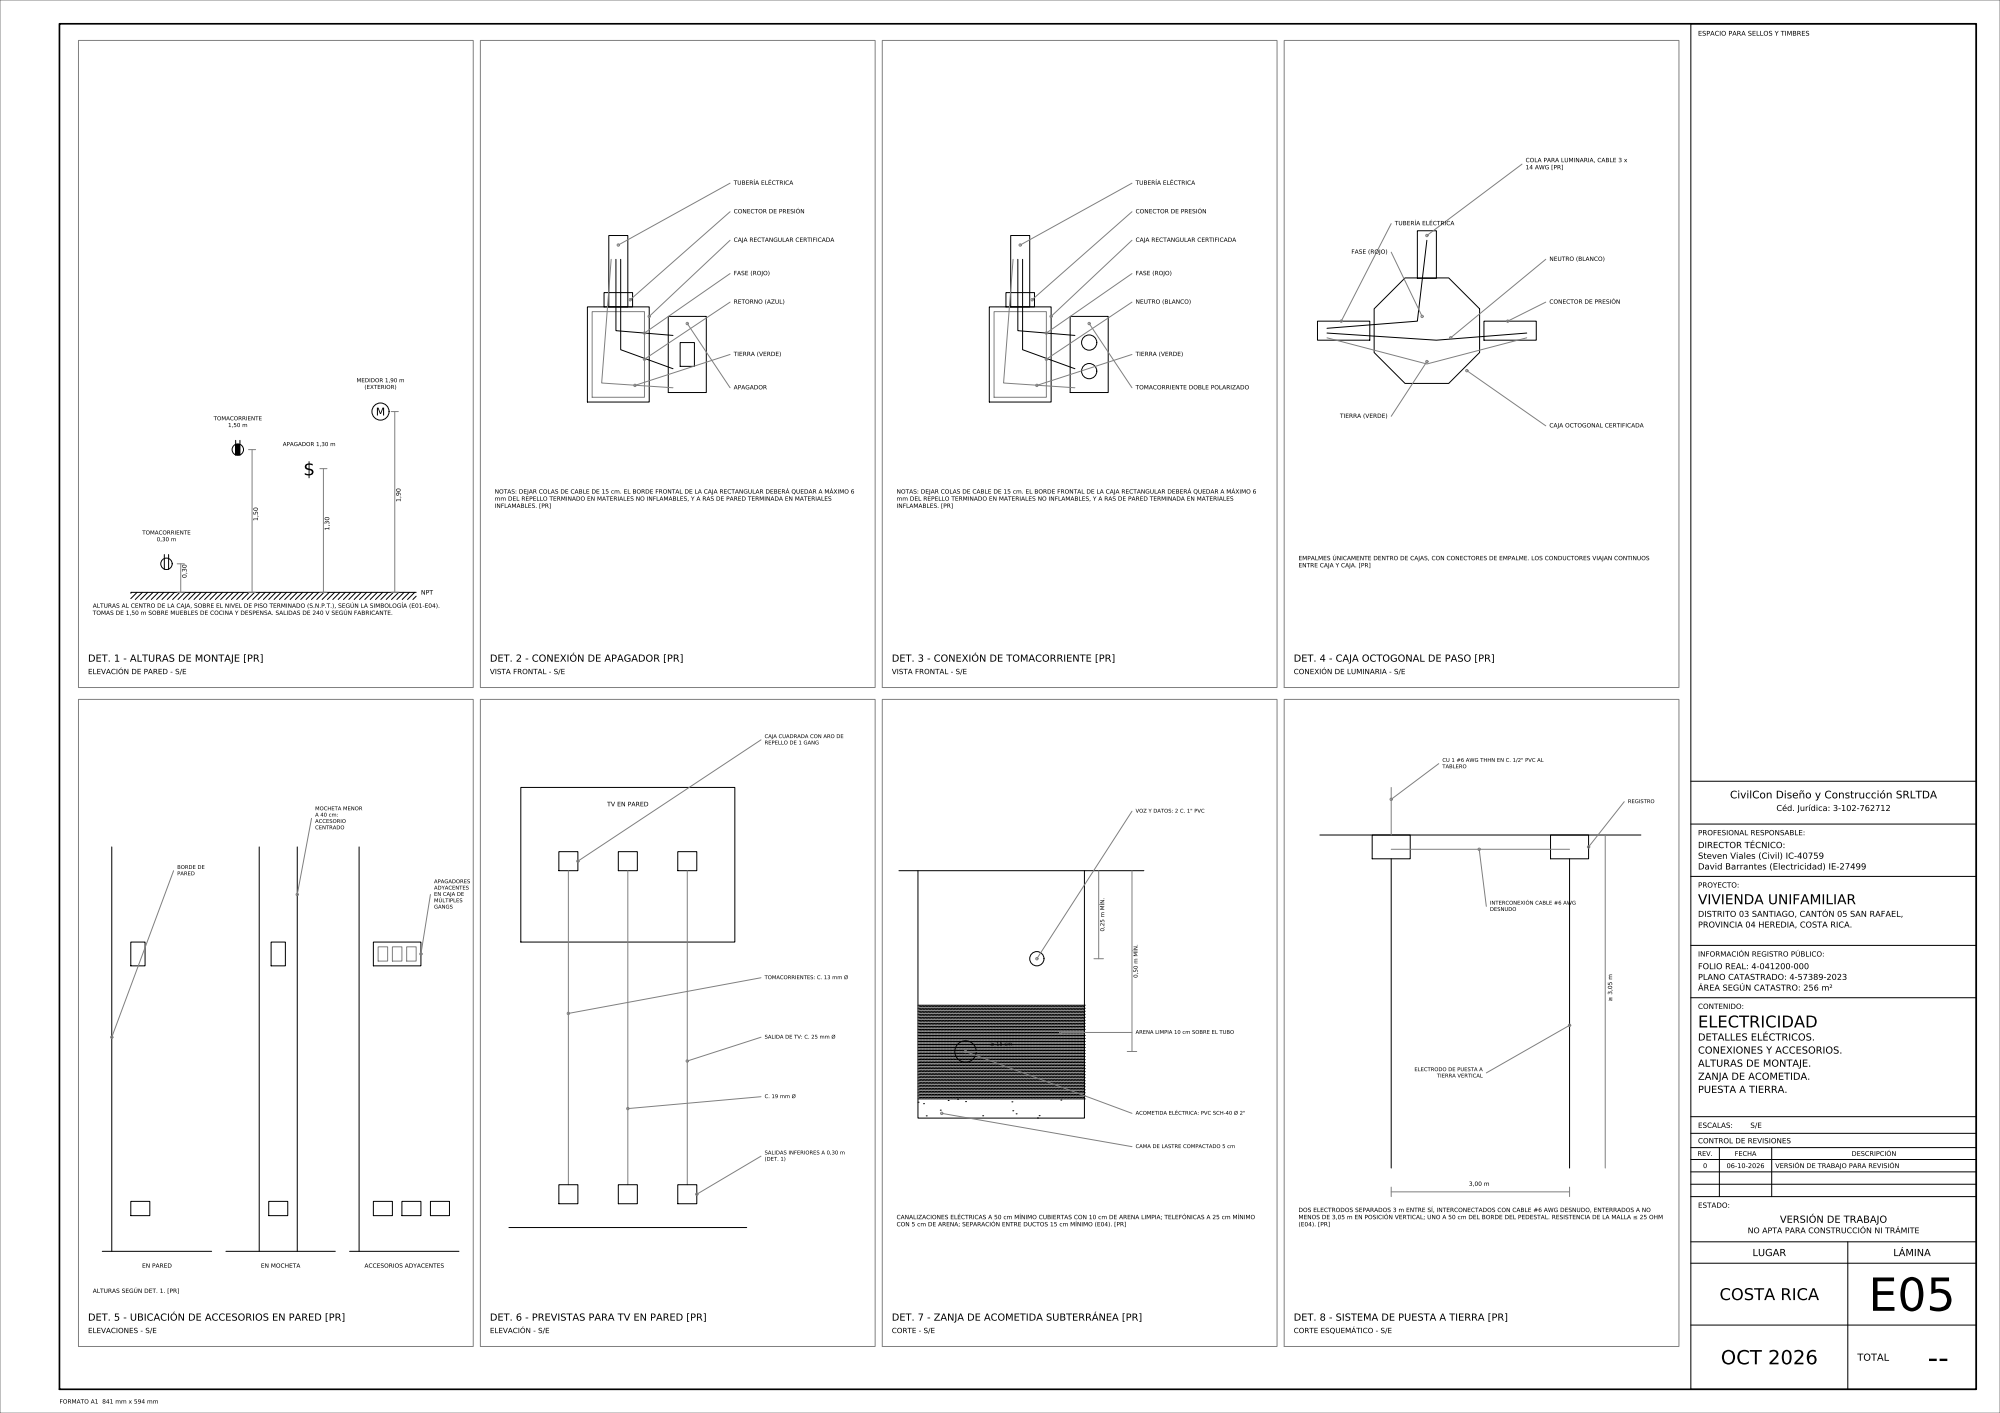
[picture p45: page 1]
