jbarra777/jbarra777/planos/E04_tableros/SR-E04_TABLEROS_rev0.pdf

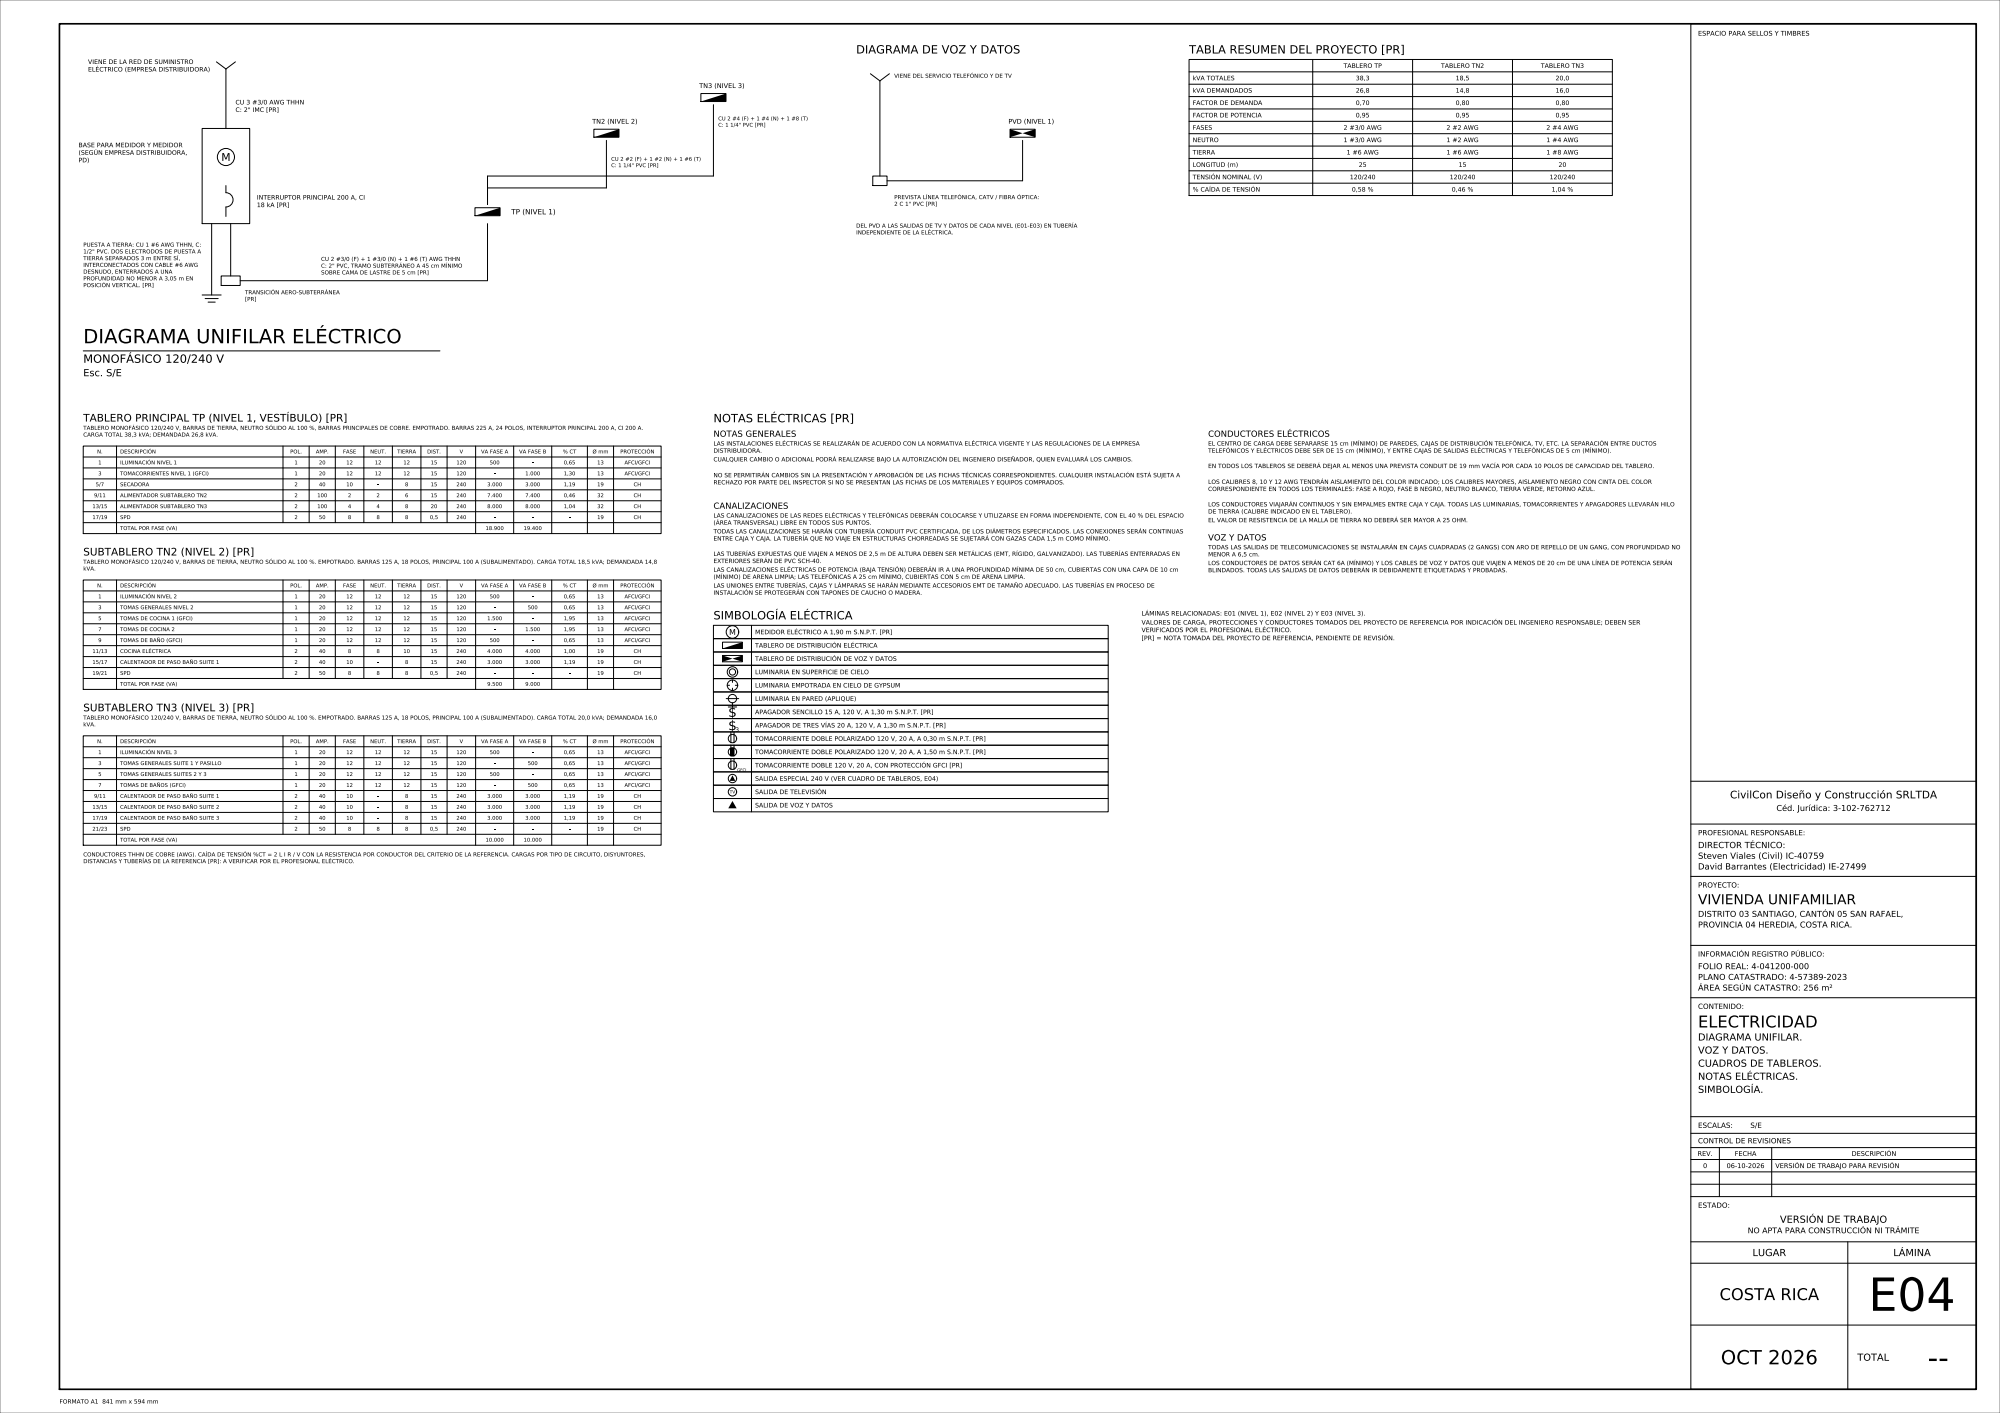
[picture p46: page 1]
