jbarra777/jbarra777/planos/E03_nivel3/SR-E03_NIVEL3_rev0.pdf

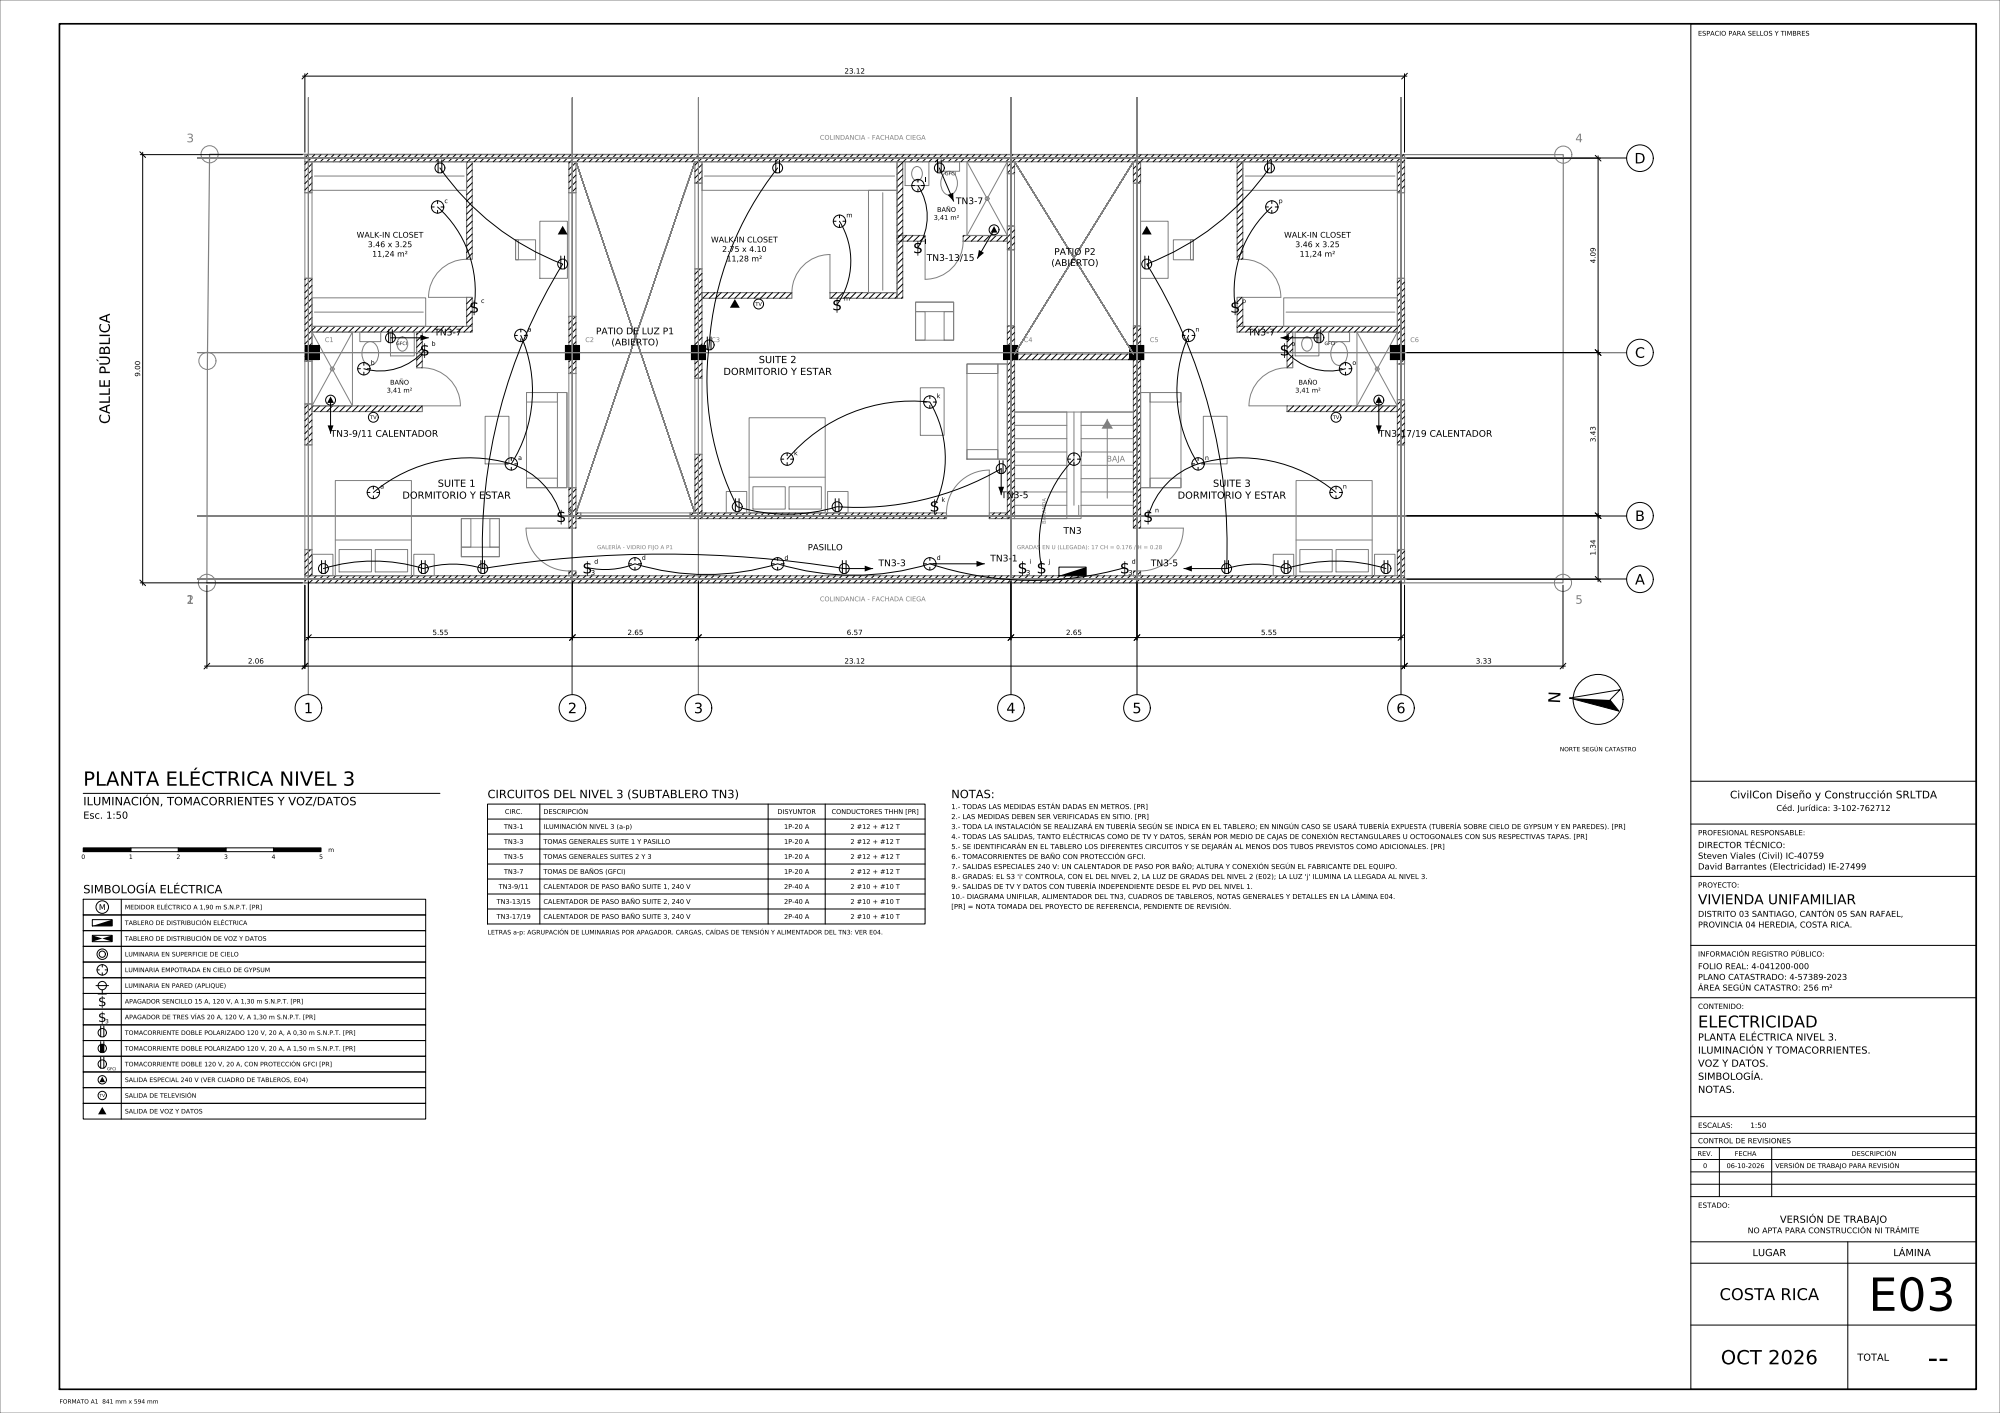
[picture p47: page 1]
