jbarra777/jbarra777/planos/E01_nivel1/SR-E01_NIVEL1_rev1.pdf

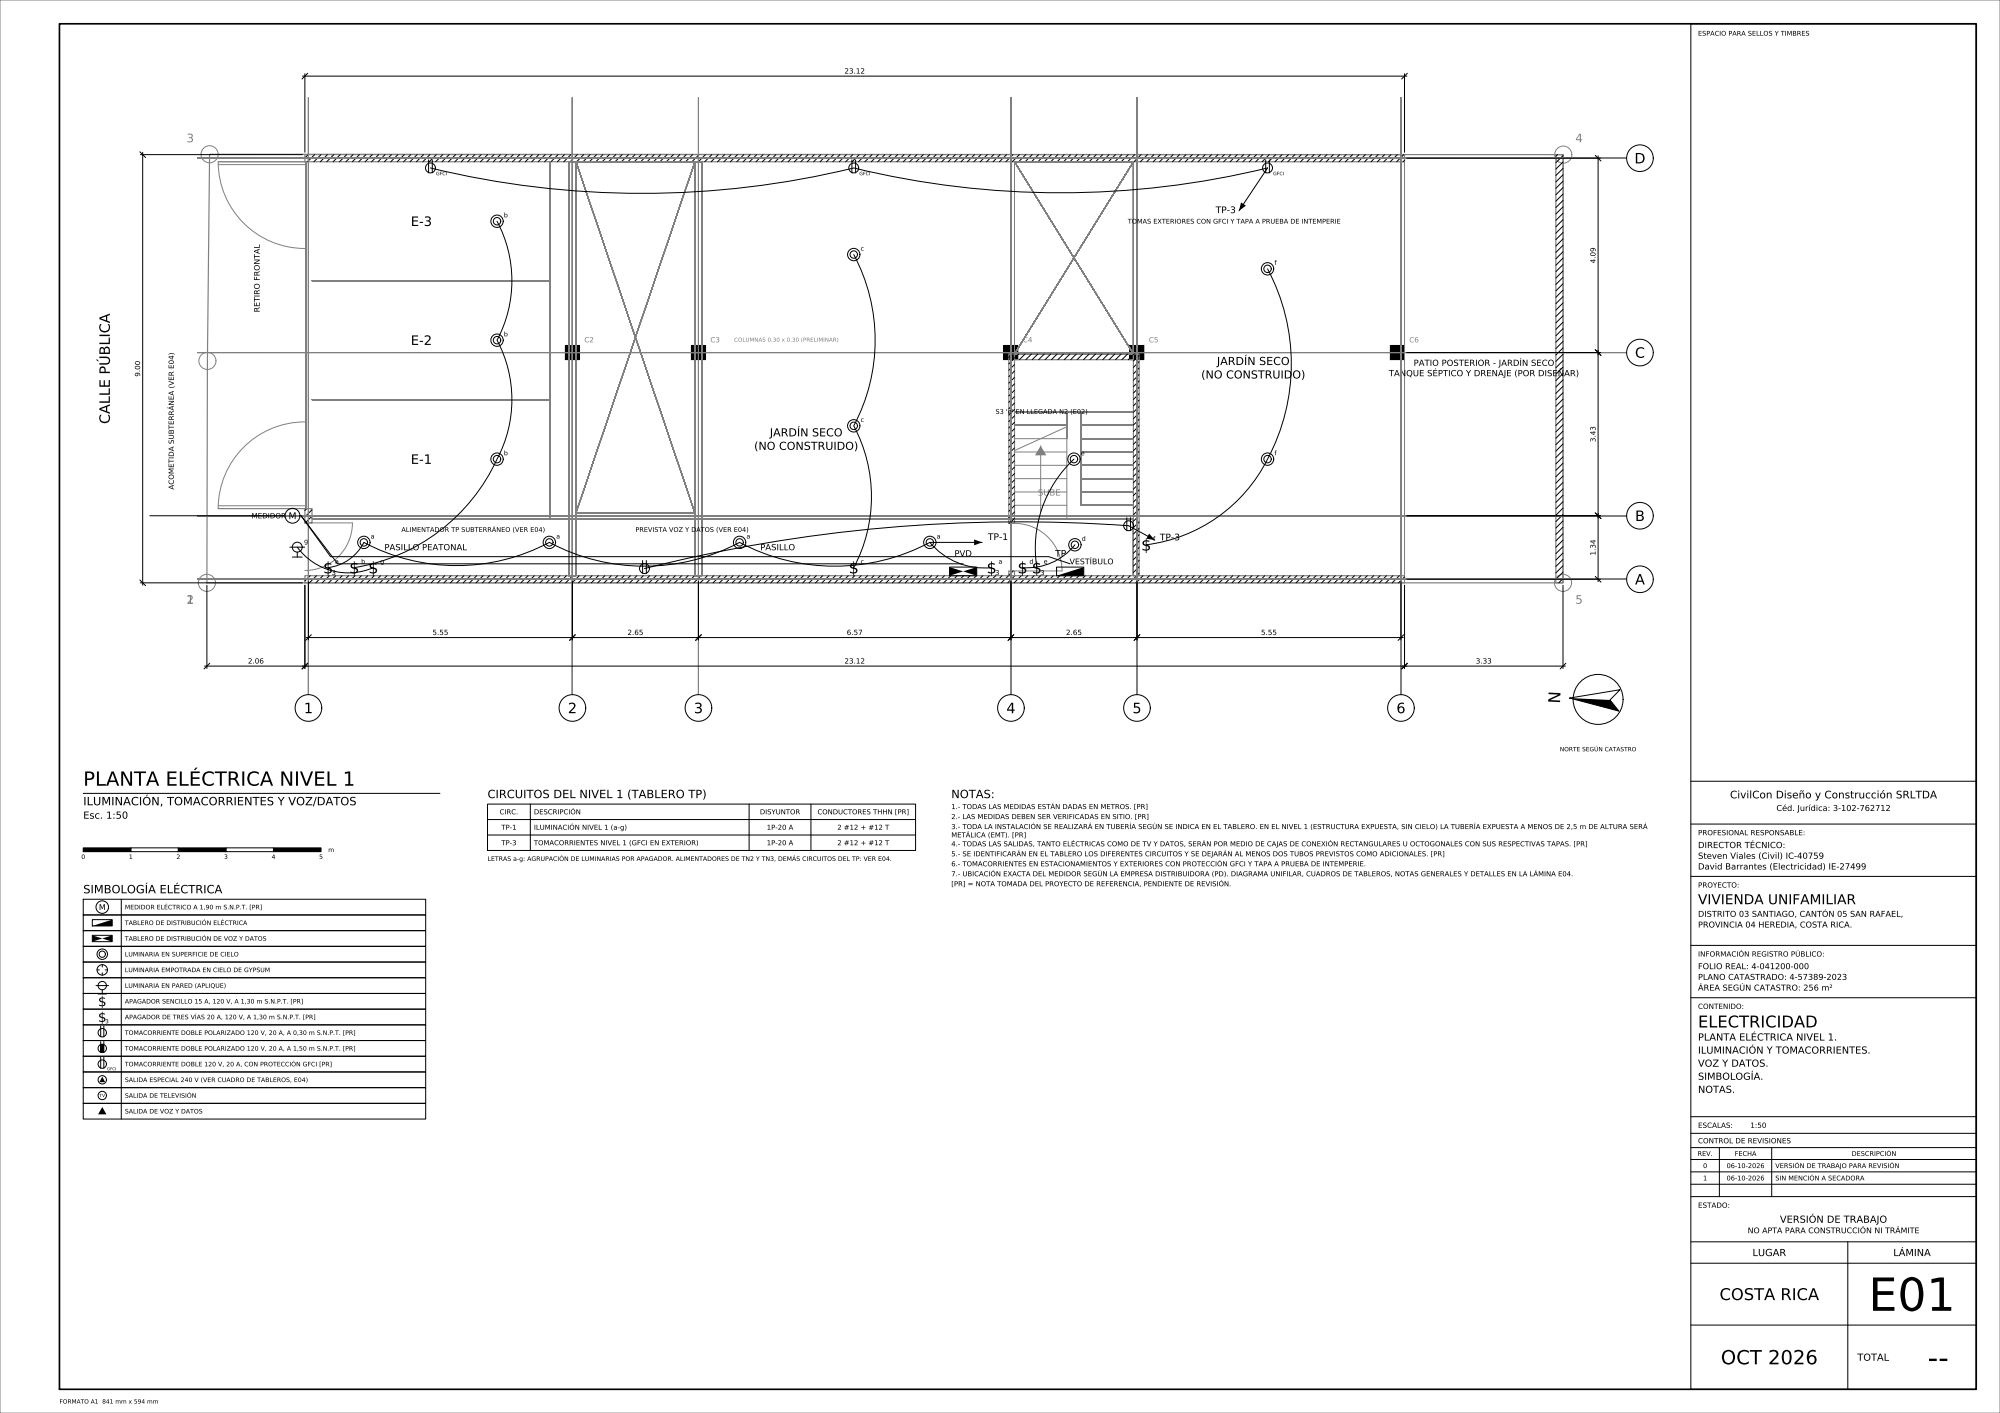
[picture p48: page 1]
