jbarra777/jbarra777/planos/E02_nivel2/SR-E02_NIVEL2_rev0.pdf

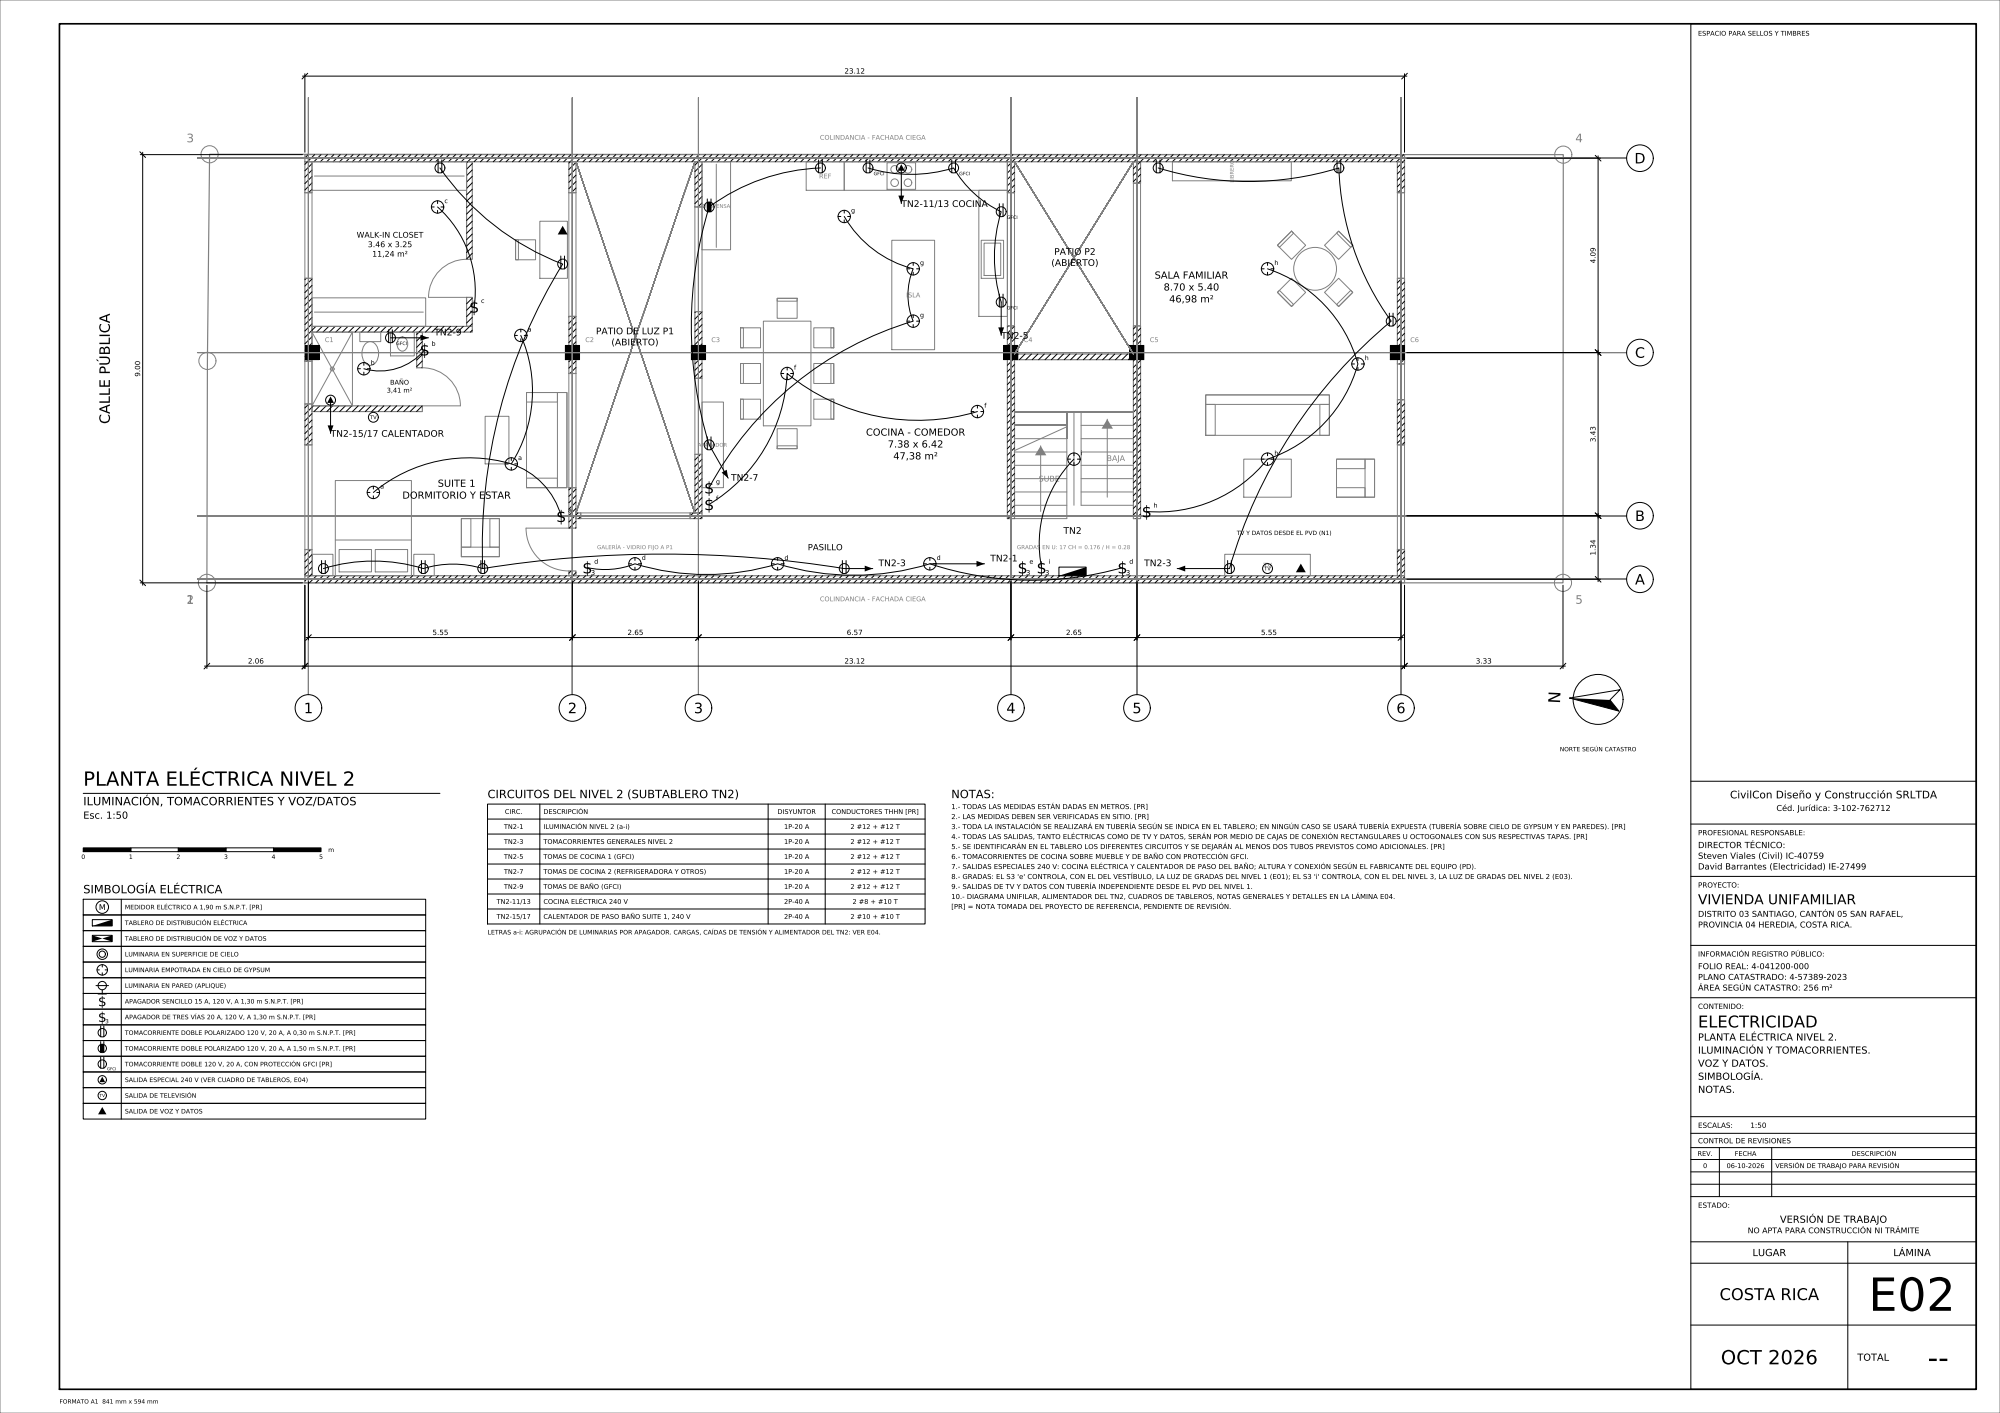
[picture p49: page 1]
