jbarra777/jbarra777/planos/E01_nivel1/SR-E01_NIVEL1_rev0.pdf

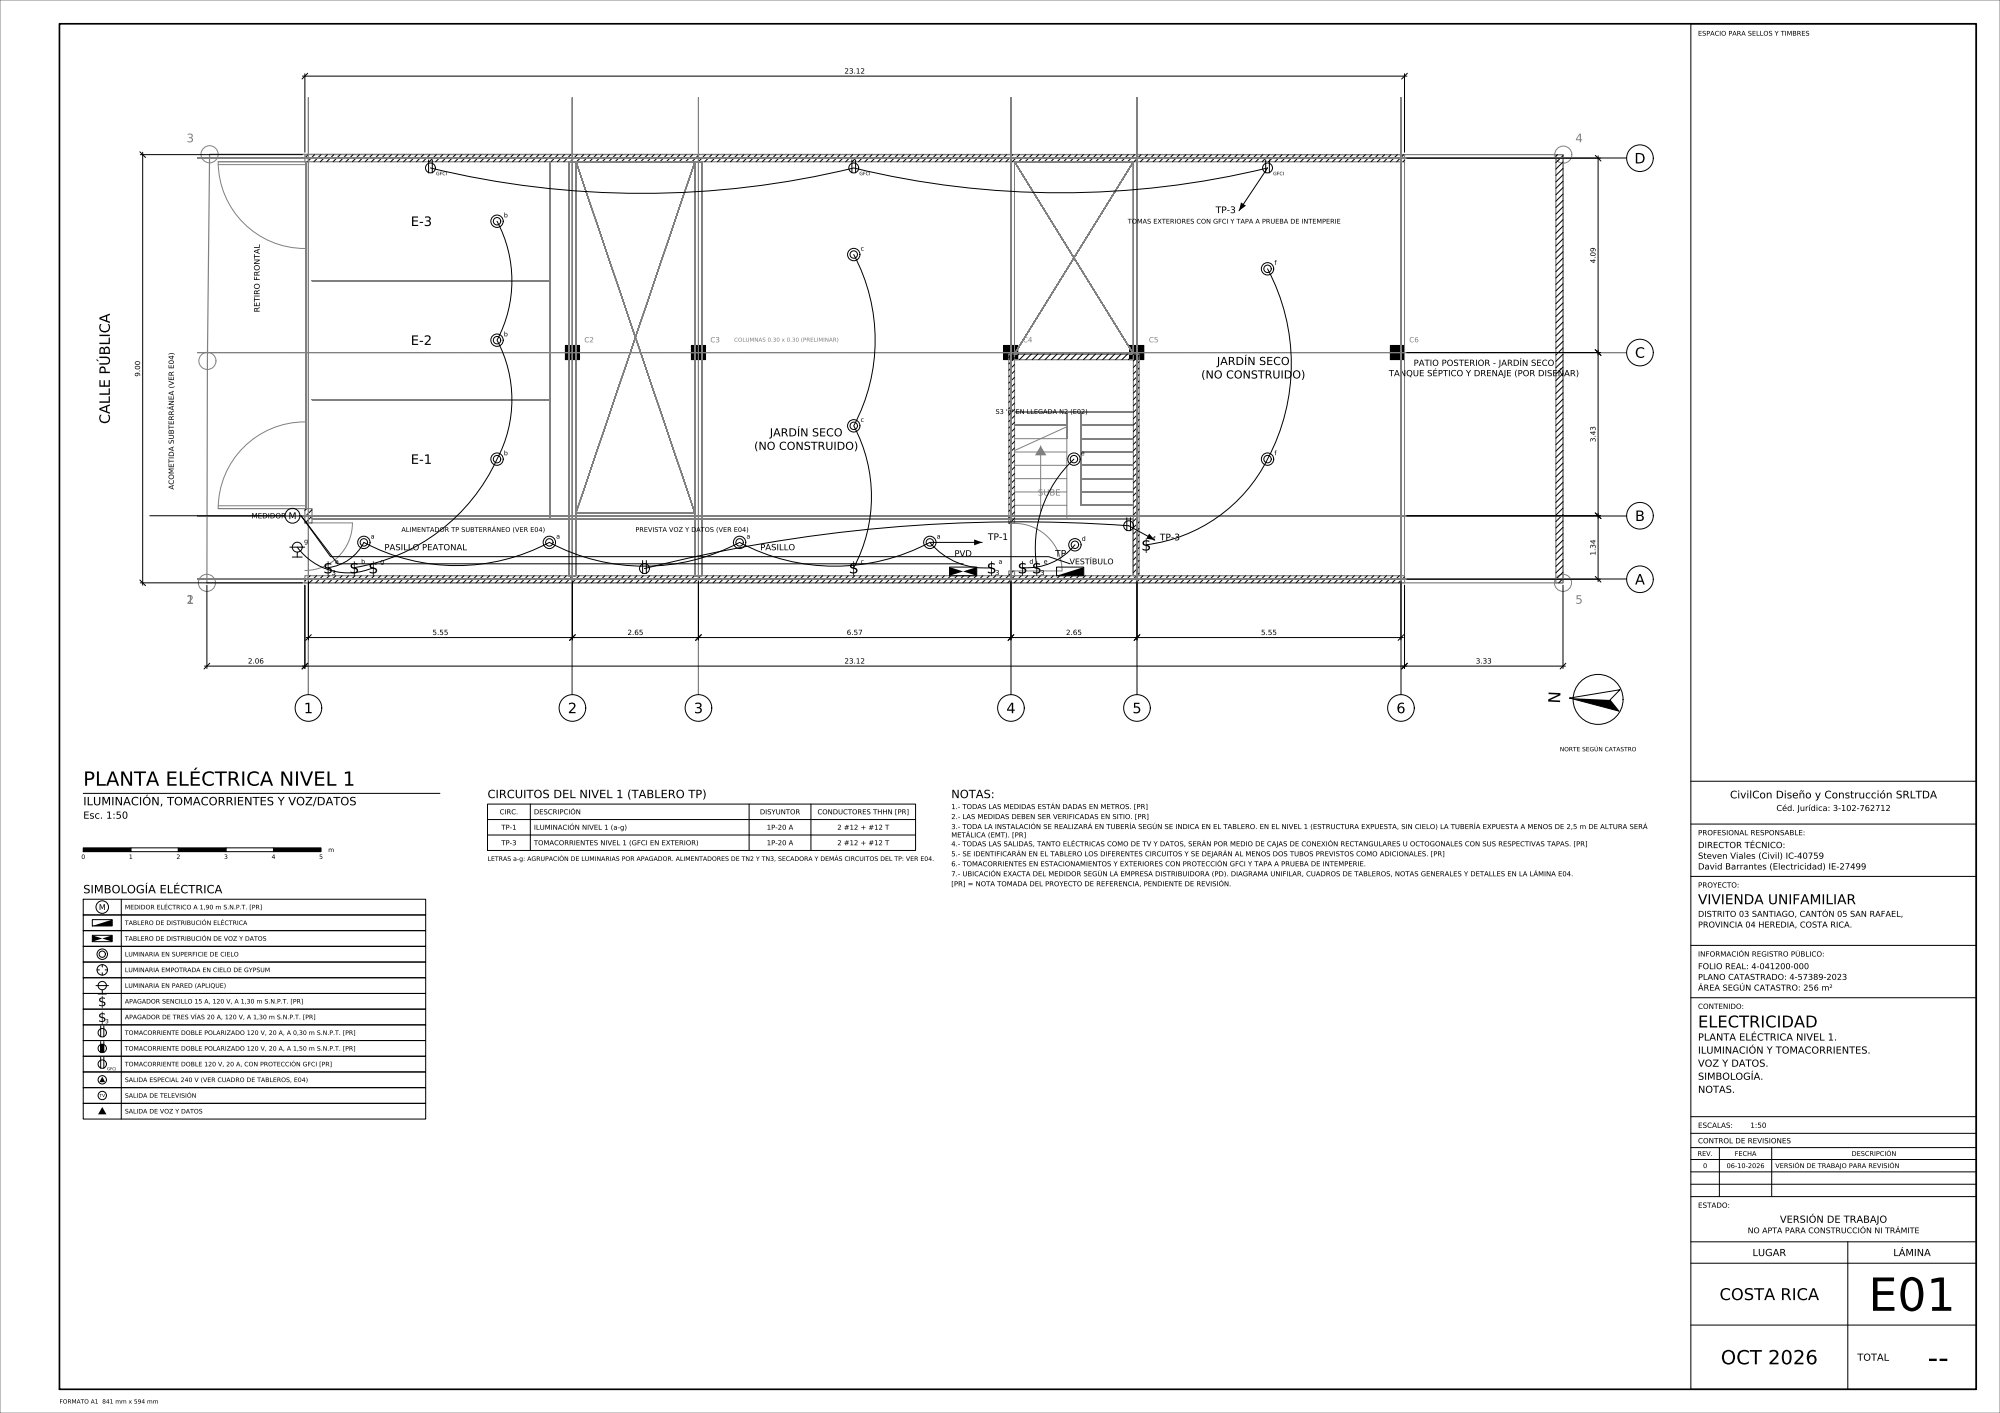
[picture p50: page 1]
