jbarra777/jbarra777/planos/A3_nivel2/SR-A3_NIVEL2_rev4.pdf

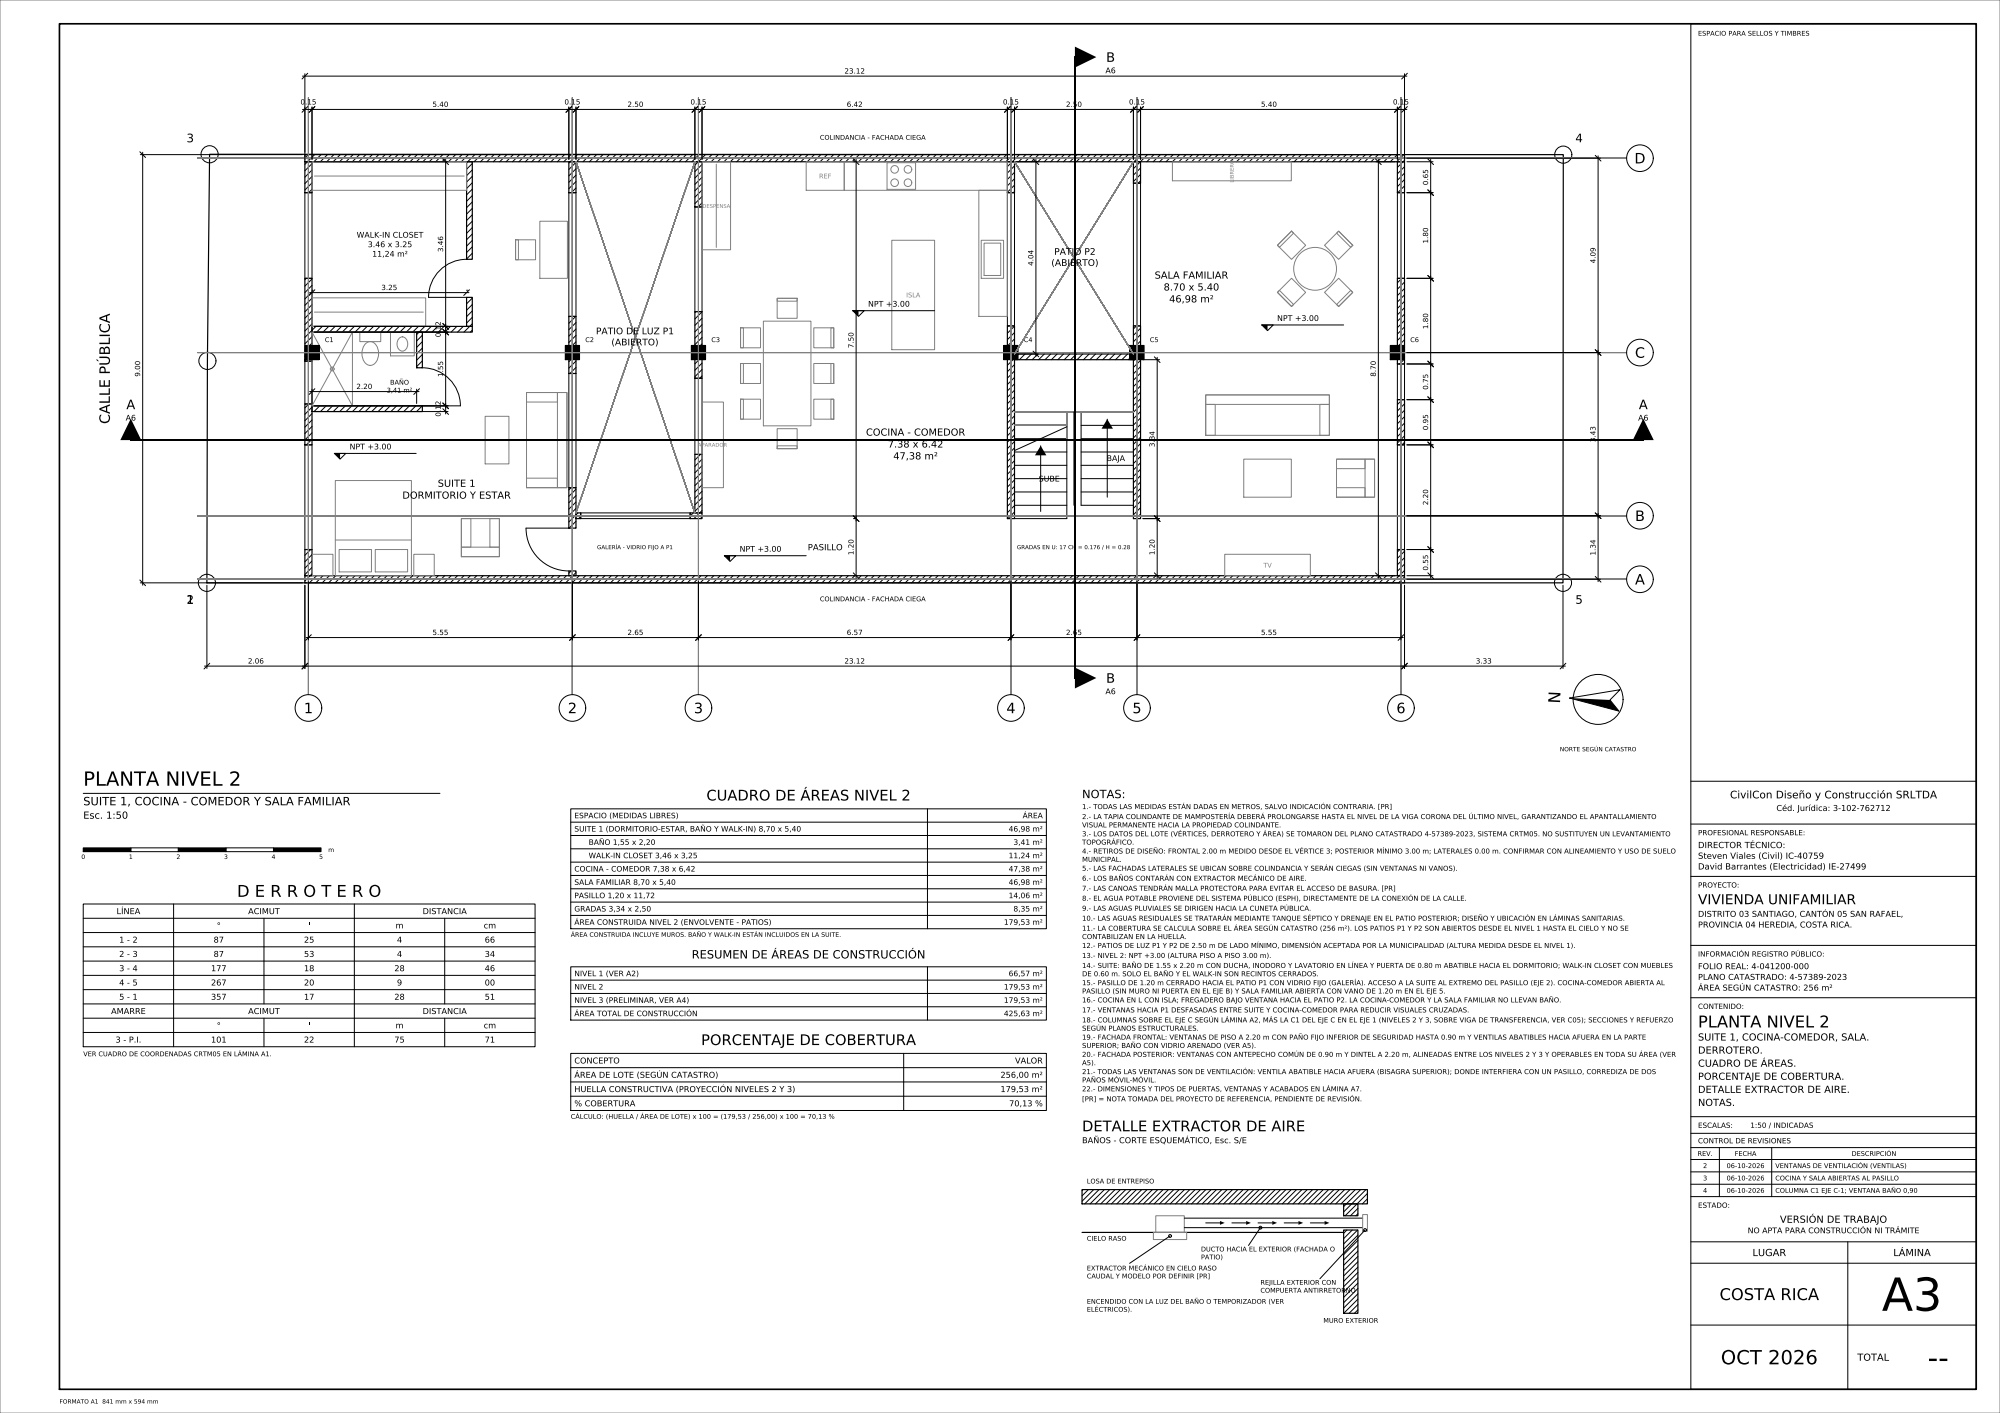
[picture p51: page 1]
