jbarra777/jbarra777/planos/A4_nivel3/SR-A4_NIVEL3_rev4.pdf

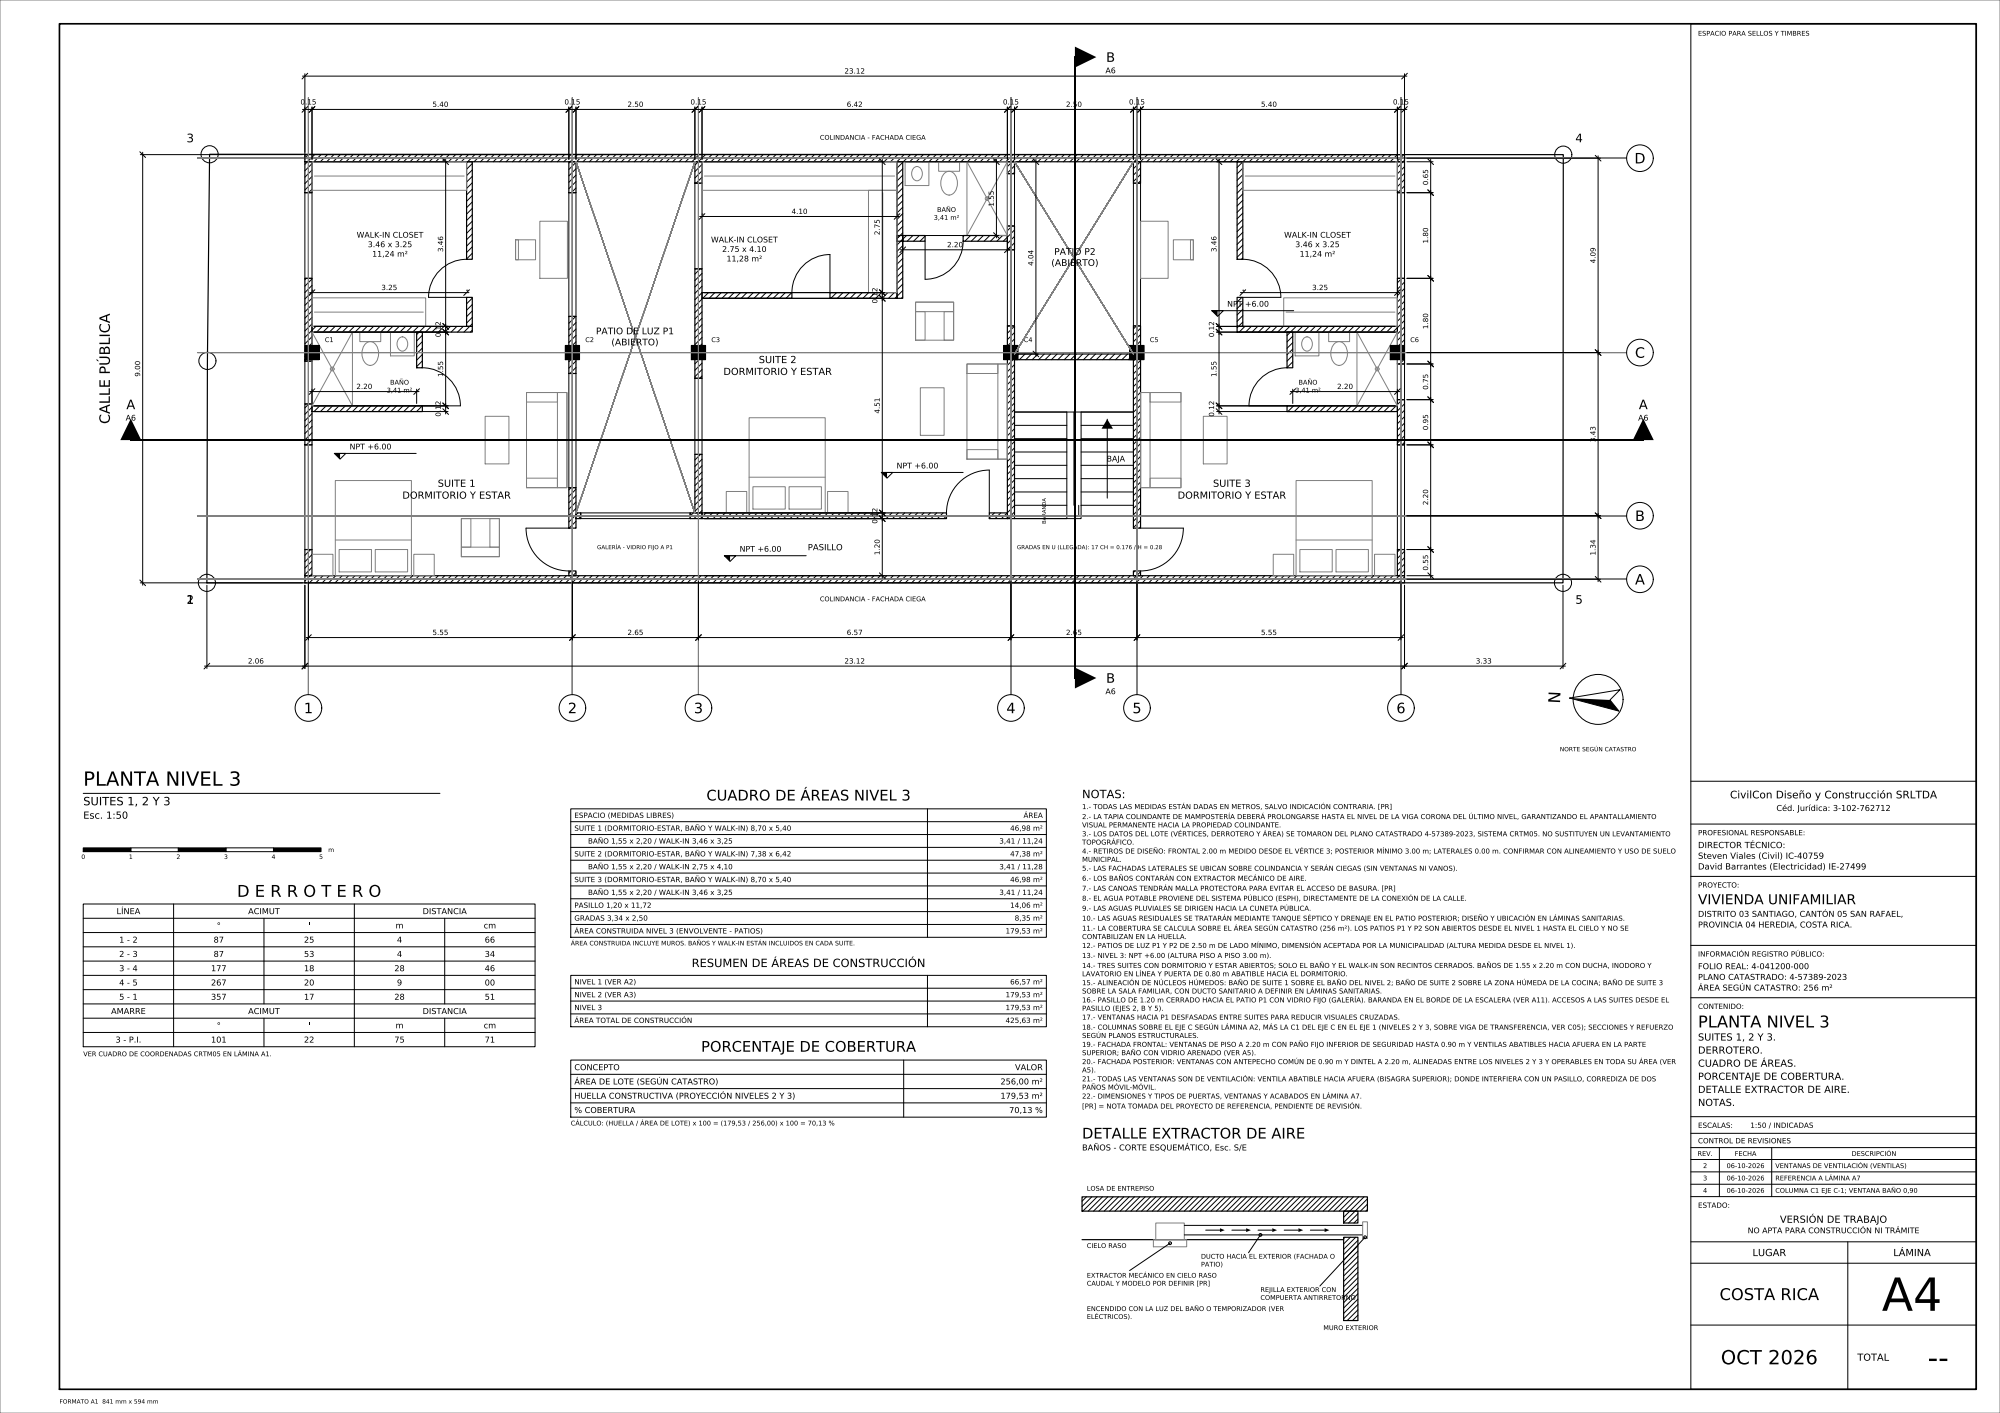
[picture p52: page 1]
