jbarra777/jbarra777/planos/A5_fachadas/SR-A5_FACHADAS_rev6.pdf

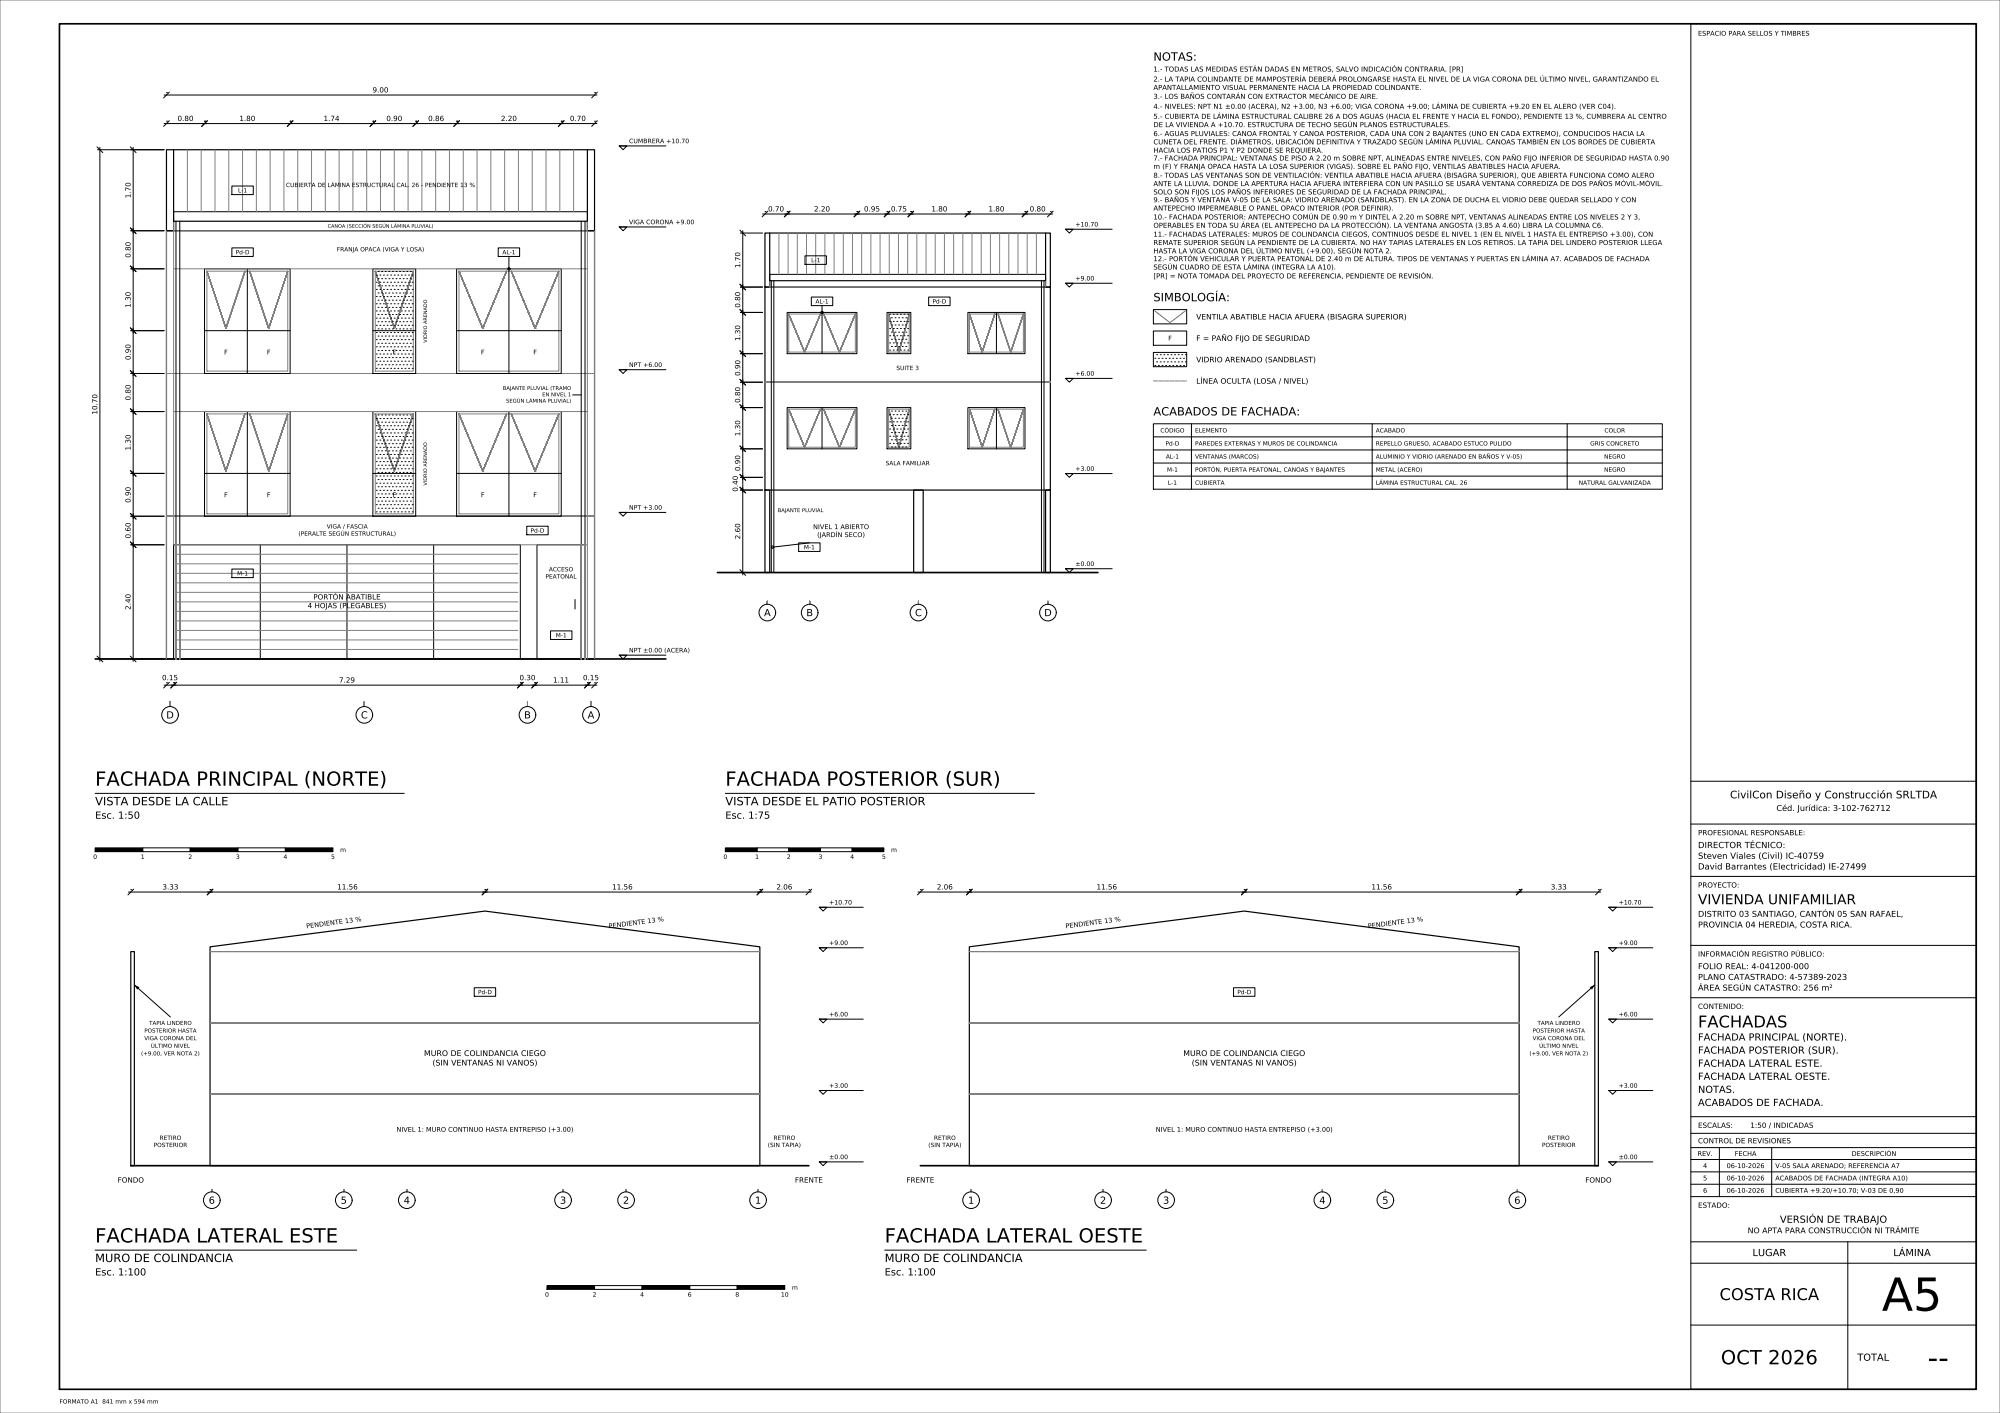
[picture p53: page 1]
