jbarra777/jbarra777/planos/A6_cortes/SR-A6_CORTES_rev4.pdf

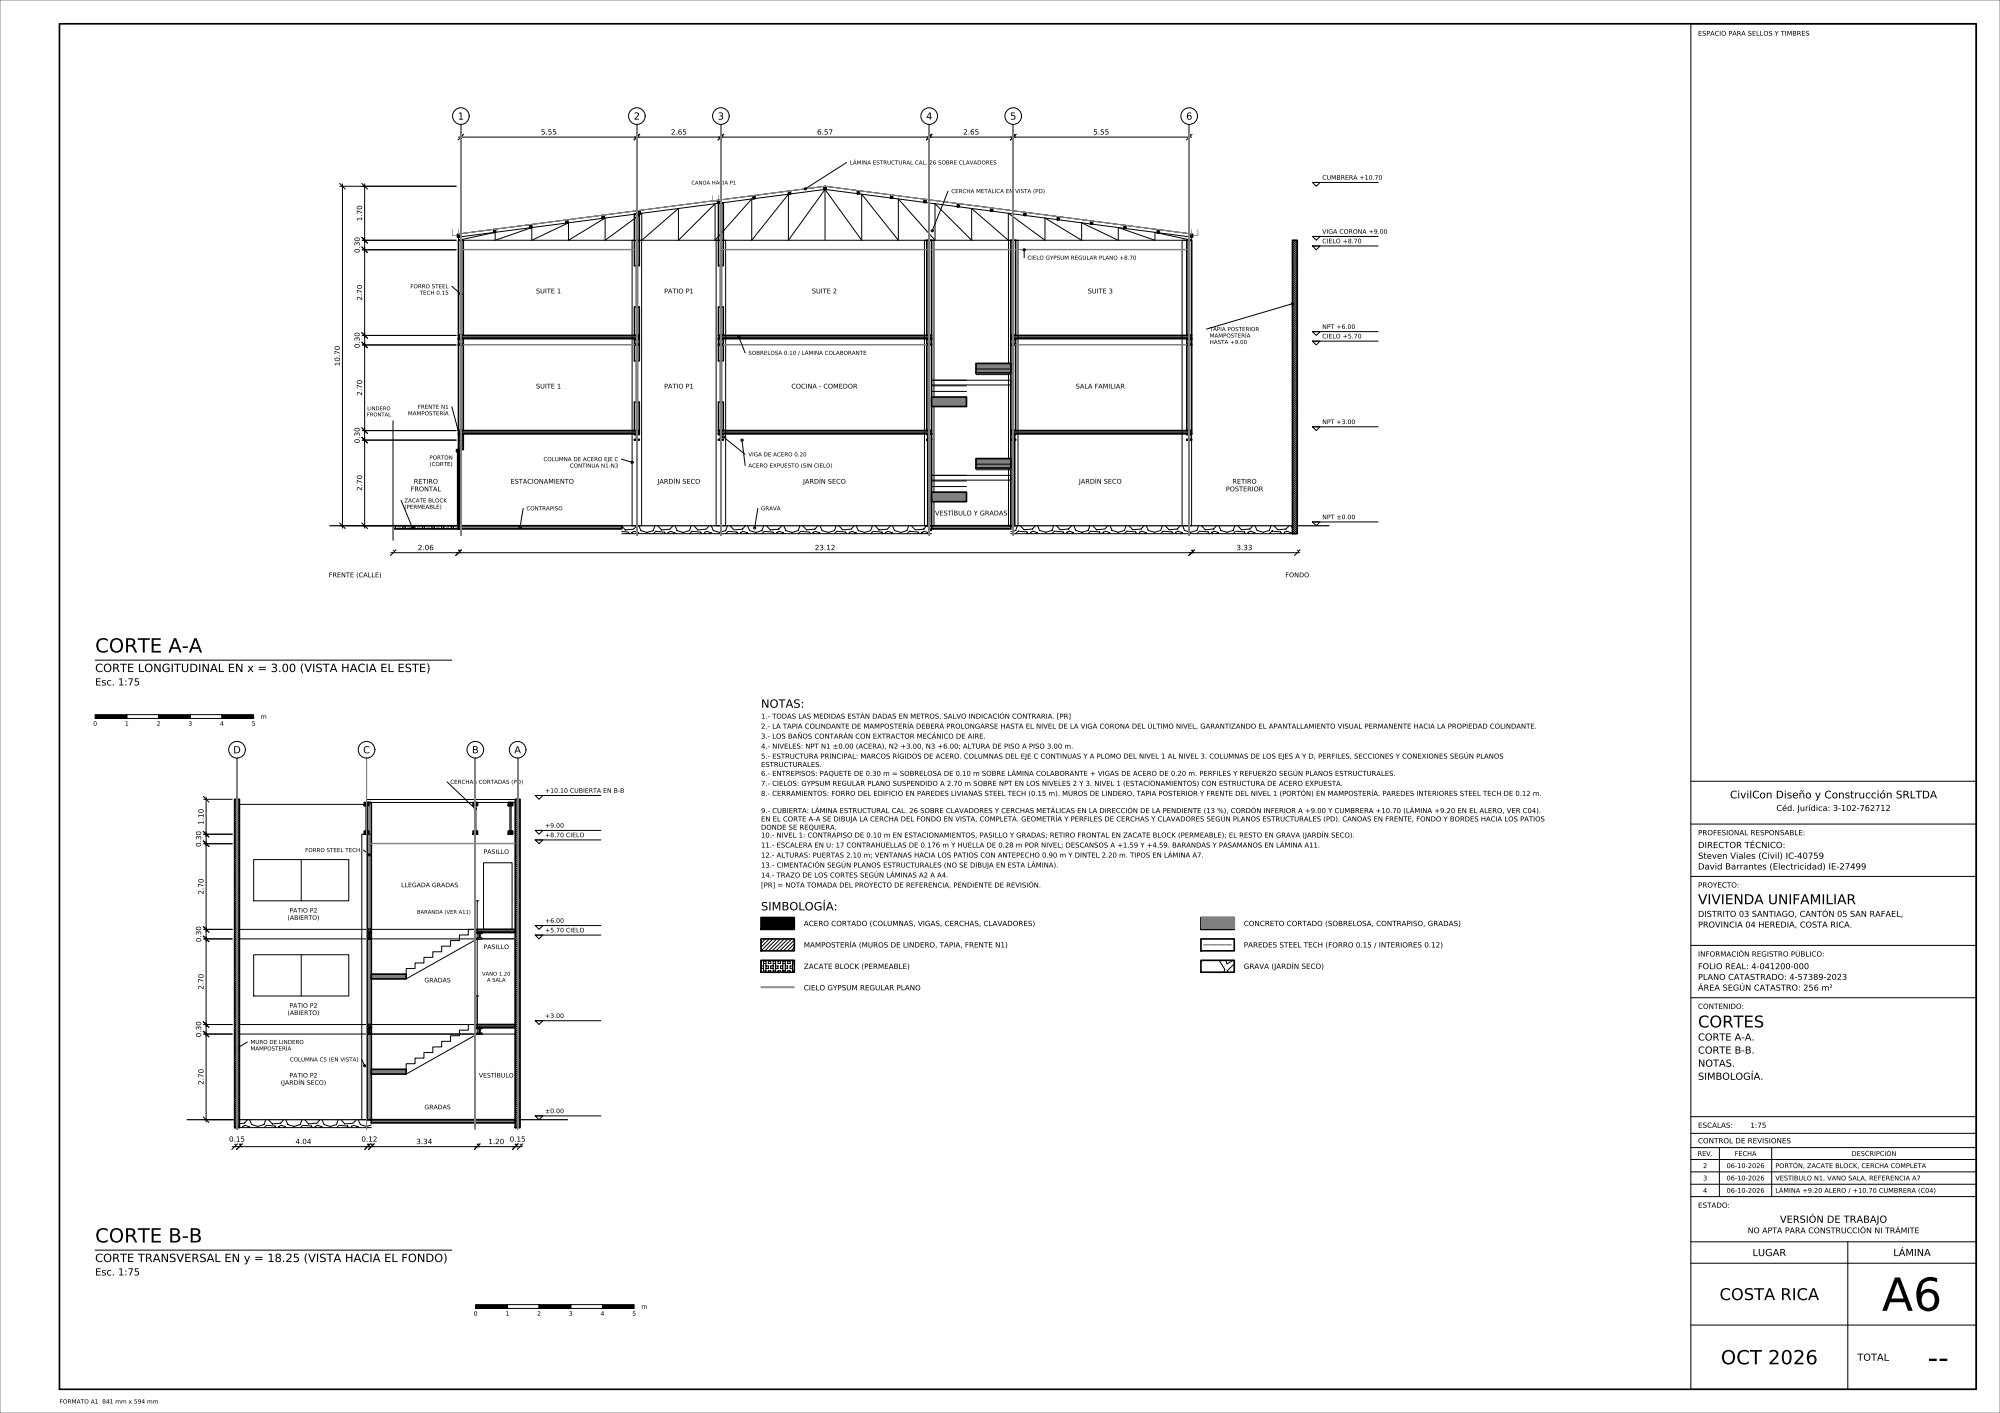
[picture p54: page 1]
