jbarra777/jbarra777/planos/A7_puertas_ventanas/SR-A7_PUERTAS_VENTANAS_rev2.pdf

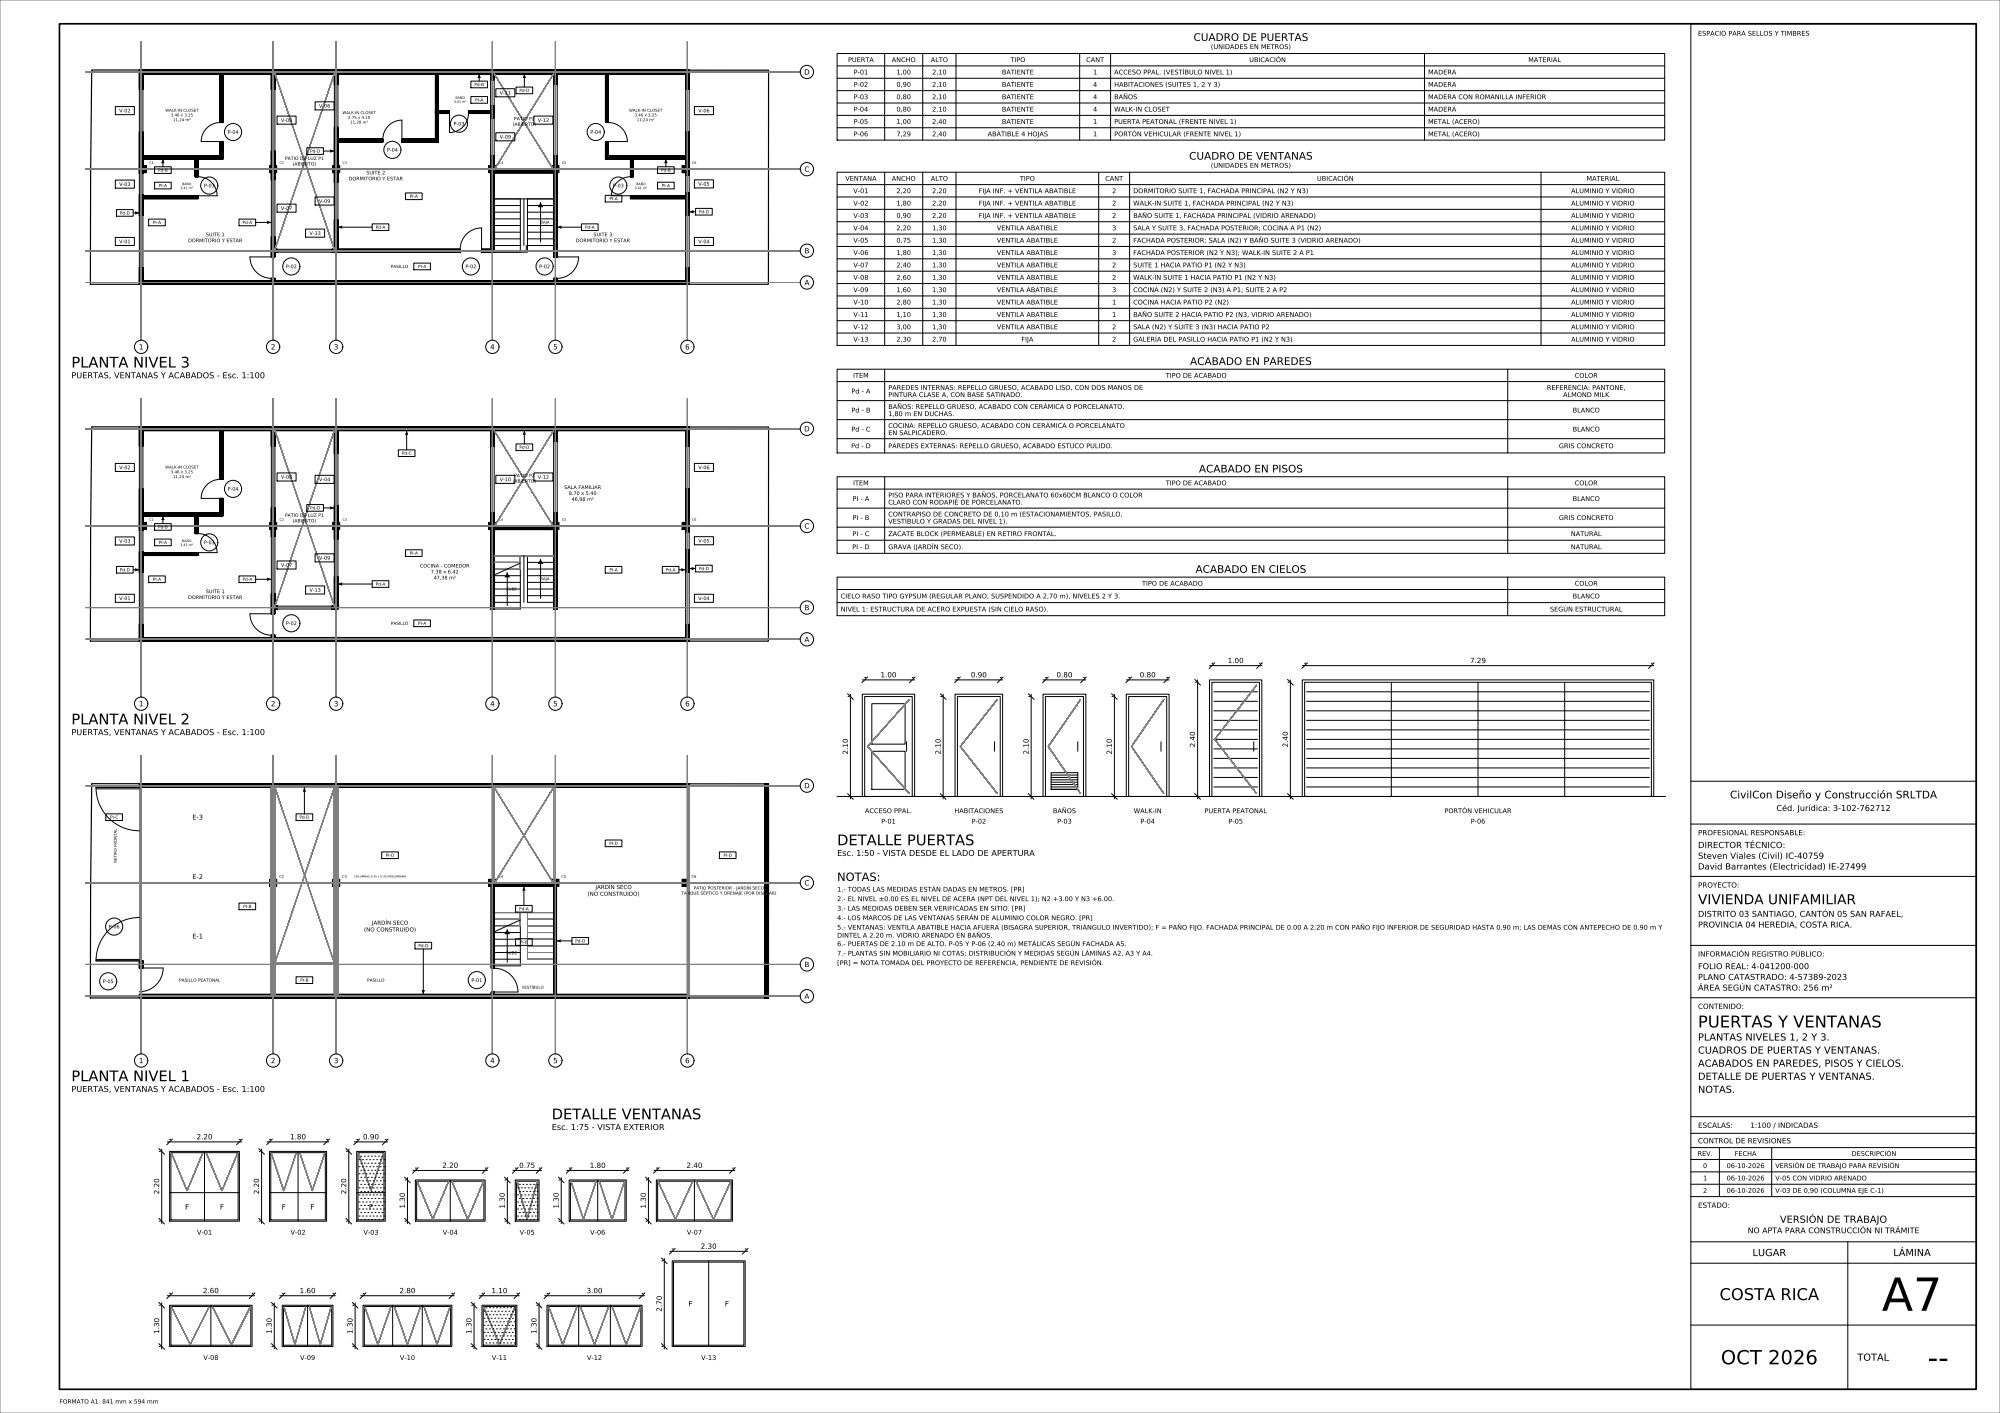
[picture p55: page 1]
