jbarra777/jbarra777/planos/C01_cimentaciones/SR-C01_CIMENTACIONES_rev1.pdf

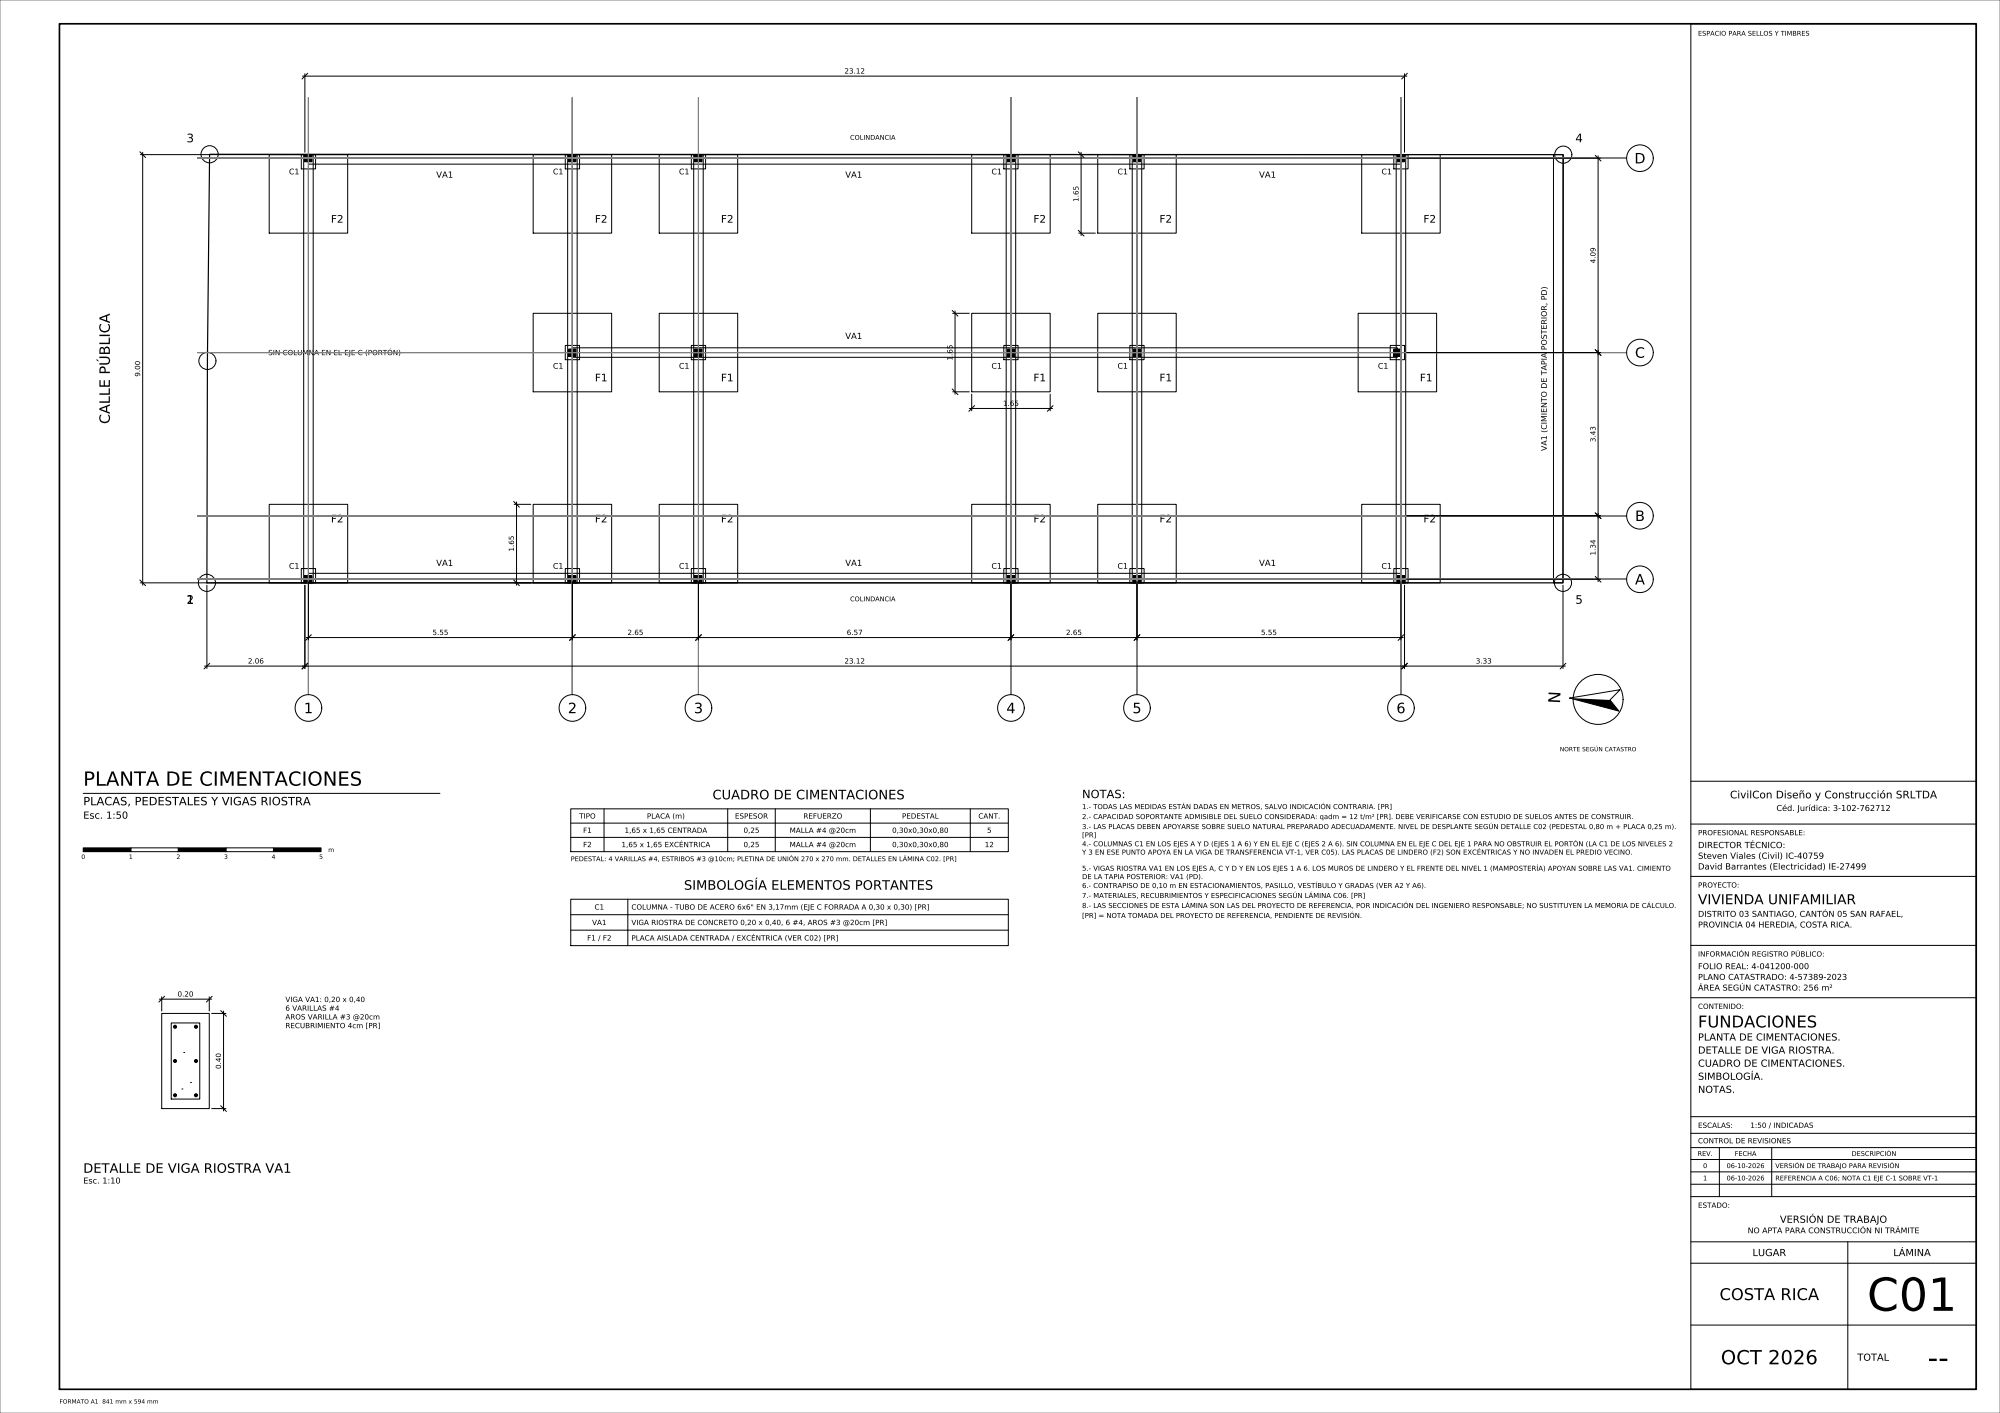
[picture p56: page 1]
