jbarra777/jbarra777/planos/C02_cimentacion_detalles/SR-C02_CIMENTACION_DETALLES_rev1.pdf

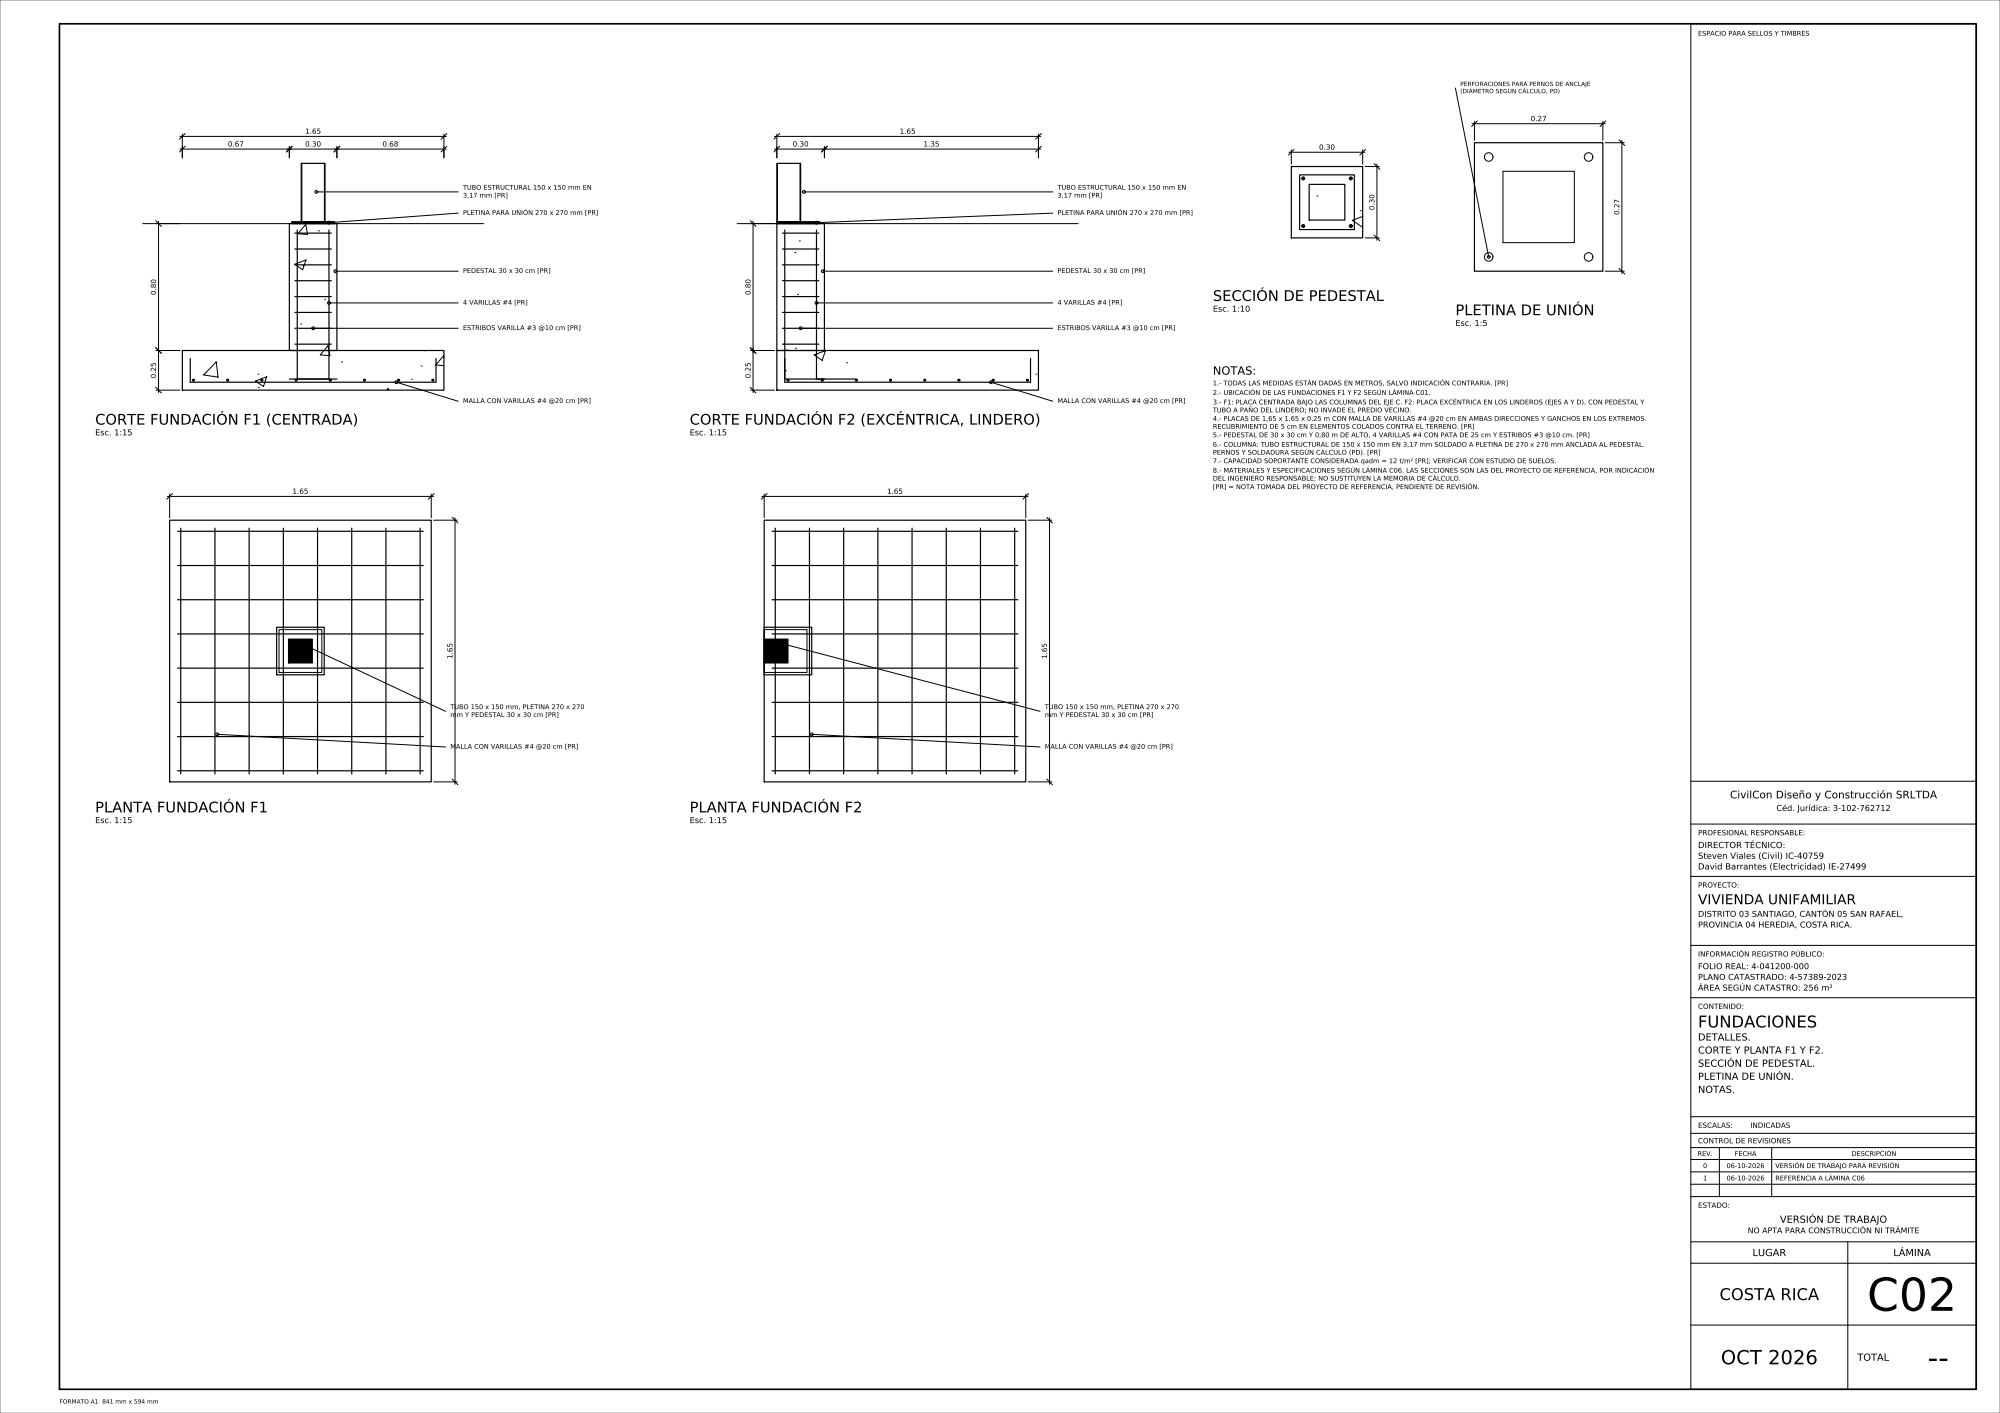
[picture p57: page 1]
