jbarra777/jbarra777/planos/C03_entrepiso_n2/SR-C03_ENTREPISOS_rev2.pdf

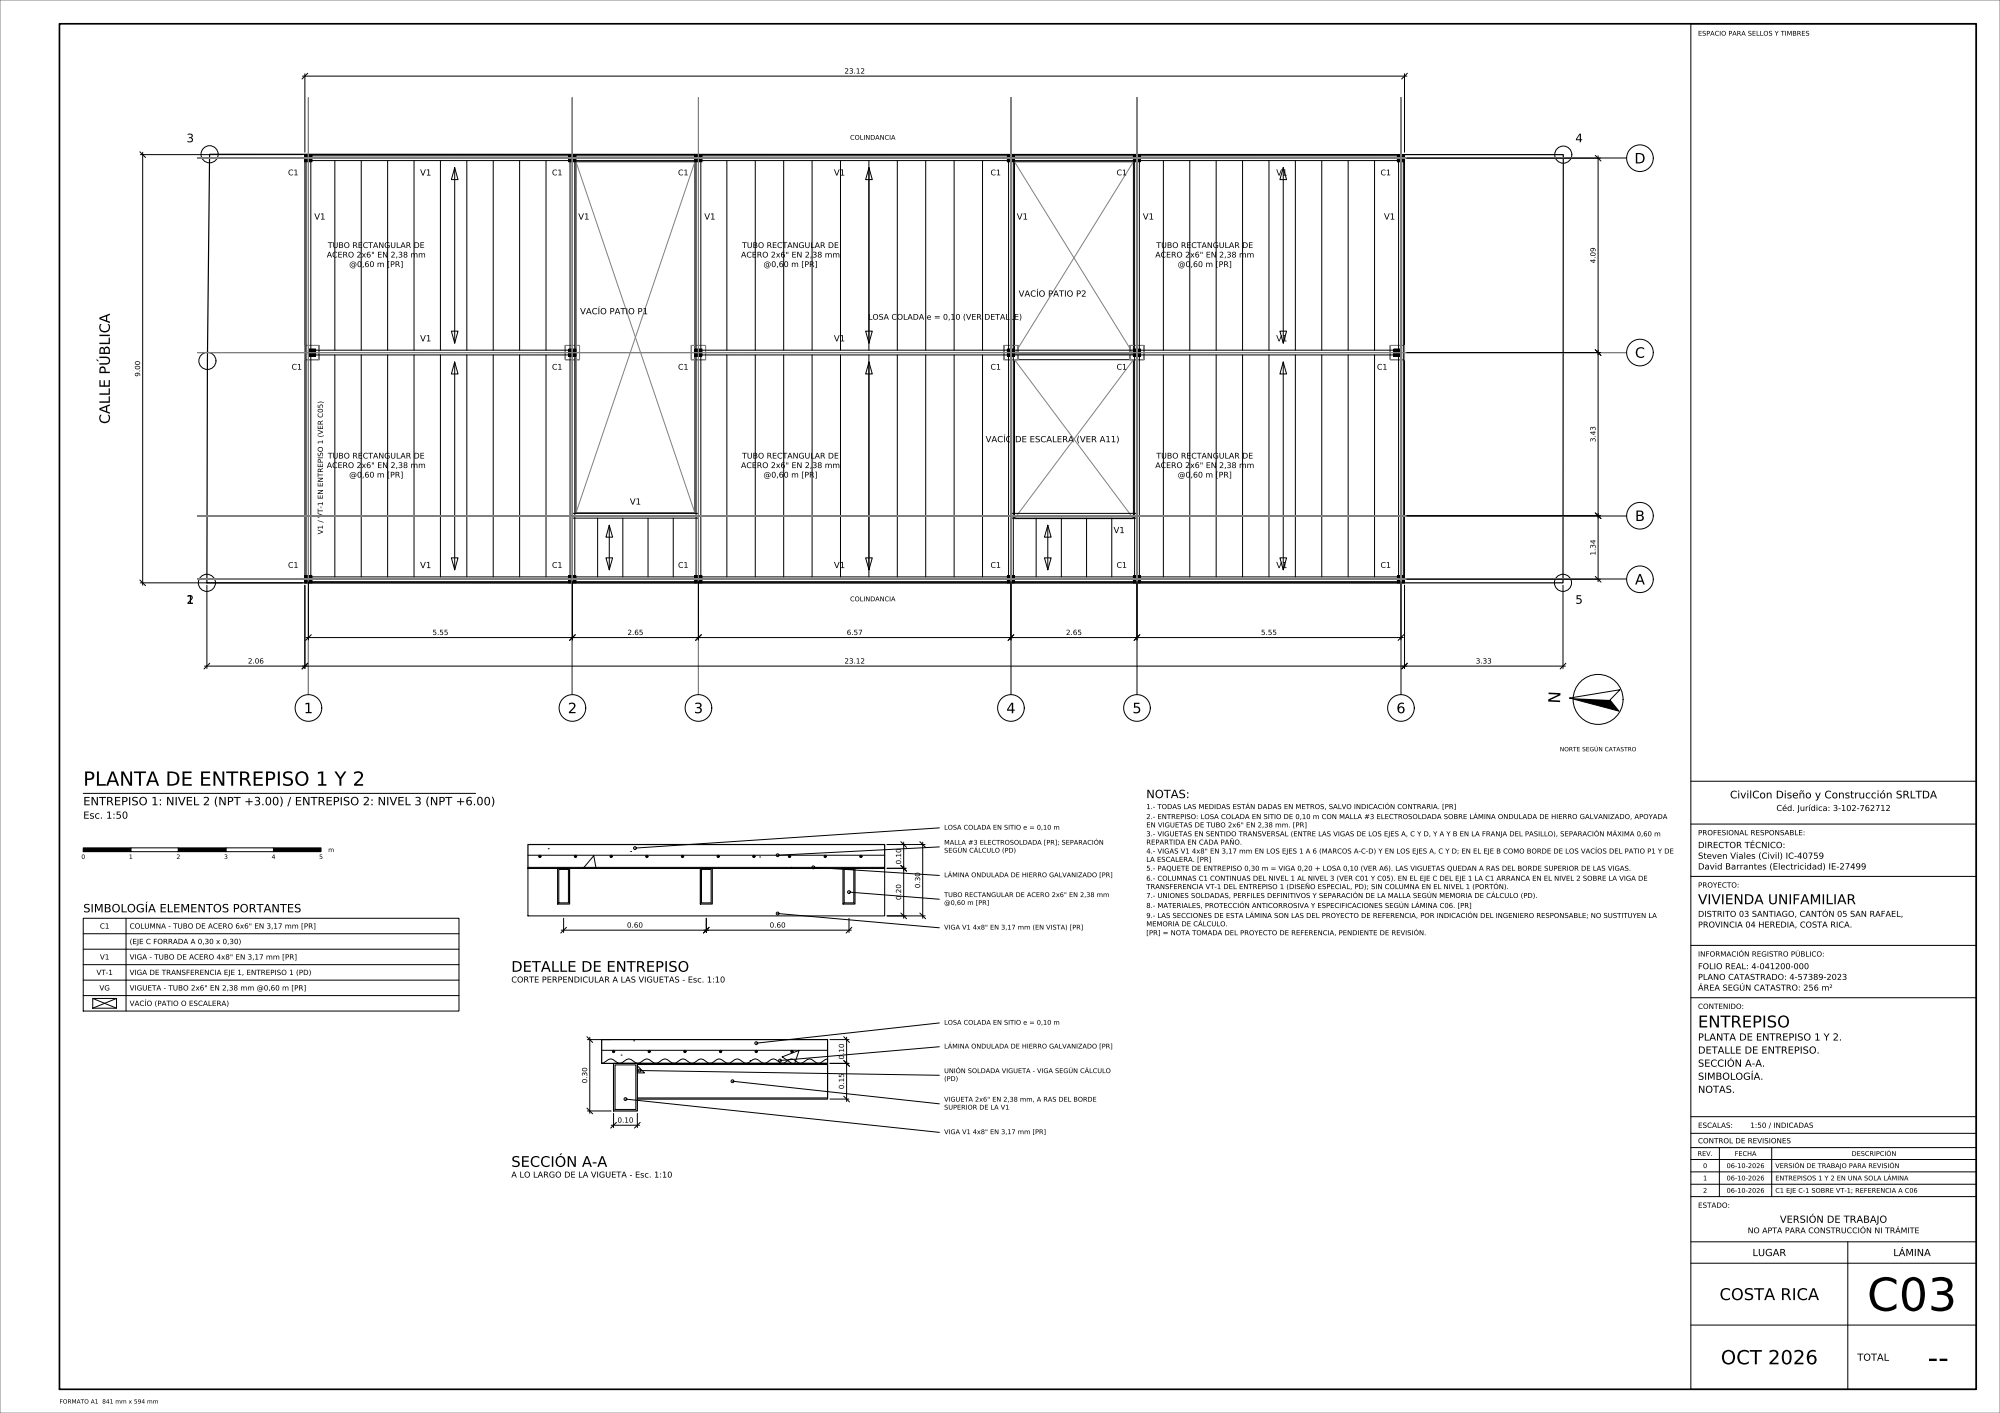
[picture p58: page 1]
