jbarra777/jbarra777/planos/C04_techo/SR-C04_TECHO_rev1.pdf

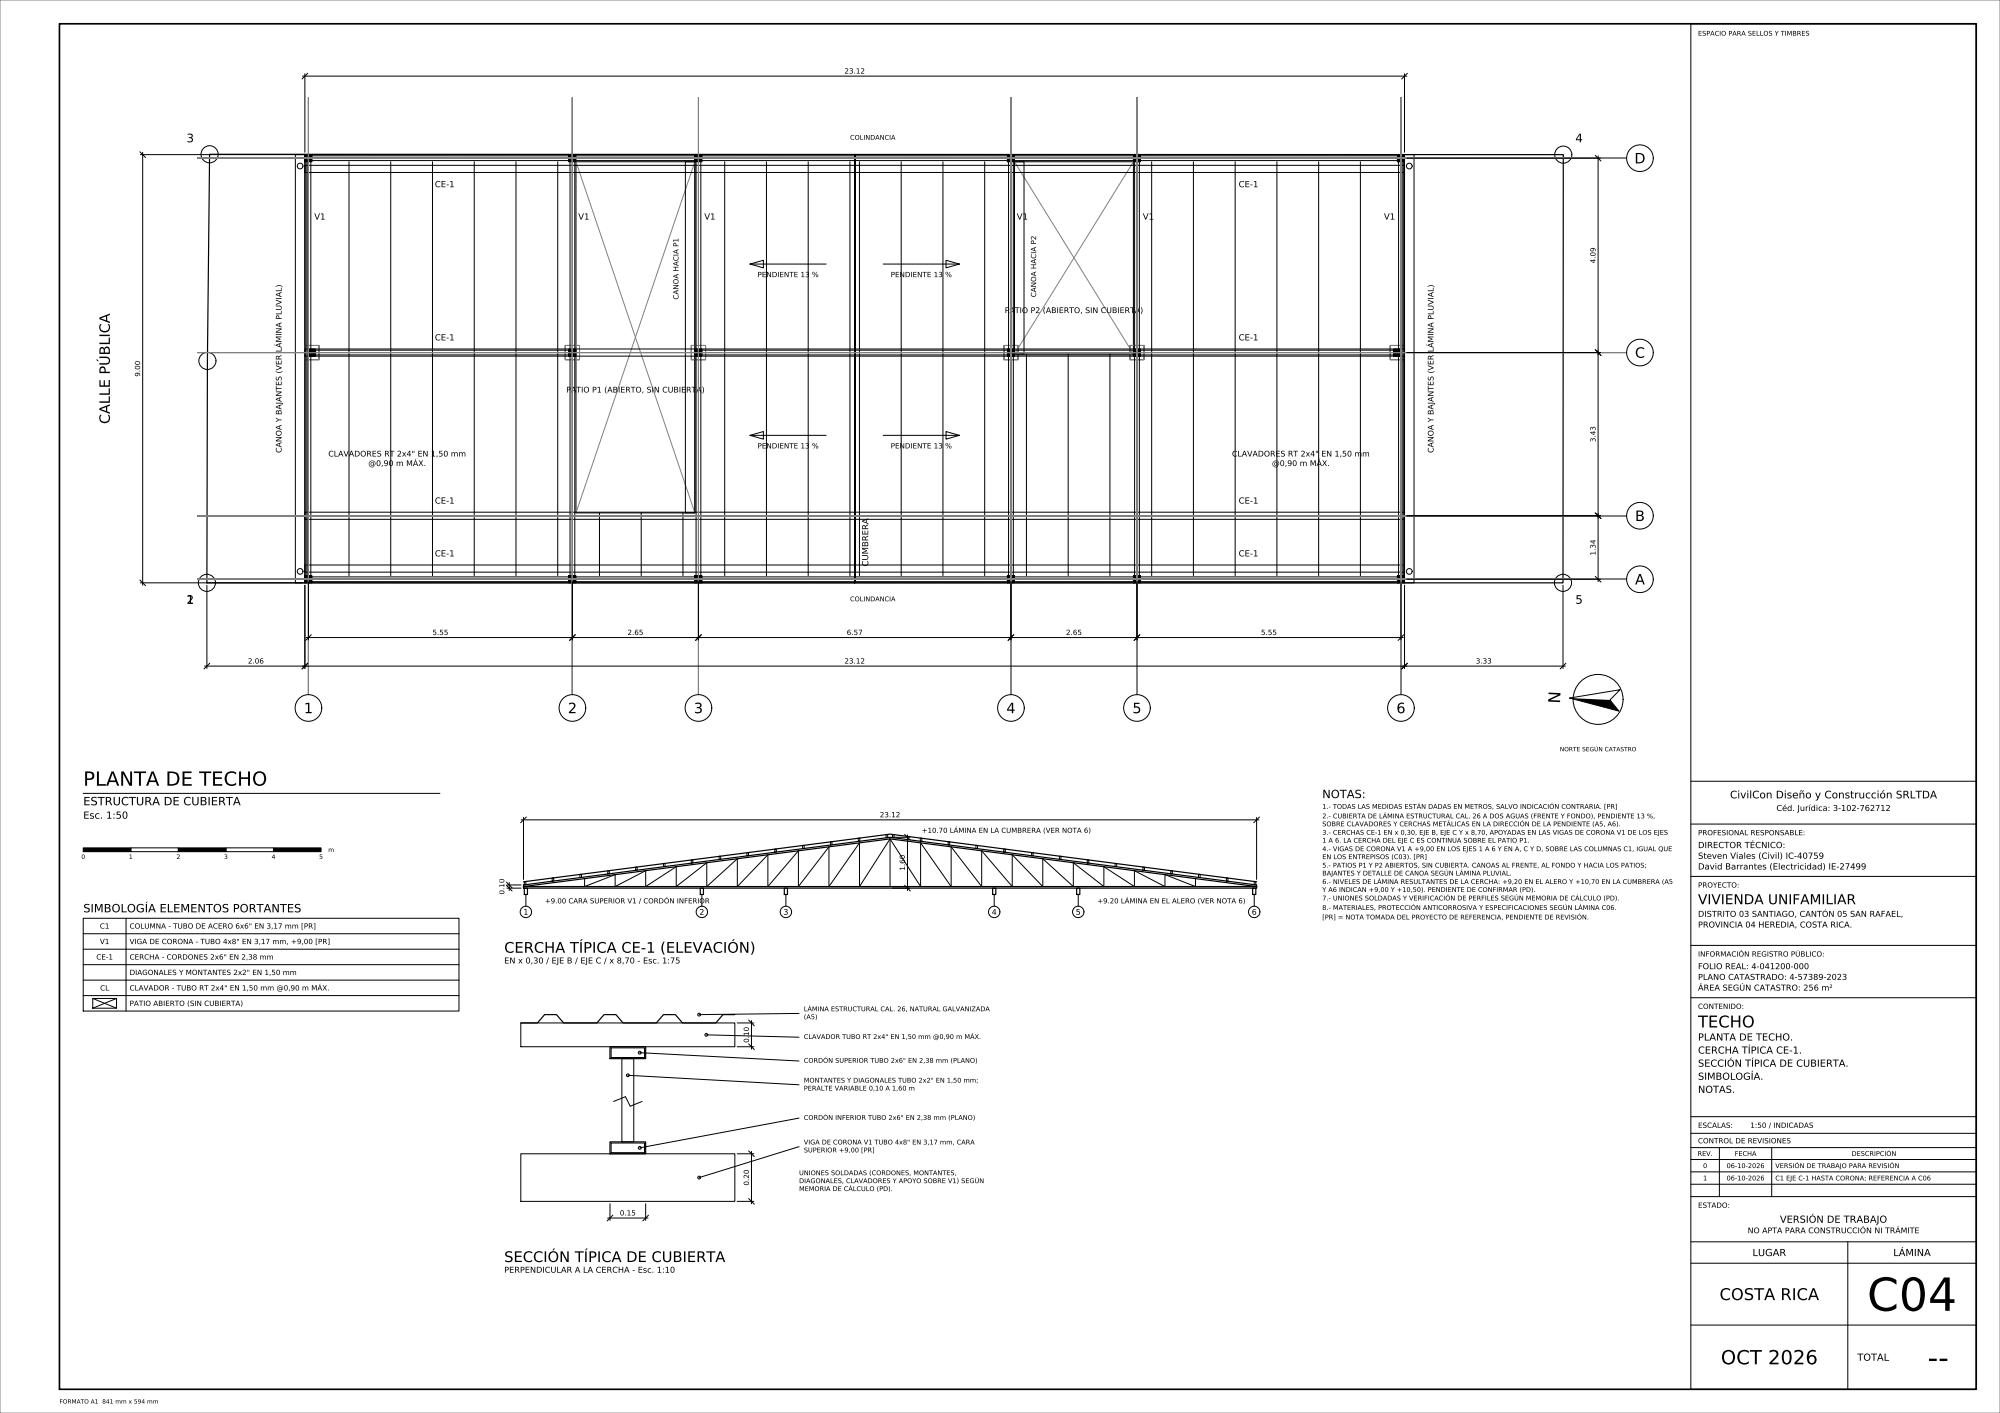
[picture p59: page 1]
