jbarra777/jbarra777/planos/C05_porticos/SR-C05_PORTICOS_rev2.pdf

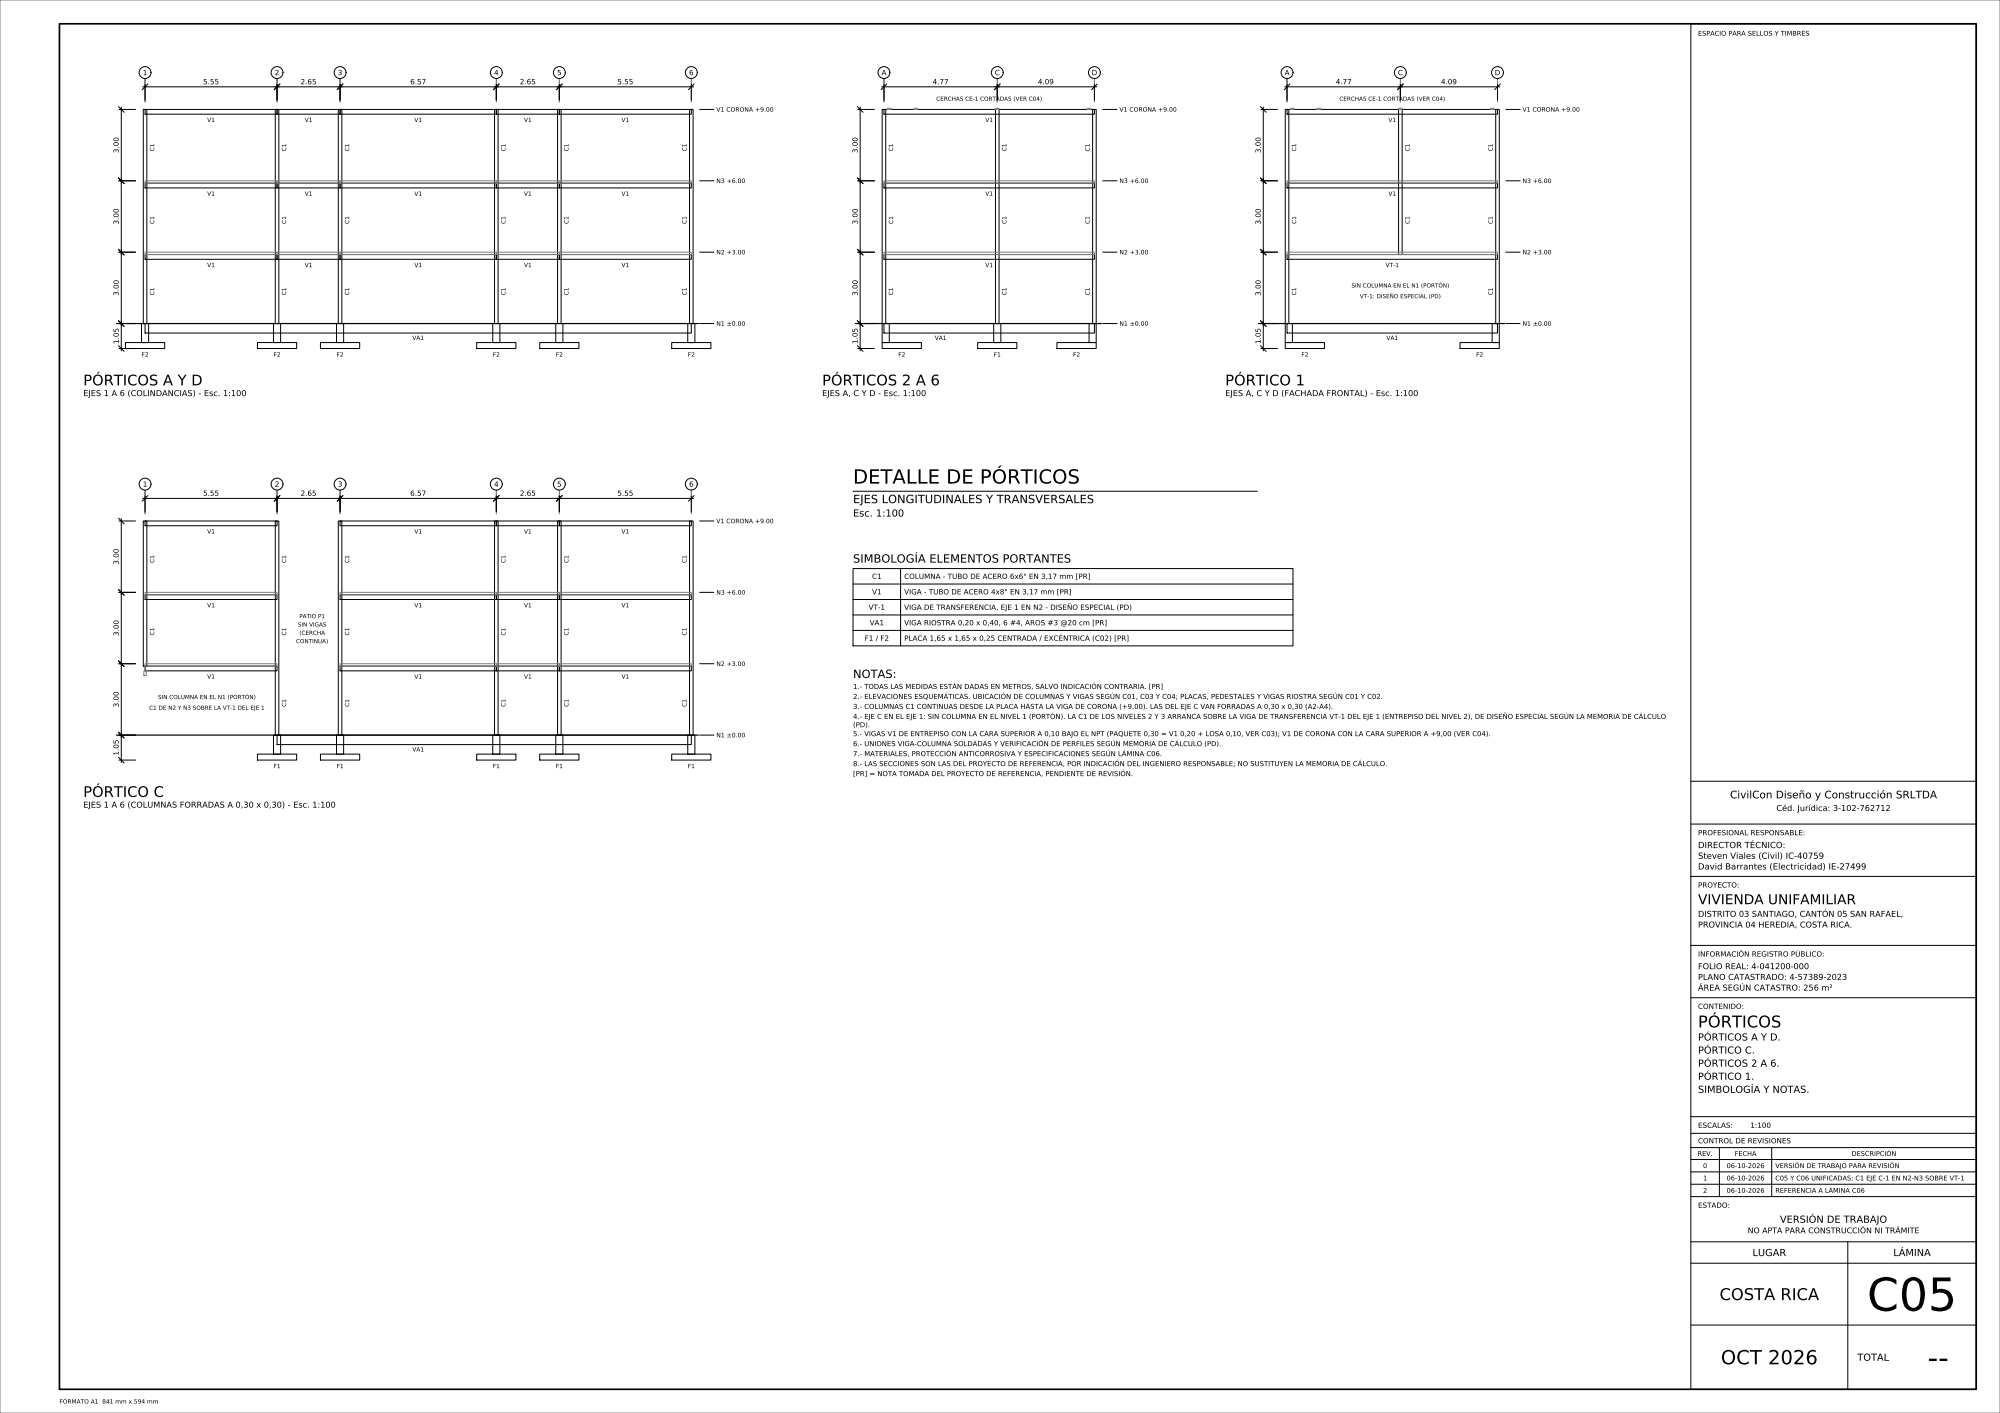
[picture p60: page 1]
