jbarra777/jbarra777/planos/C06_especificaciones/SR-C06_ESPECIFICACIONES_rev1.pdf

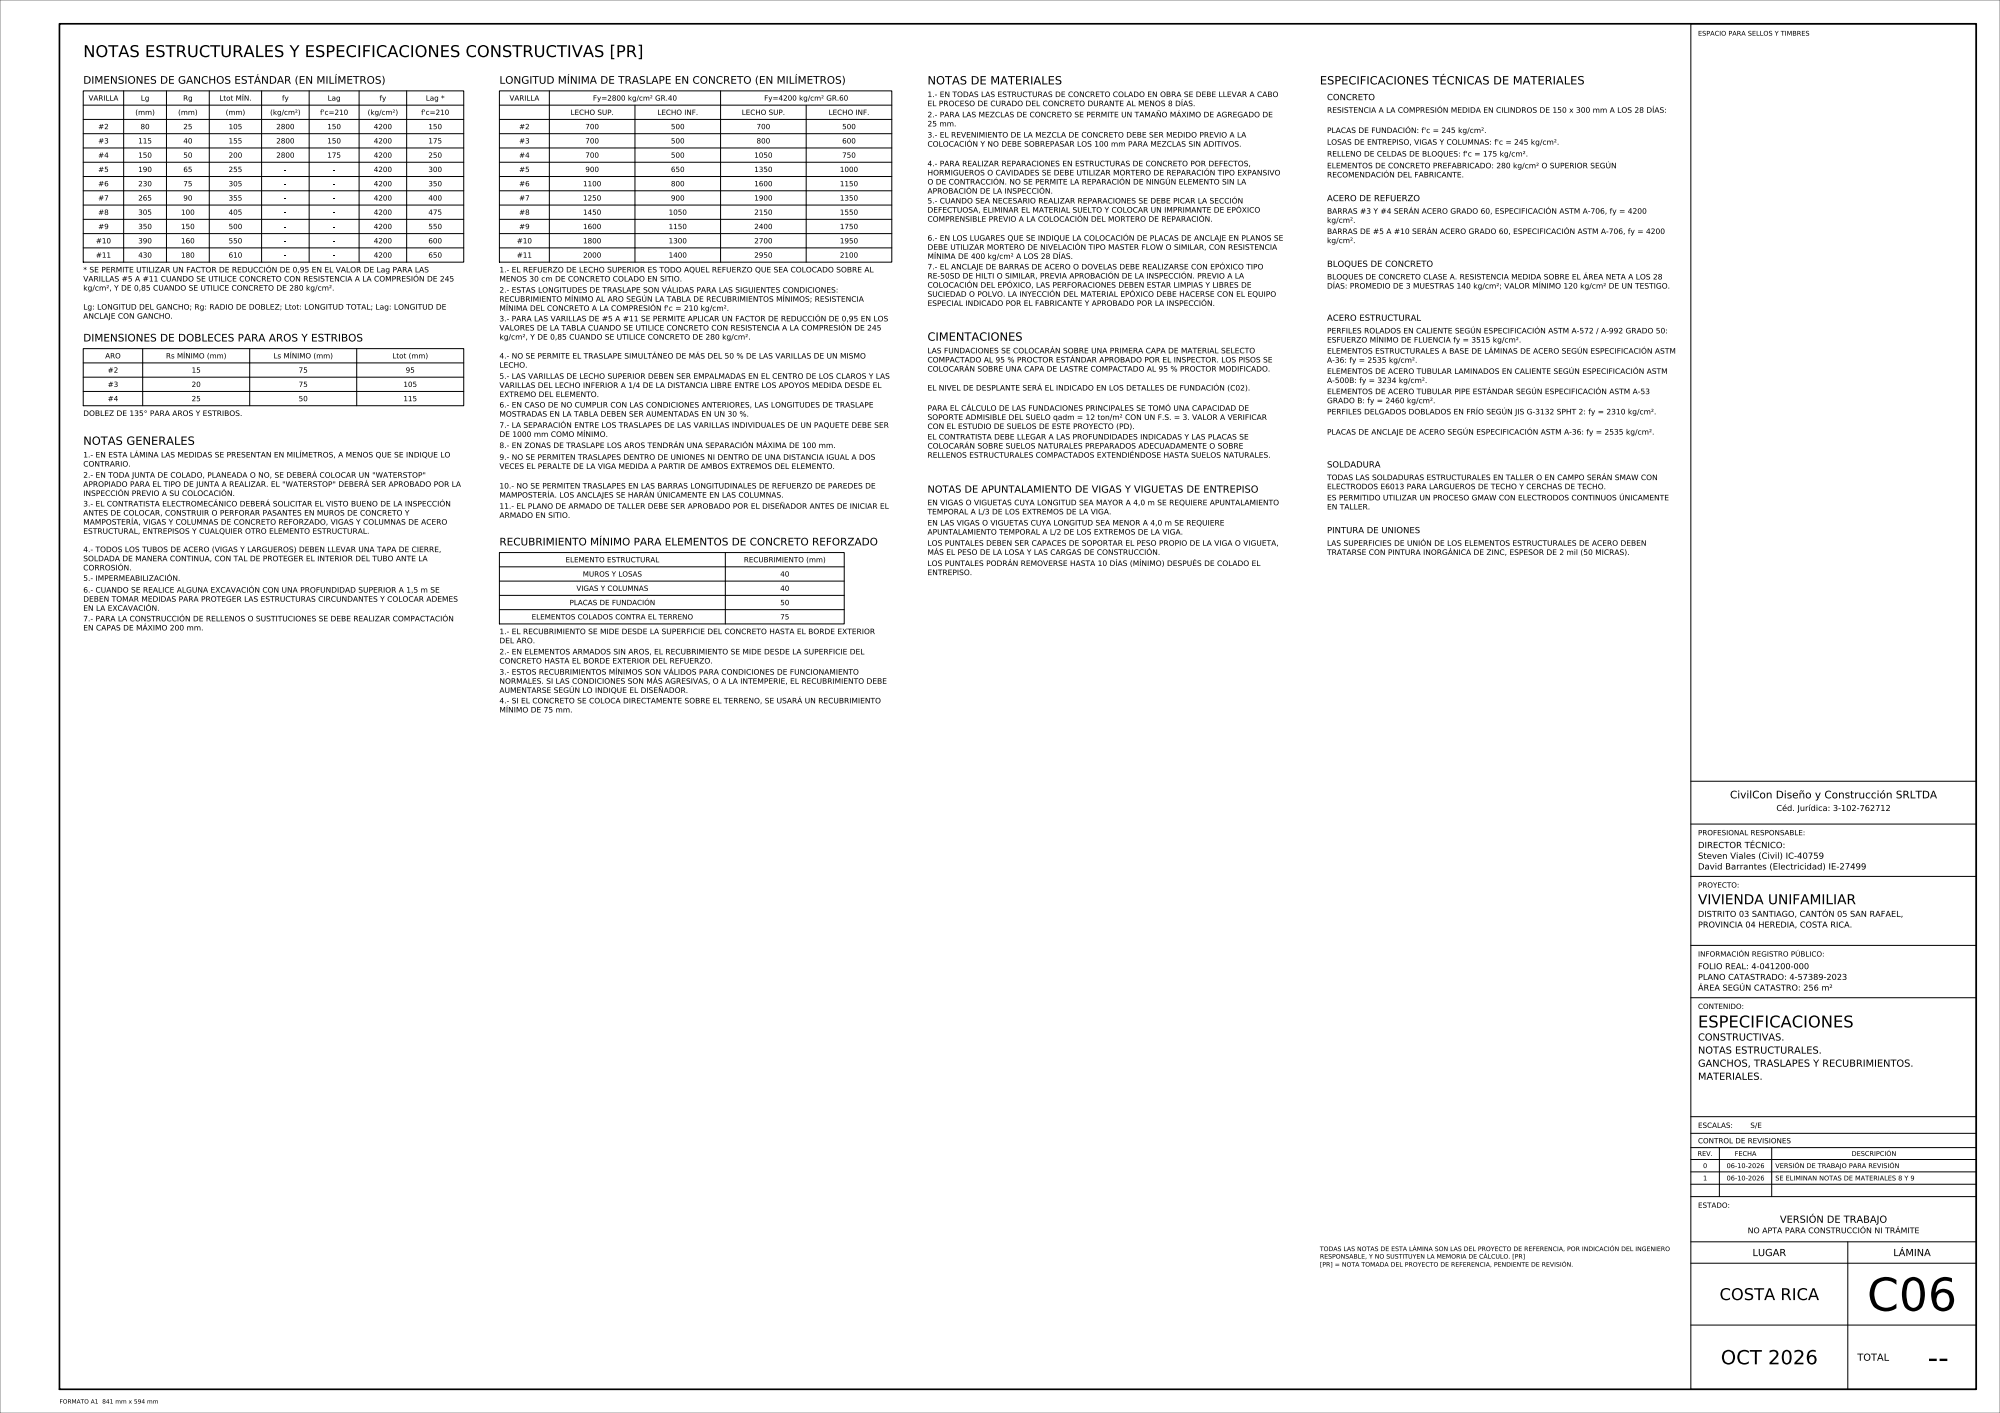
[picture p61: page 1]
