jbarra777/jbarra777/planos/C06_especificaciones/SR-C06_ESPECIFICACIONES_rev0.pdf

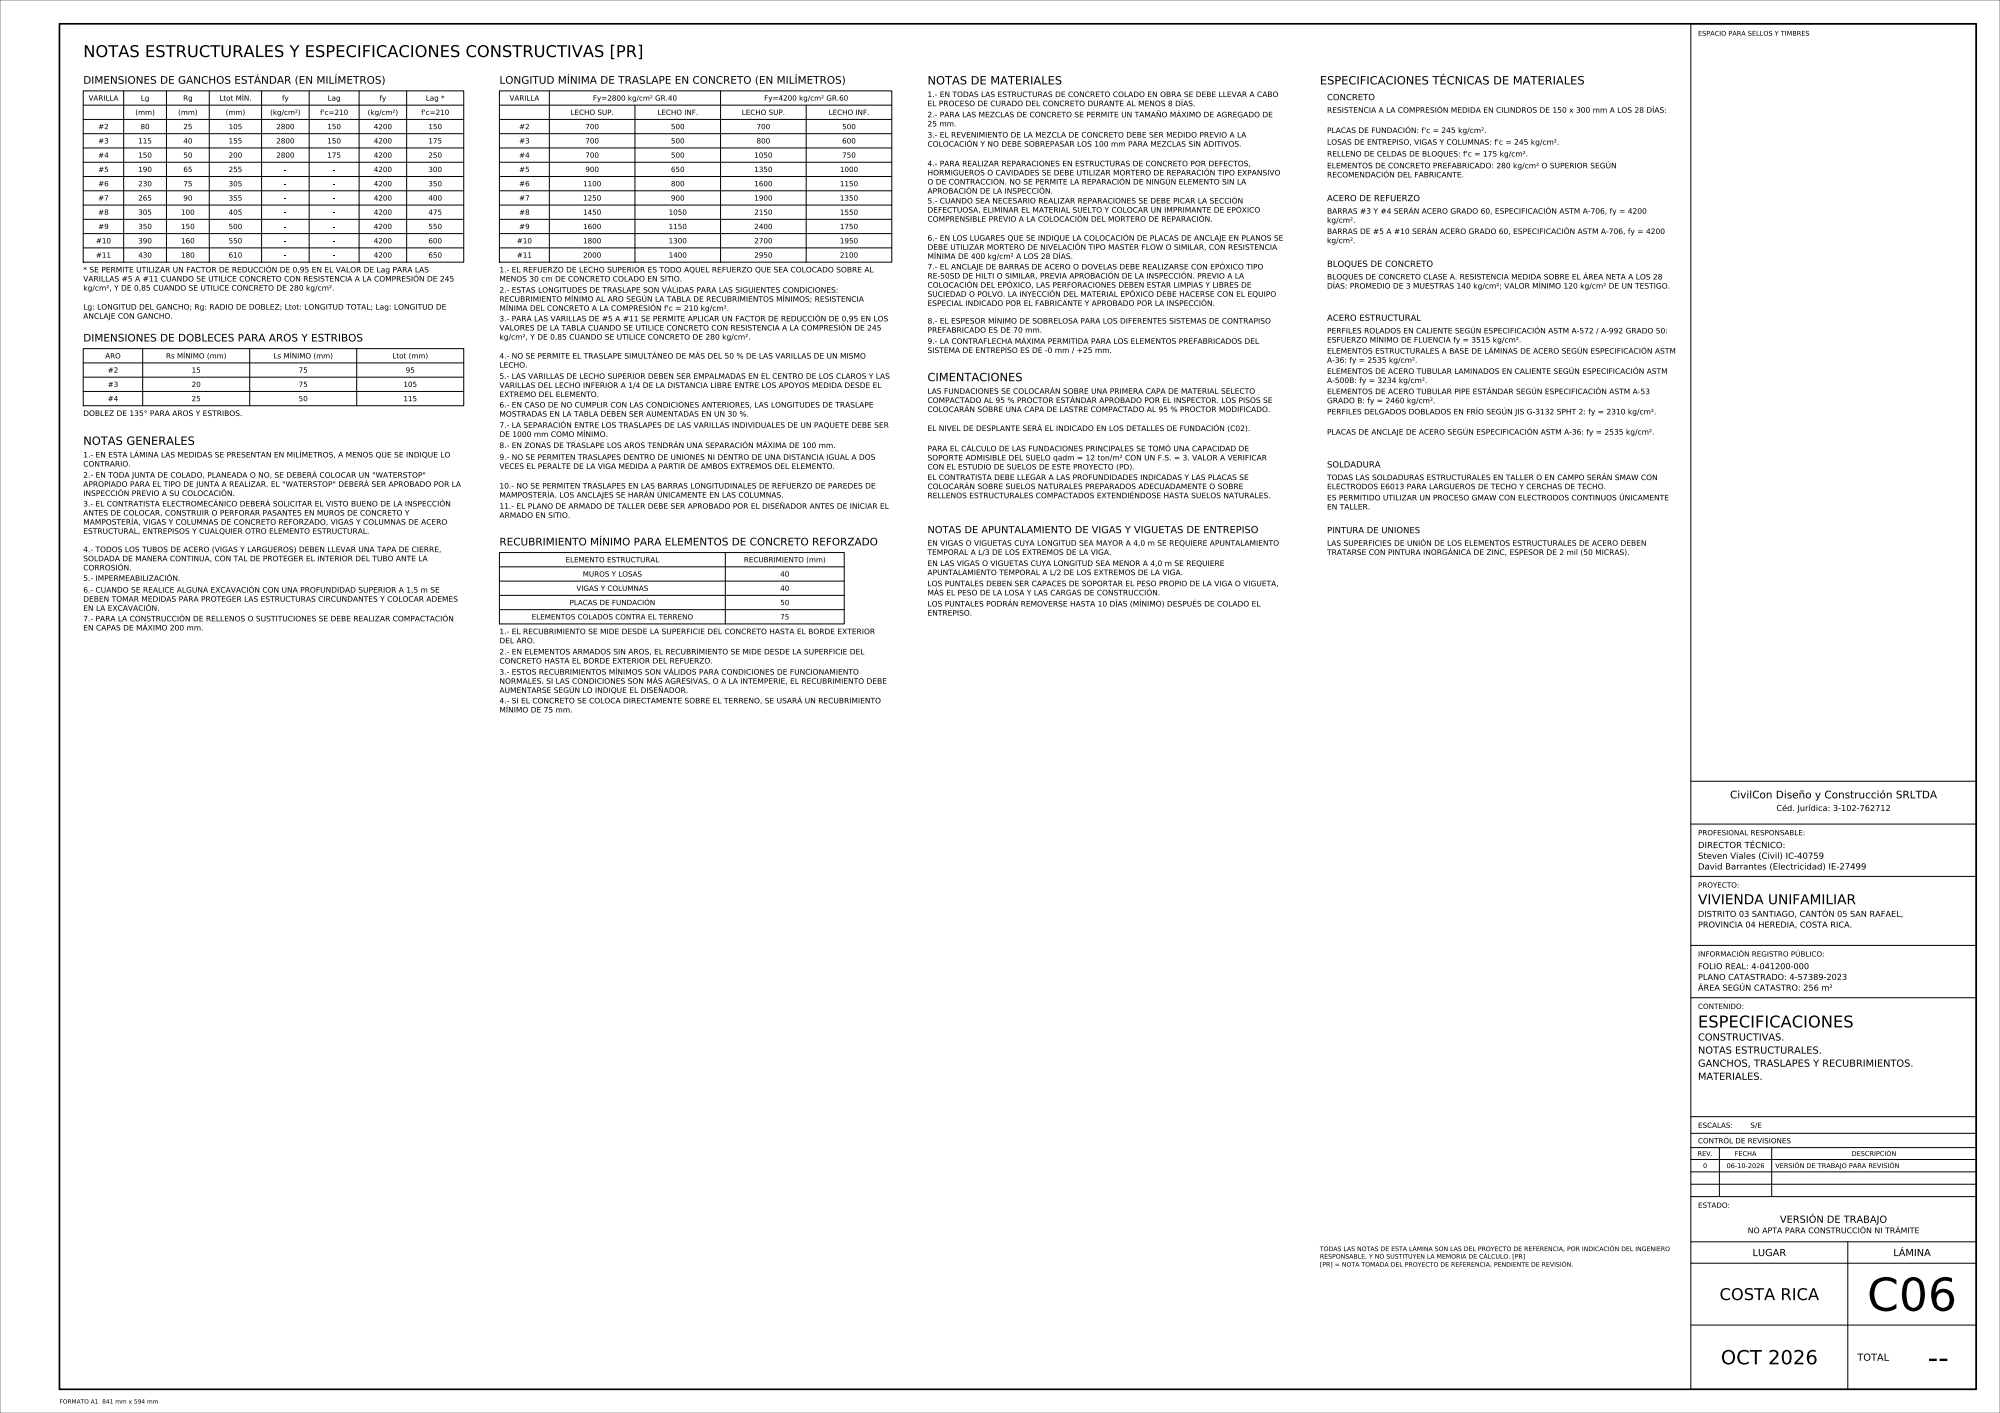
[picture p62: page 1]
