jbarra777/jbarra777/planos/C05_porticos/SR-C05_PORTICOS_rev1.pdf

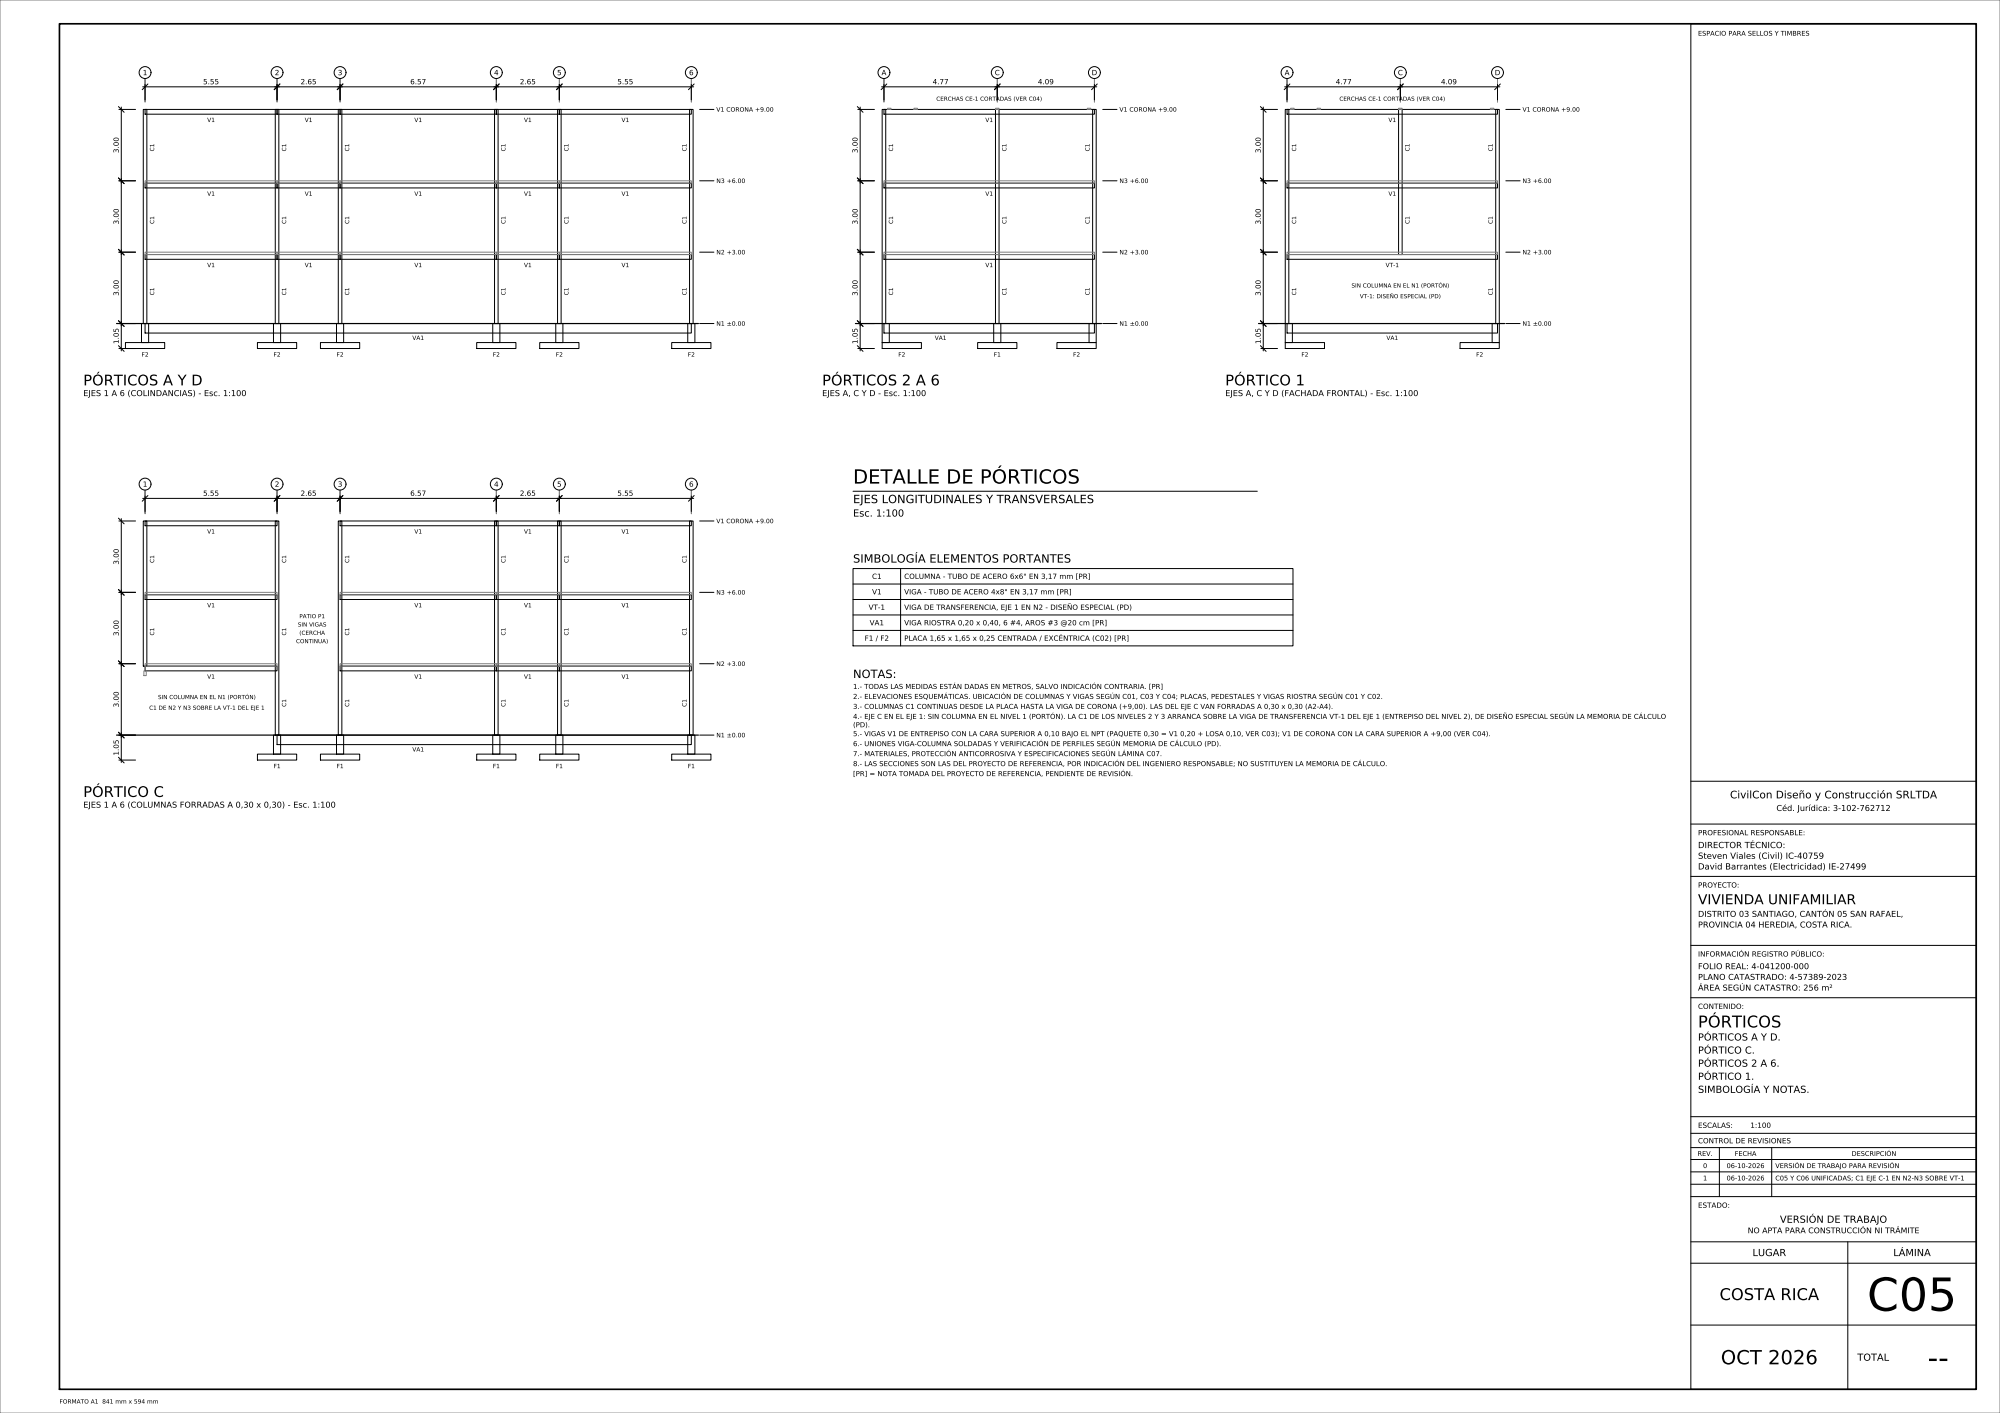
[picture p63: page 1]
