jbarra777/jbarra777/planos/C04_techo/SR-C04_TECHO_rev0.pdf

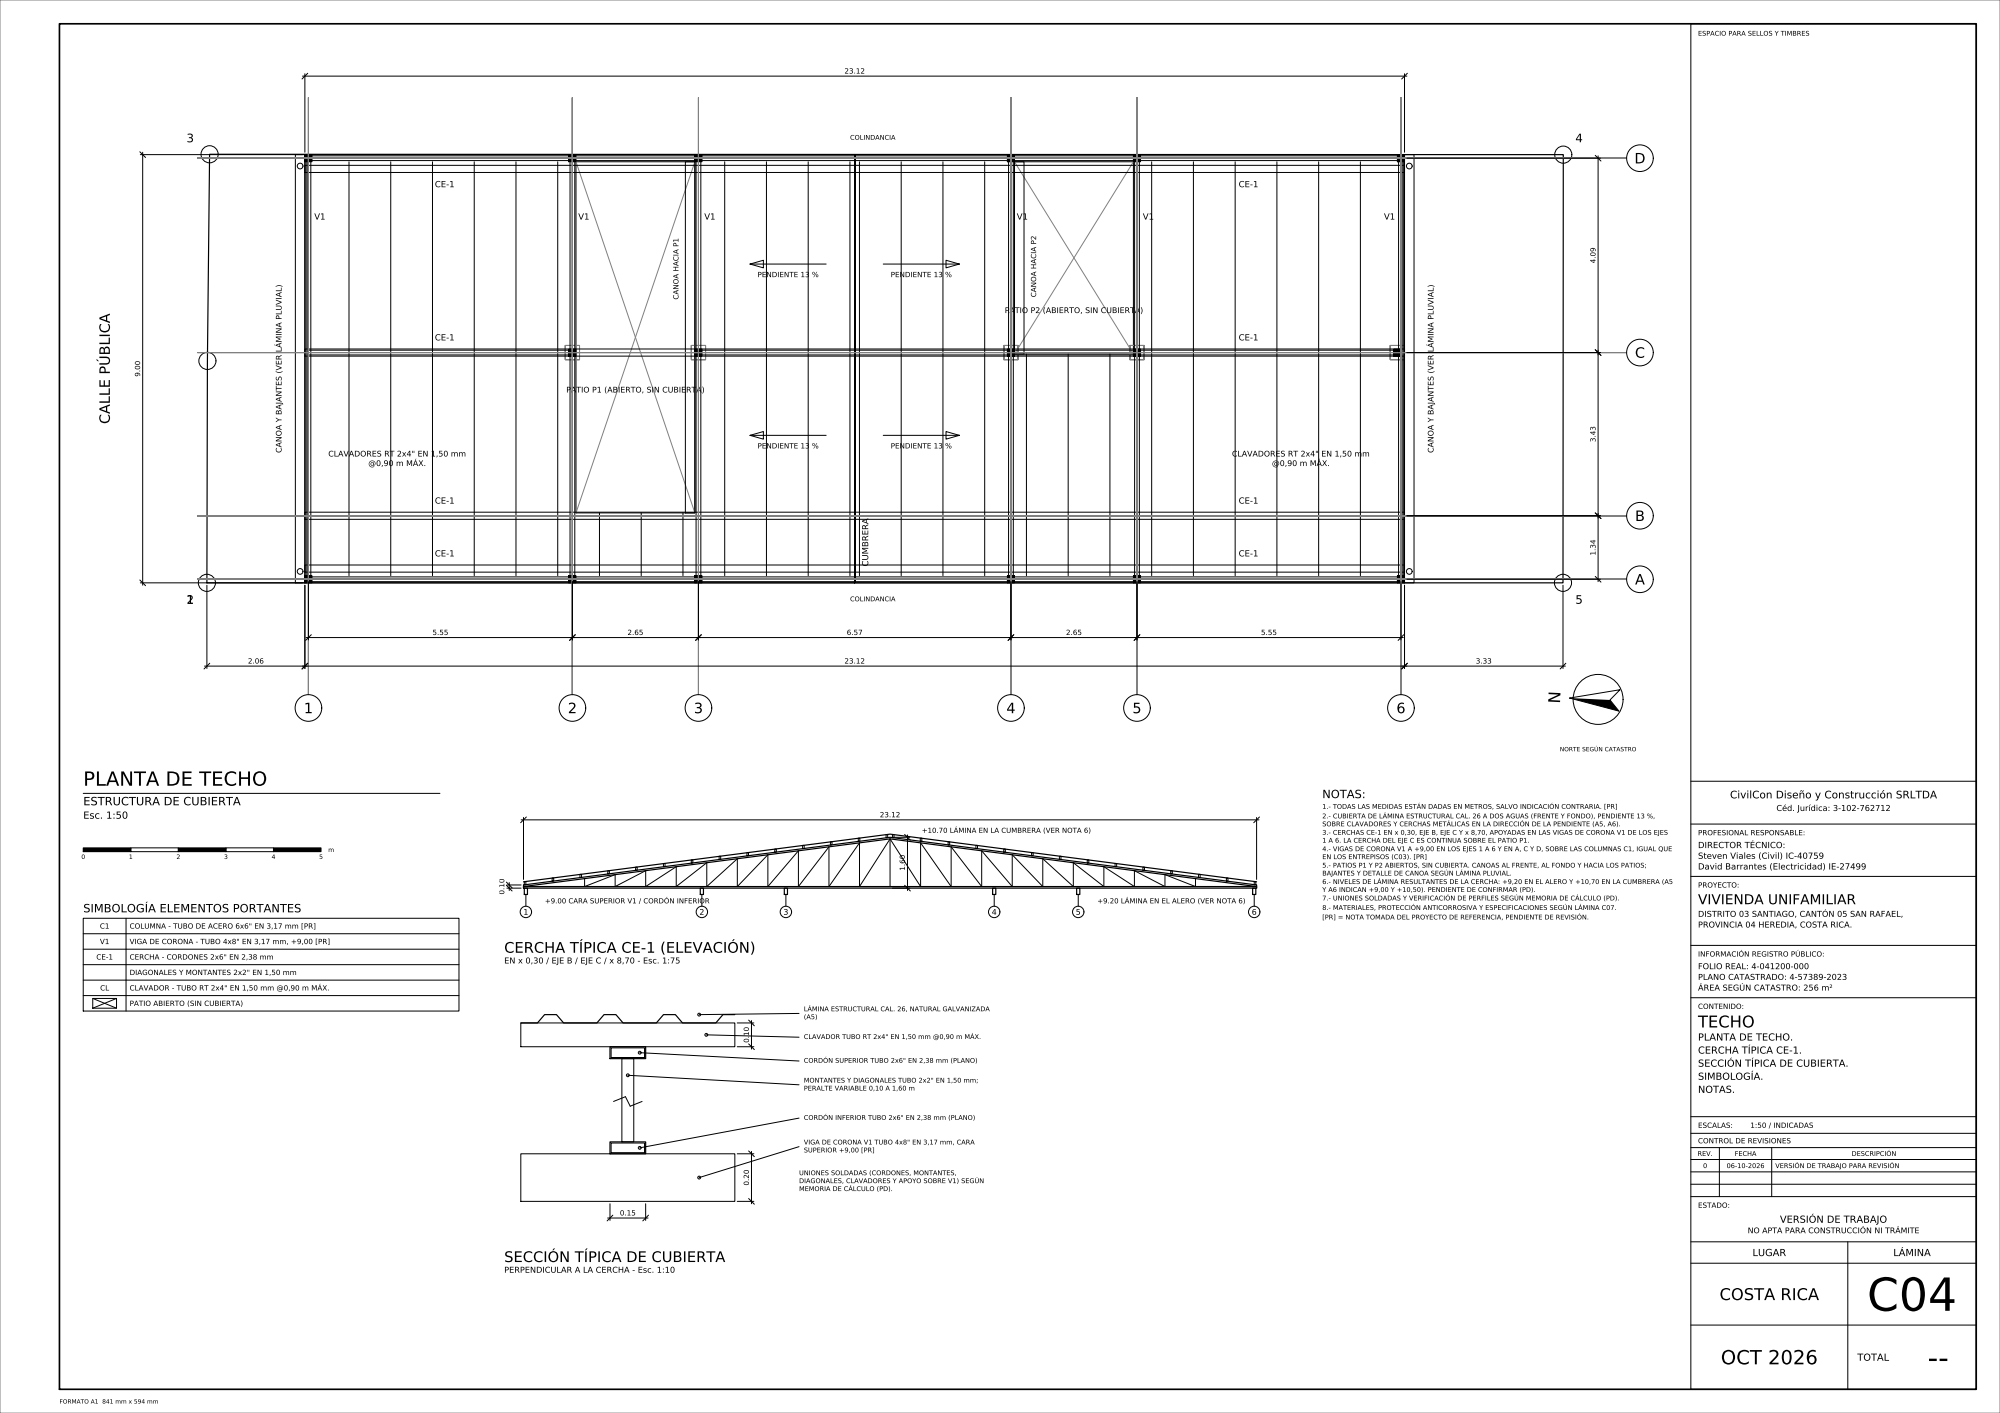
[picture p64: page 1]
