jbarra777/jbarra777/planos/C03_entrepiso_n2/SR-C03_ENTREPISOS_rev1.pdf

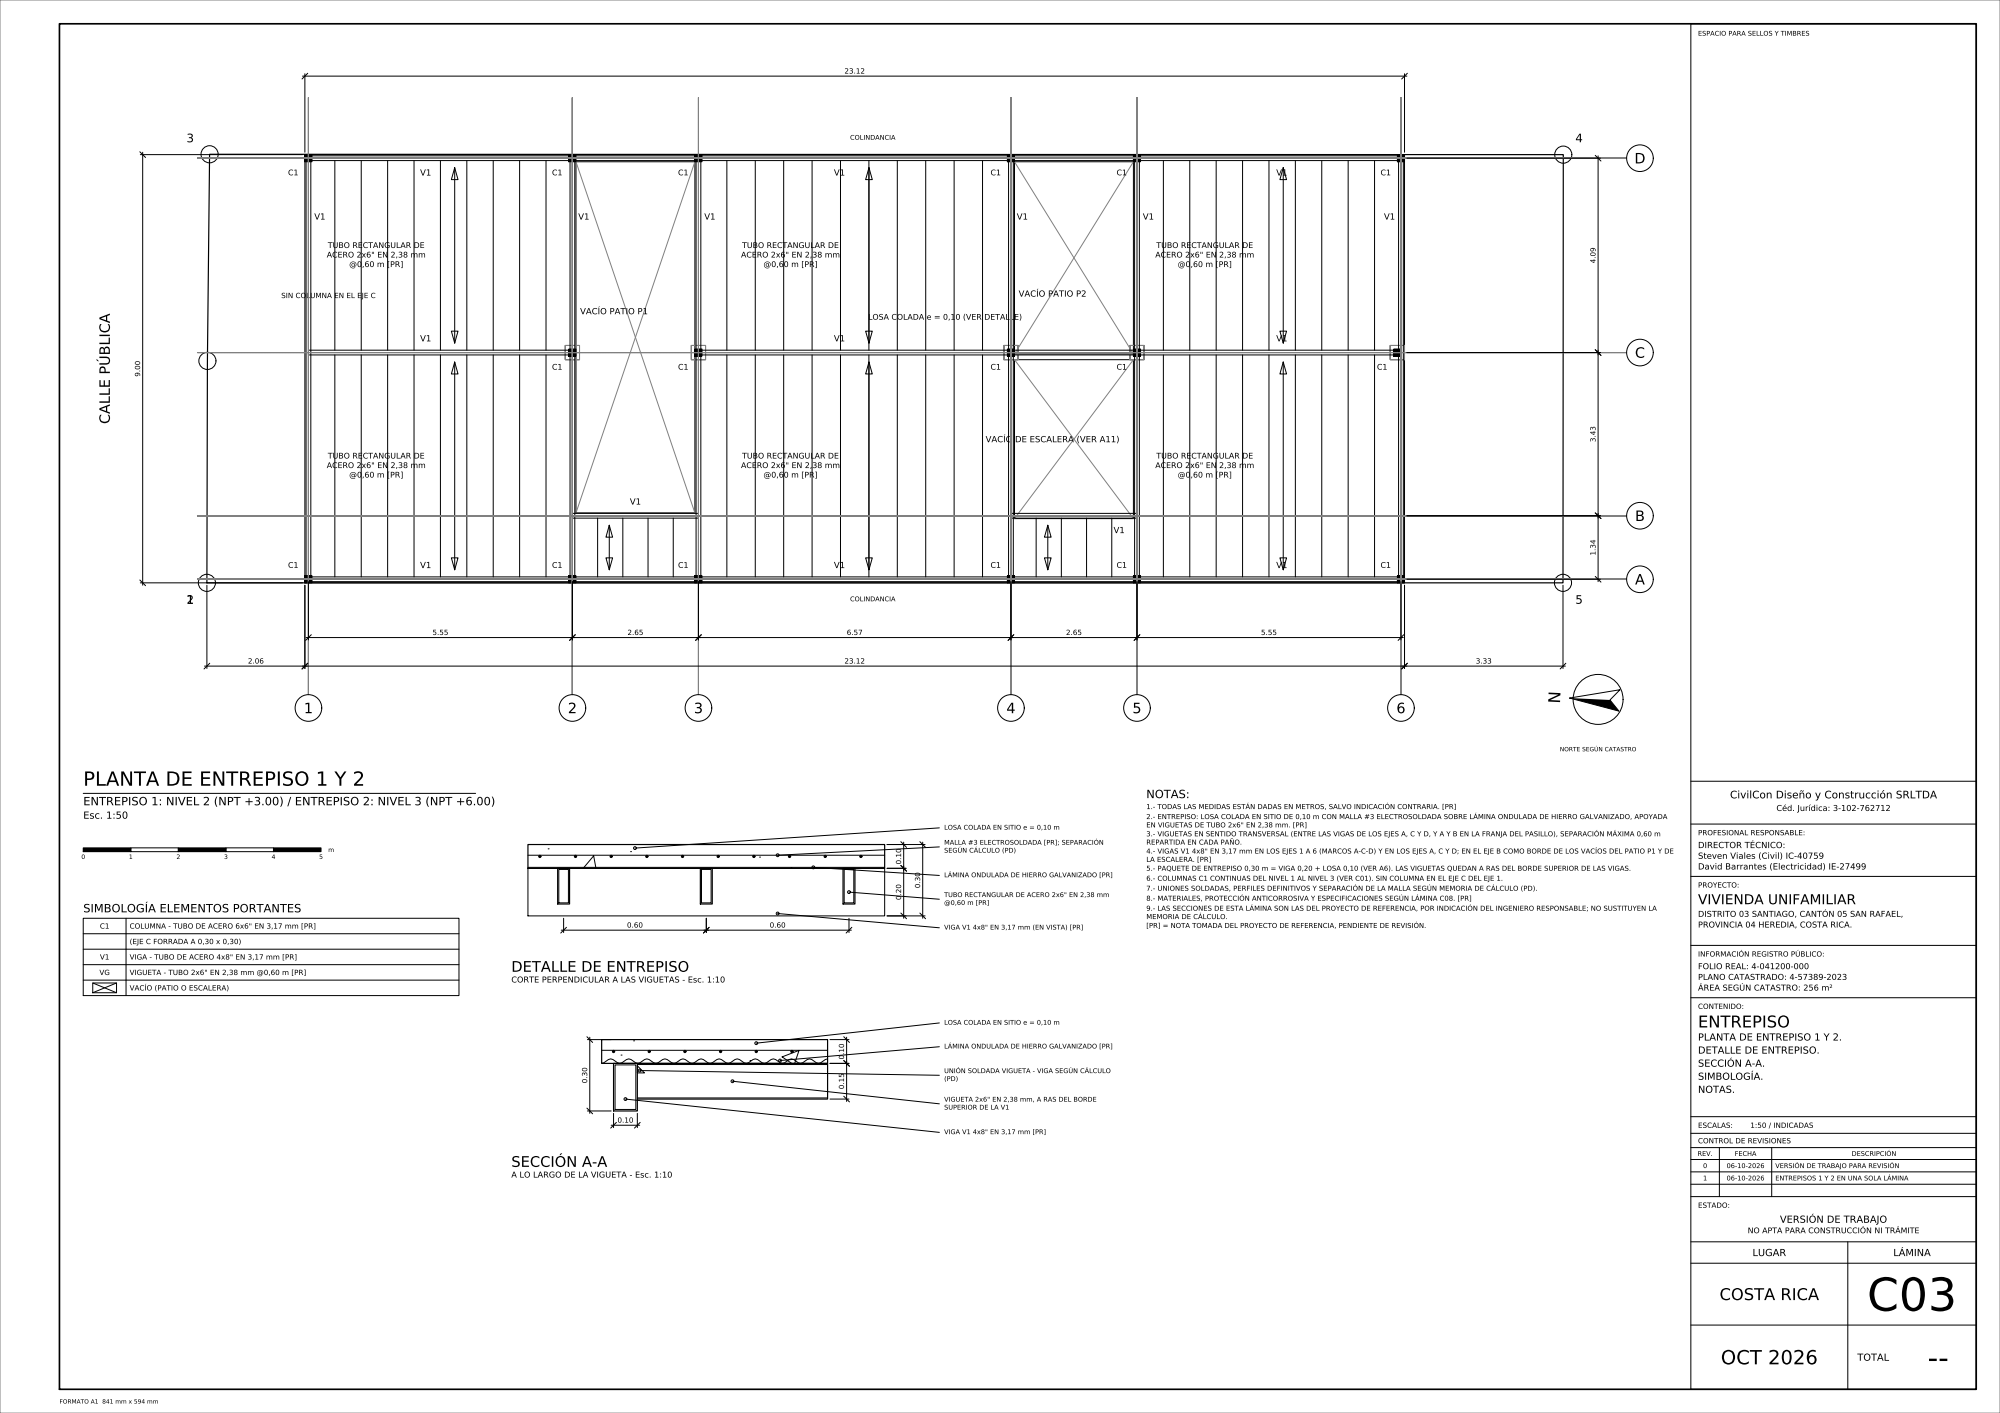
[picture p65: page 1]
