jbarra777/jbarra777/planos/C02_cimentacion_detalles/SR-C02_CIMENTACION_DETALLES_rev0.pdf

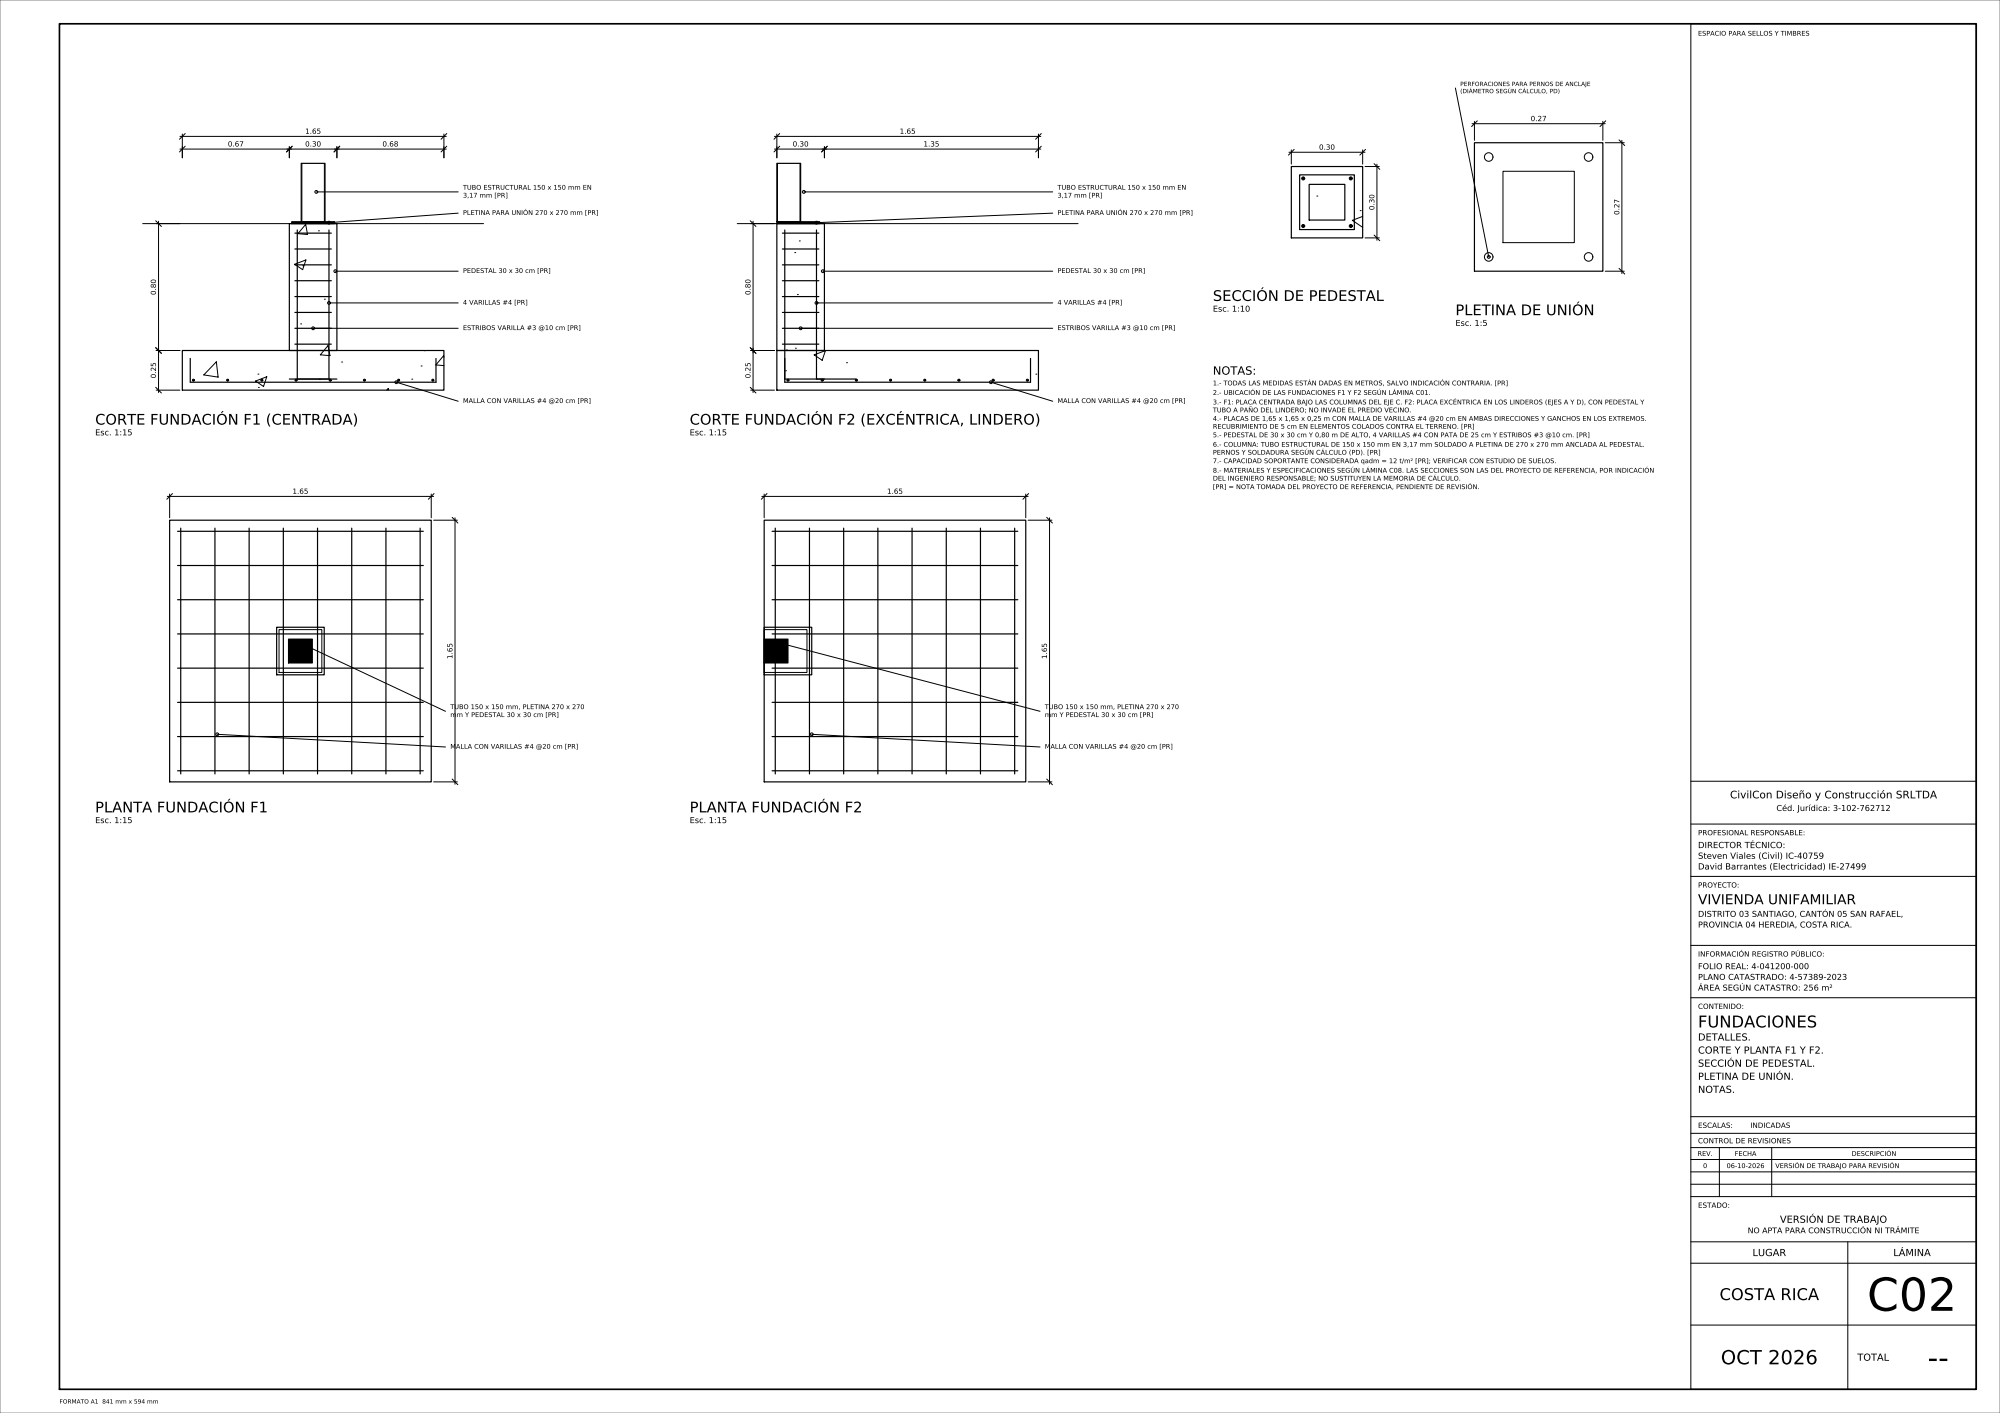
[picture p66: page 1]
