jbarra777/jbarra777/planos/C01_cimentaciones/SR-C01_CIMENTACIONES_rev0.pdf

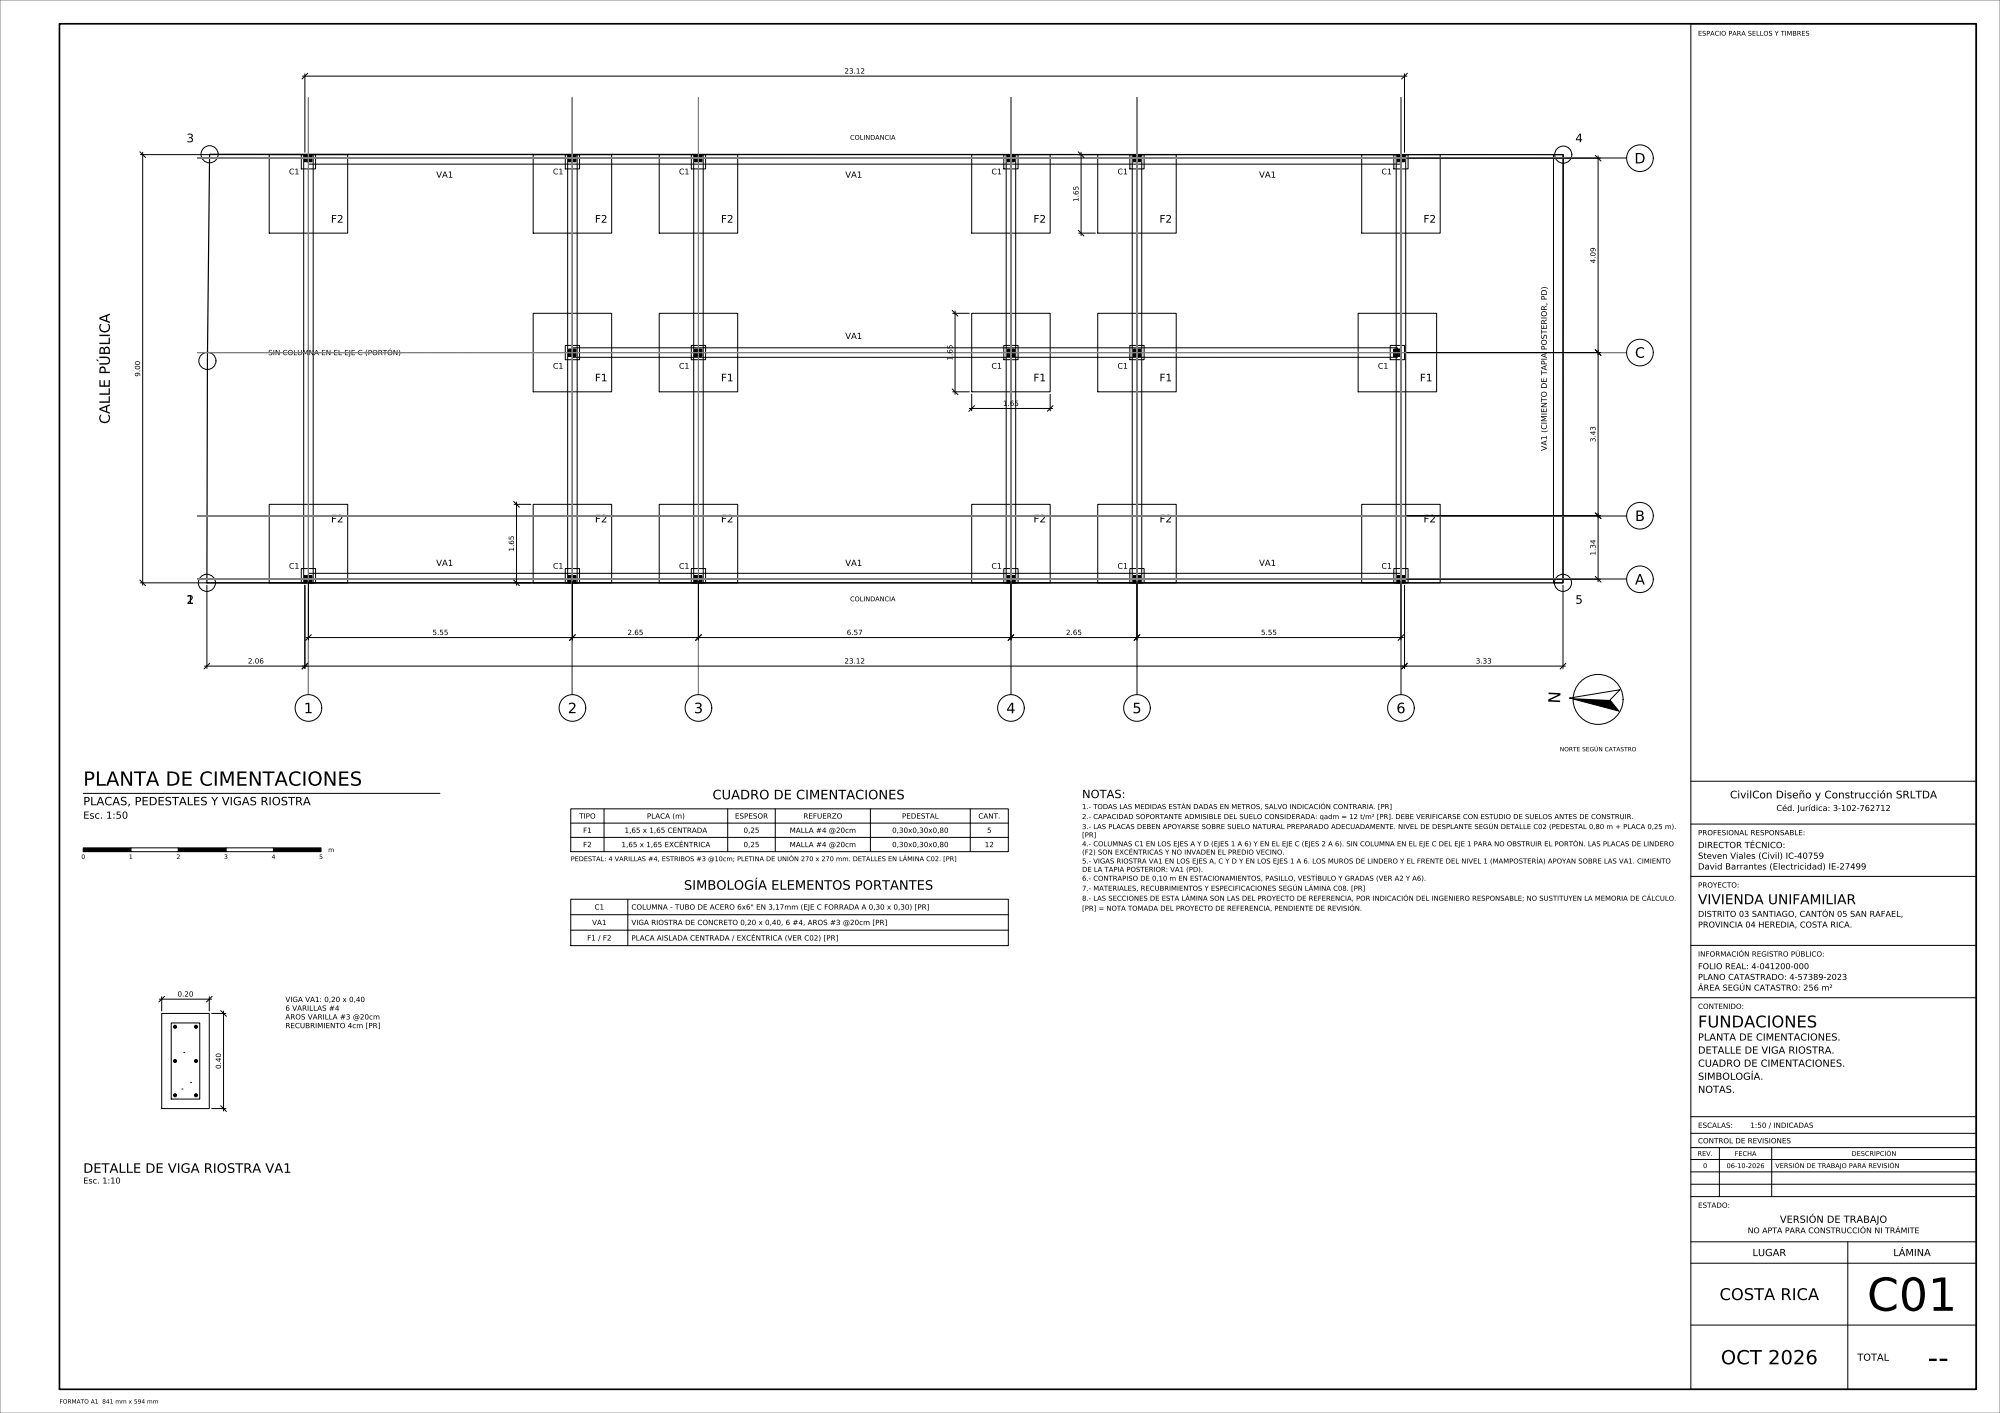
[picture p67: page 1]
