jbarra777/jbarra777/planos/A5_fachadas/SR-A5_FACHADAS_rev5.pdf

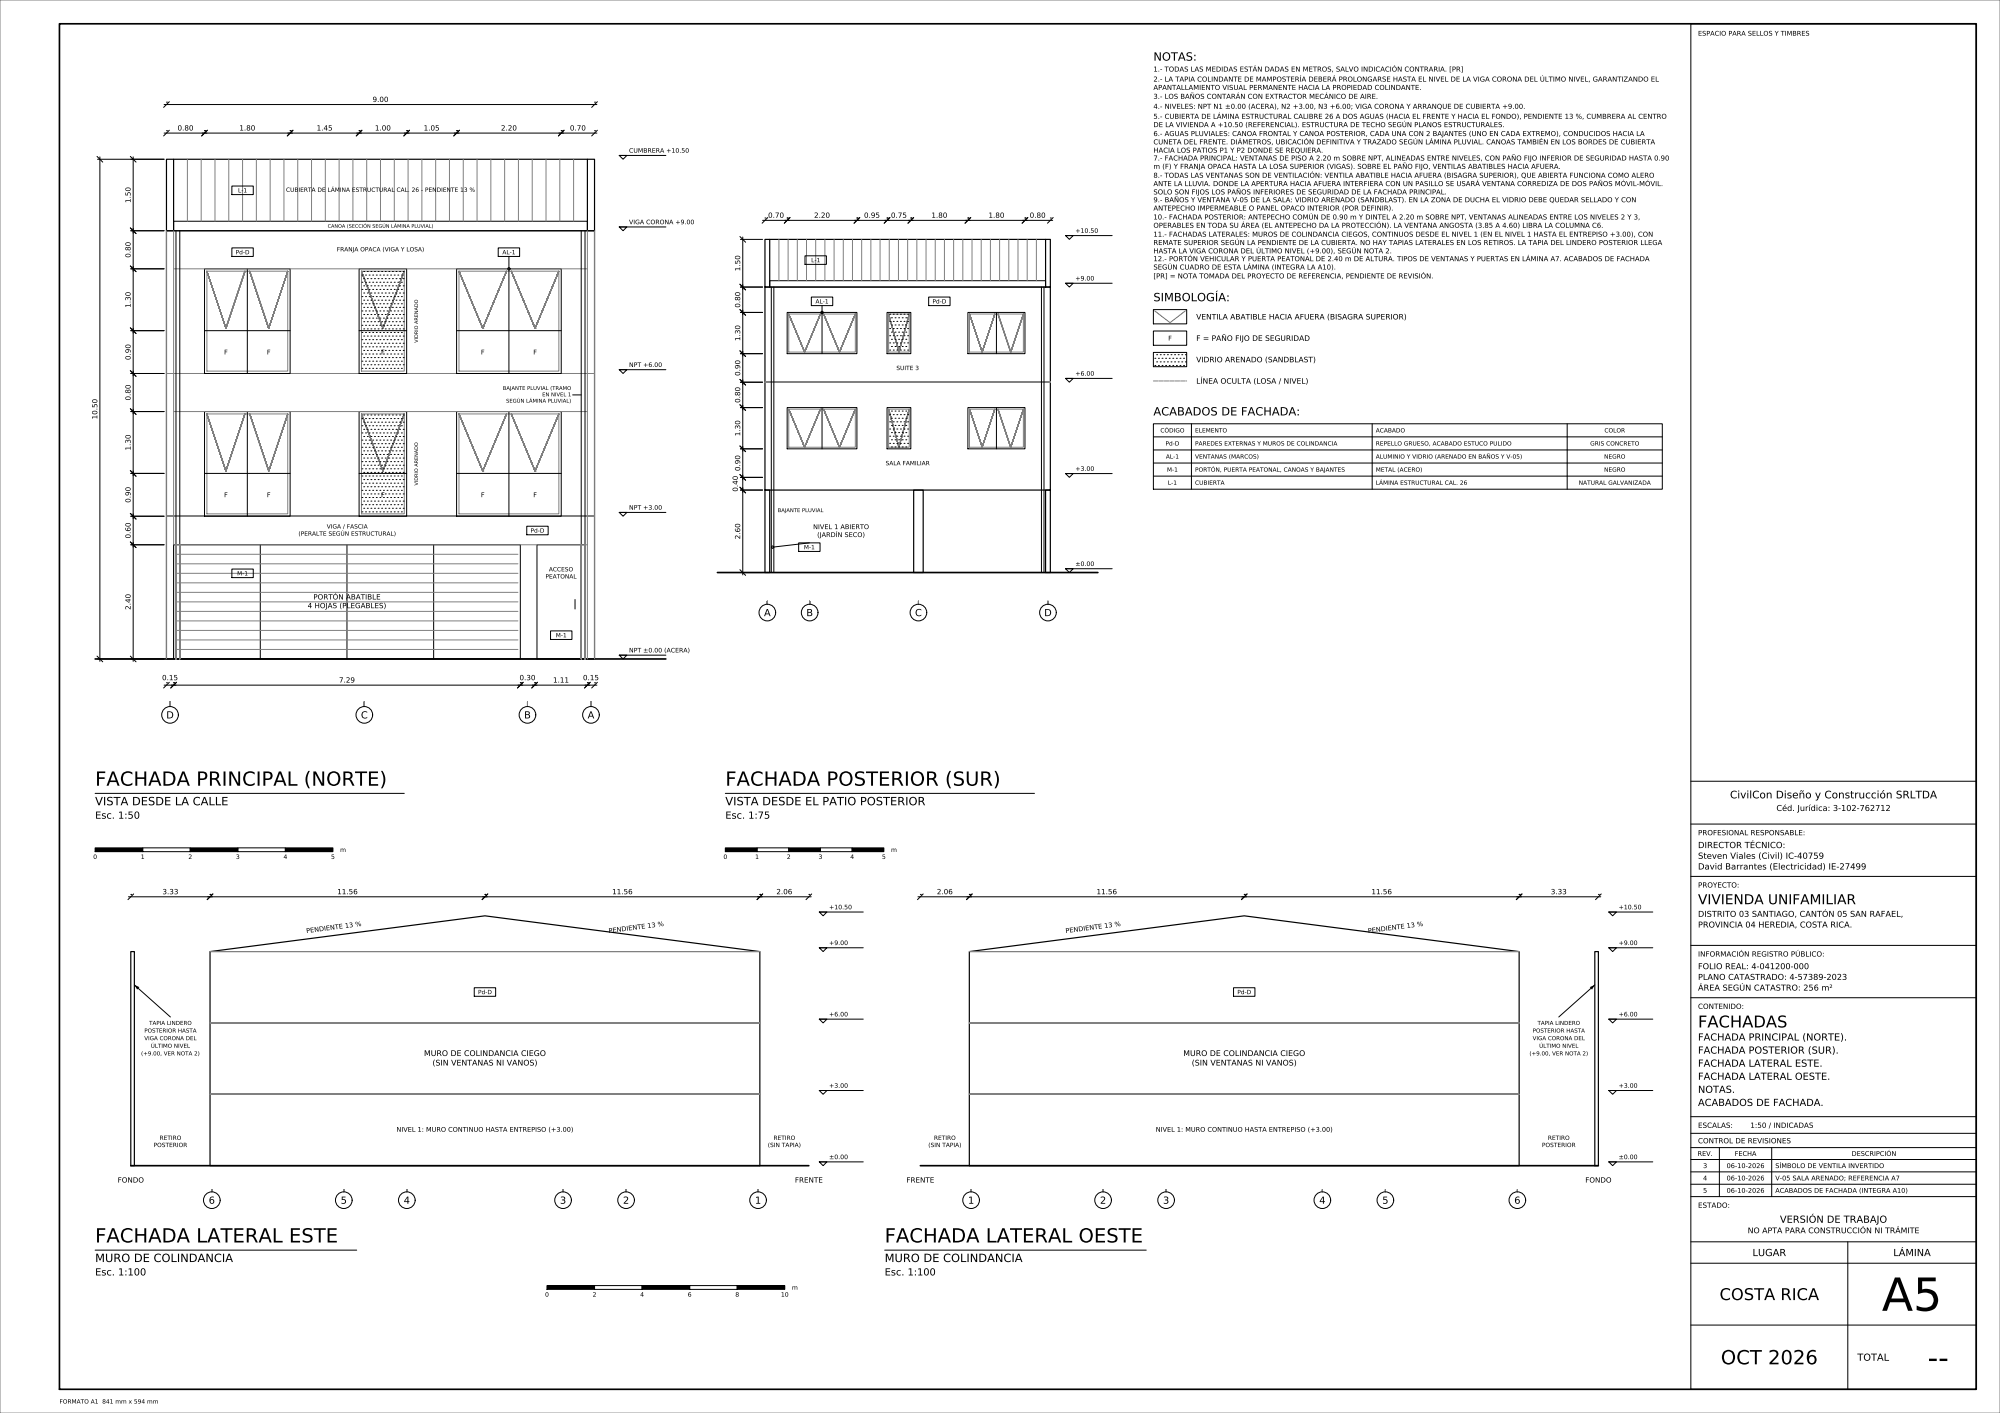
[picture p68: page 1]
