jbarra777/jbarra777/planos/A11_escalera/SR-A11_ESCALERA_rev0.pdf

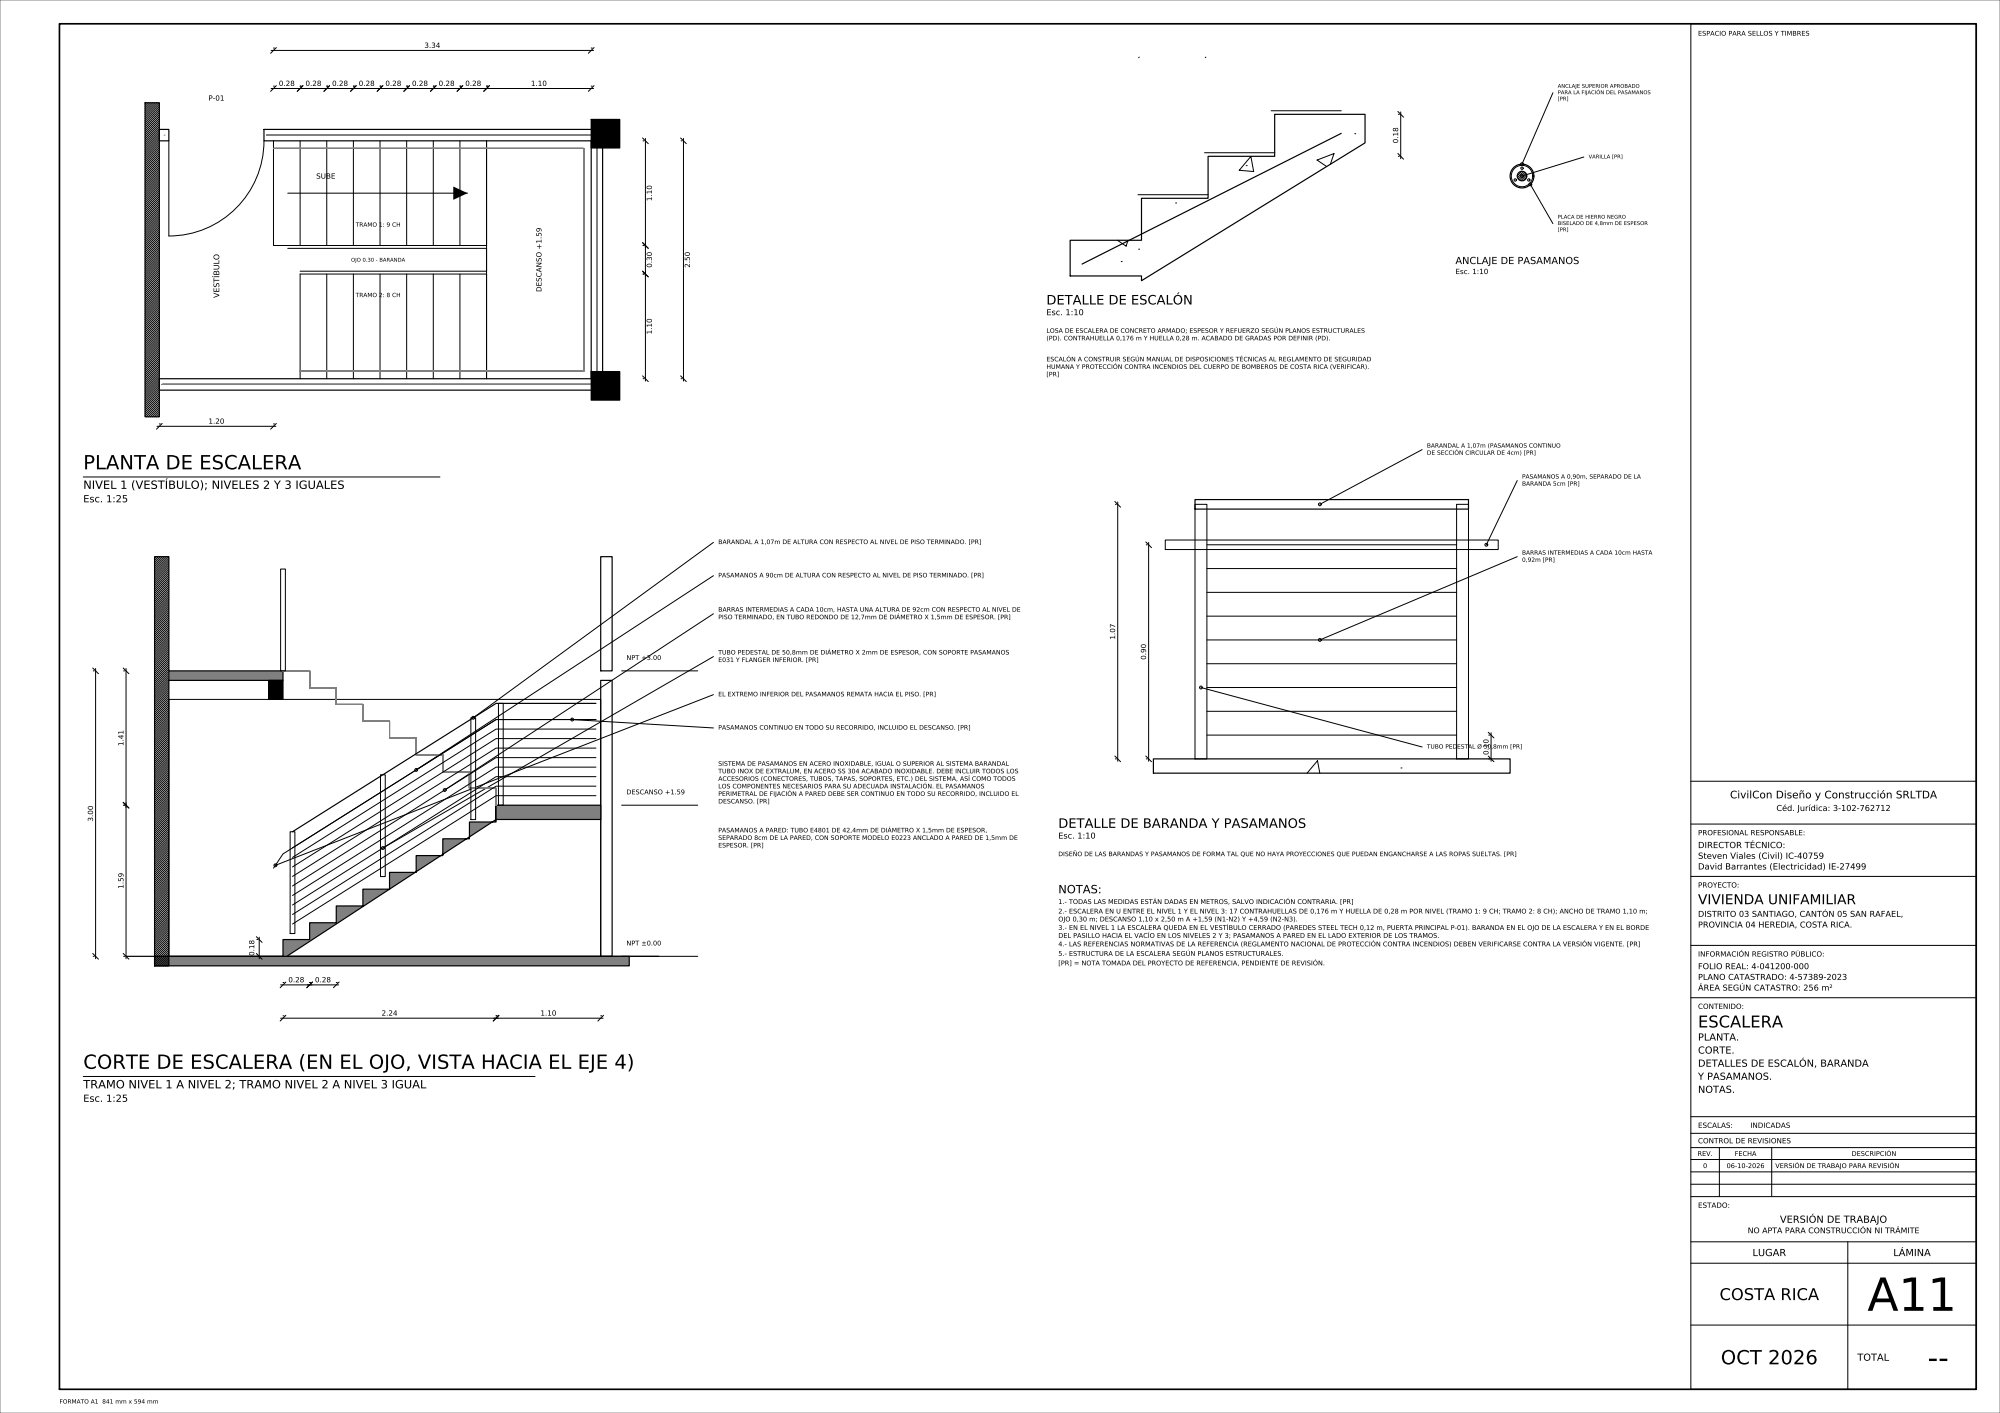
[picture p69: page 1]
