jbarra777/jbarra777/planos/A6_cortes/SR-A6_CORTES_rev3.pdf

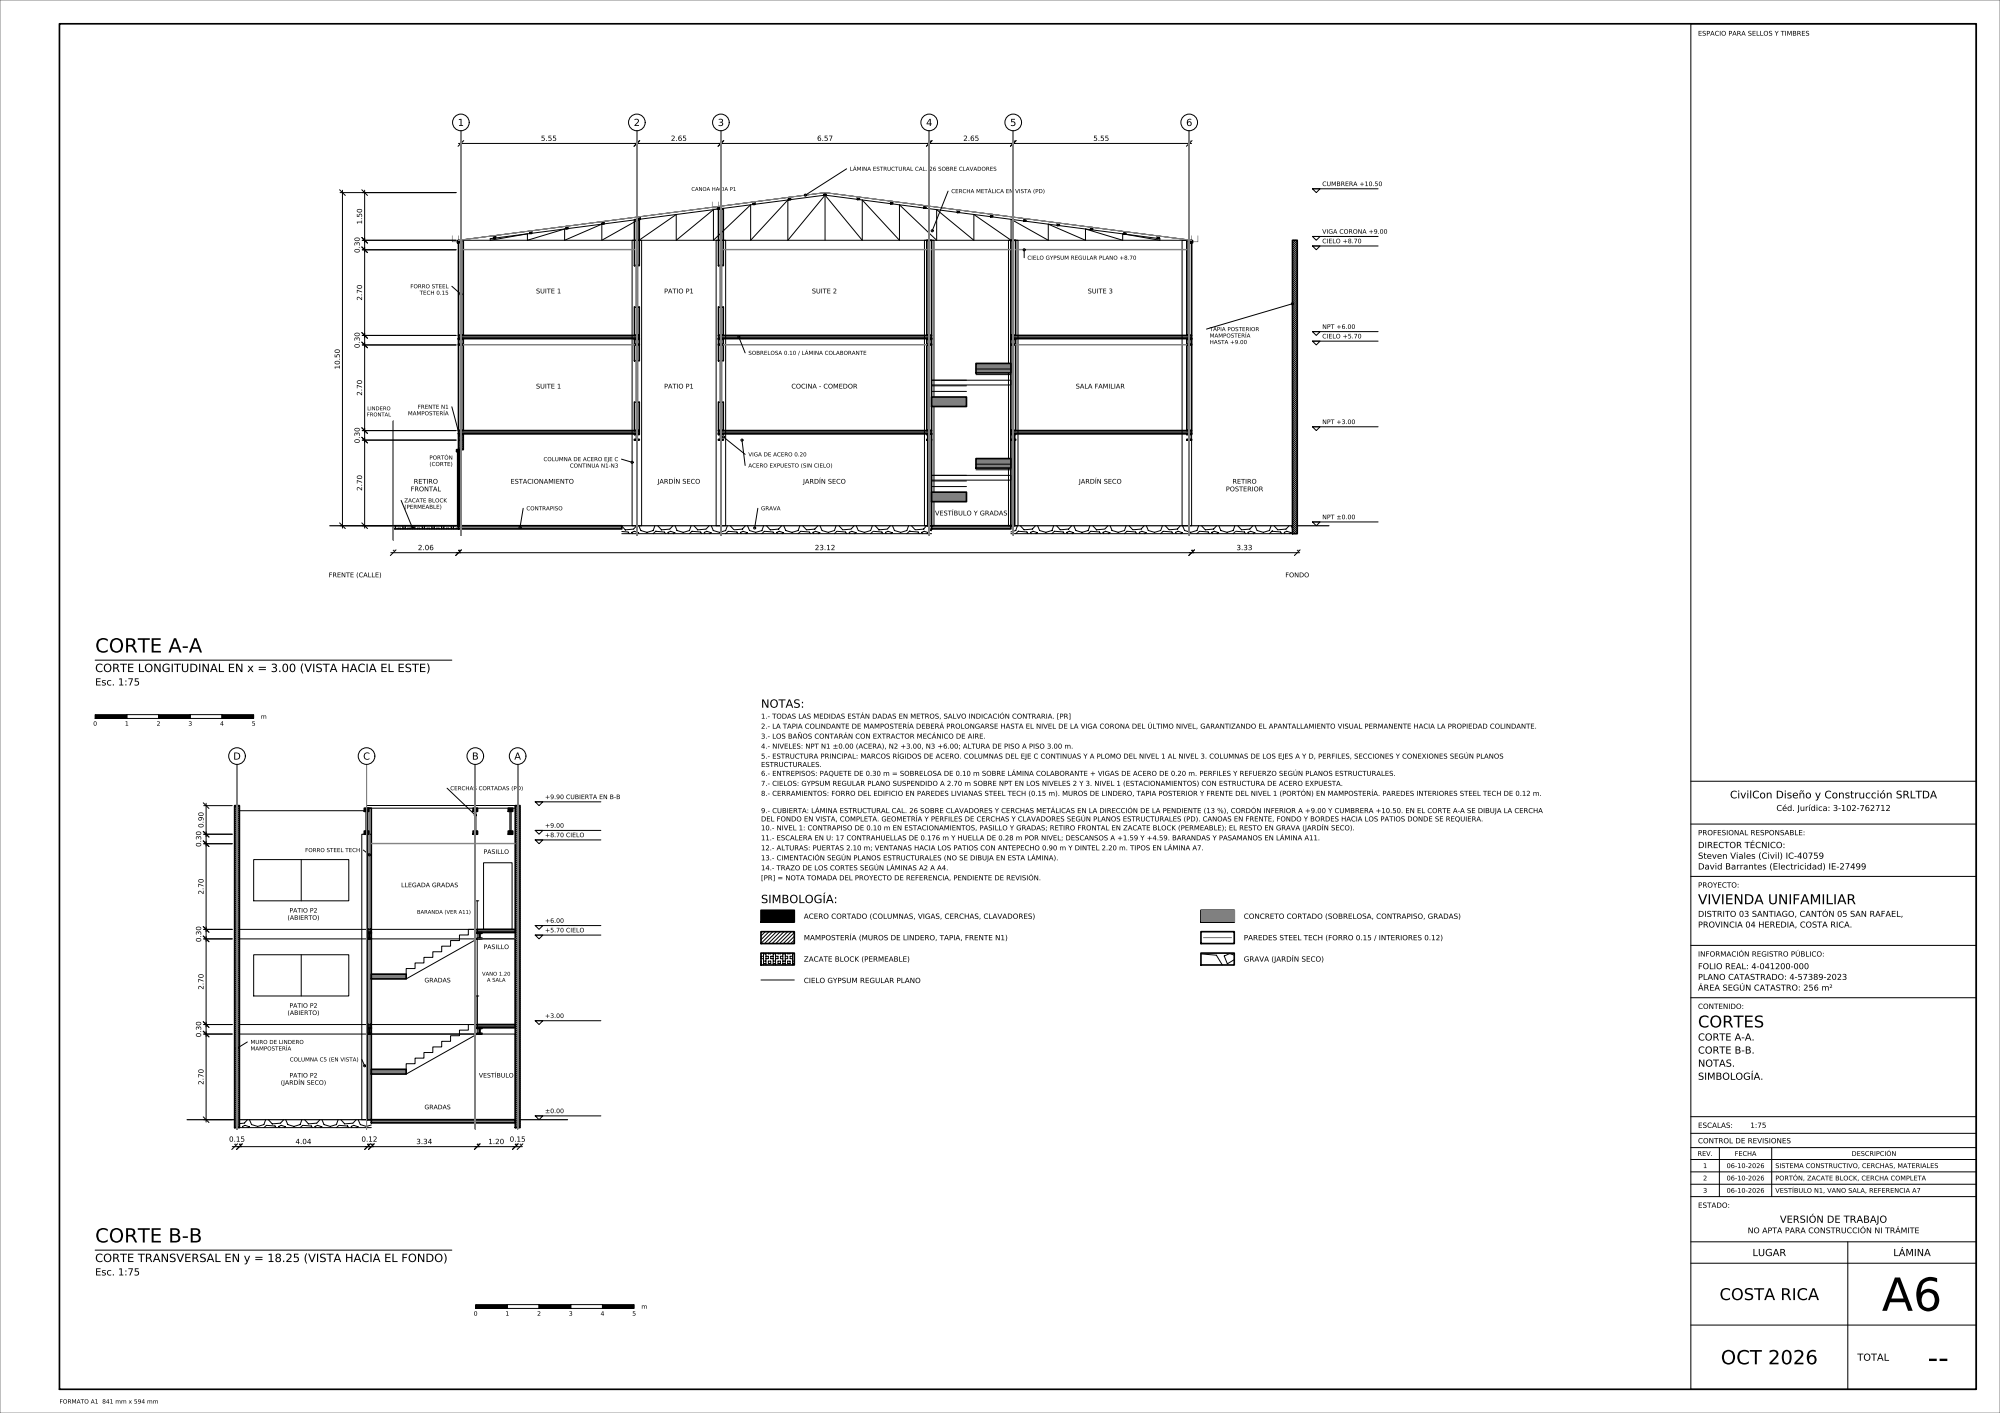
[picture p70: page 1]
