jbarra777/jbarra777/planos/A5_fachadas/SR-A5_FACHADAS_rev4.pdf

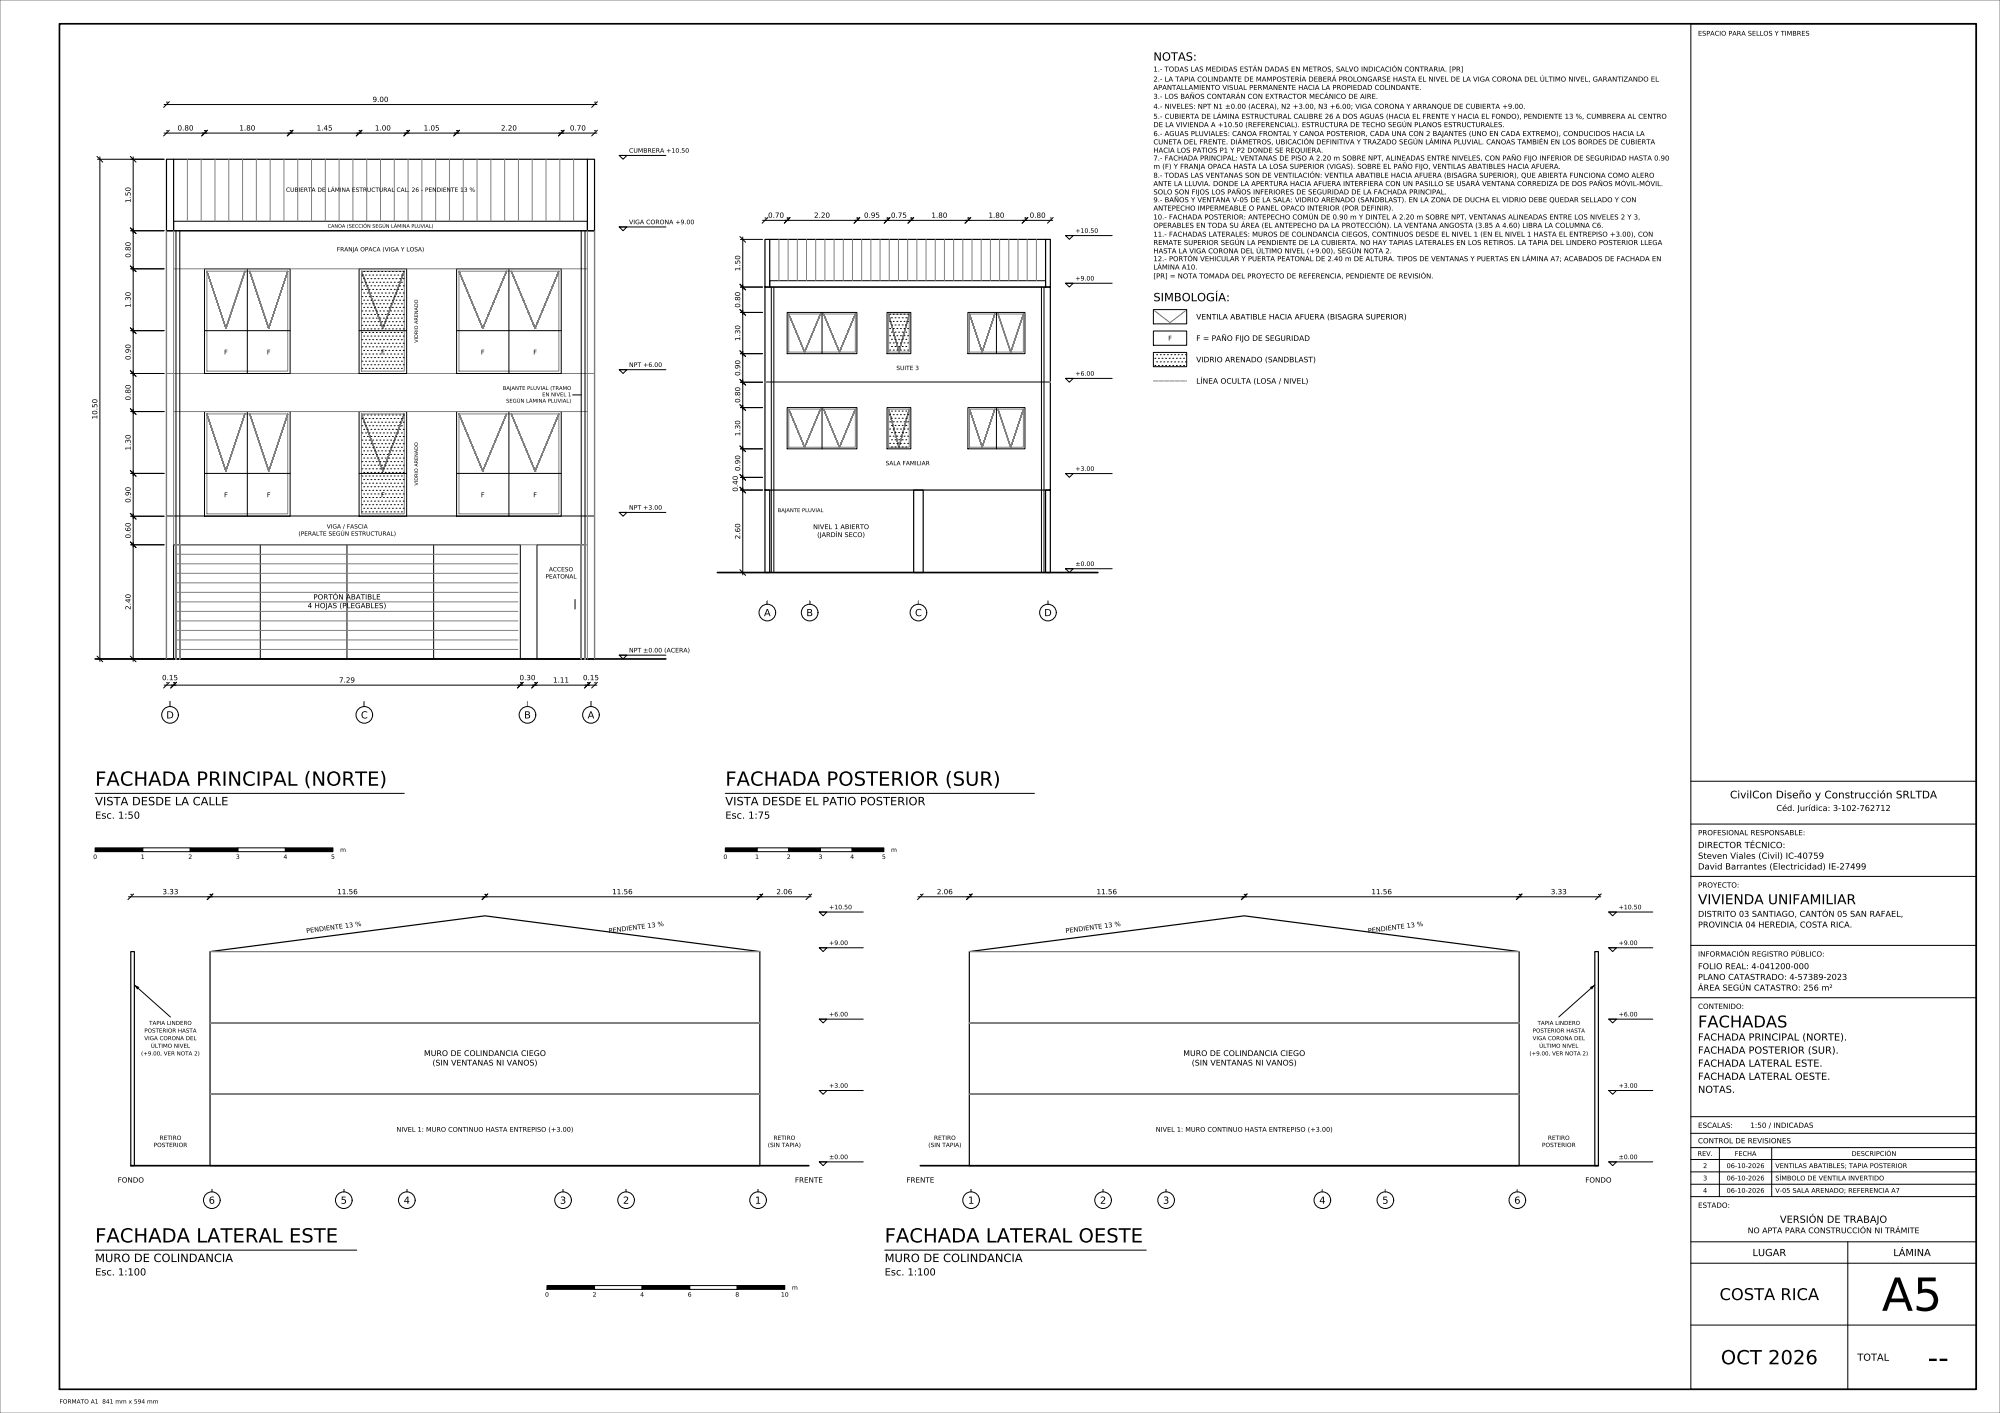
[picture p71: page 1]
