jbarra777/jbarra777/planos/A4_nivel3/SR-A4_NIVEL3_rev3.pdf

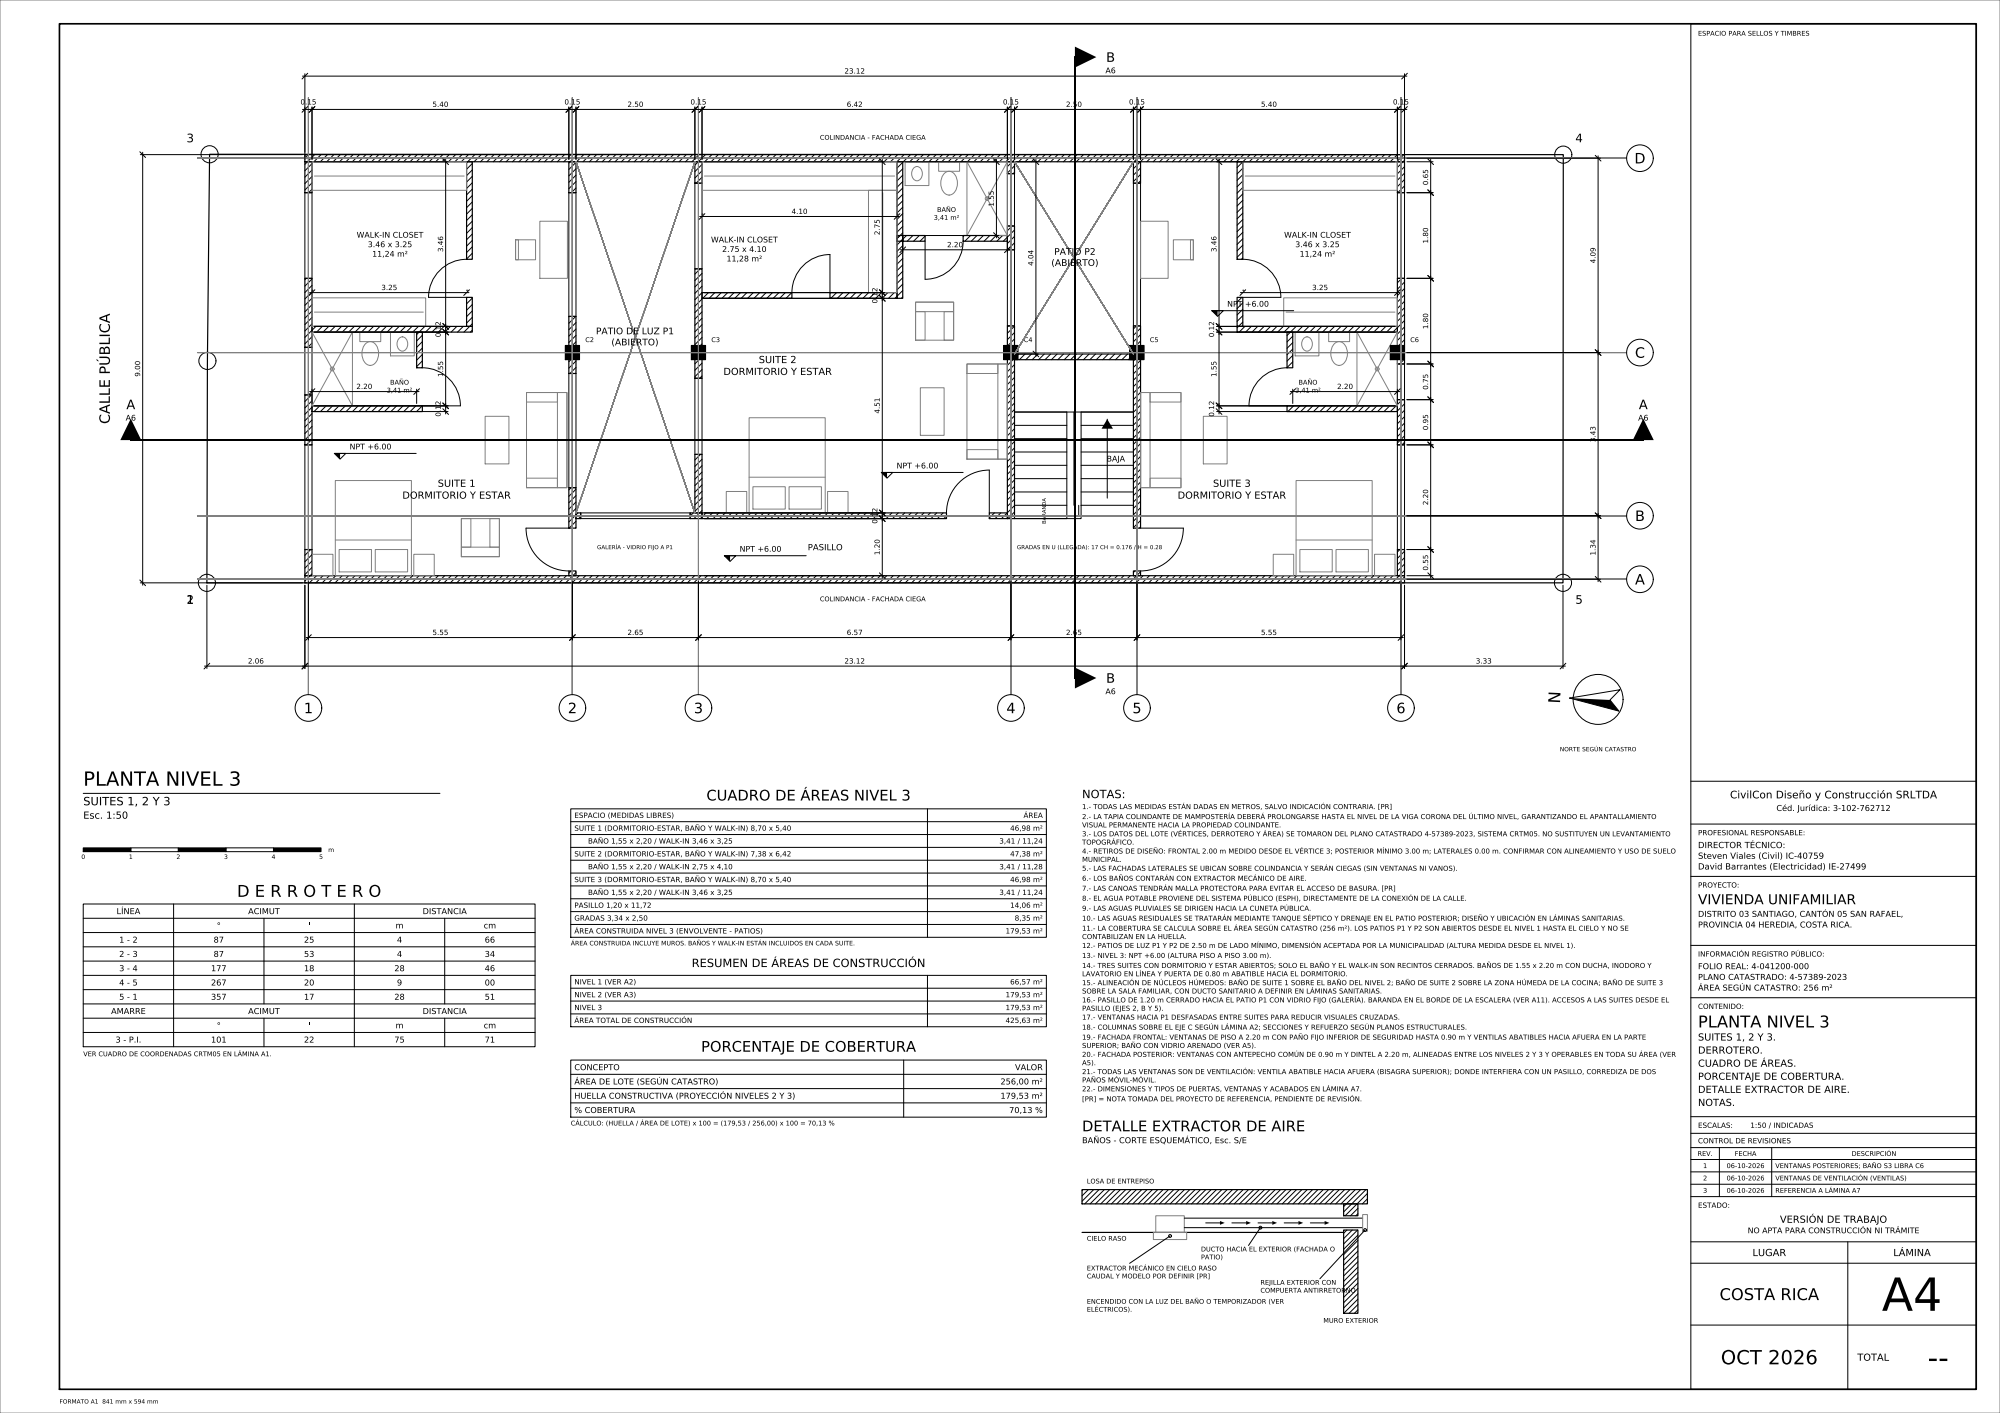
[picture p72: page 1]
