jbarra777/jbarra777/planos/A3_nivel2/SR-A3_NIVEL2_rev3.pdf

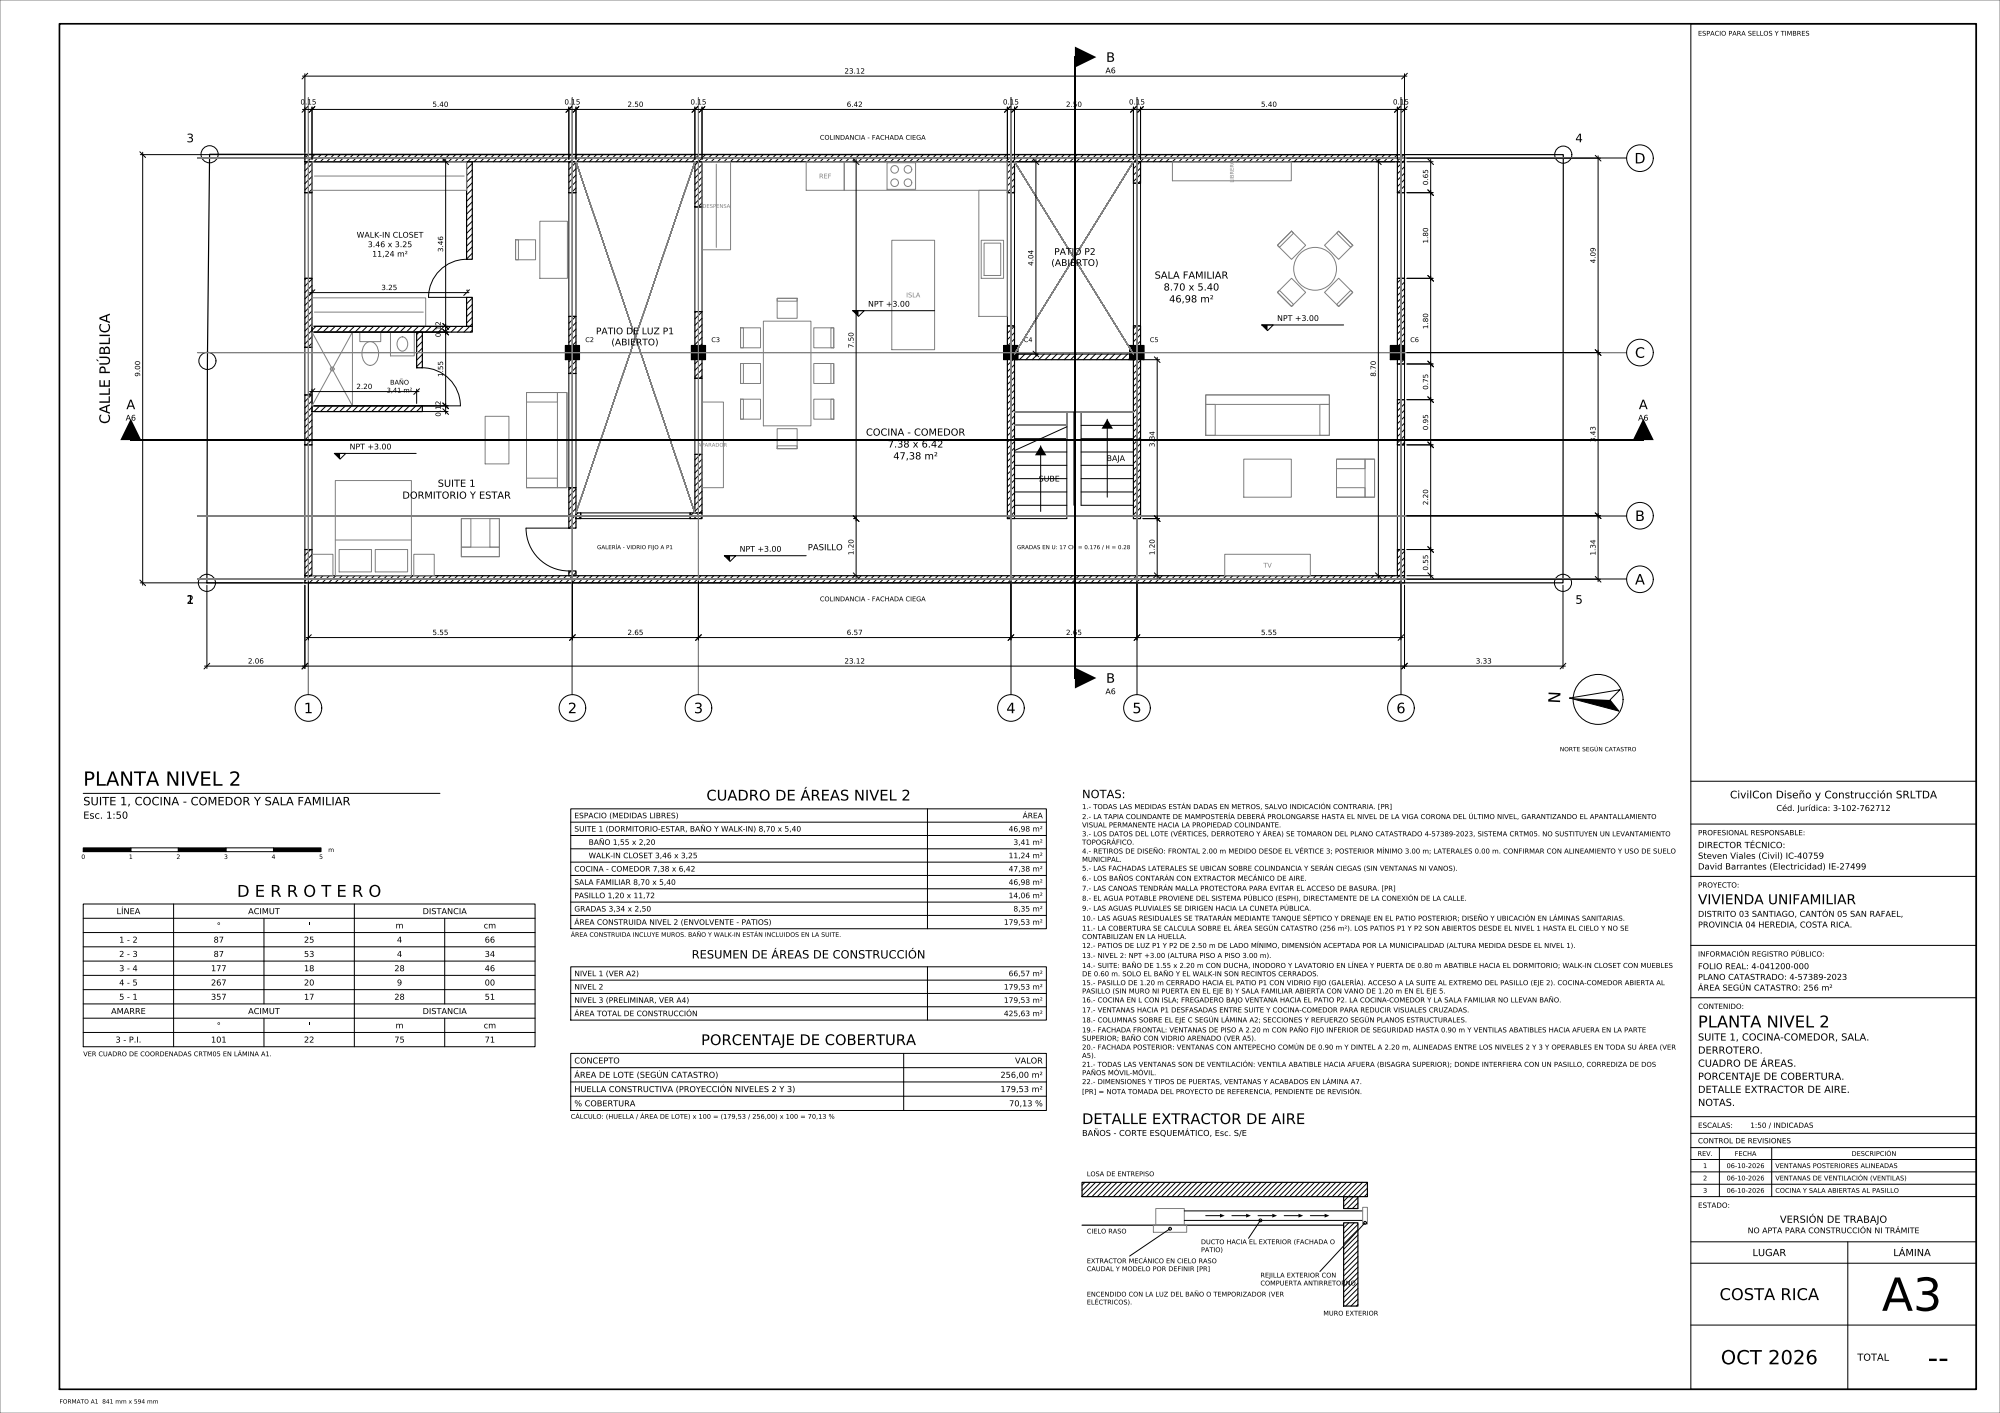
[picture p73: page 1]
