jbarra777/jbarra777/planos/A2_nivel1/SR-A2_NIVEL1_rev3.pdf

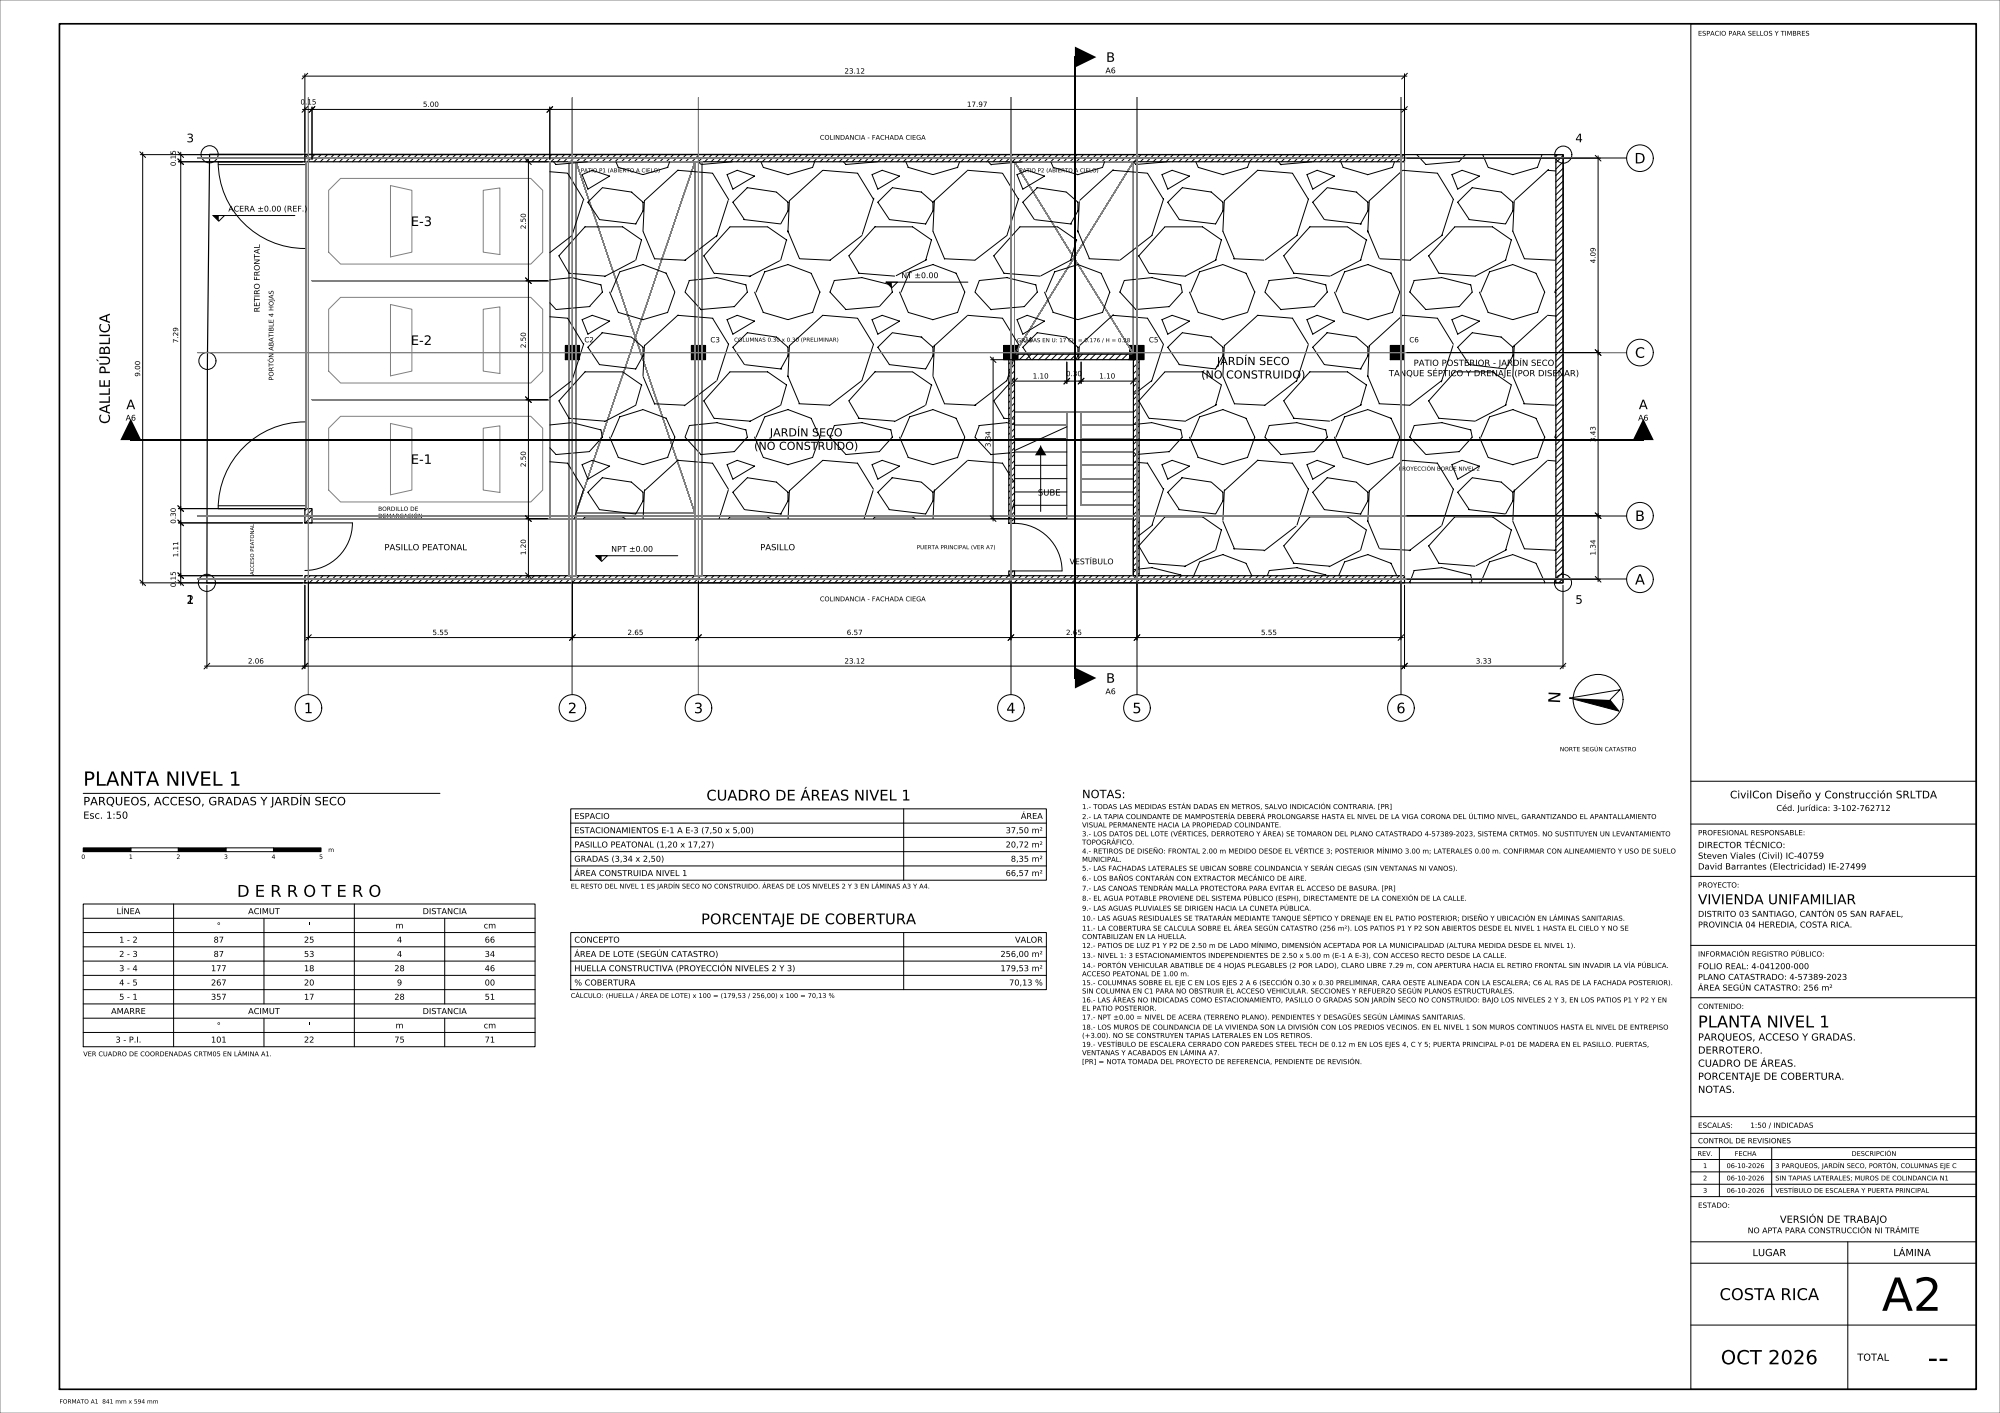
[picture p74: page 1]
