jbarra777/jbarra777/planos/A7_puertas_ventanas/SR-A7_PUERTAS_VENTANAS_rev1.pdf

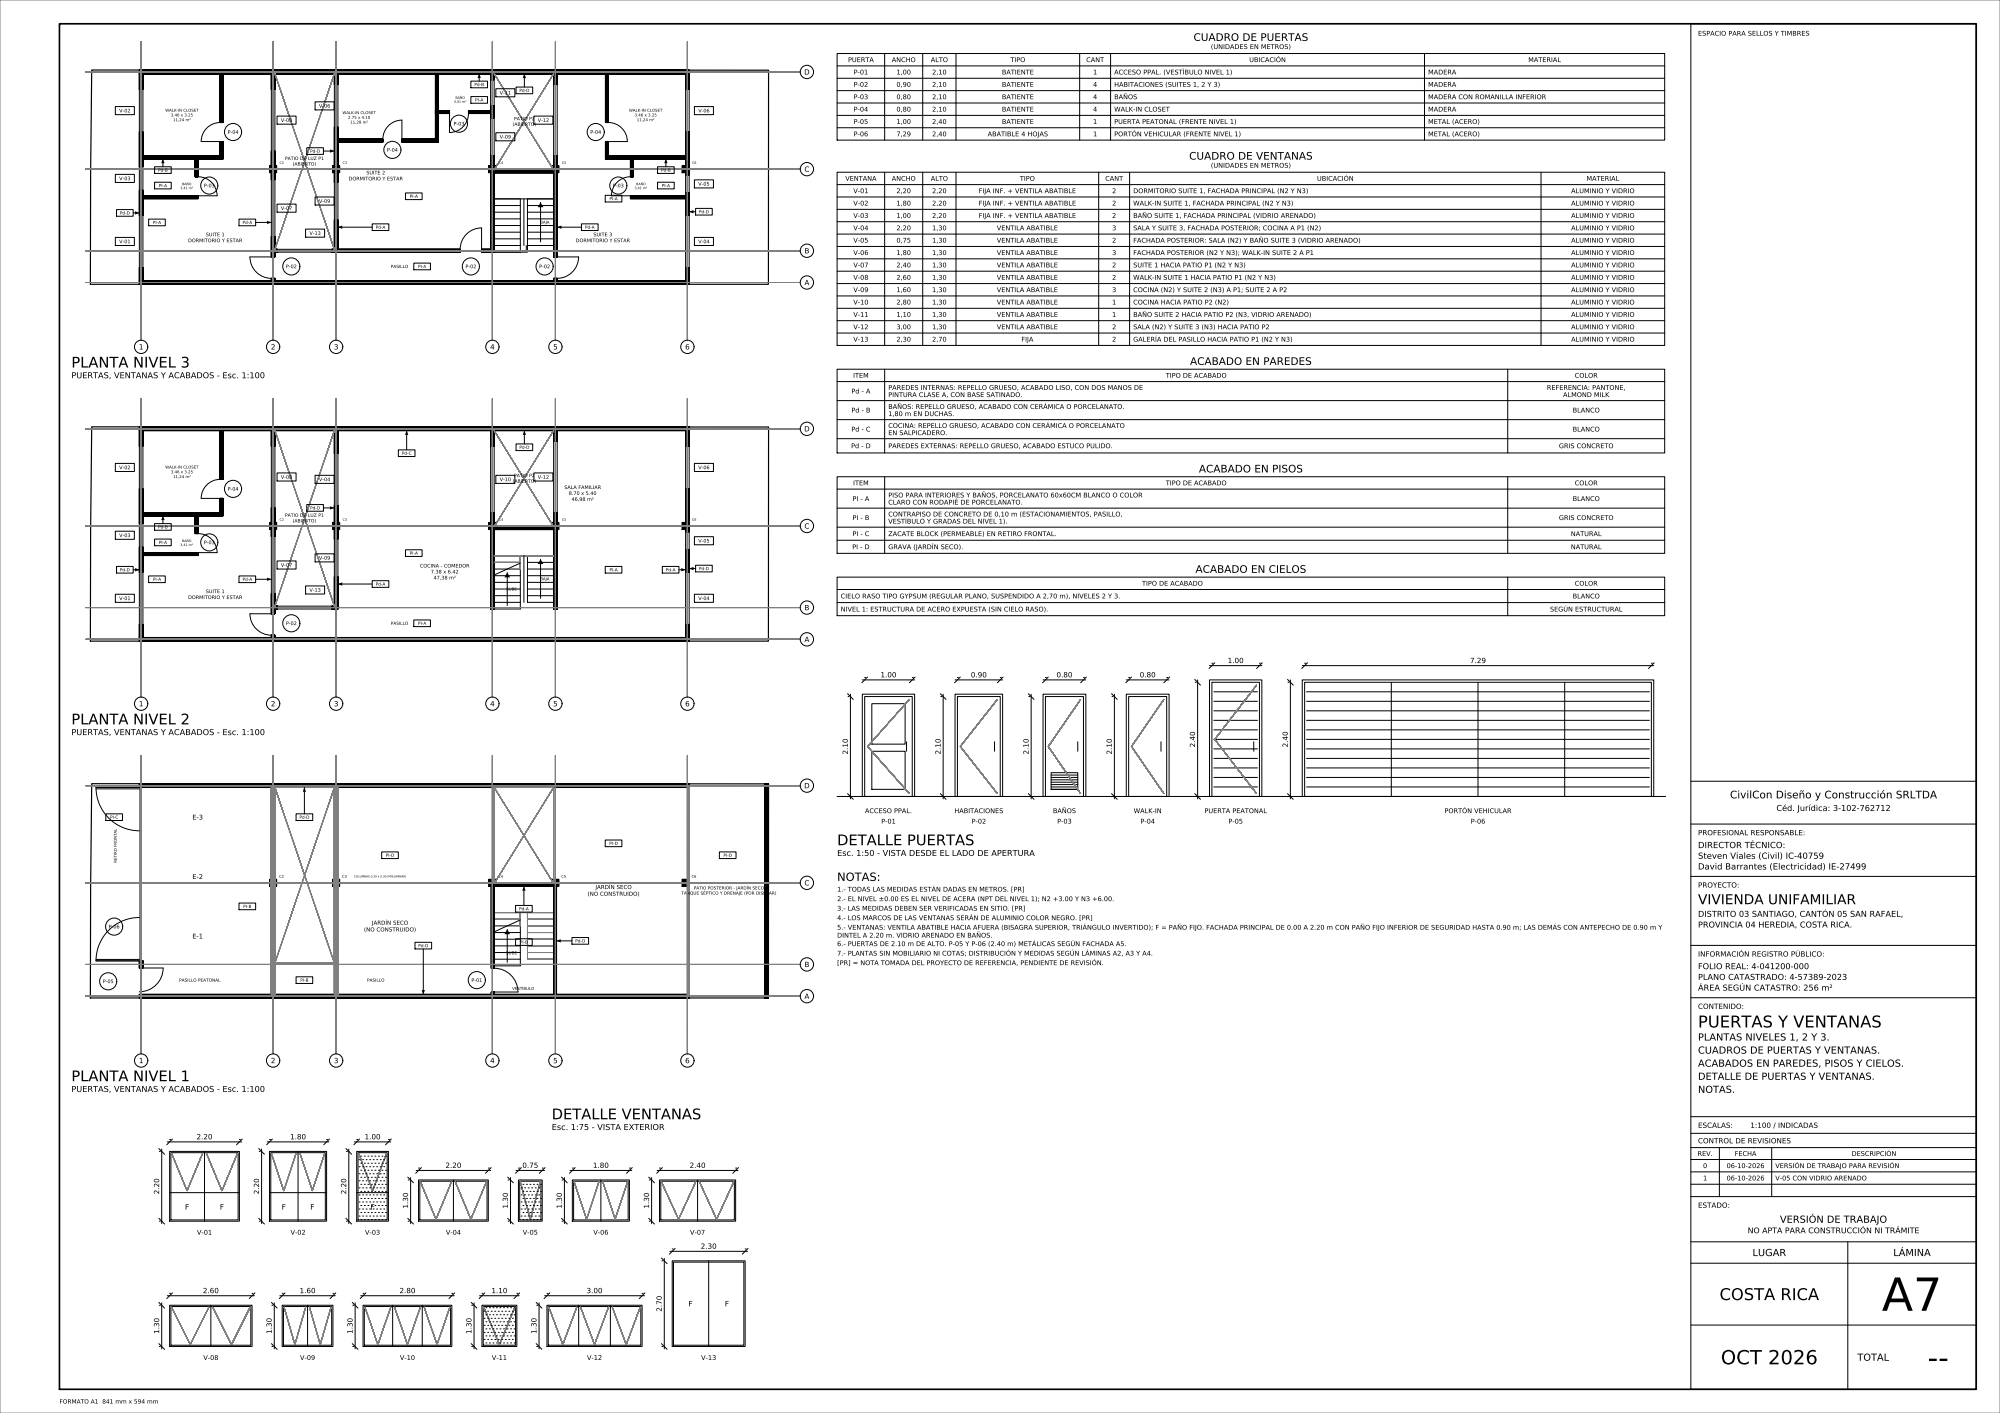
[picture p75: page 1]
