jbarra777/jbarra777/planos/A7_puertas_ventanas/SR-A7_PUERTAS_VENTANAS_rev0.pdf

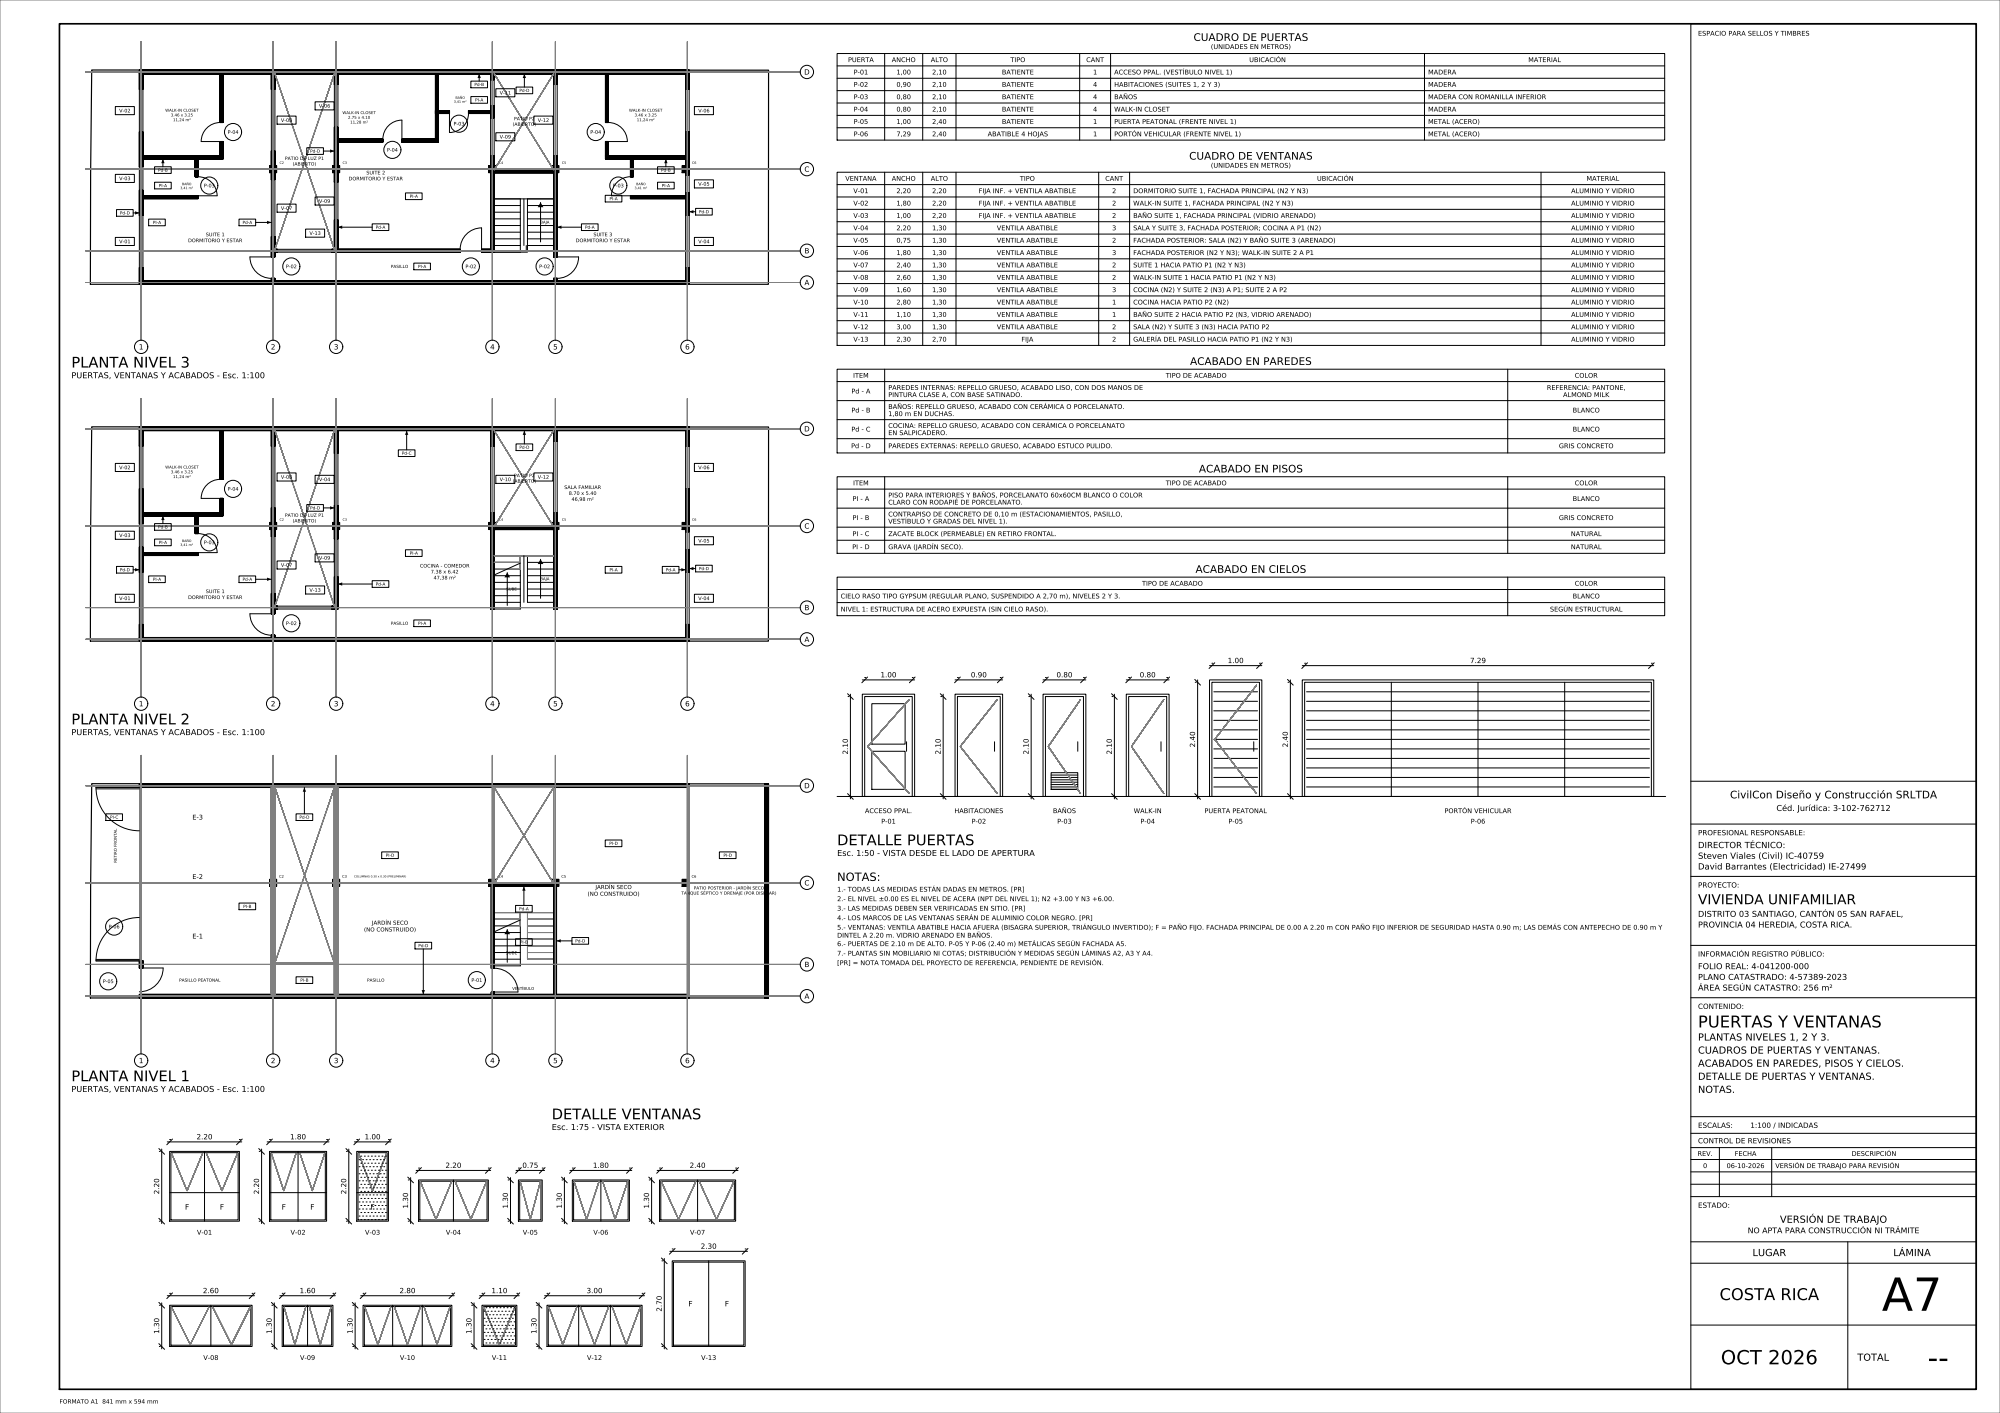
[picture p76: page 1]
