jbarra777/jbarra777/planos/A6_cortes/SR-A6_CORTES_rev2.pdf

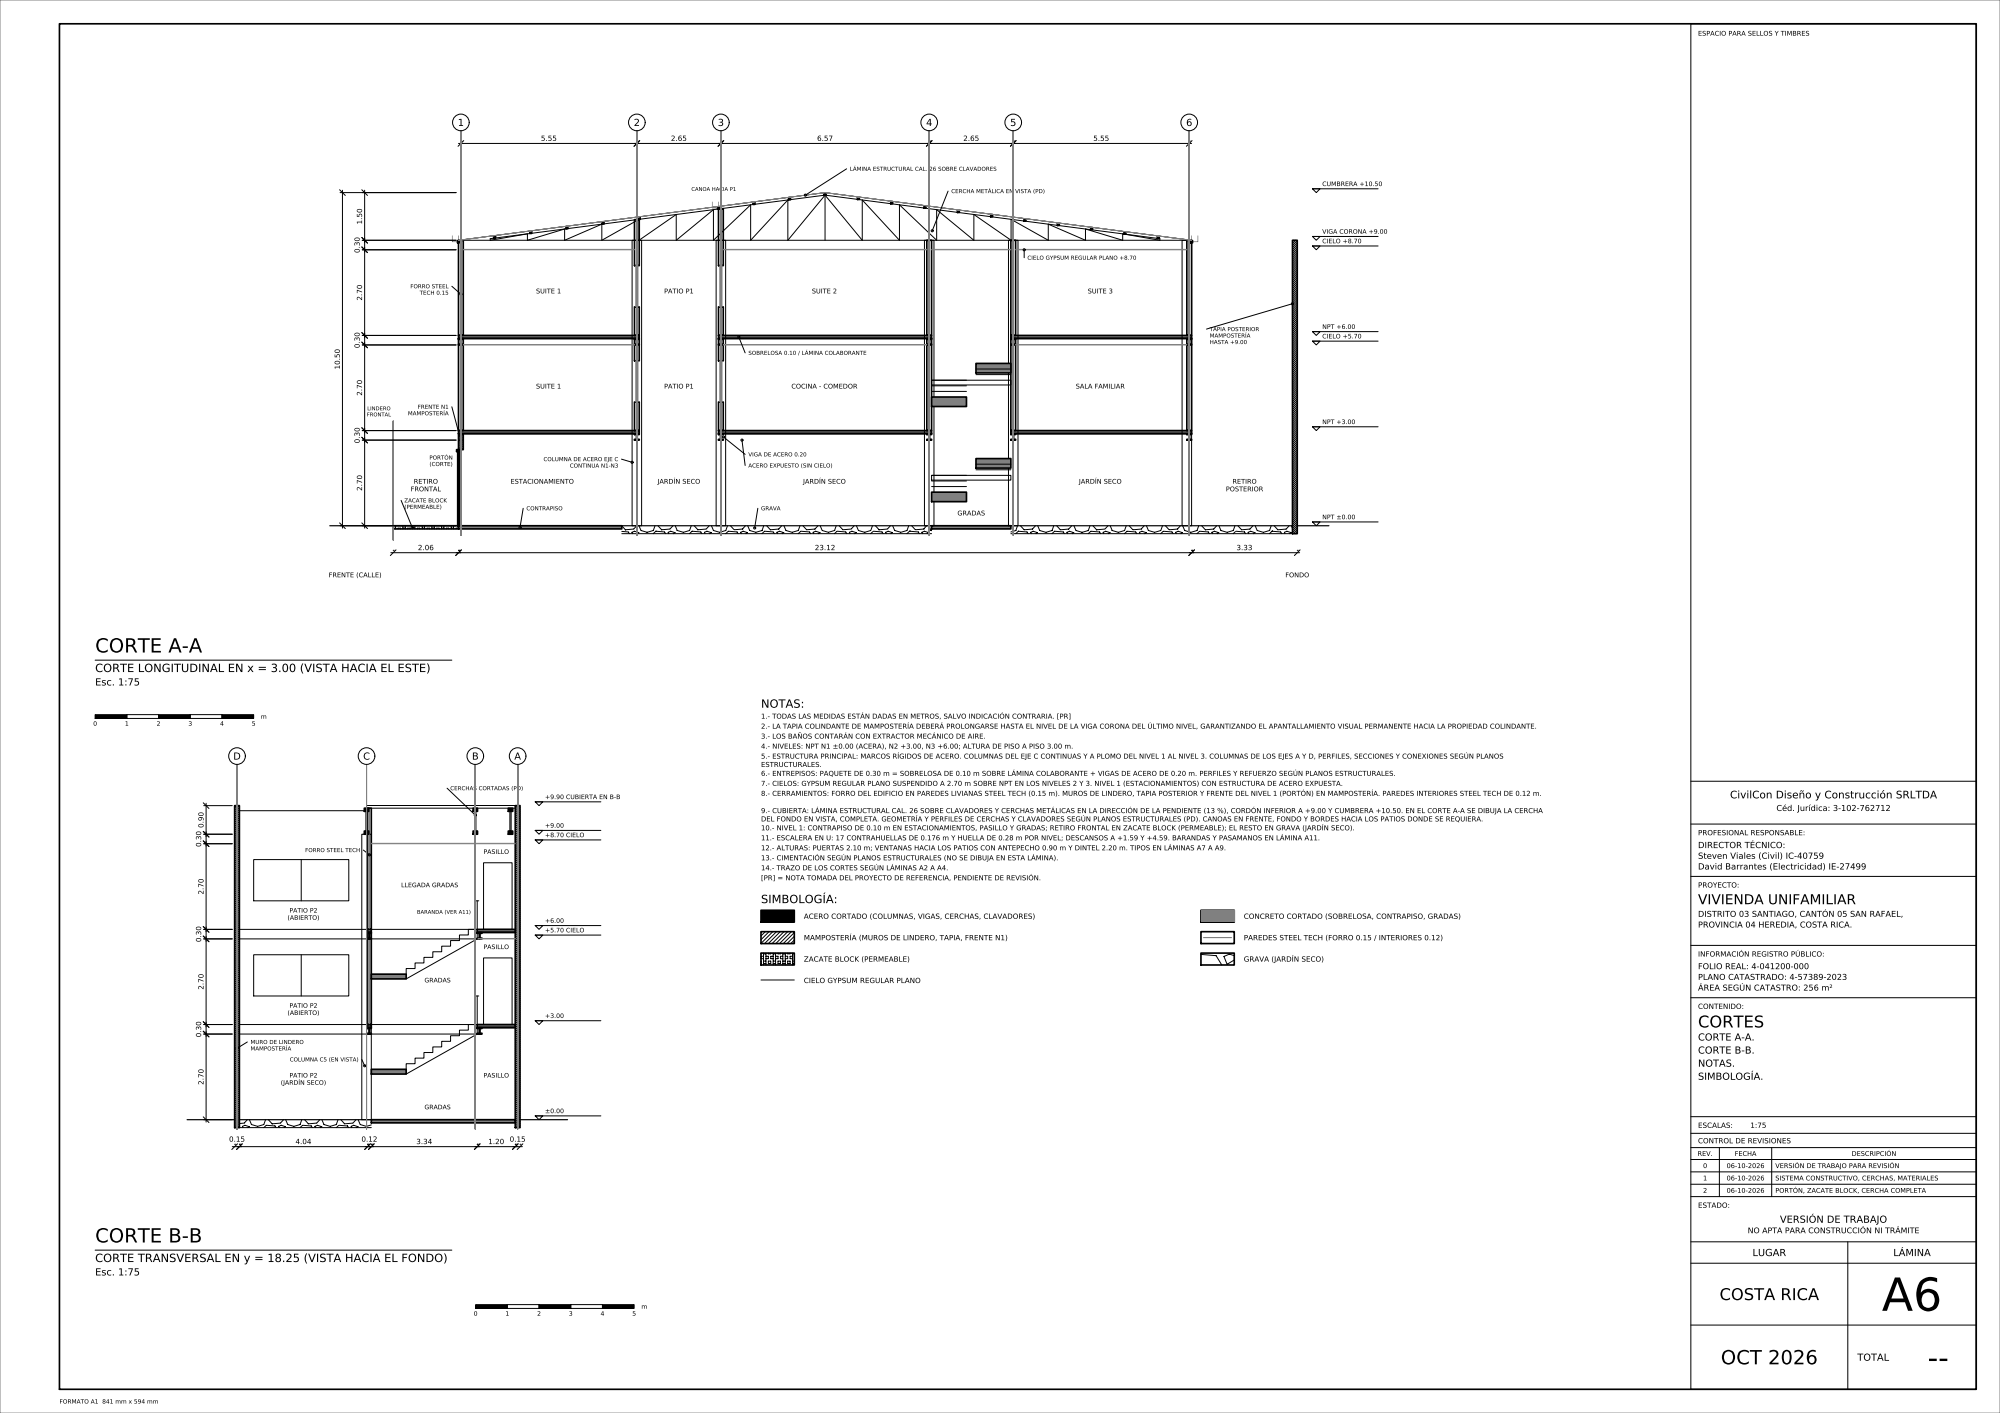
[picture p77: page 1]
