jbarra777/jbarra777/planos/A6_cortes/SR-A6_CORTES_rev1.pdf

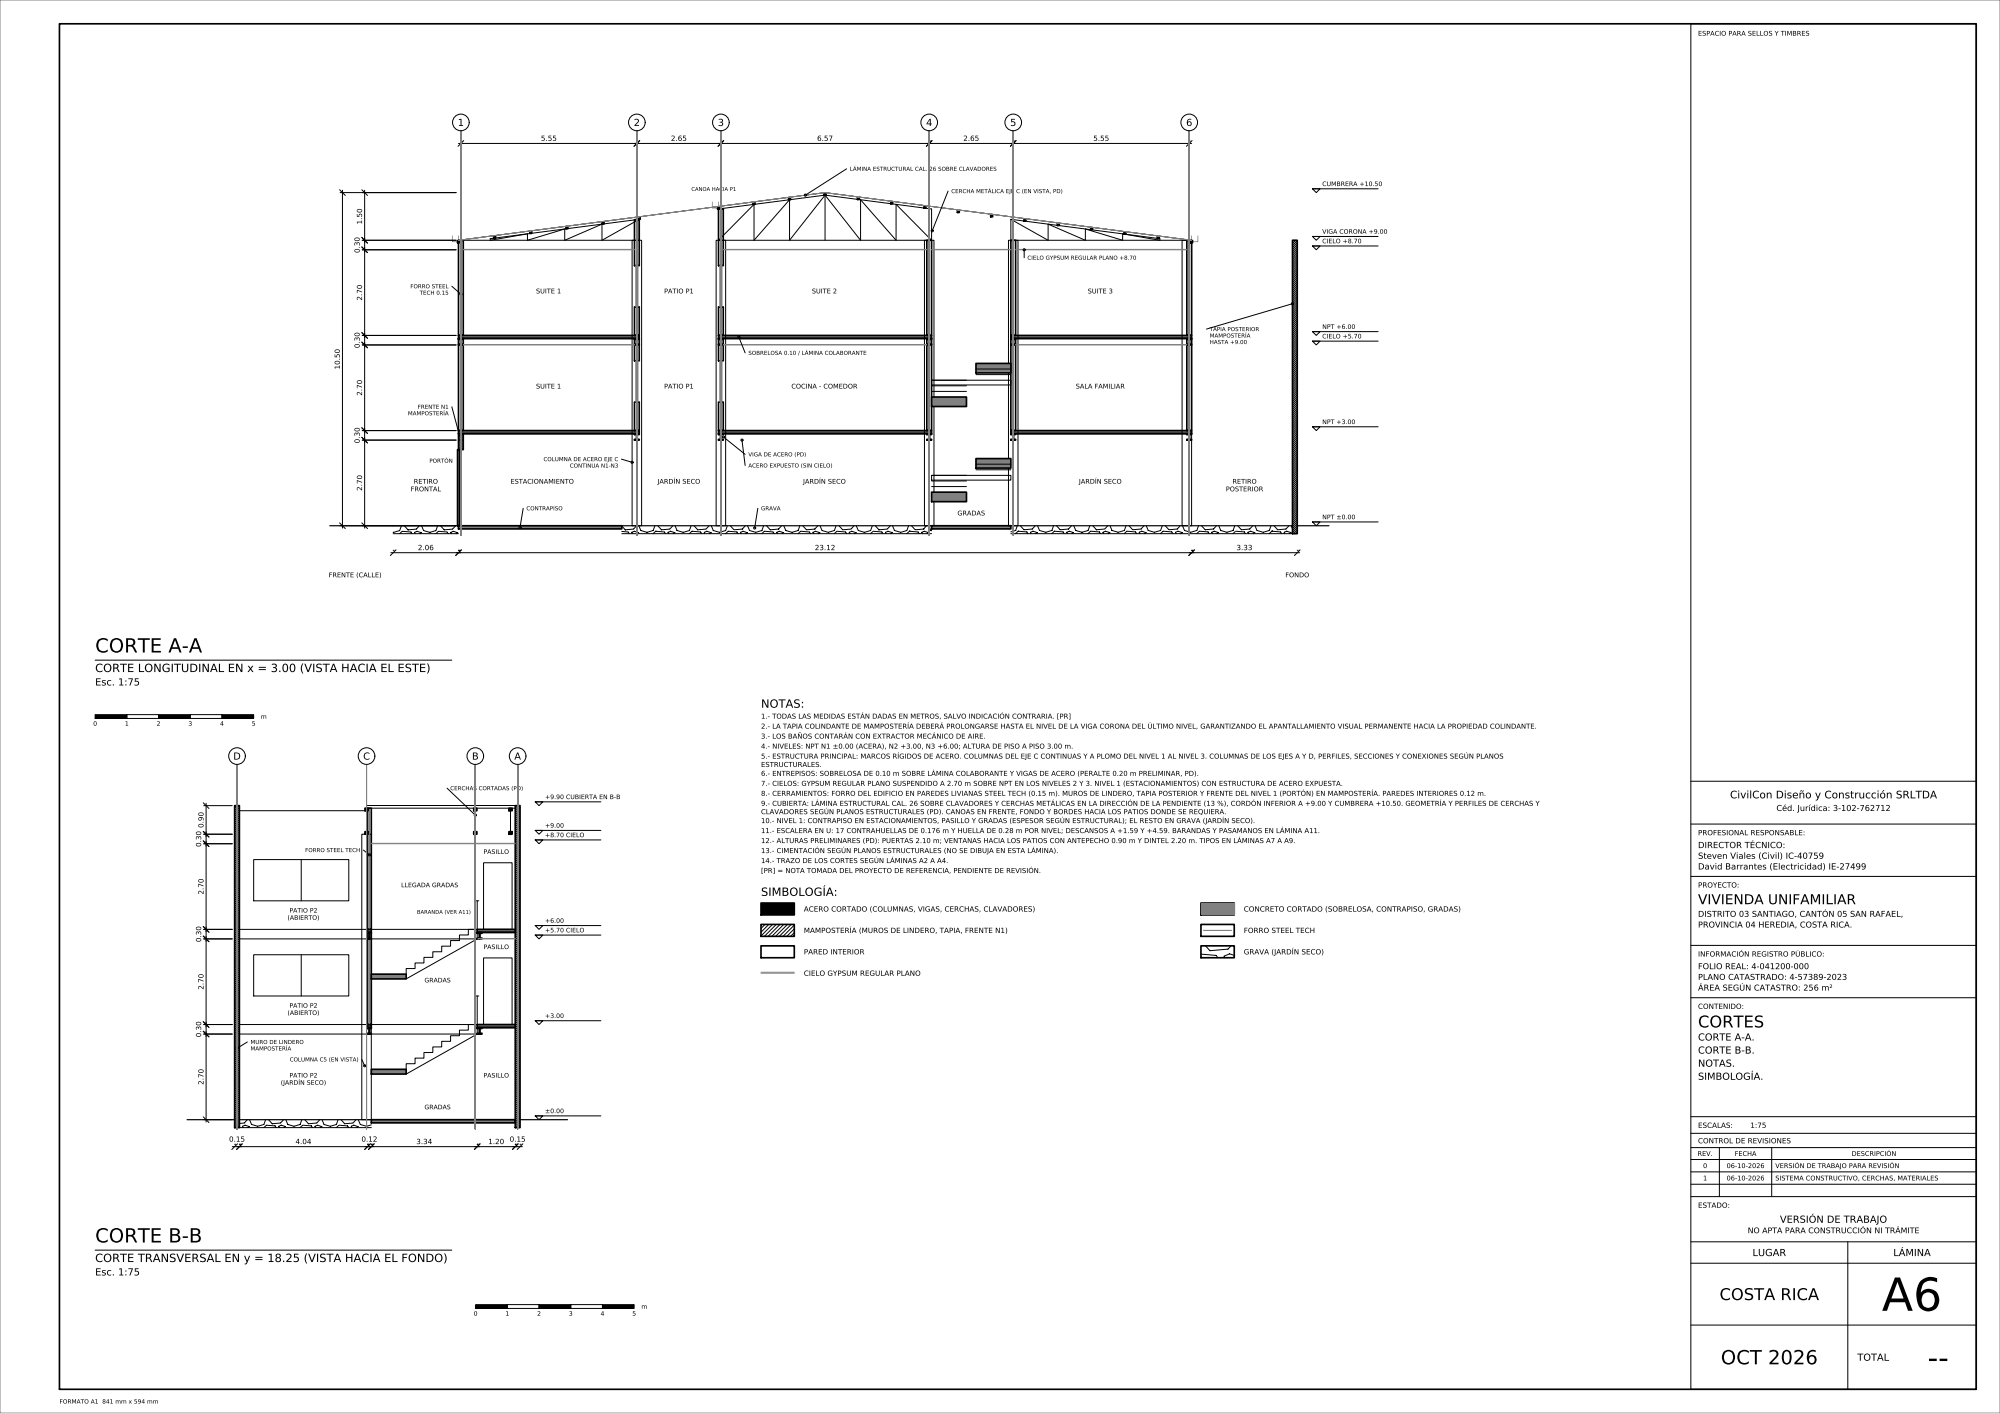
[picture p78: page 1]
