jbarra777/jbarra777/planos/A6_cortes/SR-A6_CORTES_rev0.pdf

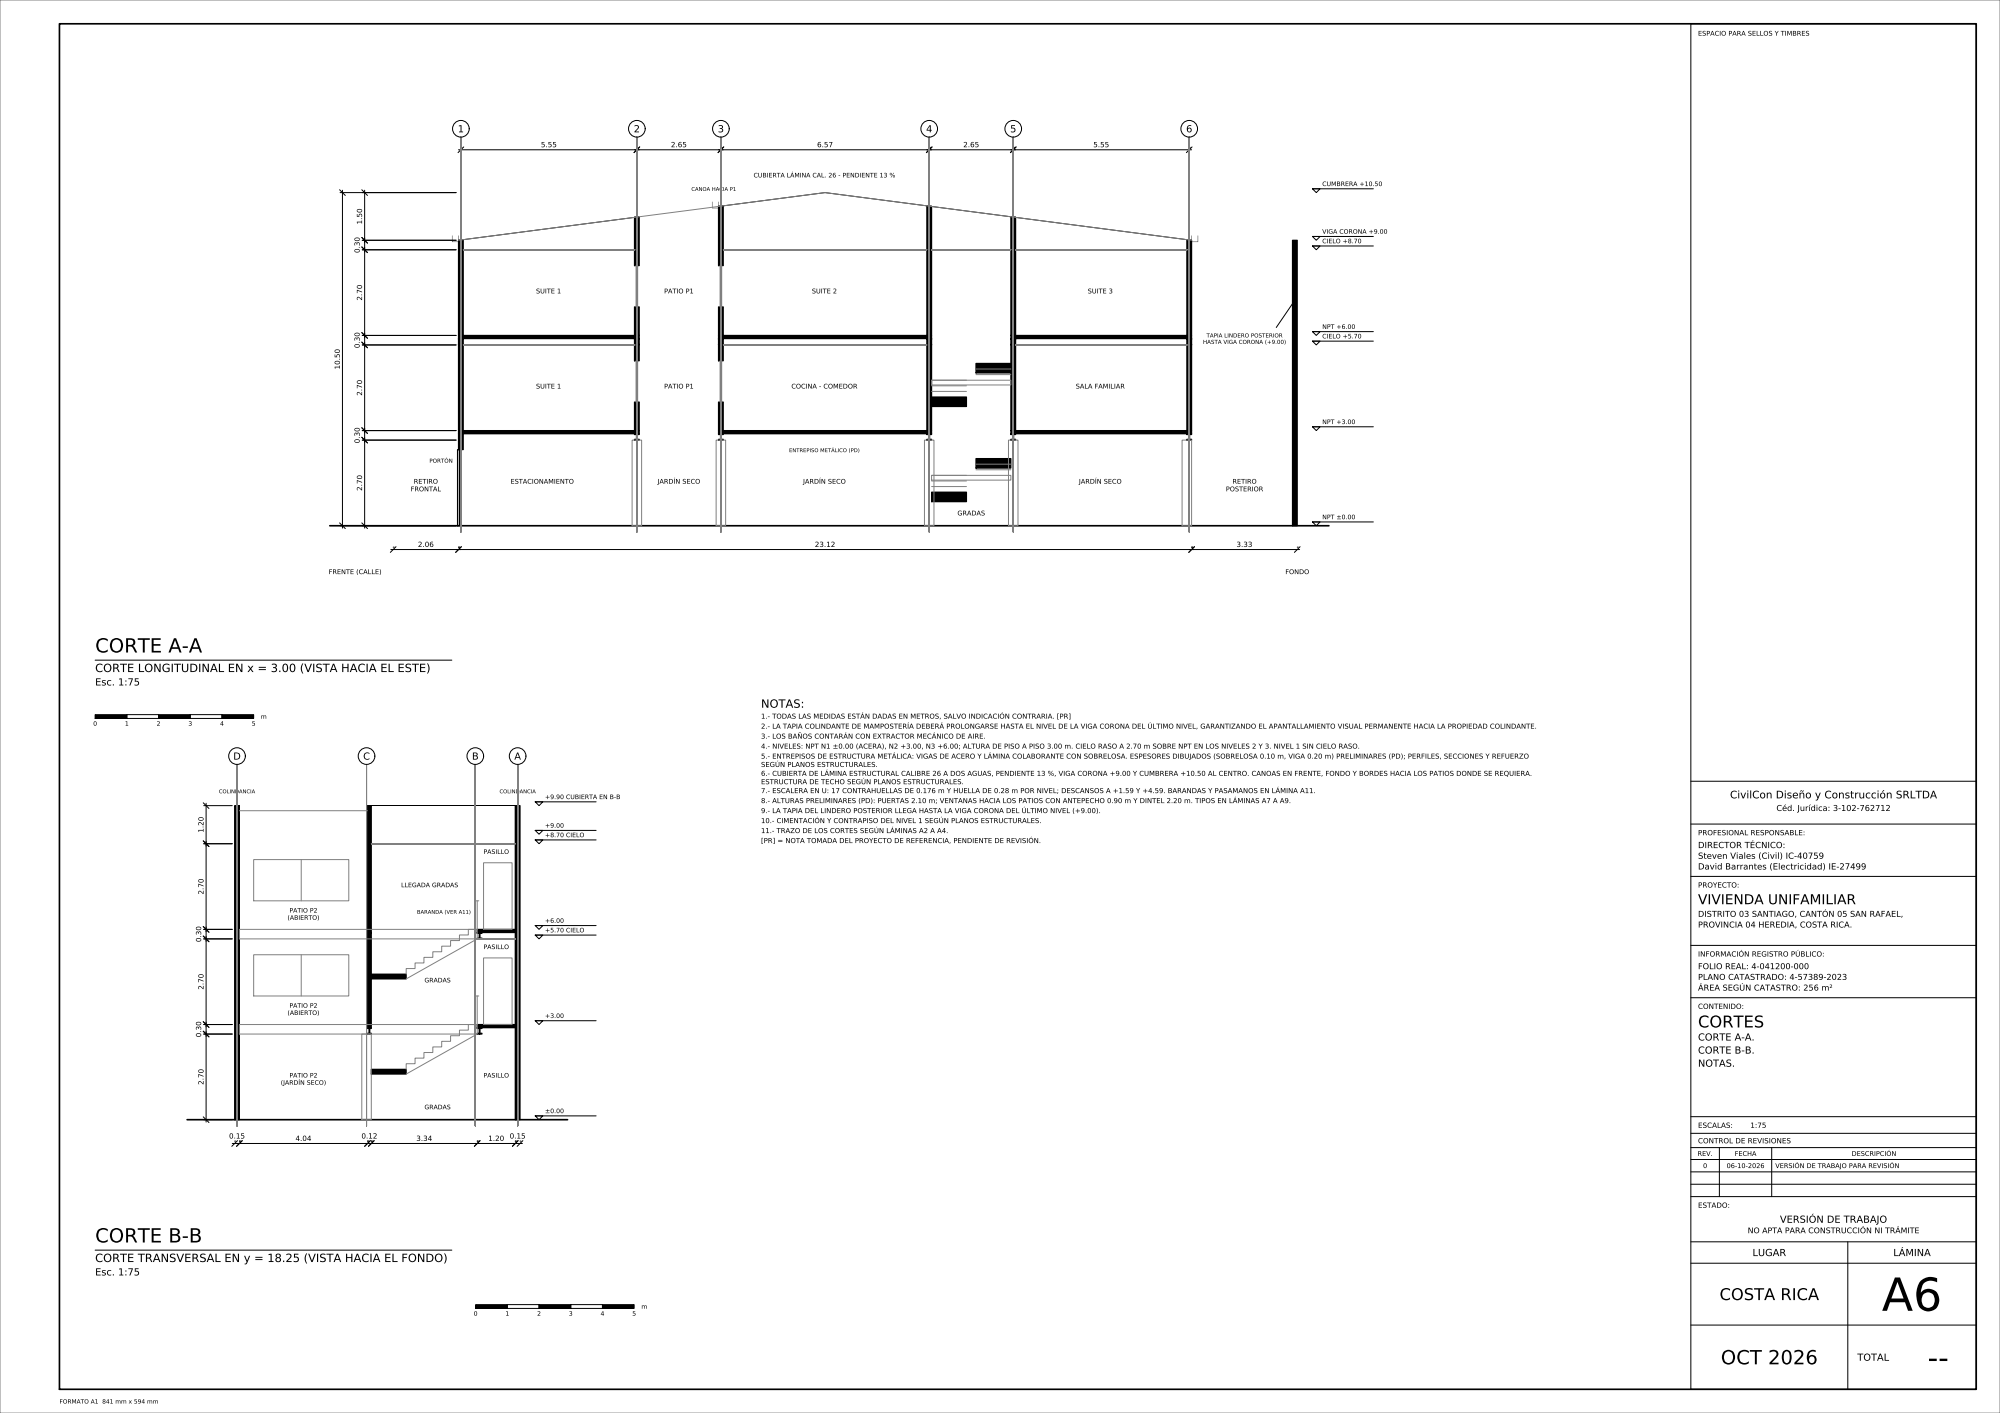
[picture p79: page 1]
