jbarra777/jbarra777/planos/A5_fachadas/SR-A5_FACHADAS_rev3.pdf

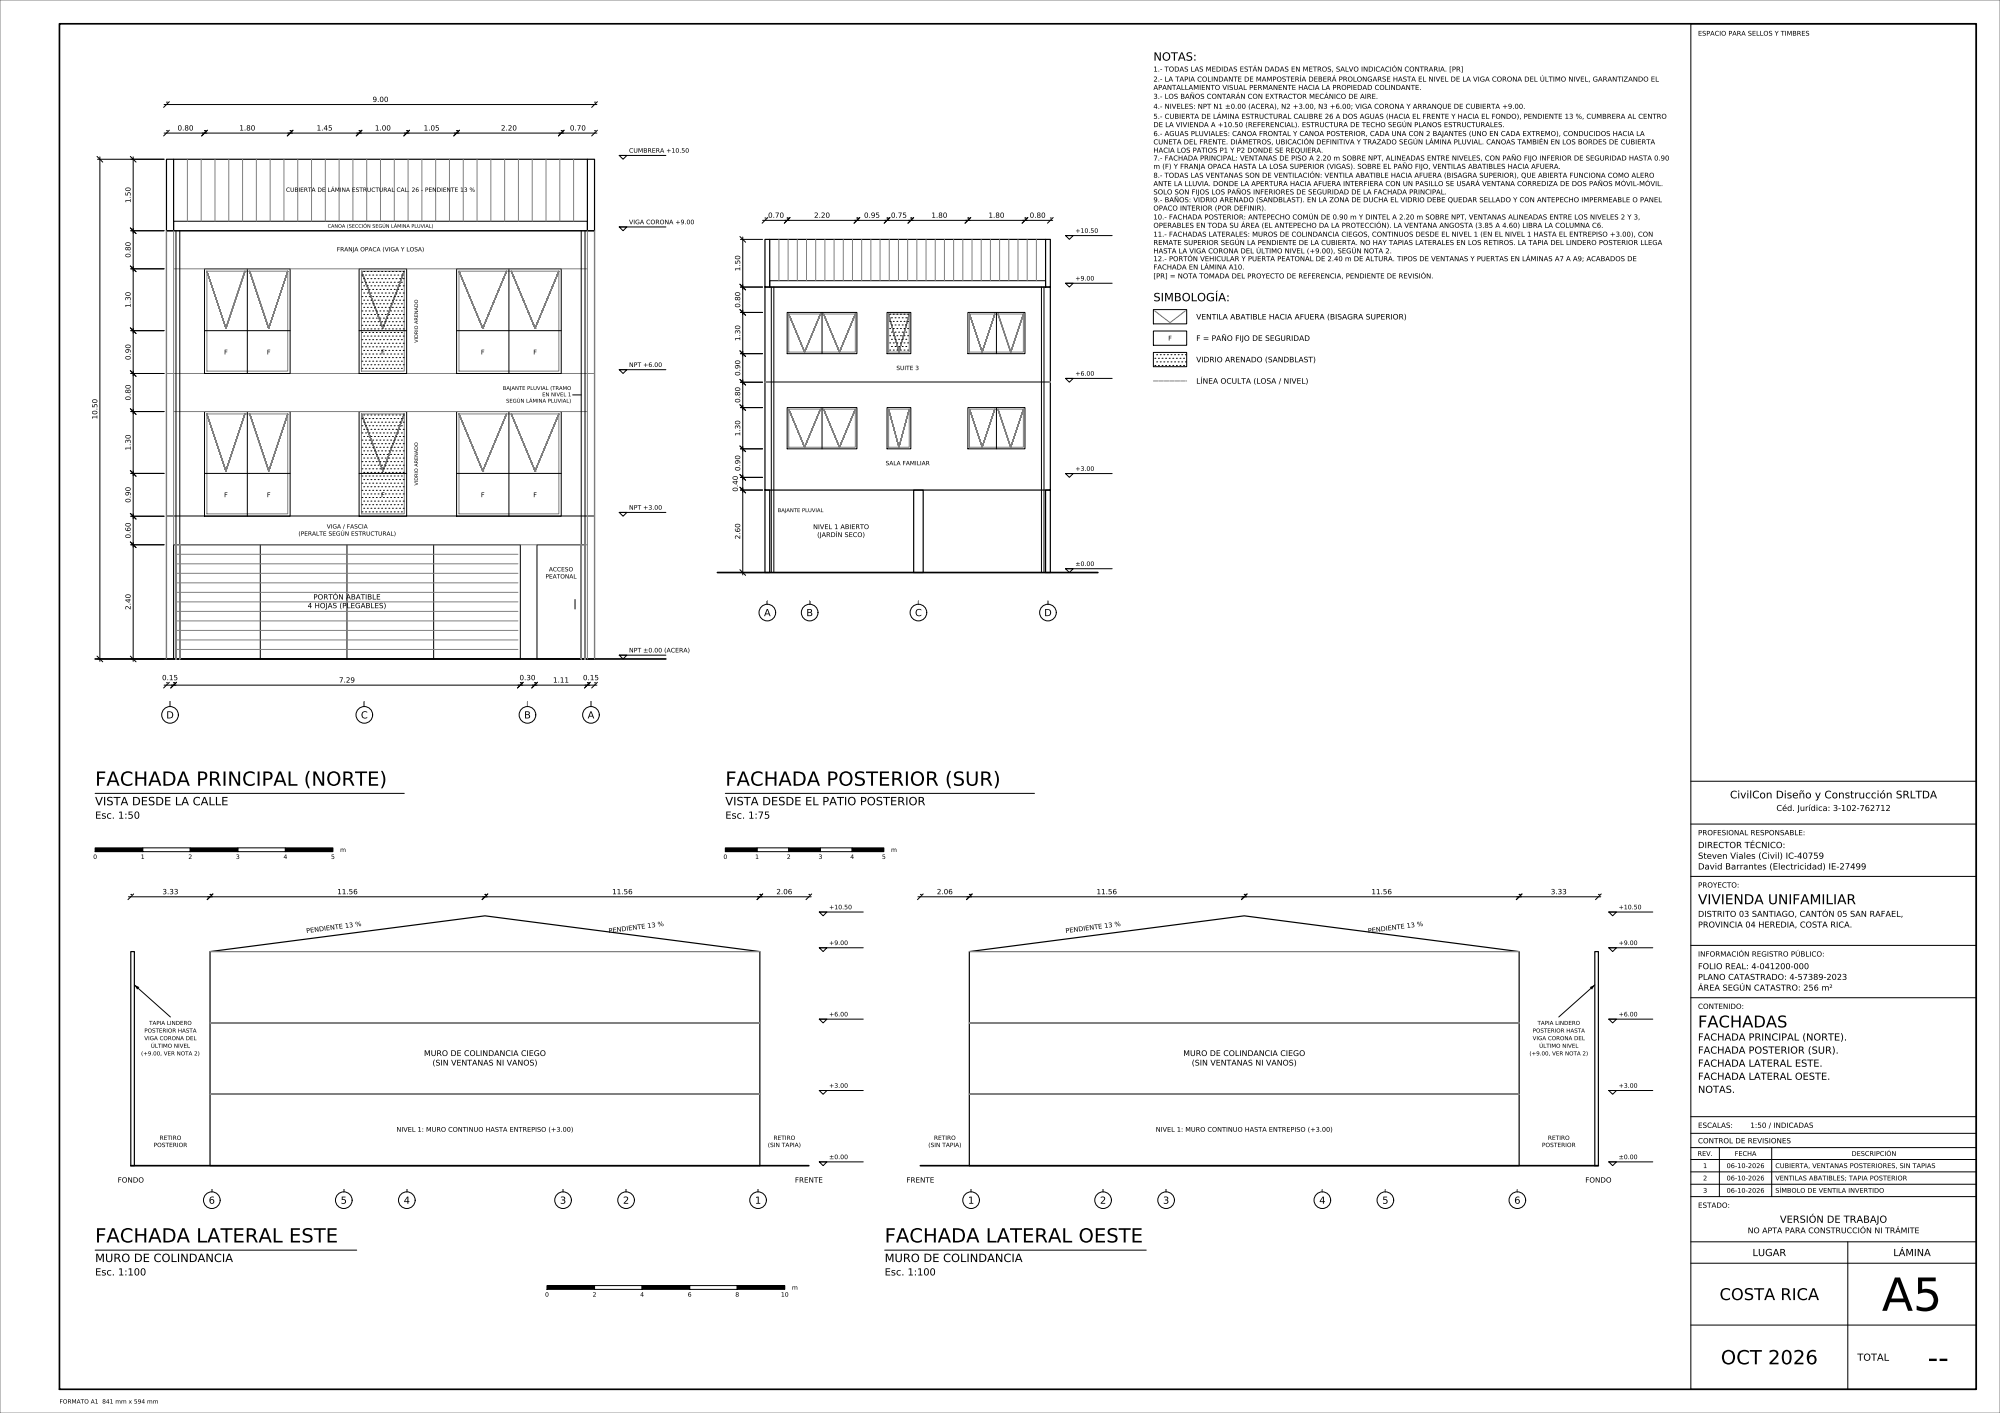
[picture p80: page 1]
