jbarra777/jbarra777/planos/A3_nivel2/SR-A3_NIVEL2_rev2.pdf

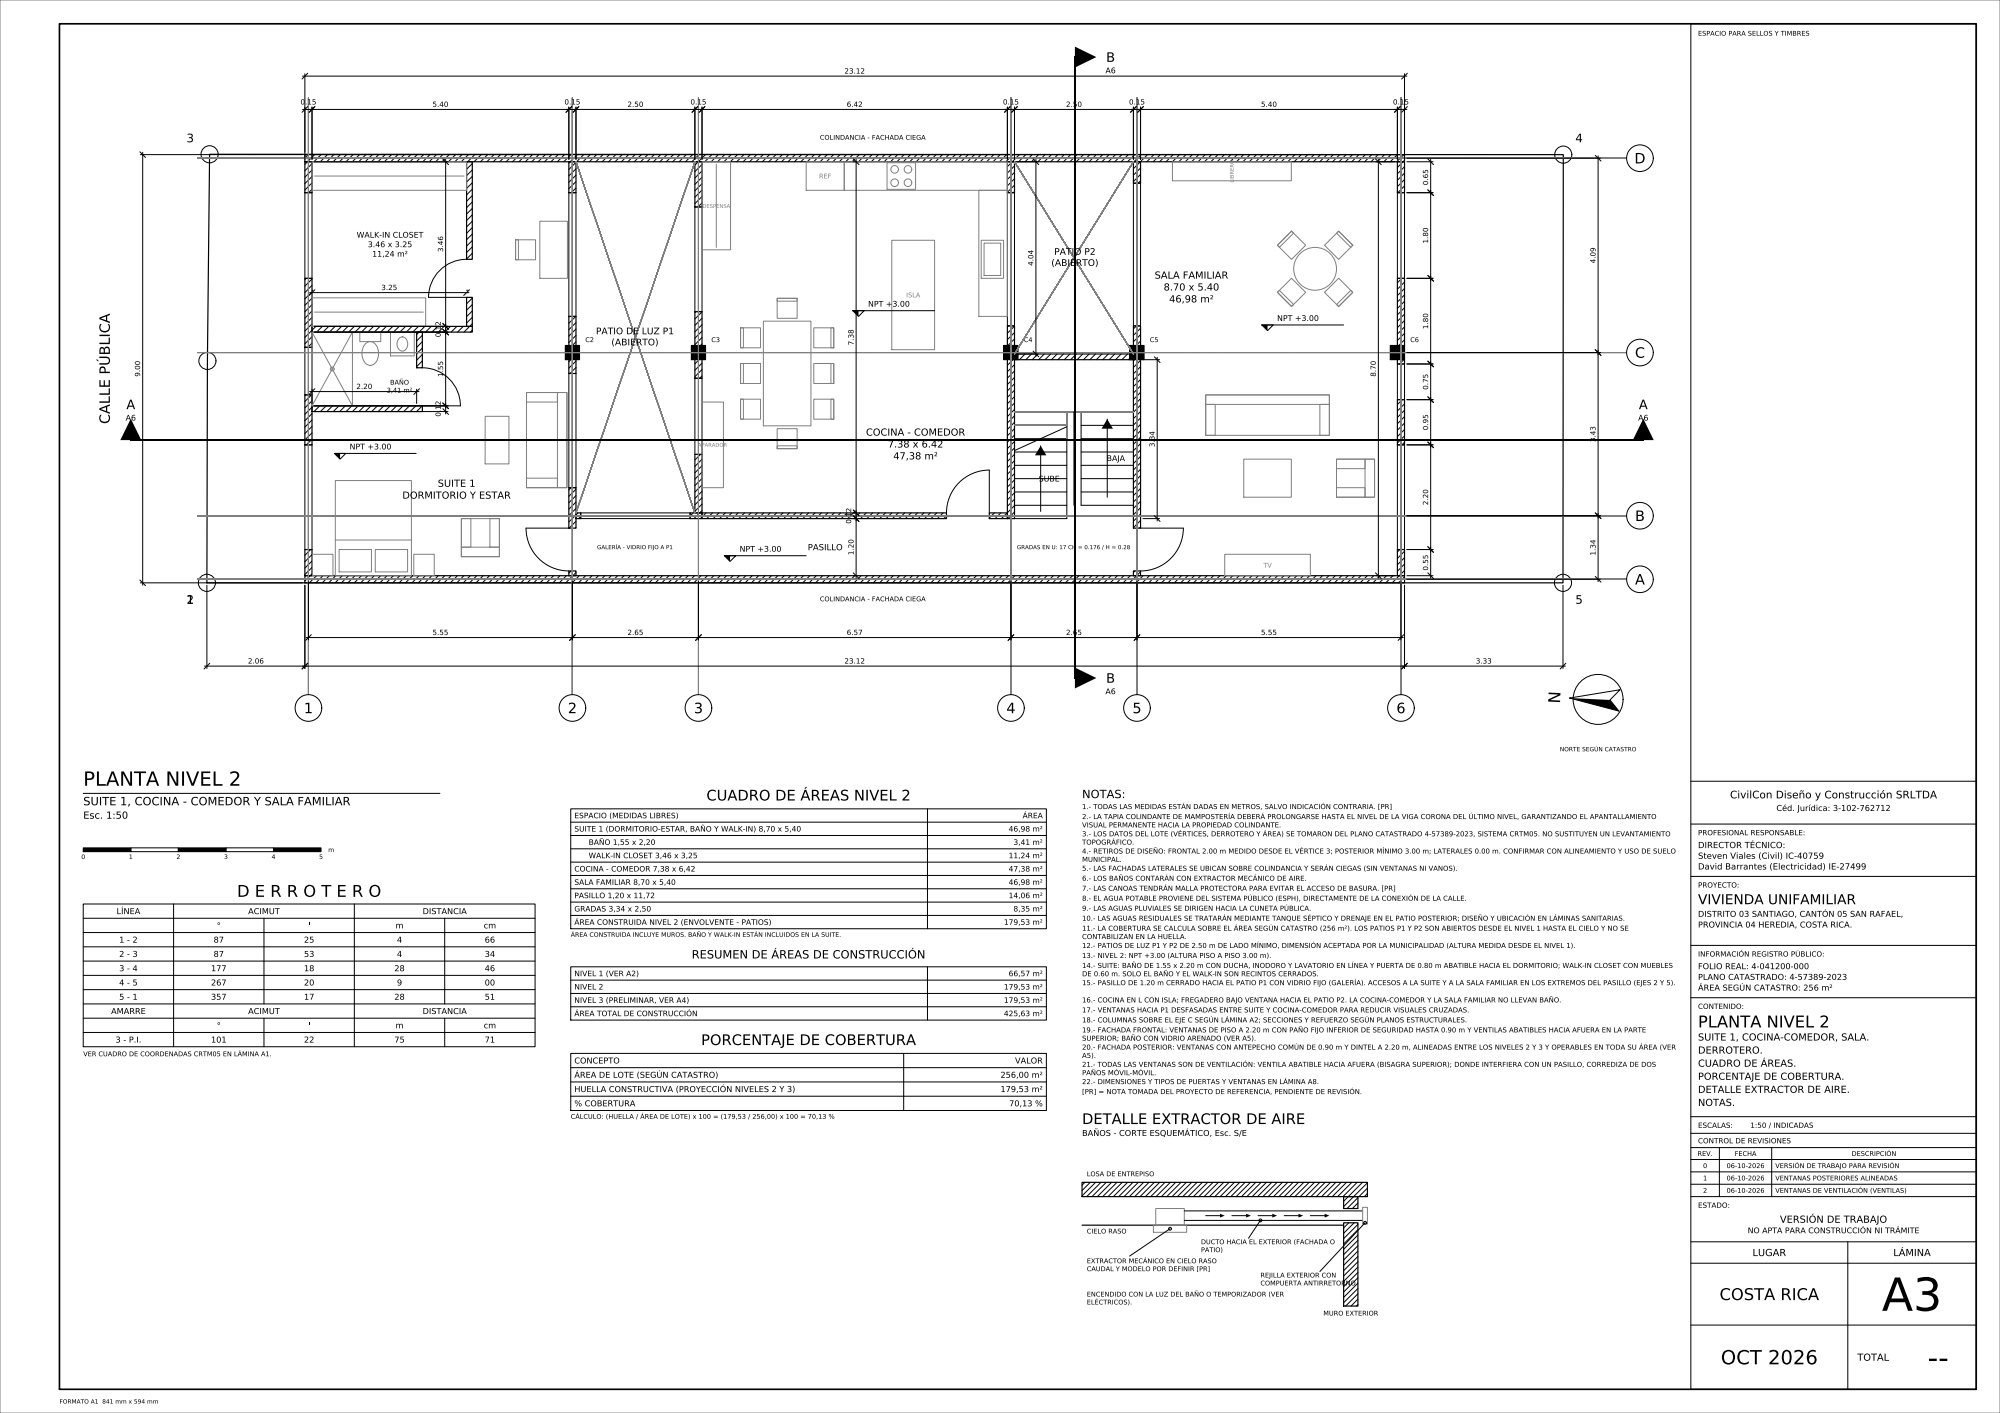
[picture p81: page 1]
