jbarra777/jbarra777/planos/A4_nivel3/SR-A4_NIVEL3_rev2.pdf

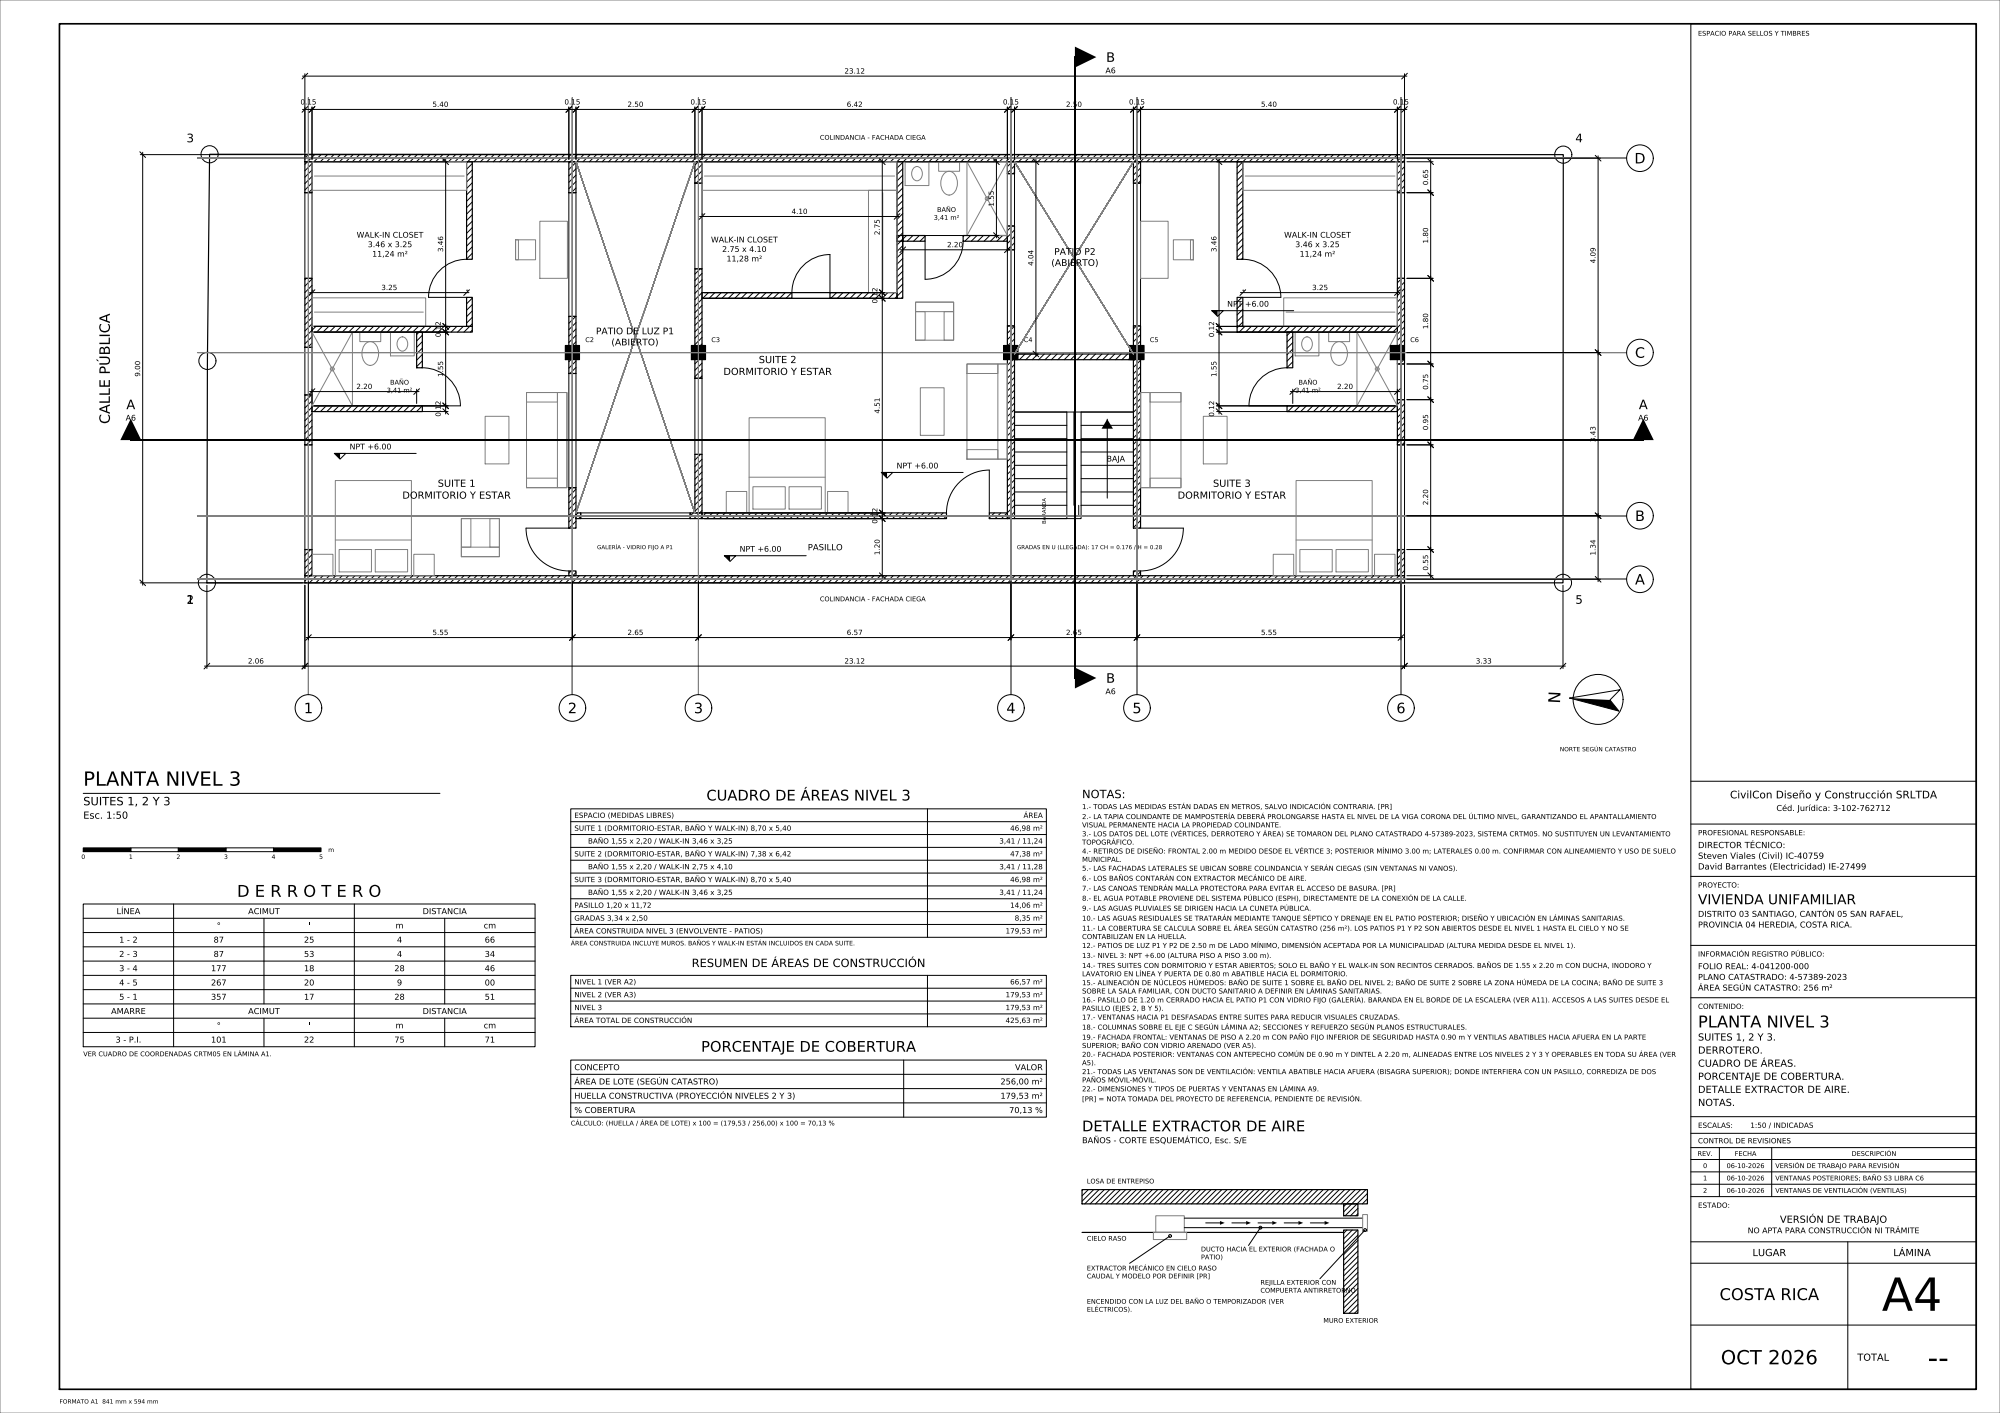
[picture p82: page 1]
