jbarra777/jbarra777/(commit log)

2026-10-06 Lámina A1 rev0 (lote de terreno): DXF, PDF de revisión, scripts y contexto del proyecto
    - scripts/cadlib.py: capas, estilos de cota, cajetín A1, tablas y render a PDF
    - scripts/a1_lote.py: genera la lámina A1 desde datos/*.json
    - planos/A1_lote: DXF editable, PDF A1, imagen de ubicación y relación
    - CONTEXTO_PROYECTO.md: decisiones aprobadas y pendientes para traspaso
    Claude-Session: https://claude.ai/code/session_01LSg6xq5CVeciQD1Rr2vpCo
    [SR-A1_LOTE_rev0.dxf]
2026-10-06 Lámina A1 rev1: nota 2 de tapia, patios de 2.50 aceptados por la municipalidad; notas y derrotero en módulo común; inicio de A2
    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
    [SR-A1_LOTE_rev1.dxf]
2026-10-06 A2 en preparación: módulo de plantas, generador de planta nivel 1 y contexto actualizado
    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
2026-10-06 A2: ajustes de rótulos y corte B
    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
2026-10-06 Lámina A2 rev0 (planta nivel 1): DXF, PDF de revisión y relación
    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
    [SR-A2_NIVEL1_rev0.dxf]
2026-10-06 A2 rev1: relación, contexto y ajustes de trama y notas
    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
2026-10-06 A2 rev1: DXF
    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
    [SR-A2_NIVEL1_rev1.dxf]
2026-10-06 A2 rev1: PDF de revisión
    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
2026-10-06 A3 en preparación: módulo de hoja común, mobiliario y generador de planta nivel 2
    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
2026-10-06 Lámina A3 rev0 (planta nivel 2): DXF, PDF, relación; notas como textos independientes; detalle de extractor
    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
    [SR-A3_NIVEL2_rev0.dxf]
2026-10-06 Lámina A4 rev0 (planta nivel 3, tres suites): DXF, PDF y relación
    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
    [SR-A4_NIVEL3_rev0.dxf]
2026-10-06 Lámina A5 rev0 (fachadas): DXF, PDF y relación
    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
    [SR-A5_FACHADAS_rev0.dxf]
2026-10-06 Contexto: pendientes de fachada posterior y conflicto C6 para retomar
    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
2026-10-06 Decisiones: leyenda [Ax] ligada al estado de la lámina
    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
2026-10-06 A2 rev2, A3 rev1, A4 rev1, A5 rev1: decisiones del 06-10-2026
    - Ventanas posteriores N2/N3 con patrón común 0.70-2.90 / 3.85-4.60 / 6.40-8.20 y antepecho de 0.90; la del baño de la suite 3 libra C6
    - Frente: paño fijo inferior hasta 0.90; walk-in con vidrios fijos; sin especificar el vidrio de seguridad
    - Cubierta de lámina cal. 26 a dos aguas al 13 %, canoas y bajantes, cumbrera +10.50, sin pretil
    - Sin tapias laterales; muros de colindancia del N1 hasta el entrepiso
    - A1 aprobada; memoria actualizada (índice, estado, decisiones, cambios)
    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
    [SR-A2_NIVEL1_rev2.dxf, SR-A3_NIVEL2_rev1.dxf, SR-A4_NIVEL3_rev1.dxf, SR-A5_FACHADAS_rev1.dxf]
2026-10-06 A3 rev2, A4 rev2, A5 rev2: ventanas de ventilación y tapia posterior
    - Todas las ventanas ventilan: ventila abatible hacia afuera (bisagra superior); solo los paños inferiores de seguridad del frente son fijos; fachada posterior operable en toda su área
    - Criterio corrediza móvil-móvil donde la apertura interfiera con un pasillo
    - Tapia del lindero posterior hasta la viga corona (+9.00) con flecha y nota en las fachadas laterales
    - Canoas hacia los patios P1/P2 donde se requiera; supuestos de A5 rev1 confirmados
    - Memoria actualizada
    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
    [SR-A3_NIVEL2_rev2.dxf, SR-A4_NIVEL3_rev2.dxf, SR-A5_FACHADAS_rev2.dxf]
2026-10-06 A5 rev3: símbolo de ventila invertido; A2 rev2, A3 rev2 y A4 rev2 aprobadas
    - Ventila con bisagra superior: triángulo invertido en las fachadas y en la simbología
    - Galería del pasillo hacia P1 se mantiene en vidrio fijo
    - Memoria actualizada (índice, estado, decisiones, cambios)
    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
    [SR-A5_FACHADAS_rev3.dxf]
2026-10-06 A6 Cortes rev0: cortes A-A y B-B a 1:75; A5 aprobada
    - Entrepiso metálico (PD 0.10 + 0.20), cielo raso a 2.70, cubierta al 13 % con canoas, escalera en U, tapia posterior hasta +9.00
    - hoja.titleblock admite escala propia
    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
    [SR-A6_CORTES_rev0.dxf]
2026-10-06 A6 Cortes rev1: sistema constructivo, cerchas y materiales
    - Columnas del eje C continuas N1-N3; jerarquía de líneas
    - Contrapiso en estacionamientos, pasillo y gradas; grava en el resto
    - Cubierta con lámina, clavadores y cerchas metálicas (PD)
    - Mampostería en linderos, tapia y frente N1; forro Steel Tech; cielos gypsum N2/N3 y acero expuesto N1
    - Rótulos de materiales y simbología; memoria actualizada
    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
    [SR-A6_CORTES_rev1.dxf]
2026-10-06 A6 Cortes rev2: portón y lindero frontal, zacate block, cercha completa
    - Hoja del portón cortada y línea de lindero frontal en el corte A-A
    - Retiro frontal en zacate block (permeable); paredes interiores Steel Tech 0.12
    - Paquete de entrepiso 0.30 (viga 0.20 + sobrelosa 0.10); contrapiso, puertas y ventanas confirmados
    - Cercha del fondo completa en el A-A; cerchas cortadas más visibles en el B-B
    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
    [SR-A6_CORTES_rev2.dxf]
2026-10-06 A7 rev0: puertas, ventanas y acabados (lámina única); A2 y A3 rev3 preparadas
    - Plantas N1-N3 a 1:100 con etiquetas P/V/Pd/PI, cuadros de puertas y ventanas, acabados en paredes, pisos y cielos, detalles de puertas y ventanas
    - A2 rev3: vestíbulo de escalera Steel Tech 0.12 con puerta principal P-01
    - A3 rev3: cocina abierta al pasillo, sin puertas de cocina y sala, vano 1.20 a la sala
    - A6 aprobada; memoria actualizada
    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
    [SR-A2_NIVEL1_rev3.dxf, SR-A3_NIVEL2_rev3.dxf, SR-A7_PUERTAS_VENTANAS_rev0.dxf]
2026-10-06 A7 rev1 (V-05 con vidrio arenado) y A2 rev3 (vestíbulo de escalera y puerta principal P-01)
    - A7: las dos V-05 llevan vidrio arenado; supuestos confirmados
    - A2: vestíbulo Steel Tech 0.12 en ejes 4, C y 5, P-01 1.00, nota 19, textos reubicados
    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
    [SR-A2_NIVEL1_rev3.dxf, SR-A7_PUERTAS_VENTANAS_rev1.dxf]
2026-10-06 A3 rev3: cocina y sala abiertas al pasillo; A2 rev3 y A7 rev1 aprobadas
    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
    [SR-A3_NIVEL2_rev3.dxf]
2026-10-06 A4 rev3: referencia a lámina A7; A3 rev3 aprobada
    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
    [SR-A4_NIVEL3_rev3.dxf]
2026-10-06 A5 rev4: V-05 de la sala con vidrio arenado, referencia a A7; A4 rev3 aprobada
    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
    [SR-A5_FACHADAS_rev4.dxf]
2026-10-06 A6 rev3: vestíbulo del N1, vano de la sala, referencia a A7; A5 rev4 aprobada
    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
    [SR-A6_CORTES_rev3.dxf]
2026-10-06 A11 rev0: escalera (planta, corte, detalles de escalón, baranda y pasamanos); A6 rev3 aprobada
    - Organización y textos de barandas de la ARQ_11 de la referencia [PR], por indicación del usuario
    - Geometría propia: U de 17 CH, tramos 1.10, ojo 0.30, descanso a +1.59, vestíbulo N1
    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
    [SR-A11_ESCALERA_rev0.dxf]
2026-10-06 A11 rev1: gradas con porcelanato antideslizante, sin citas normativas, marcas como 'o similar'
    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
    [SR-A11_ESCALERA_rev1.dxf]
2026-10-06 A5 rev5: acabados de fachada (integra la A10); decisiones de estructurales
    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
    [SR-A5_FACHADAS_rev5.dxf]
2026-10-06 C01 rev0: planta de cimentaciones (secciones de la referencia [PR]); memoria de estructurales
    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
    [SR-C01_CIMENTACIONES_rev0.dxf]
2026-10-06 C02 rev0: detalles de cimentación F1/F2, pedestal y pletina (versión de trabajo)
    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
    [SR-C02_CIMENTACION_DETALLES_rev0.dxf]
2026-10-06 C02 aprobada; C03 rev0: planta de entrepiso nivel 2 y detalle (versión de trabajo)
    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
    [SR-C03_ENTREPISO_N2_rev0.dxf]
2026-10-06 C03 aprobada; rev1: planta de entrepiso 1 y 2 en una sola lámina (solo leyenda)
    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
    [SR-C03_ENTREPISOS_rev1.dxf]
2026-10-06 C04 rev0: planta de techo, cercha típica y sección de cubierta (versión de trabajo)
    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
    [SR-C04_TECHO_rev0.dxf]
2026-10-06 C04 aprobada; niveles de cubierta +9,20/+10,70 (corregir A5/A6 al final)
    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
2026-10-06 C05 y C06 rev0: detalle de pórticos longitudinal y transversal (versión de trabajo)
    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
    [SR-C05_PORTICOS_LONGITUDINAL_rev0.dxf, SR-C06_PORTICOS_TRANSVERSAL_rev0.dxf]
2026-10-06 C05 rev1: pórticos unificados; C1 eje C-1 en N2-N3 sobre viga de transferencia VT-1
    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
    [SR-C05_PORTICOS_rev1.dxf]
2026-10-06 C05 aprobada; C06 rev0: especificaciones constructivas (notas estructurales de la referencia)
    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
    [SR-C06_ESPECIFICACIONES_rev0.dxf]
2026-10-06 Correcciones sobre láminas aprobadas: referencia C06, cubierta +9,20/+10,70, C1 eje C-1 sobre VT-1, V-03 de 0,90; C06 sin notas 8 y 9
    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
    [SR-A3_NIVEL2_rev4.dxf, SR-A4_NIVEL3_rev4.dxf, SR-A5_FACHADAS_rev6.dxf, SR-A6_CORTES_rev4.dxf, SR-A7_PUERTAS_VENTANAS_rev2.dxf, SR-C01_CIMENTACIONES_rev1.dxf, SR-C02_CIMENTACION_DETALLES_rev1.dxf, SR-C03_ENTREPISOS_rev2.dxf]
2026-10-06 E01 rev0: planta eléctrica nivel 1 (iluminación, tomas, voz/datos) y simbología común
    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
    [SR-E01_NIVEL1_rev0.dxf]
2026-10-06 E01 aprobada (rev1 sin mención a secadora); E02 rev0: planta eléctrica nivel 2
    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
    [SR-E01_NIVEL1_rev1.dxf, SR-E02_NIVEL2_rev0.dxf]
2026-10-06 E02 aprobada; E03 rev0: planta eléctrica nivel 3
    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
    [SR-E03_NIVEL3_rev0.dxf]
2026-10-06 E03 aprobada; E04 rev0: diagrama unifilar, cuadros de tableros y notas eléctricas [PR]
    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
    [SR-E04_TABLEROS_rev0.dxf]
2026-10-06 E04 aprobada; E05 rev0: detalles eléctricos [PR]
    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
    [SR-E05_DETALLES_rev0.dxf]
2026-10-06 S01 rev0: agua potable (plantas N1-N3, diagrama vertical, detalles)
    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
    [SR-S01_AGUA_POTABLE_rev0.dxf]
2026-10-07 S02 rev0: aguas residuales (plantas N1-N3, tanque séptico con FAFA, drenaje y detalles)
    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
    [SR-S02_AGUAS_RESIDUALES_rev0.dxf]
2026-10-07 S02 rev1: detalle de tanque séptico según la referencia
    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
    [SR-S02_AGUAS_RESIDUALES_rev1.dxf]
2026-10-07 S02 aprobada; S01 rev1: punto de jardín posterior trasladado fuera del tanque séptico
    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
    [SR-S01_AGUA_POTABLE_rev1.dxf]
2026-10-07 S03 rev0: aguas pluviales (planta de techo, colectores N1, canoa, caja pluvial y descarga a cuneta)
    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
    [SR-S03_PLUVIALES_rev0.dxf]
2026-10-07 Corrección de referencias entre láminas: A1 rev2, A2 rev4, A3 rev5 (ductos S02), A4 rev5, A5 rev7, A6 rev5, A7 rev3, C04 rev2; S01 rev1 y S03 aprobadas
    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
    [SR-A1_LOTE_rev2.dxf, SR-A2_NIVEL1_rev4.dxf, SR-A3_NIVEL2_rev5.dxf, SR-A4_NIVEL3_rev5.dxf, SR-A5_FACHADAS_rev7.dxf, SR-A6_CORTES_rev5.dxf, SR-A7_PUERTAS_VENTANAS_rev3.dxf, SR-C04_TECHO_rev2.dxf]
2026-10-07 Corrección de referencias aprobada; A11 se mantiene
    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
2026-10-07 Lista definitiva (22 láminas) y emisión para trámite: A11→A8, sin [PR] ni PD, TOTAL 22, pluviales 4" al 2 %, sin caja de medidor
    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
    [SR-A1_LOTE_rev3.dxf, SR-A2_NIVEL1_rev5.dxf, SR-A3_NIVEL2_rev6.dxf, SR-A4_NIVEL3_rev6.dxf, SR-A5_FACHADAS_rev8.dxf, SR-A6_CORTES_rev6.dxf, SR-A7_PUERTAS_VENTANAS_rev4.dxf, SR-A8_ESCALERA_rev2.dxf]
2026-10-07 Juego completo para trámite en 4 PDF por disciplina
    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
